alanbjohnston/CubeSatSim/hardware/README.md

The current CubeSatSim hardware is in the v2.0 folder https://github.com/alanbjohnston/CubeSatSim/tree/master/hardware/v2.0.  The folder contains gerbers, schematics, and images of the Main, Battery, and Solar boards.

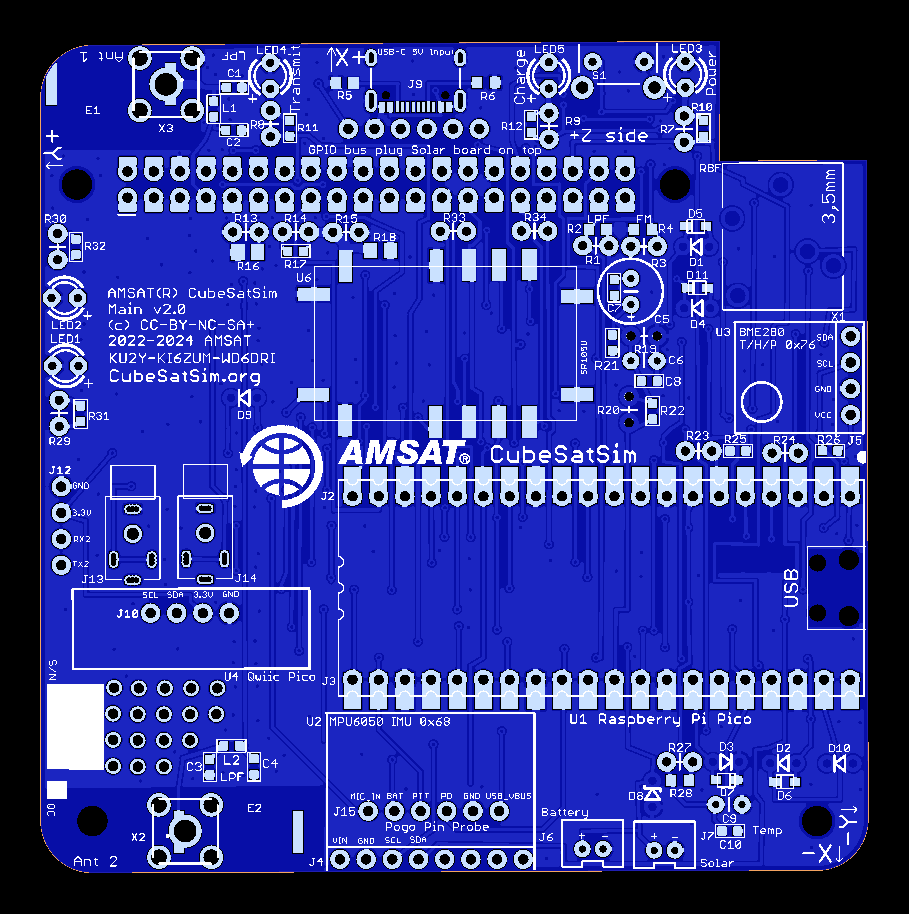
[picture p4: hardware/v2.0/cubesatsim-main-v2.0_top.png]
cubesatsim-main-v2 0 1_top
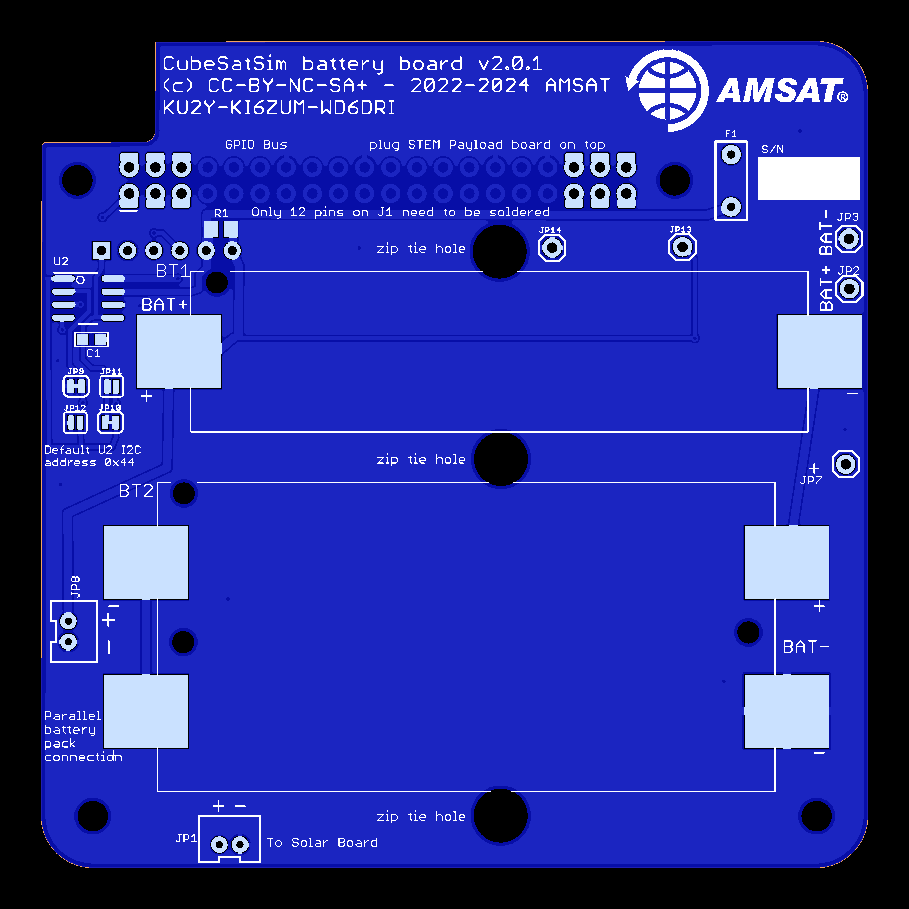
[picture p5: hardware/v2.0/cubesatsim-battery-v2.0.1_top.png]
cubesatsim-battery-v2 0_top
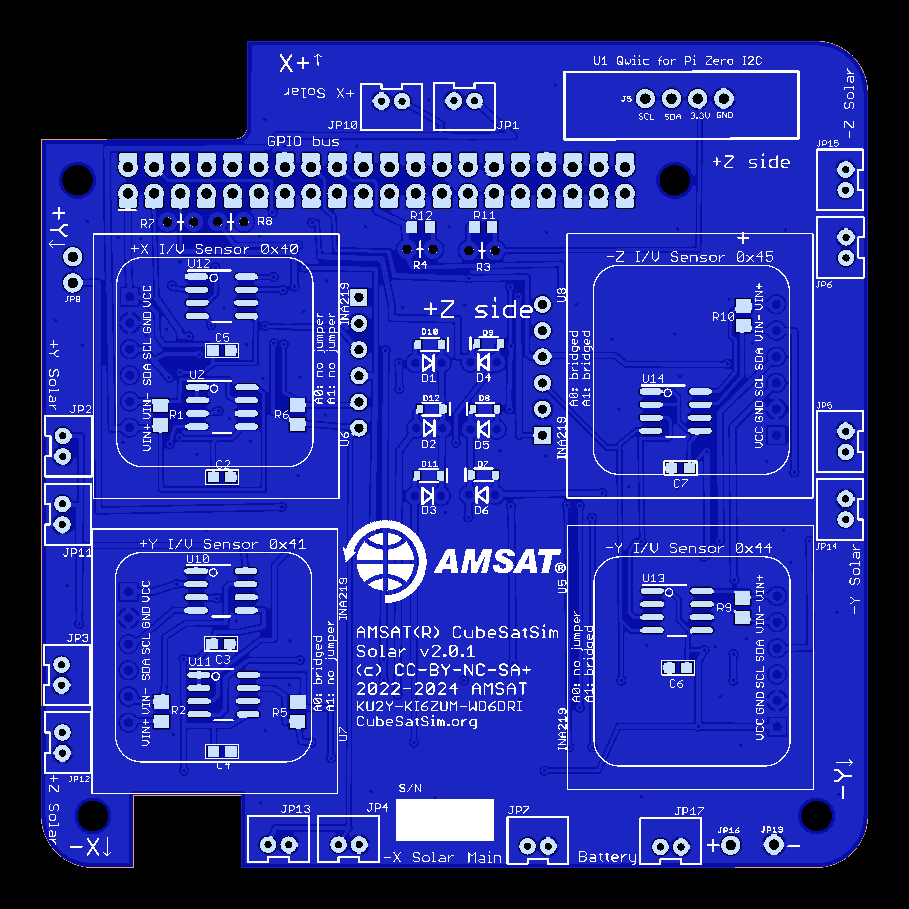
[picture p6: hardware/v2.0/cubesatsim-solar-v2.0.1_top.png]
cubesatsim-solar-v2 0_top
  

For information on building the boards, see https://CubeSatSim.org/wiki.

Older beta versions of the hardware are in the other folders and should not be used.
