alanbjohnston/CubeSatSim/hardware/v2.1/readme.md

cubesatsim-main-v2 0 1_top cubesatsim-battery-v2 0_top cubesatsim-solar-v2 0_top

Here is information about the CubeSatSim PCBs, version v2.1

There are 3 boards: Main, Solar, and Battery

Here's what the files are:

*_gerbers.zip -- All gerber files used to fabricate PCBs along with .TXT drill file

*_schematic.pdf -- Schematic

*_pcb.png -- View of board

*_pour.png -- View of board with fill

*_top.png -- Top view of PCB generated by gerbers

*_bottom.png -- Bottom view of PCB generated by gerbers

*.mnt -- top SMD component placement data

*.mnb -- bottom SMD component placement data

*_bom.csv.txt -- Bill of Materials in CSV format

I use PCBWay to fabricate PCBs https://pcbway.com

Here is the bill of materials: https://CubeSatSim.org/bom

Wiki instructions: https://github.com/alanbjohnston/CubeSatSim/wiki/
