alanbjohnston/CubeSatSim/hardware/beta-v1.3.2/readme.md

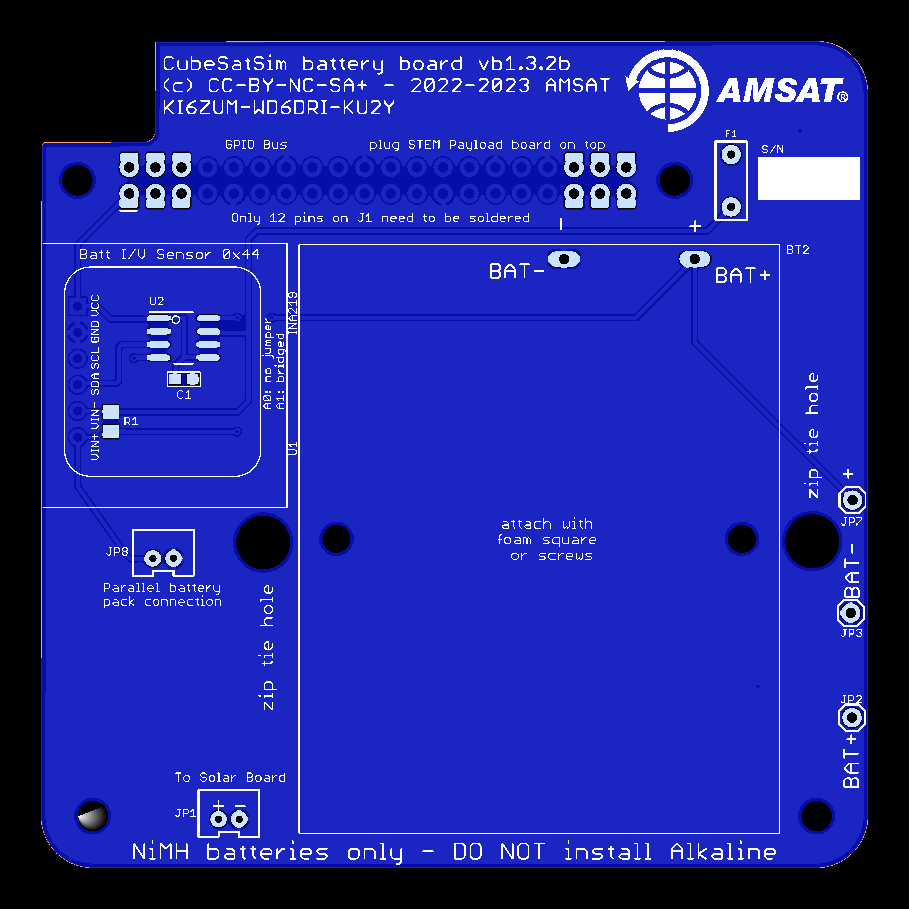
[picture p7: hardware/beta-v1.3.2/cubesatsim-battery-b1.3.2b_top.png]
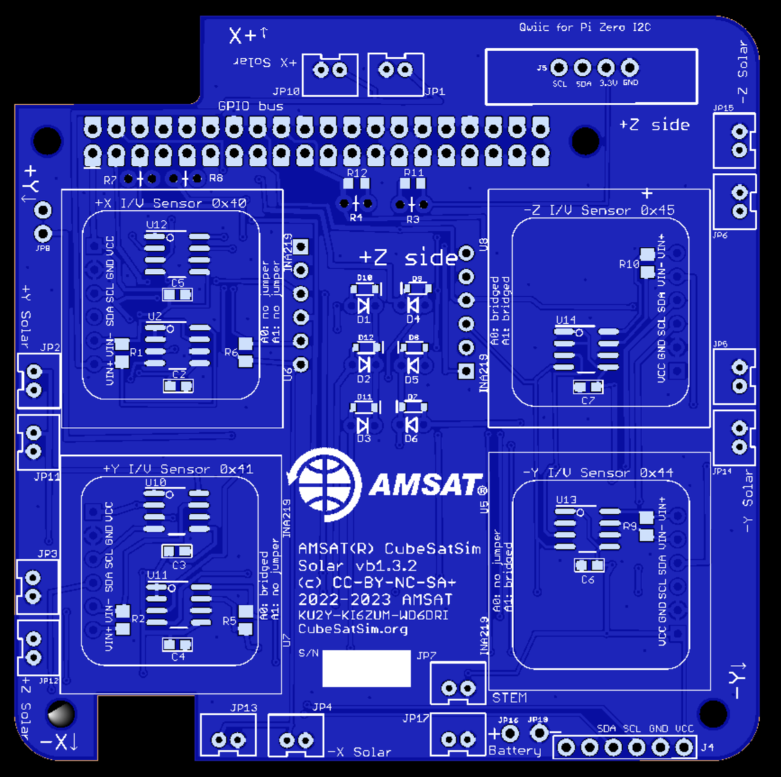
[picture p8: hardware/beta-v1.3.2/cubesatsim-solar-b1.3.2._top.png]


Here is information about the Beta version of the CubeSatSim V2 Boards, version beta v1.3.2

There are 3 boards: STEM Payload, Solar (was Main in v1), and Battery

Here's what the files are:

*_gerbers.zip -- All gerber files used to fabricate PCBs along with .TXT drill file

*_schematic.pdf -- Schematic

*_pcb.png -- View of board

*_pour.png -- View of board with fill

*_top.png -- Top view of PCB generated by gerbers

*_bottom.png -- Bottom view of PCB generated by gerbers

*_tNames.pdf -- Top outline of components

*_bNames.pdf -- Bottom outline of components

*.mnt -- top SMD component placement data

*.mnb -- bottom SMD component placement data

*_bom.csv.txt -- Bill of Materials in CSV format

I use PCBWay to fabricate PCBs https://pcbway.com

Here is a very draft bill of materials: https://docs.google.com/spreadsheets/d/1Ta5UaJcinGozcheROrkfwXdGSDUZrXvQ1_nbIBdIIOY/edit?usp=sharing

Draft wiki instructions: https://github.com/alanbjohnston/CubeSatSim/wiki/v1.3.2-0.-Home
