alanbjohnston/CubeSatSim/hardware/vB5/README.md

These are the files for the old beta version vB5 boards.

The wiki instructions for this board are here https://github.com/alanbjohnston/CubeSatSim/wiki/vB5-Home.
