alanbjohnston/CubeSatSim/hardware/vB7/README.md

The files for the old beta version vB7 are in this folder.  

Here are the wiki instructions for the vB7 board https://github.com/alanbjohnston/CubeSatSim/wiki/vB7-Main-Board
