alanbjohnston/CubeSatSim/spacecraft/FoxTelem_1.13i/README.md

These files update the spacecraft files in FoxTelem version 1.13i or later and fix a bug in the payload altitude sensor display.

You can download them as a zip file: [foxtelem_spacecraft_files.zip](https://github.com/user-attachments/files/23393444/foxtelem_spacecraft_files.zip)

Extract (unzip foxtelem_spacecraft_files.zip) and copy into FoxTelem spacecraft folder, replacing existing files.

Next time you run FoxTelem, the CubeSatSim-FSK and CubeSatSim-BPSK spacecraft will be automatically updated.
