alanbjohnston/CubeSatSim/hardware/lite/vB5/README.md

Here is information about the CubeSatSim Lite vB5 hardware

cubesatsim-lite_0.5_gerbers.zip -- All gerber files used to fabricate PCBs

cubesatsim-lite-0.5_schematic.pdf -- Schematic

cubesatsim-lite-0.5.mnt -- SMD file

cubesatsim-lite-0.5_pcb.png -- image of board

cubesatsim-lite-0.5.csv.txt -- Bill of Materials (BOM)

For more information see https://github.com/alanbjohnston/CubeSatSim/wiki/CubeSatSim-Lite-Beta-vB5
