alanbjohnston/CubeSatSim/hardware/lite/v2/README.md

Here is information about the CubeSatSim Lite v2 hardware

cubesatsim-Lite_2.0.1_gerbers.zip -- All gerber files used to fabricate PCBs

cubesatsim-Lite_2.0.1_schematic.pdf -- Schematic

cubesatsim-Lite_2.0.1.mnt -- SMD file

cubesatsim-lLite_2.0.1_pcb.png -- image of board

cubesatsim-Lite_2.0.1_bom.csv.txt -- Bill of Materials (BOM)

For more information see https://github.com/alanbjohnston/CubeSatSim/wiki/CubeSatSim-Lite
