alanbjohnston/CubeSatSim/hardware/vB3/kicad/README.md

Schematic for vB3 Solar Panel Board in KiCad

For the latest PCB hardware see https://github.com/alanbjohnston/CubeSatSim/tree/master/hardware/
