alanbjohnston/CubeSatSim/hardware/beta-v1.3.2/cubesatsim-battery-b1.3.2.1b_top.png

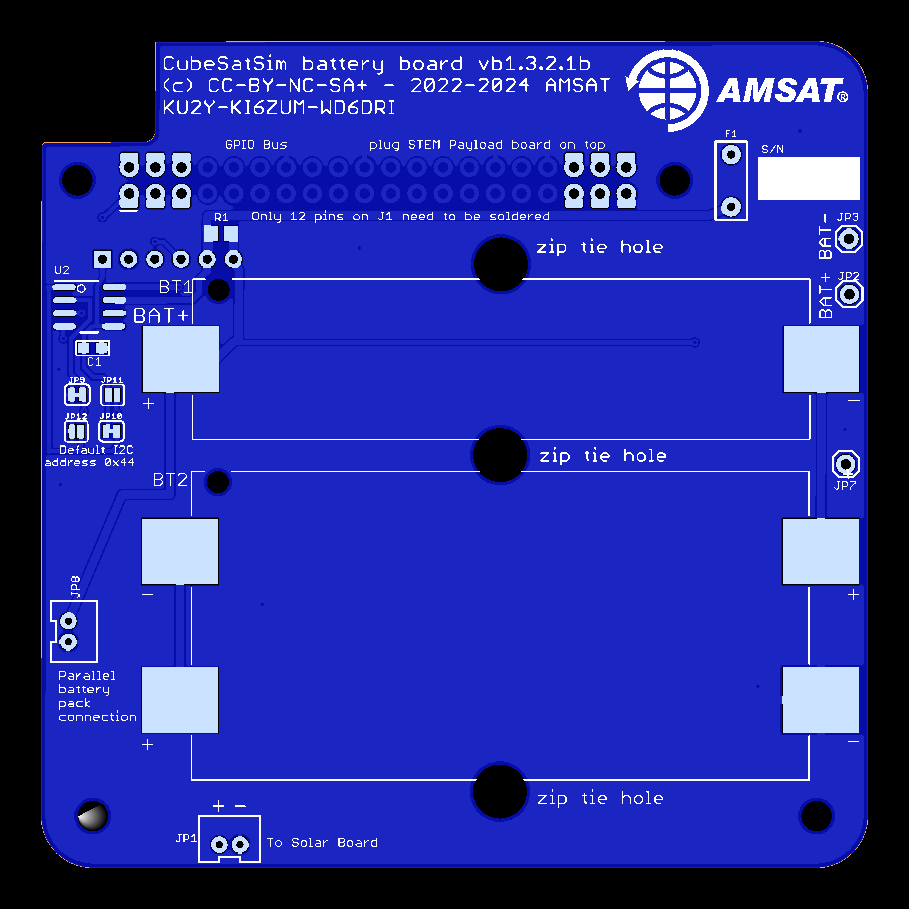
hardware/beta-v1.3.2/cubesatsim-battery-b1.3.2.1b_top.png
