alanbjohnston/CubeSatSim/hardware/beta-v1.3.2/cubesatsim-battery-b1.3.2.2_bottom.png

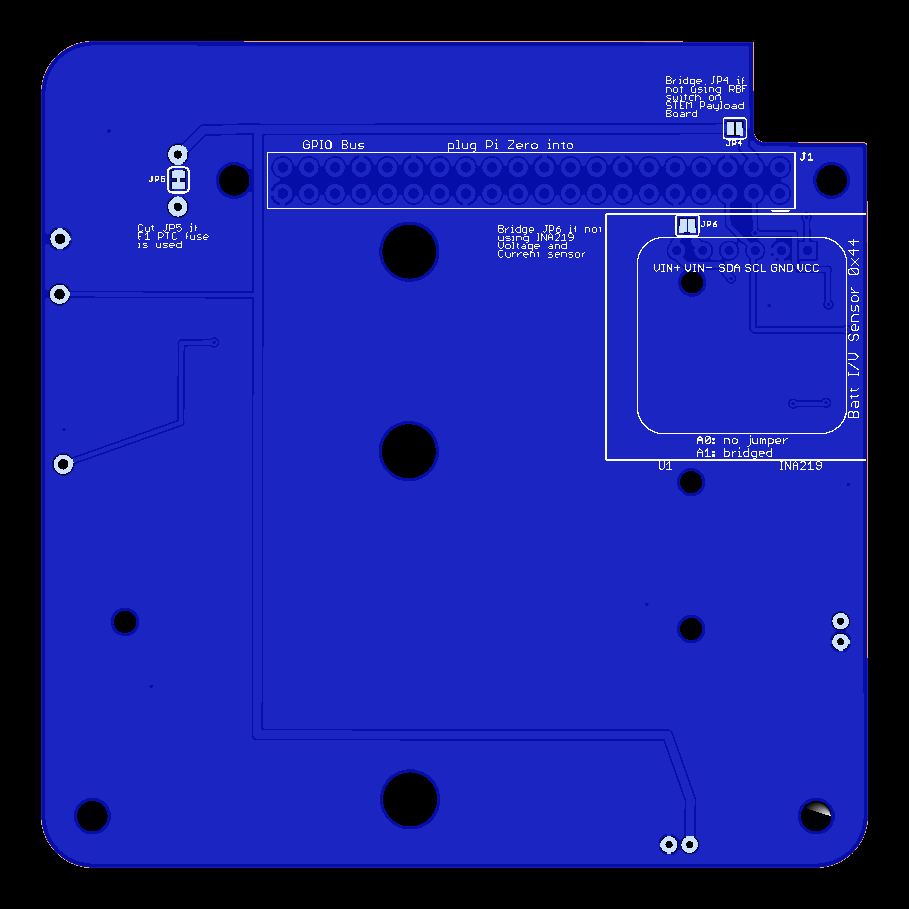
hardware/beta-v1.3.2/cubesatsim-battery-b1.3.2.2_bottom.png
