alanbjohnston/CubeSatSim/hardware/beta-v1.3.2/cubesatsim-battery-b1.3.2.2_pcb.png

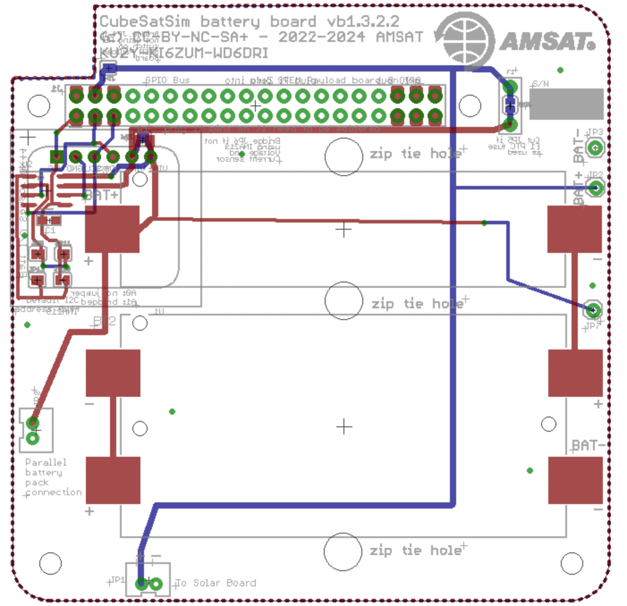
hardware/beta-v1.3.2/cubesatsim-battery-b1.3.2.2_pcb.png
