alanbjohnston/CubeSatSim/hardware/beta-v1.3.2/cubesatsim-solar-b1.3.2._bottom.png

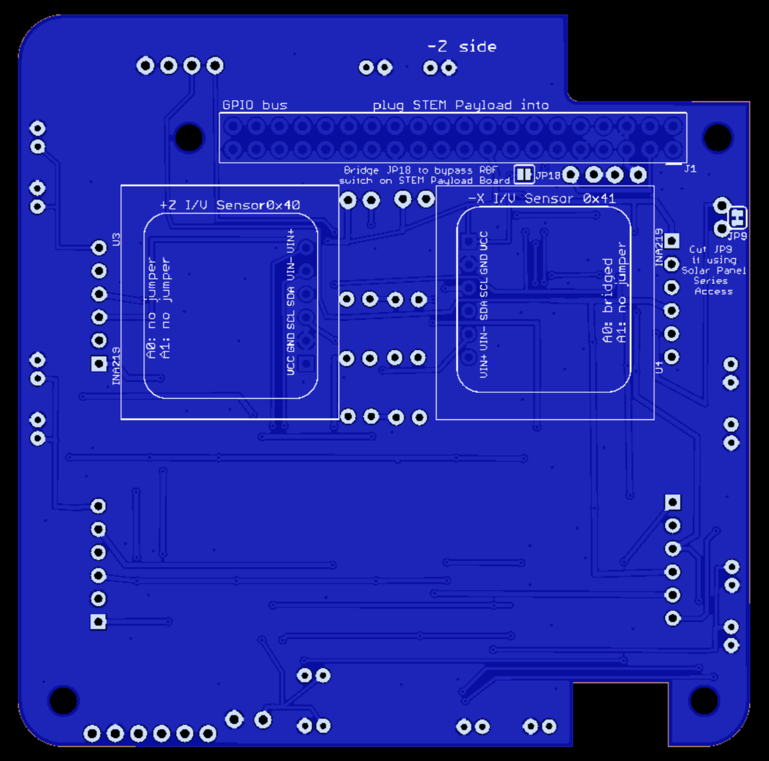
hardware/beta-v1.3.2/cubesatsim-solar-b1.3.2._bottom.png
