alanbjohnston/CubeSatSim/hardware/beta-v1.3.2/cubesatsim-STEM-b1.3.2.1_bottom.png

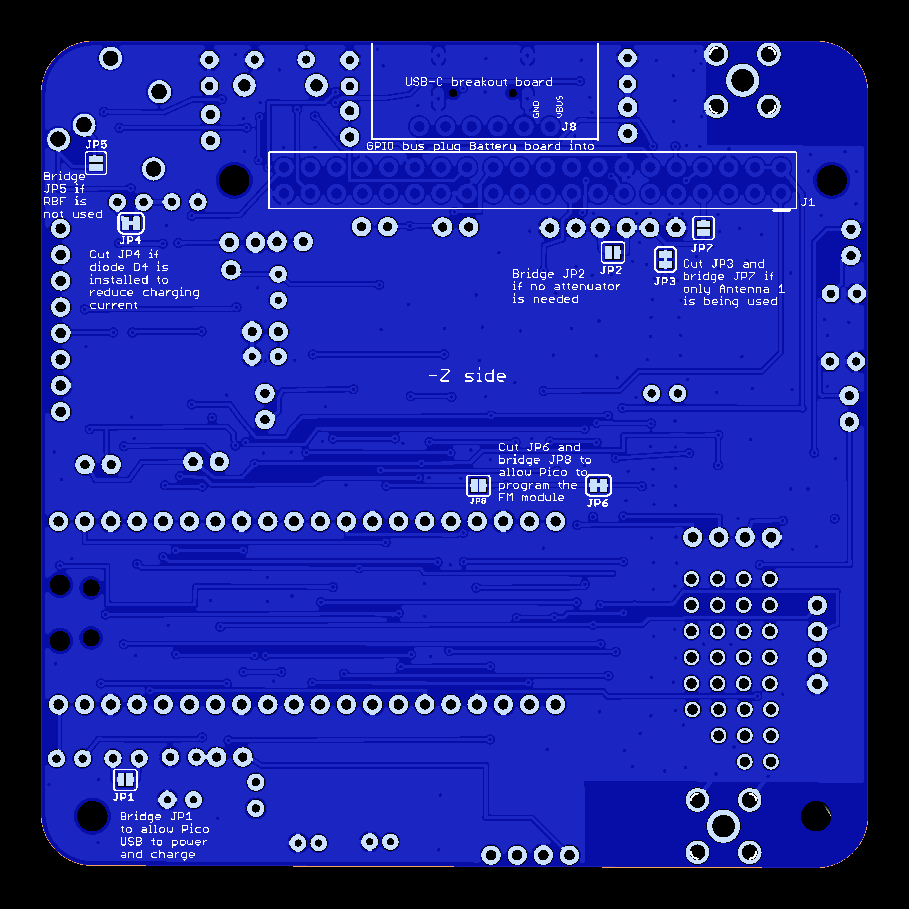
hardware/beta-v1.3.2/cubesatsim-STEM-b1.3.2.1_bottom.png
