alanbjohnston/CubeSatSim/hardware/beta-v1.3.2/cubesatsim-STEM-b1.3.2.1_top.png

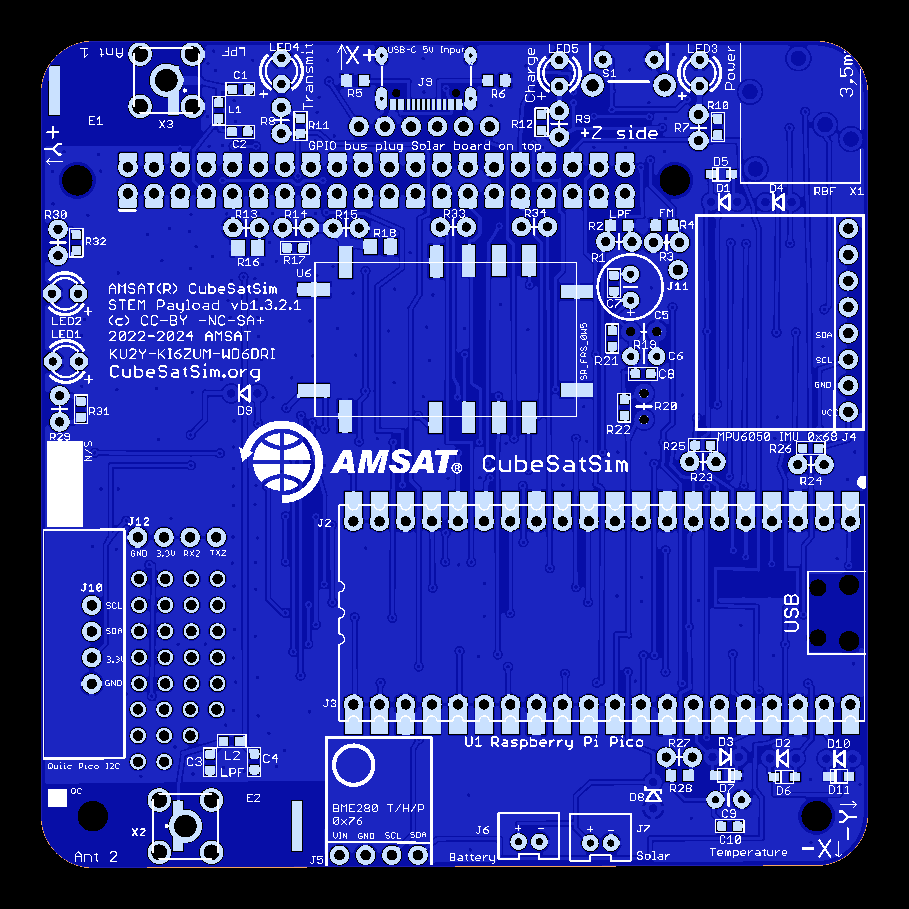
hardware/beta-v1.3.2/cubesatsim-STEM-b1.3.2.1_top.png
