alanbjohnston/CubeSatSim/hardware/beta-v1.3.2/cubesatsim-STEM-b1.3.2.3_pcb.png

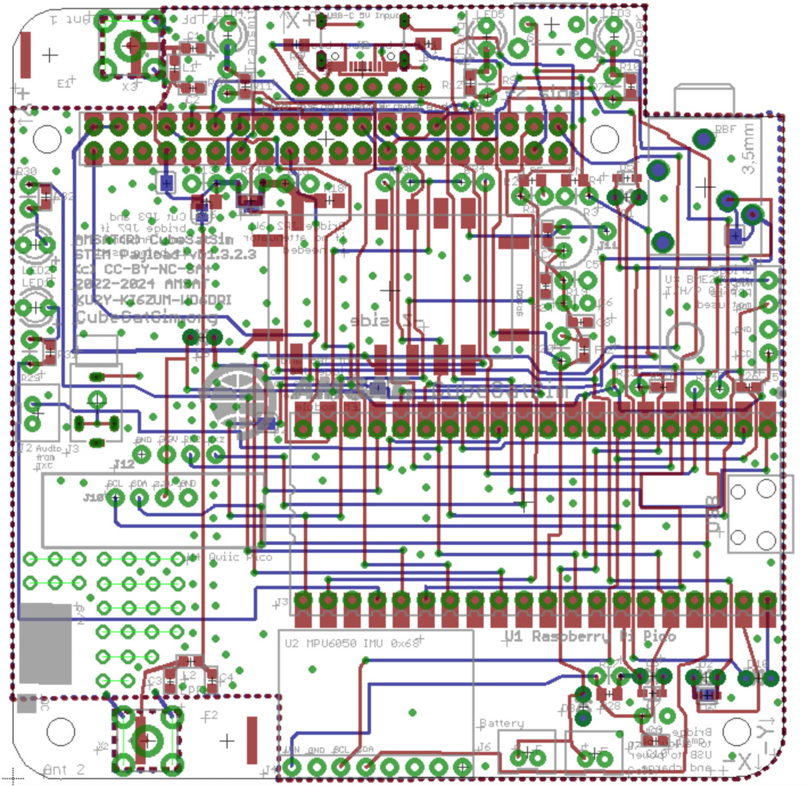
hardware/beta-v1.3.2/cubesatsim-STEM-b1.3.2.3_pcb.png
