alanbjohnston/CubeSatSim/hardware/lite/v2/cubesatsim-Lite-v2.0.1_bottom.png

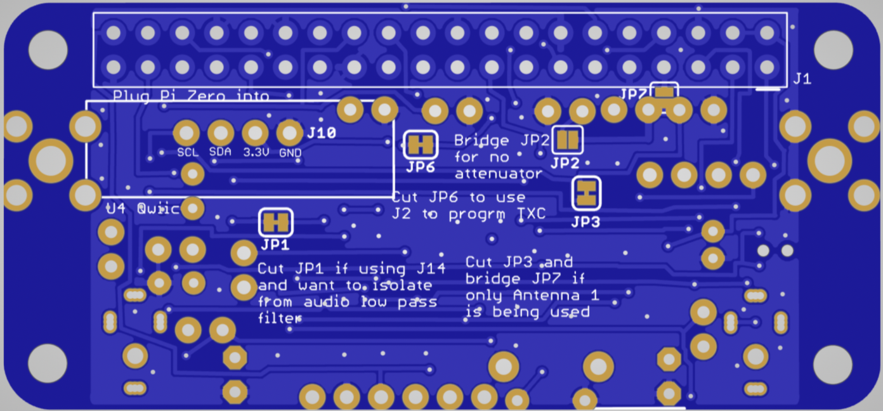
hardware/lite/v2/cubesatsim-Lite-v2.0.1_bottom.png
