alanbjohnston/CubeSatSim/hardware/lite/vB3/cubesat-sim-lite-0.3_board.png

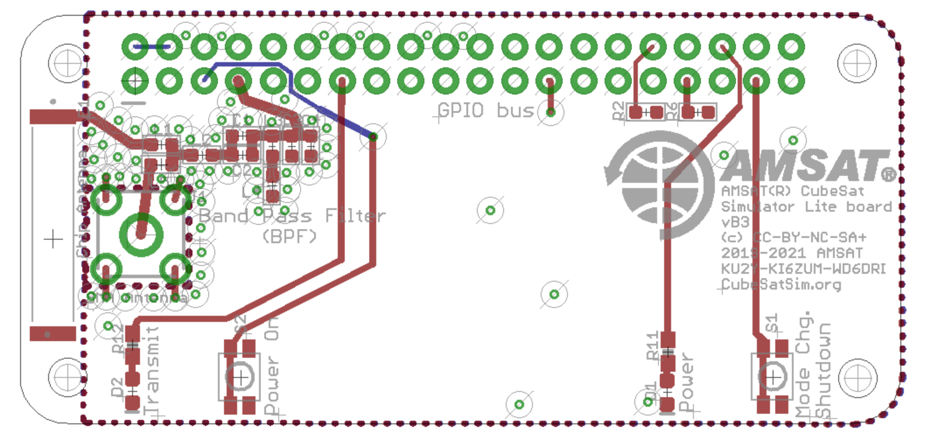
hardware/lite/vB3/cubesat-sim-lite-0.3_board.png
