alanbjohnston/CubeSatSim/hardware/lite/vB4/cubesatsim-lite-04_pcb.png

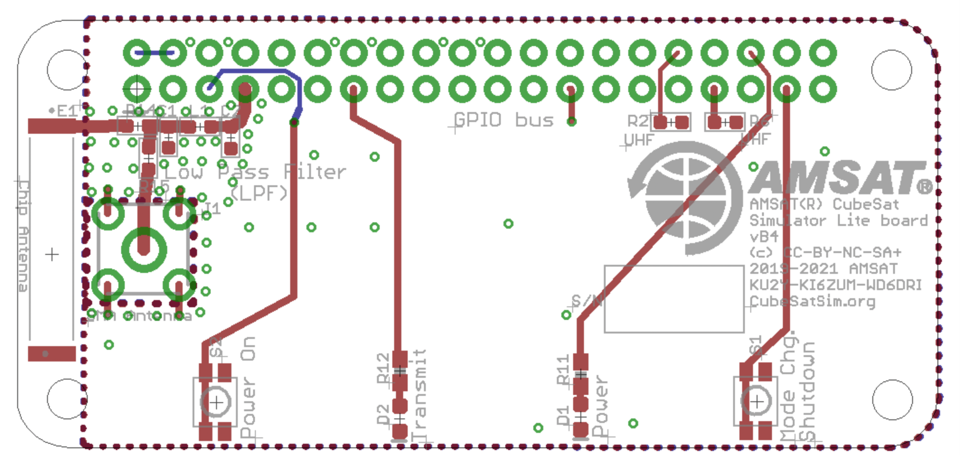
hardware/lite/vB4/cubesatsim-lite-04_pcb.png
