alanbjohnston/CubeSatSim/hardware/v2.1/cubesatsim-main-v2.1.0_pcb.png

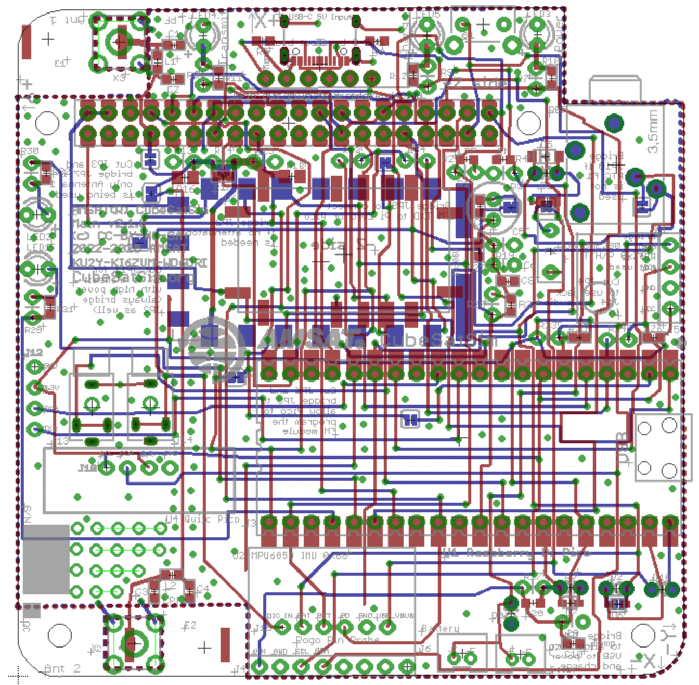
hardware/v2.1/cubesatsim-main-v2.1.0_pcb.png
