alanbjohnston/CubeSatSim/hardware/vB3/kicad/cubesatsim_solar_board.png

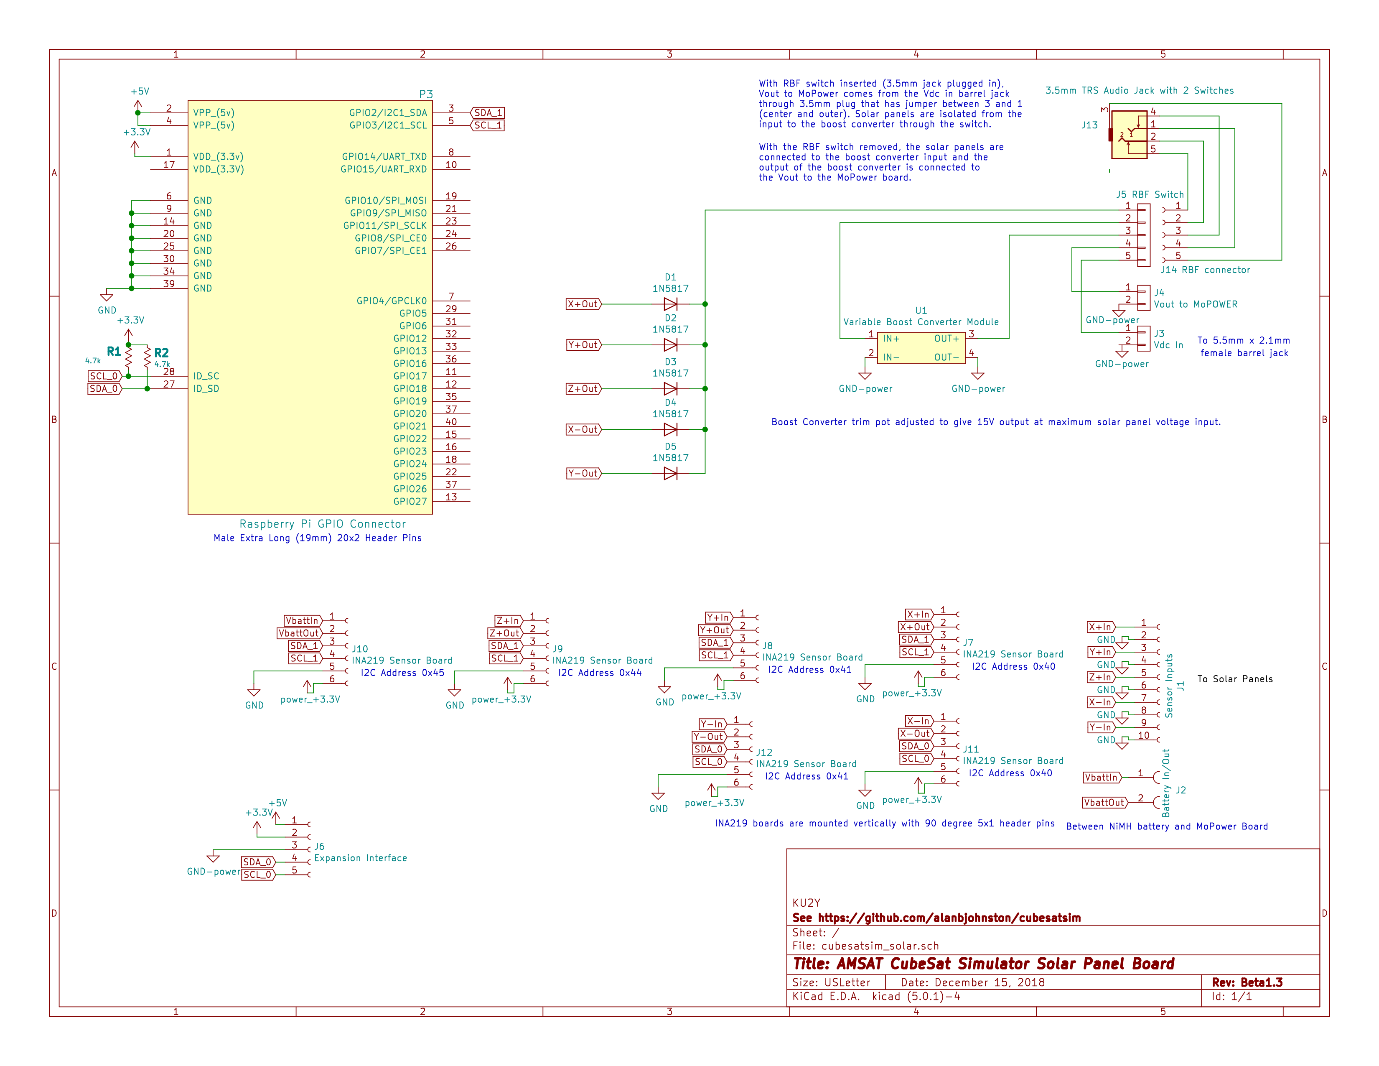
hardware/vB3/kicad/cubesatsim_solar_board.png
