alanbjohnston/CubeSatSim/hardware/vB3/kicad/PCB.png

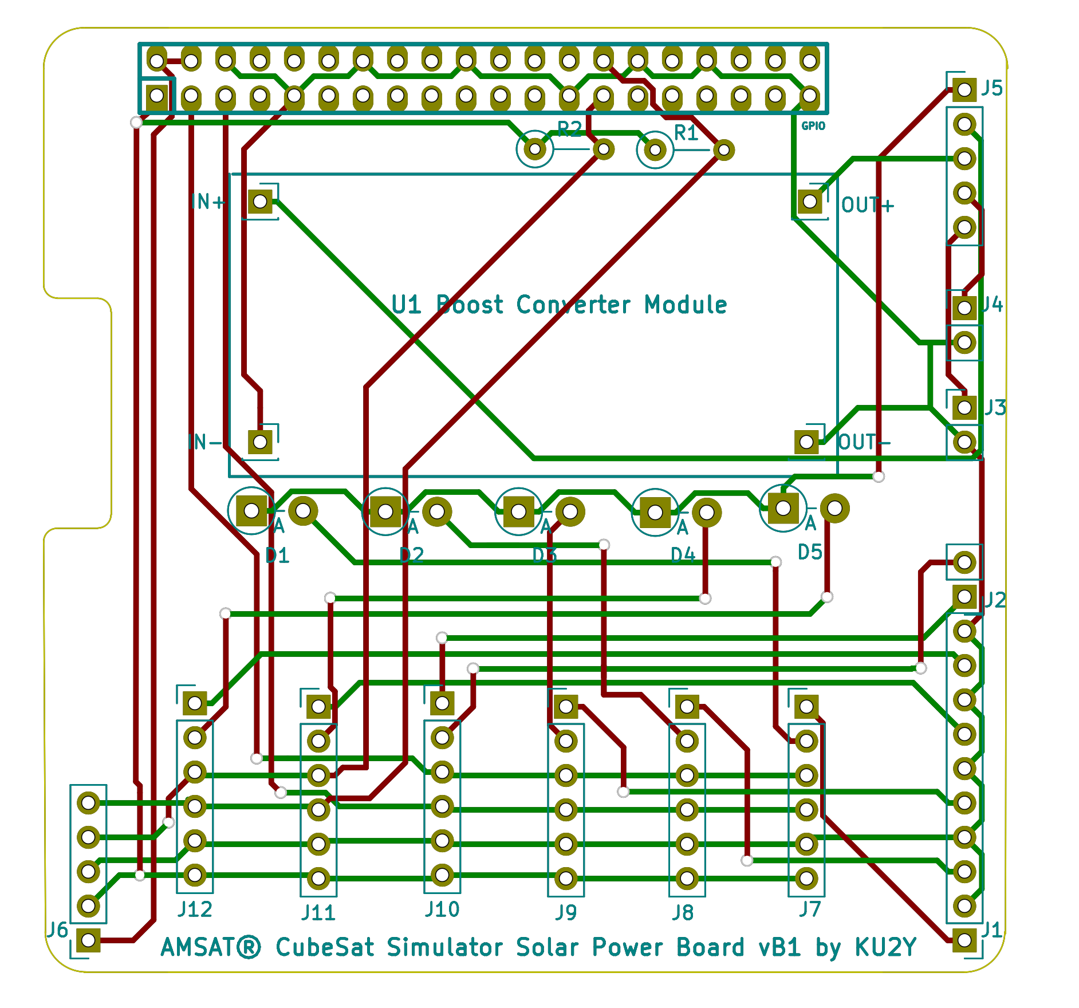
hardware/vB3/kicad/PCB.png
