alanbjohnston/CubeSatSim/hardware/vB3/kicad/Schematic.PNG

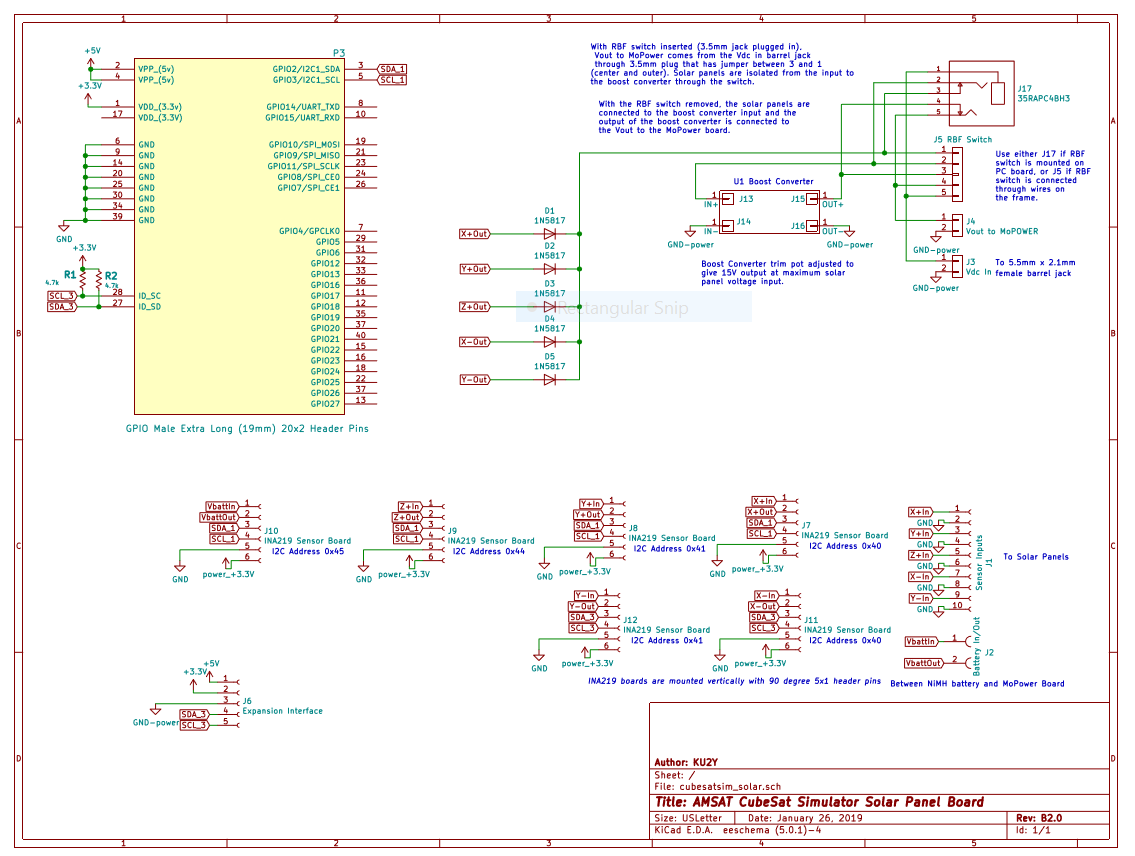
hardware/vB3/kicad/Schematic.PNG
