alanbjohnston/CubeSatSim/hardware/vB3/kicad/Schematic_vB3.jpg

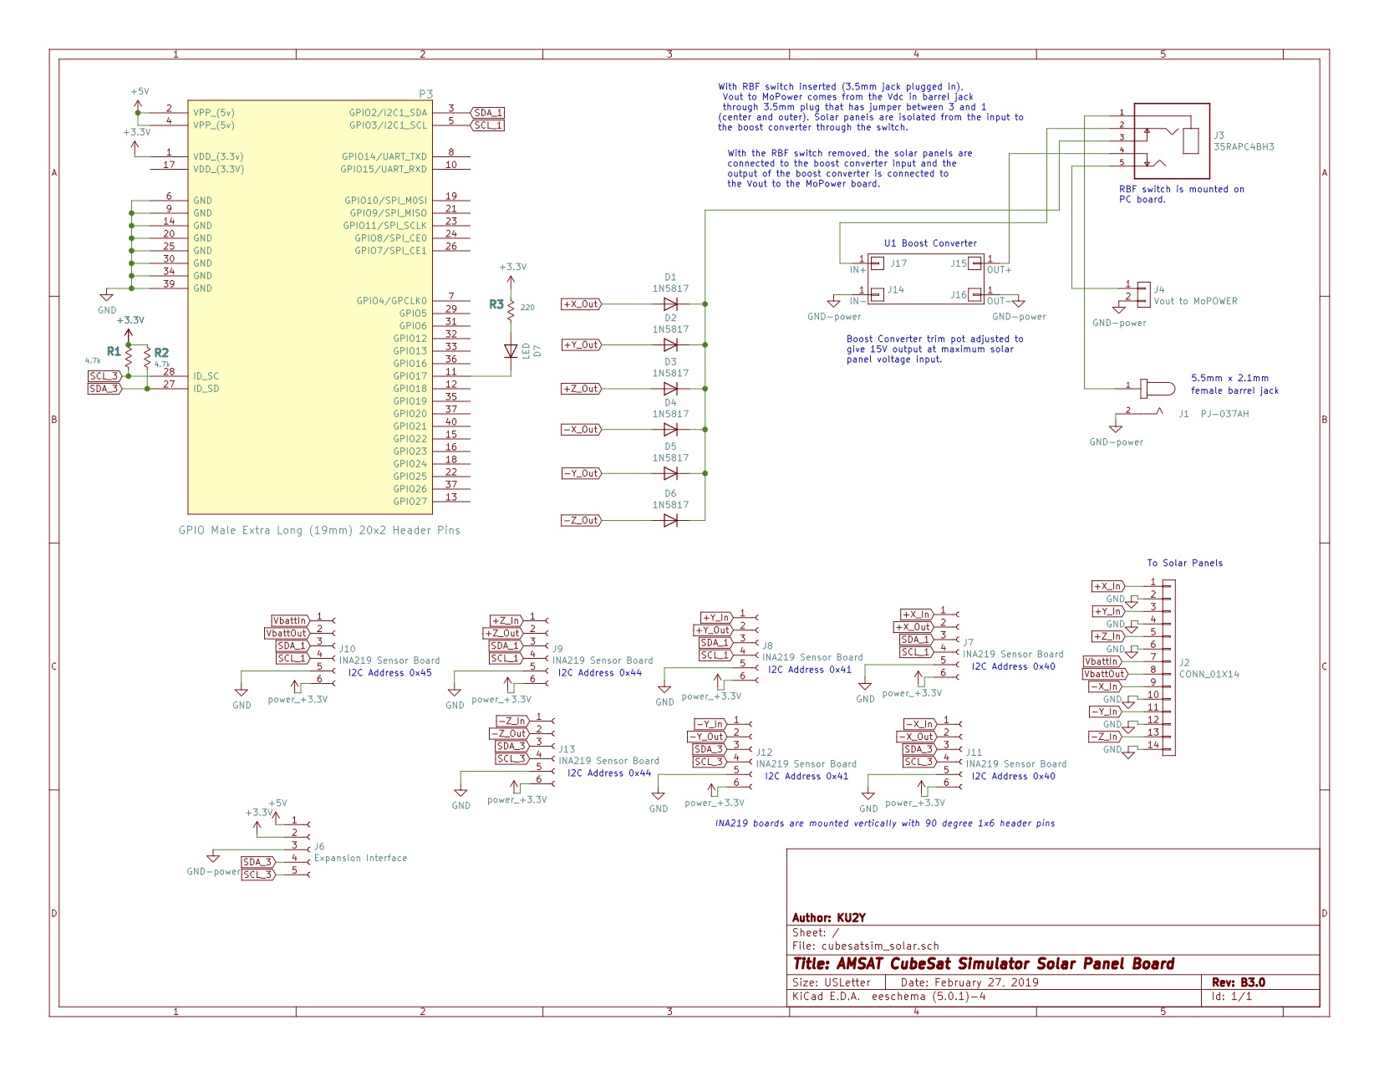
hardware/vB3/kicad/Schematic_vB3.jpg
