alanbjohnston/CubeSatSim/hardware/vB5/PCBvB5 Back.png

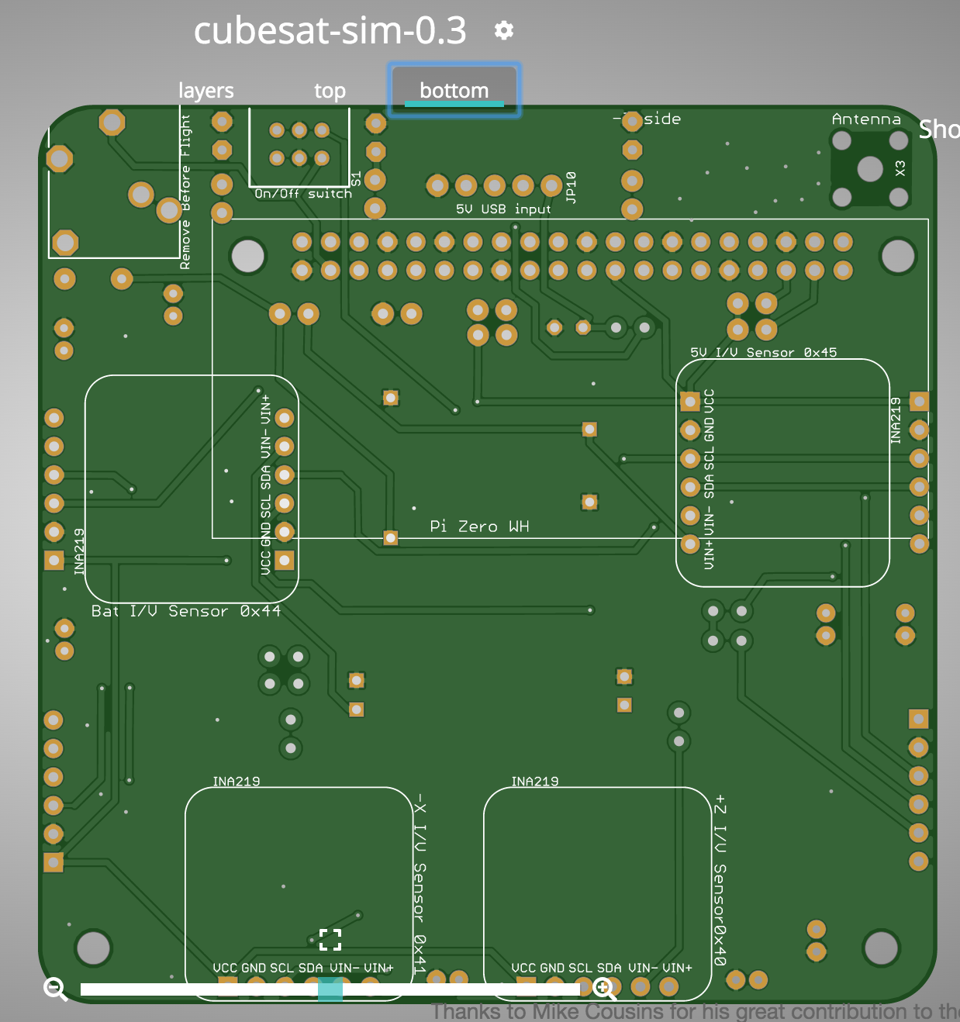
hardware/vB5/PCBvB5 Back.png
