alanbjohnston/CubeSatSim/hardware/vB5/PCBvB5 Front.png

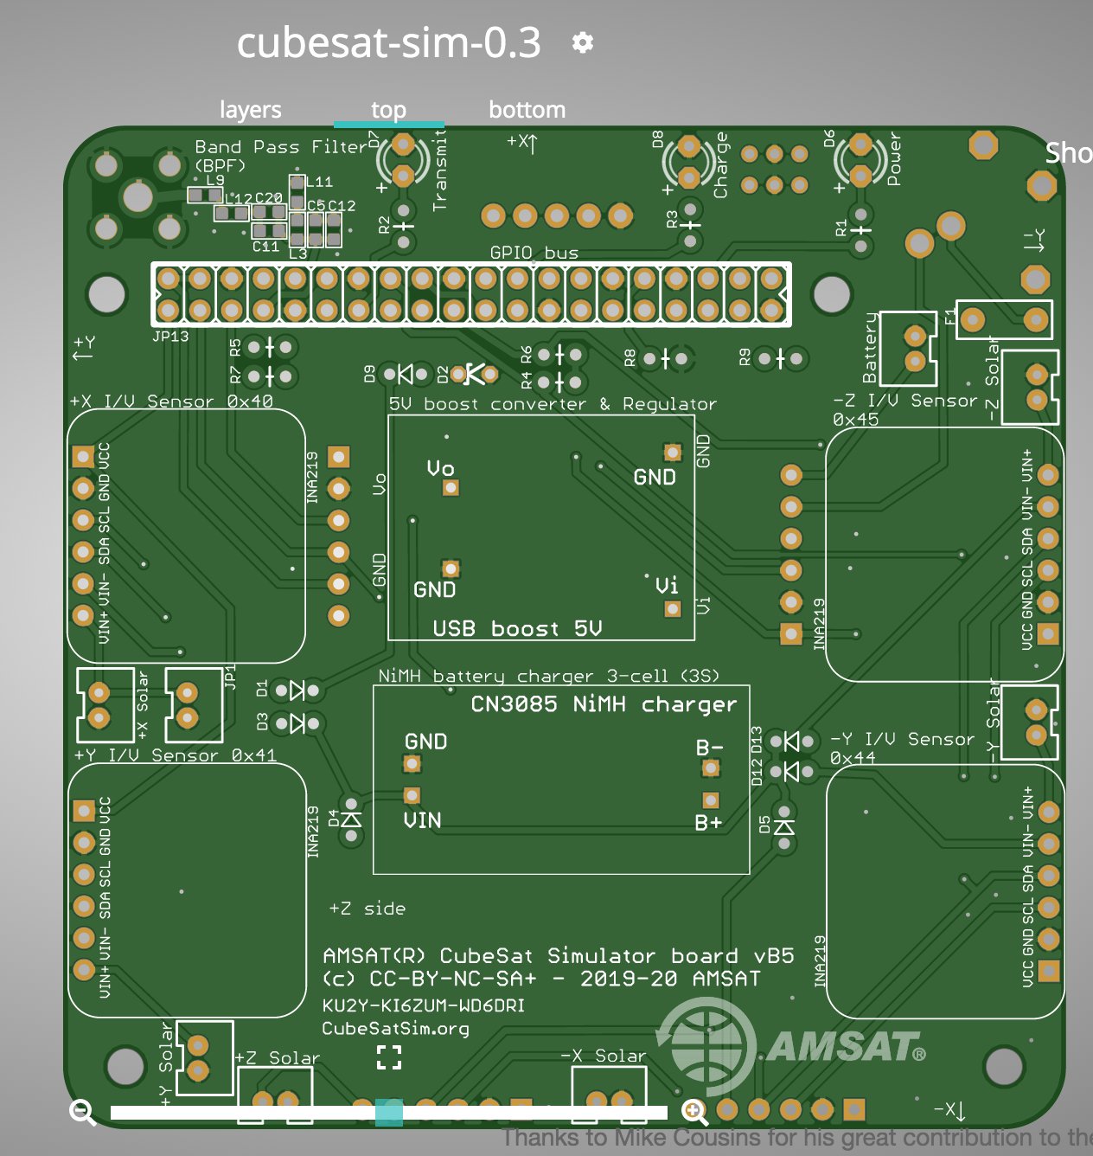
hardware/vB5/PCBvB5 Front.png
