alanbjohnston/CubeSatSim/hardware/vB5/PCBvB5Battery Back.png

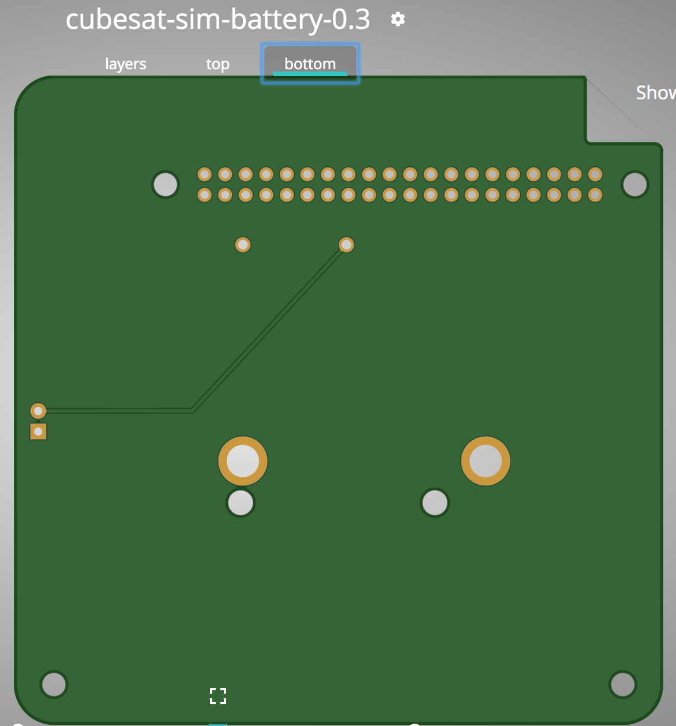
hardware/vB5/PCBvB5Battery Back.png
