alanbjohnston/CubeSatSim/hardware/vB5/PCBvB5Battery Front.png

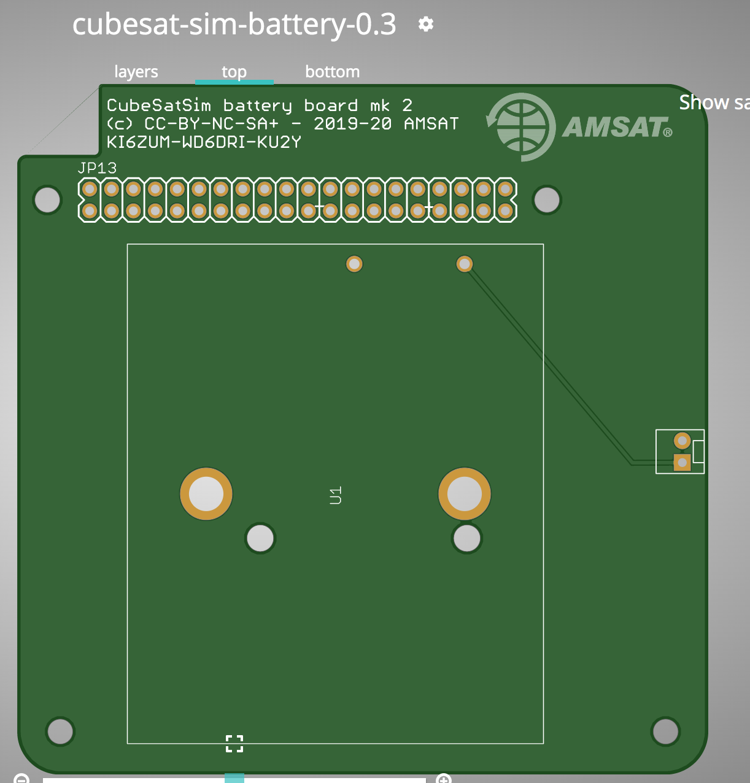
hardware/vB5/PCBvB5Battery Front.png
