alanbjohnston/CubeSatSim/hardware/vB5/PCBvB5STEMPayload Back.png

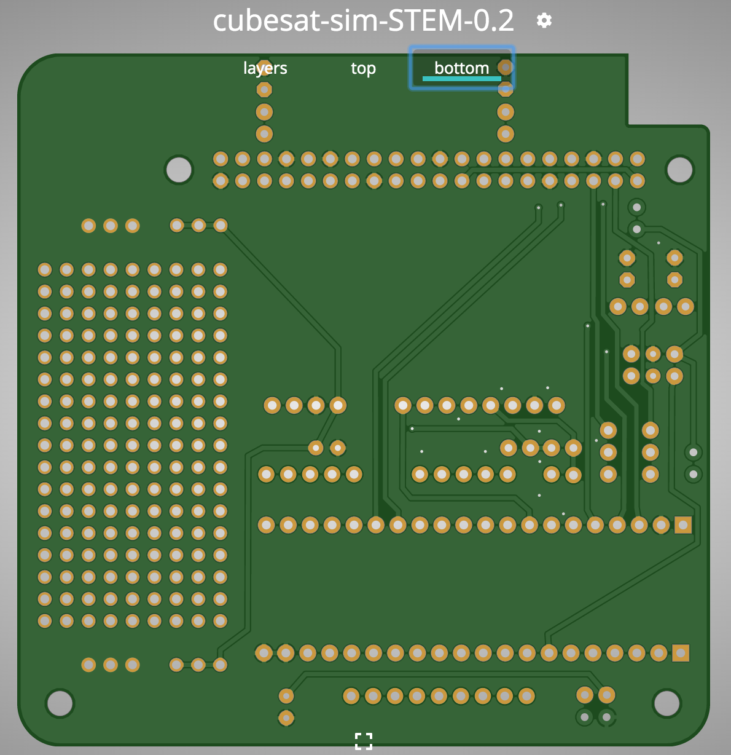
hardware/vB5/PCBvB5STEMPayload Back.png
