alanbjohnston/CubeSatSim/hardware/vB5/PCBvB5STEMPayload Front.png

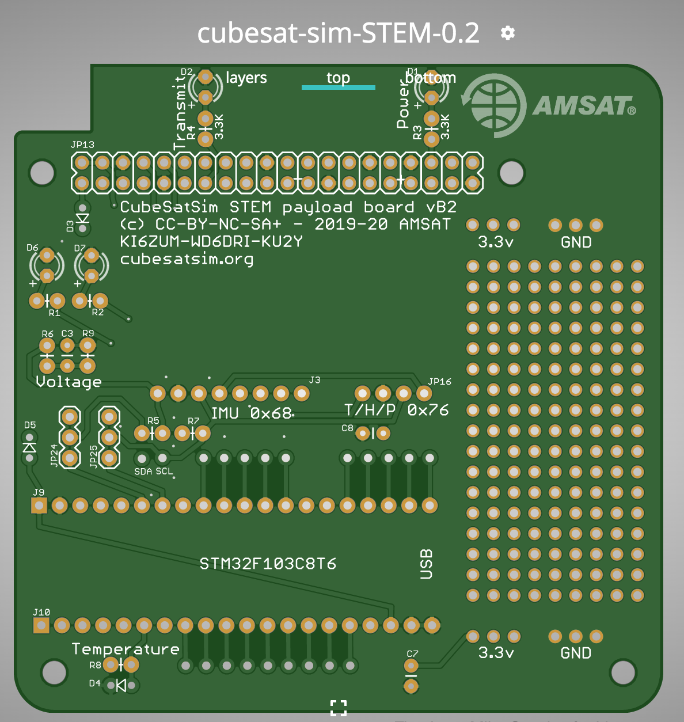
hardware/vB5/PCBvB5STEMPayload Front.png
