alanbjohnston/CubeSatSim/hardware/vB7/PCB Battery mk4 Bottom.png

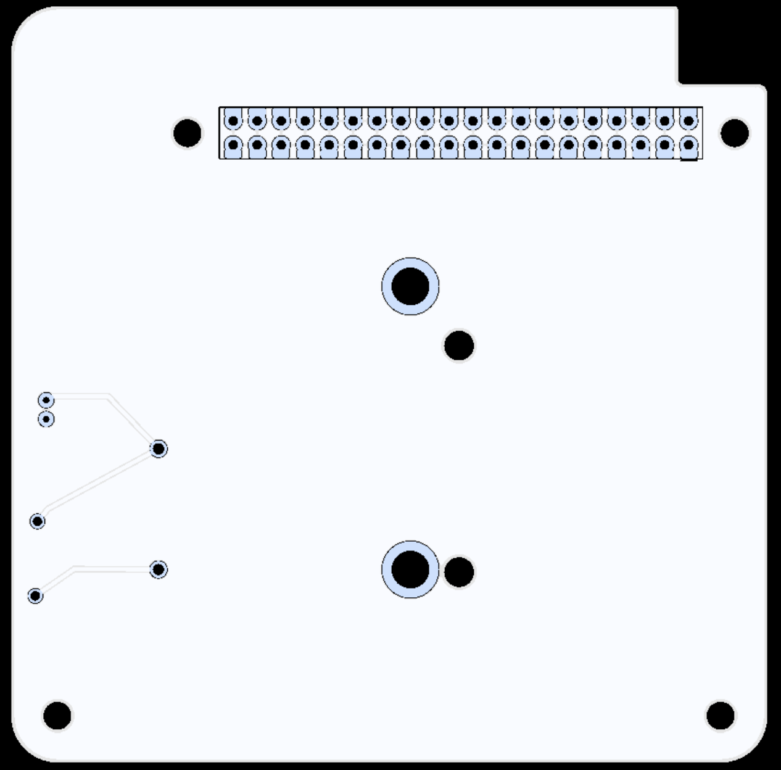
hardware/vB7/PCB Battery mk4 Bottom.png
