alanbjohnston/CubeSatSim/hardware/vB7/PCB Battery mk4 Top.png

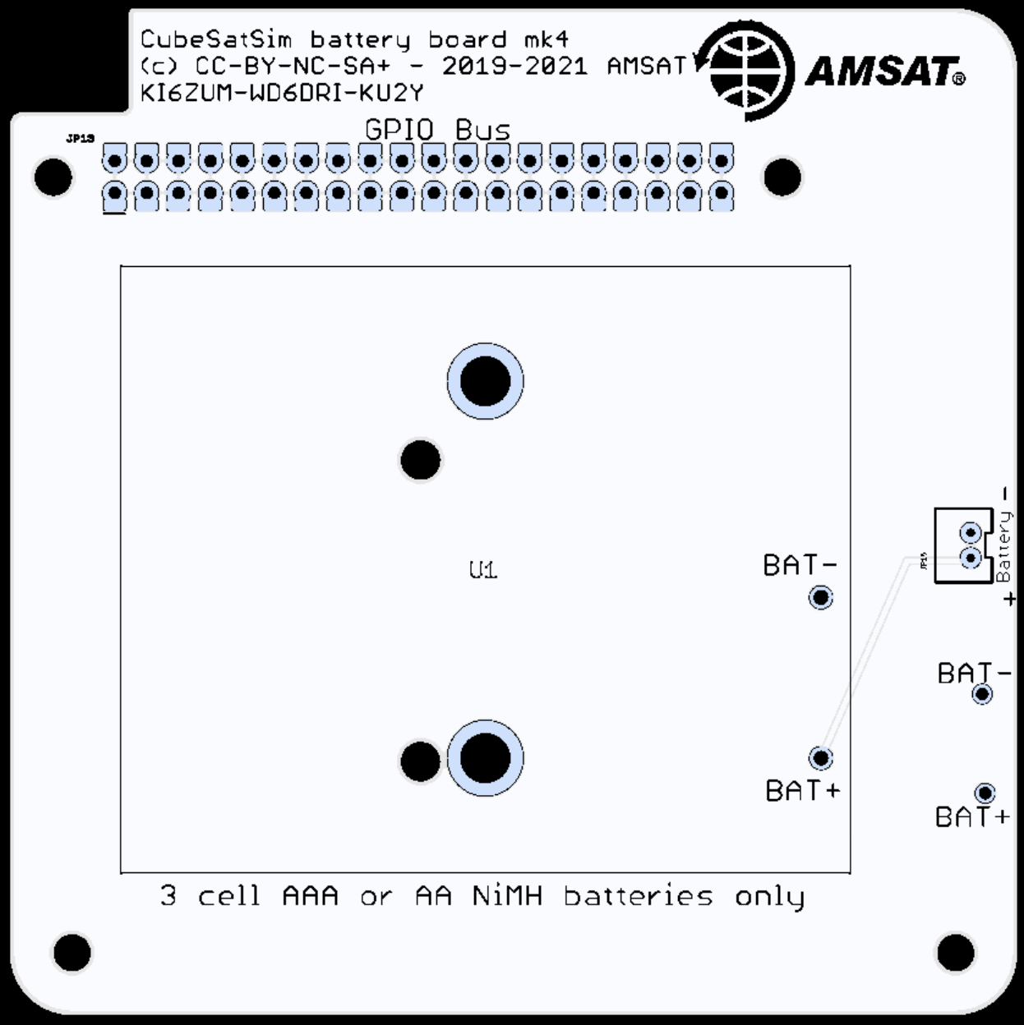
hardware/vB7/PCB Battery mk4 Top.png
