alanbjohnston/CubeSatSim/hardware/vB7/PCB Lite vB2 Bottom.png

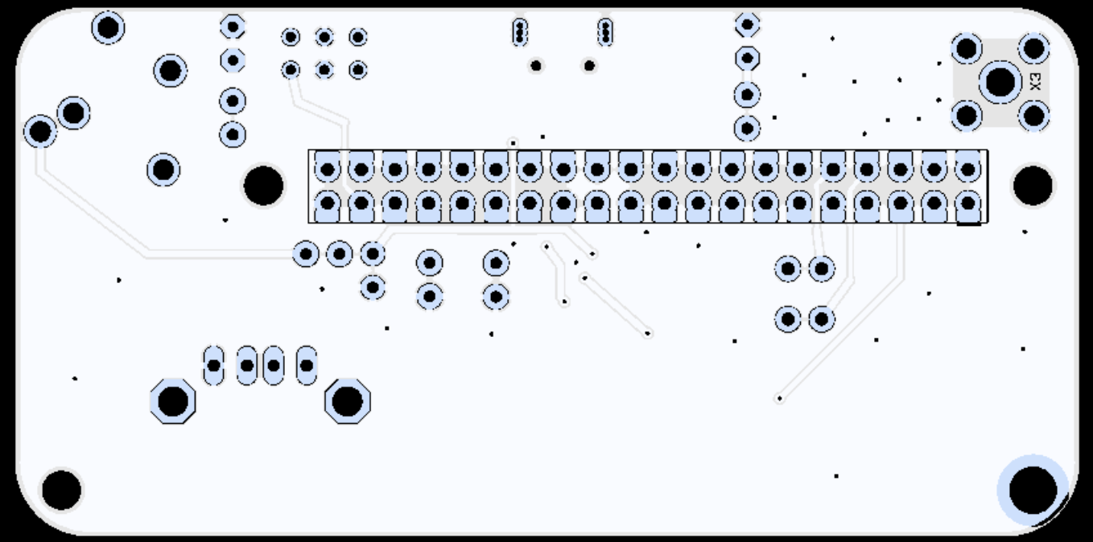
hardware/vB7/PCB Lite vB2 Bottom.png
