alanbjohnston/CubeSatSim/hardware/vB7/PCB Lite vB2 Top.png

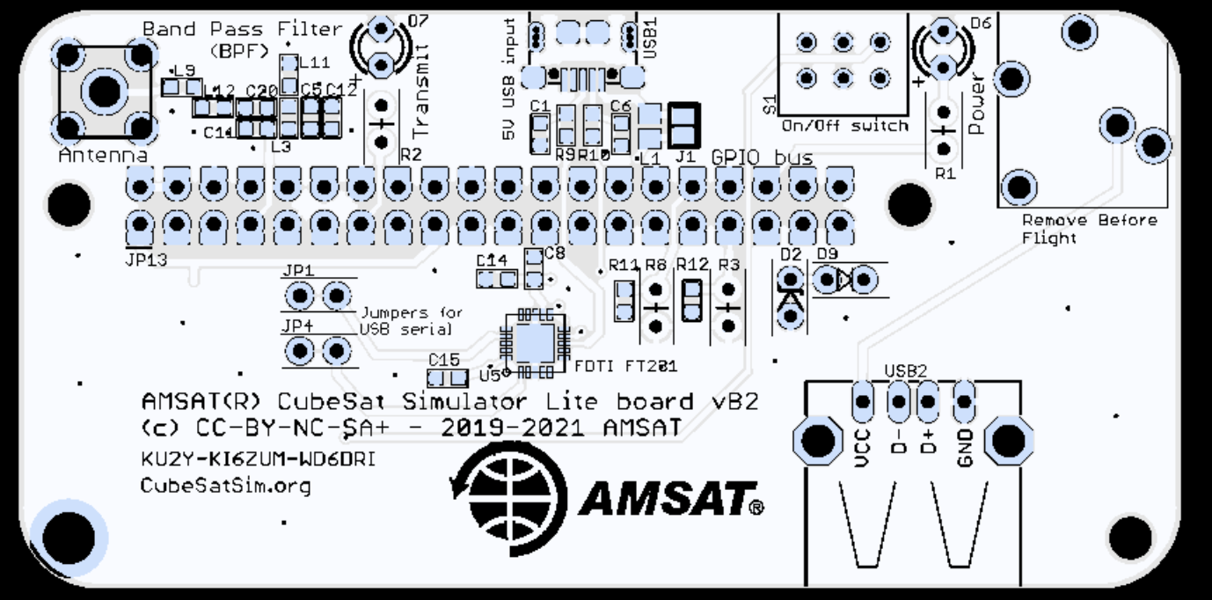
hardware/vB7/PCB Lite vB2 Top.png
