alanbjohnston/CubeSatSim/hardware/vB7/PCB Main vB7  Top.png

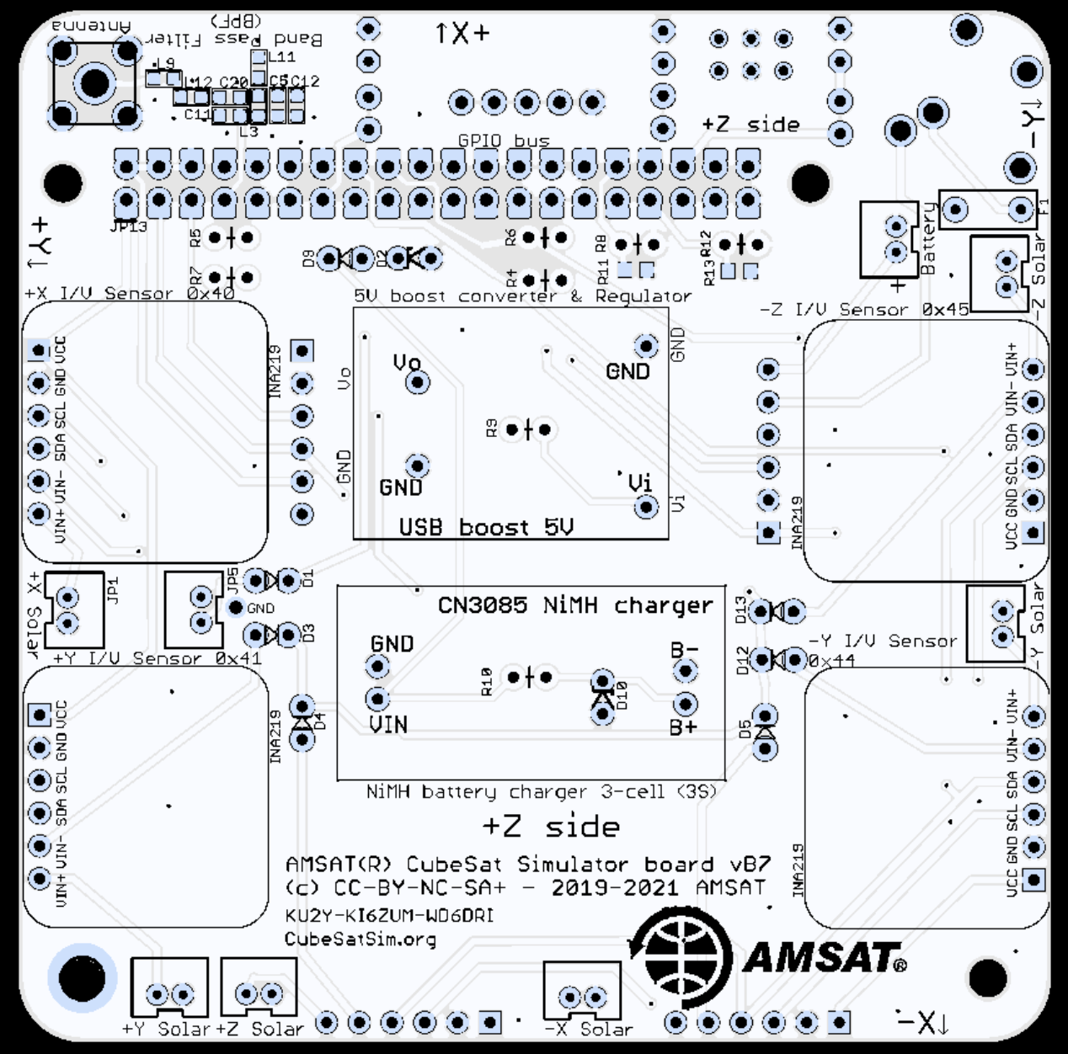
hardware/vB7/PCB Main vB7 Top.png
