alanbjohnston/CubeSatSim/hardware/vB7/PCB Main vB7 Bottom.png

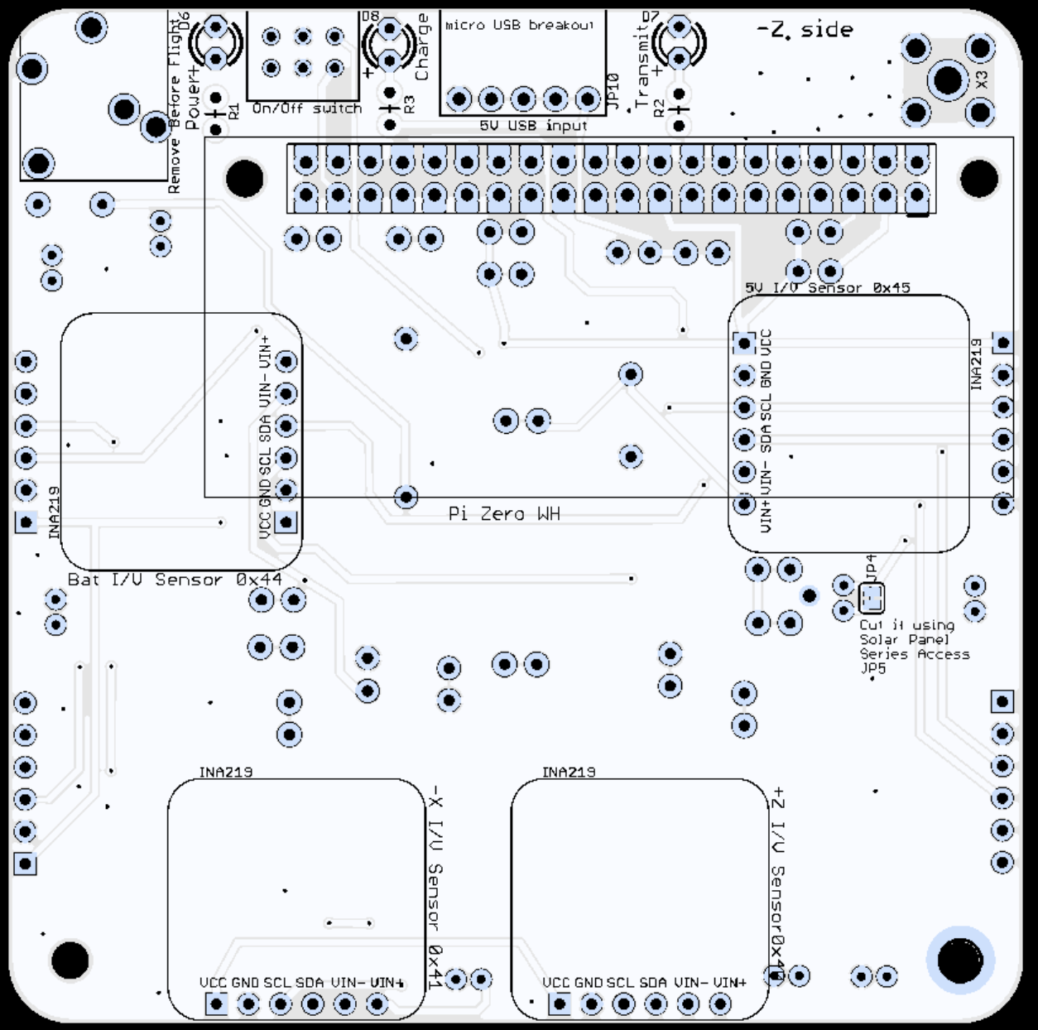
hardware/vB7/PCB Main vB7 Bottom.png
