alanbjohnston/CubeSatSim/hardware/vB7/PCB STEM vB4 Bottom.png

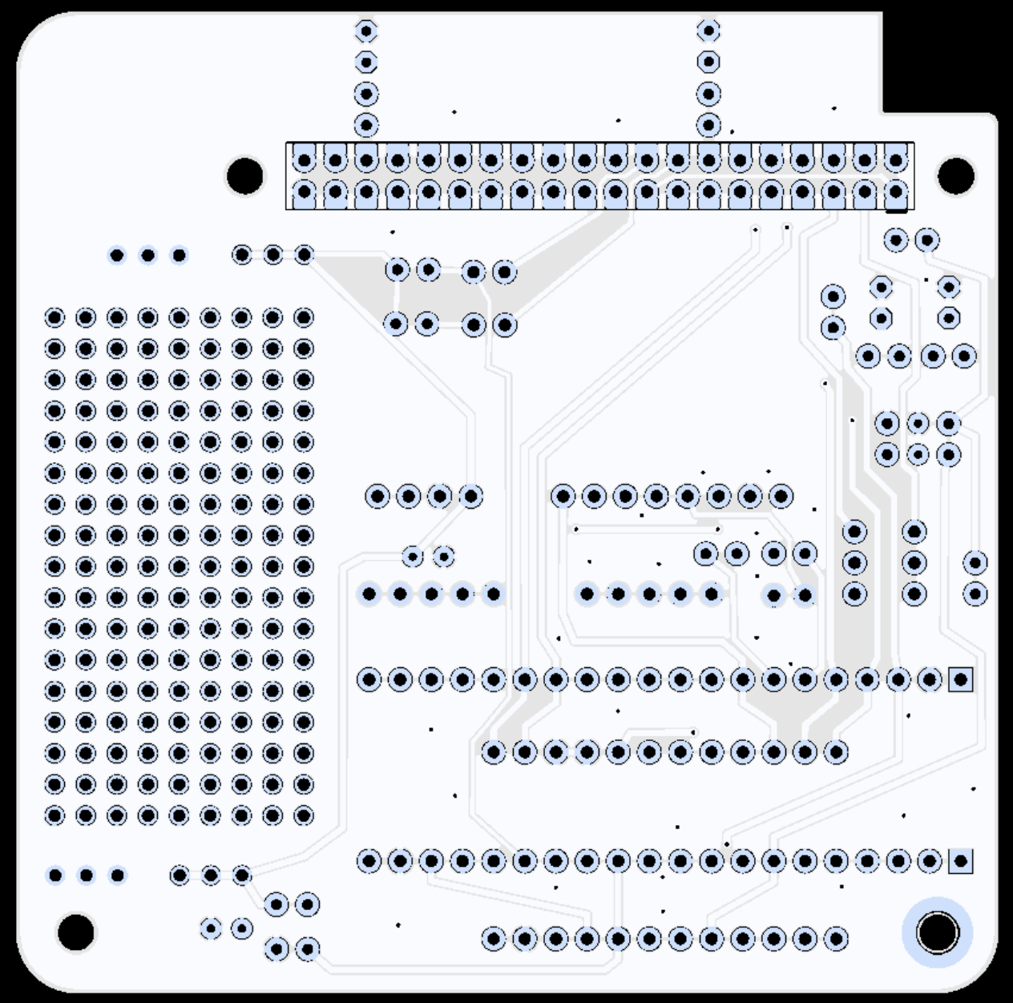
hardware/vB7/PCB STEM vB4 Bottom.png
