alanbjohnston/CubeSatSim/hardware/vB7/PCB STEM vB4 Top.png

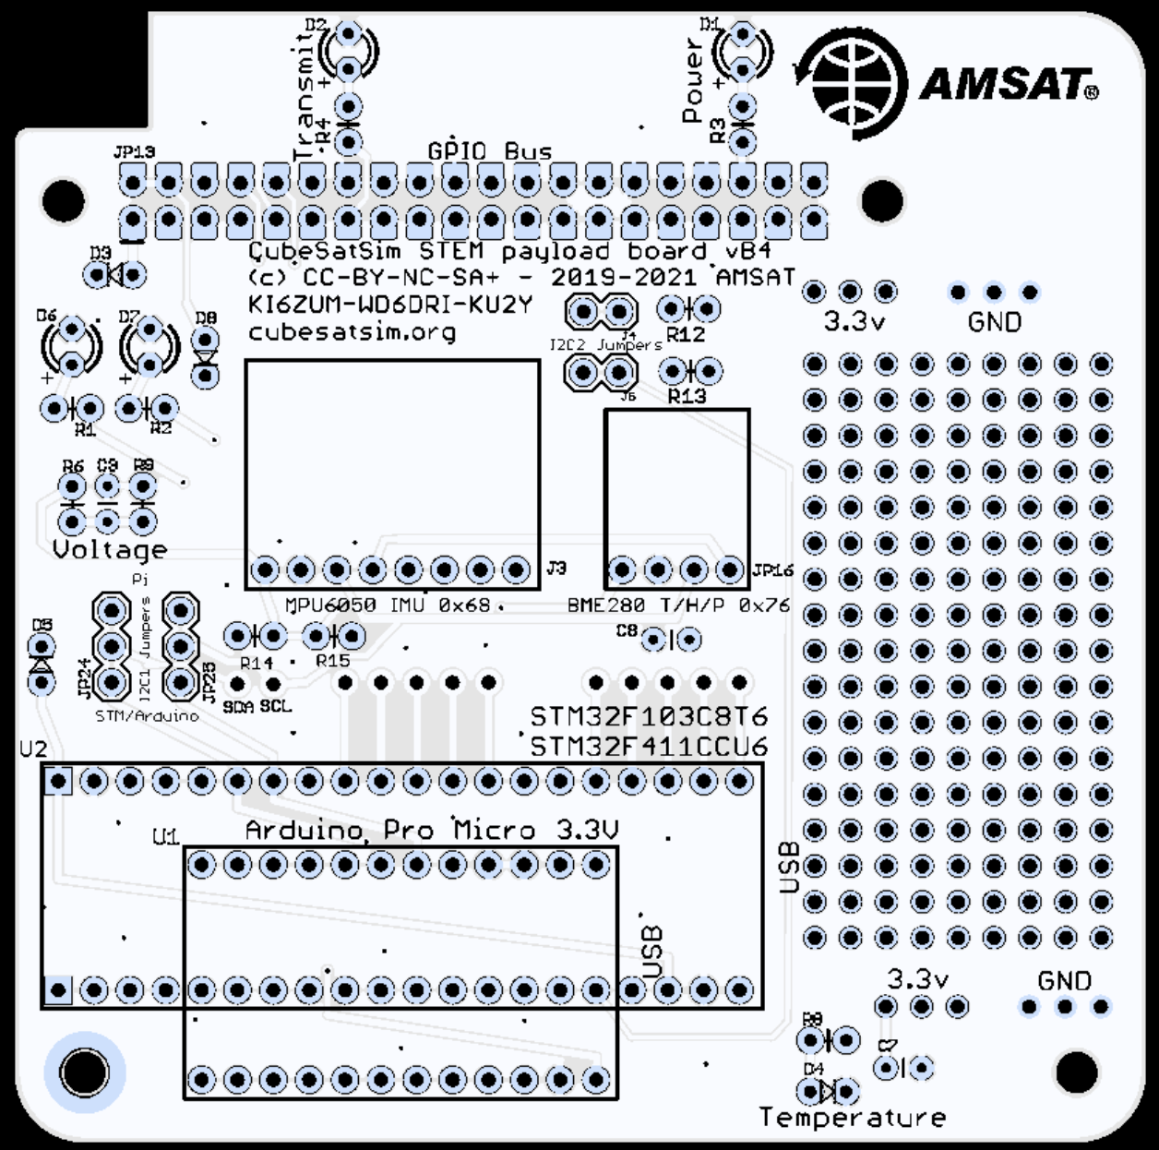
hardware/vB7/PCB STEM vB4 Top.png
