alanbjohnston/CubeSatSim/sstv/sstv_image_1_320_x_256.jpg

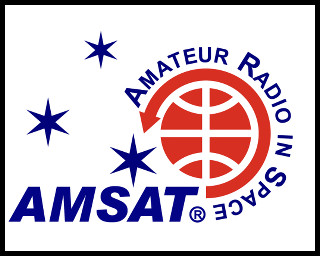
sstv/sstv_image_1_320_x_256.jpg
