alanbjohnston/CubeSatSim/sstv/sstv_image_2_320_x_256.jpeg

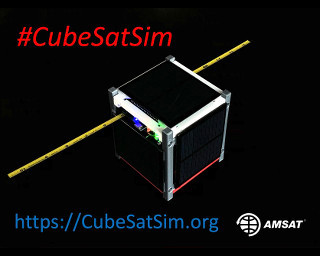
sstv/sstv_image_2_320_x_256.jpeg
