alanbjohnston/CubeSatSim/hardware/v2.1/cubesatsim-battery-v2.1.0_bom.csv.txt

"Part";"Value";"Device";"Package";"Description";"";
"BT1";"1024";"1024";"BAT_1024";"Check availability";"";
"BT2";"1012";"1012";"BAT_1012";"Check availability";"";
"C1";"DNI/0.1µF";"CAP_CERAMIC0603";"0603";"Ceramic Capacitors";"";
"F1";"PTC";"PTCPTH";"PTC";"Resettable Fuse PTC";"";
"J1";"CONN_20X2";"CONN_20X2";"2X20";"Multi connection point. Often used as Generic Header-pin footprint for 0.1 inch spaced/style header connections";"";
"JP1";"Micro JST";"M02JST-PTH-VERT";"JST-2-PTH-VERT";"Standard 2-pin 0.1" header. Use with";"";
"JP2";"";"CONN_01";"1X01";"Single connection point. Often used as Generic Header-pin footprint for 0.1 inch spaced/style header connections";"";
"JP3";"";"CONN_01";"1X01";"Single connection point. Often used as Generic Header-pin footprint for 0.1 inch spaced/style header connections";"";
"JP4";"JUMPER-SMT_2_NO_SILK";"JUMPER-SMT_2_NO_SILK";"SMT-JUMPER_2_NO_SILK";"Normally open jumper";"";
"JP5";"JUMPER-SMT_2_NC_TRACE_SILK";"JUMPER-SMT_2_NC_TRACE_SILK";"SMT-JUMPER_2_NC_TRACE_SILK";"Normally closed trace jumper";"";
"JP6";"JUMPER-SMT_2_NO_SILK";"JUMPER-SMT_2_NO_SILK";"SMT-JUMPER_2_NO_SILK";"Normally open jumper";"";
"JP7";"";"CONN_01";"1X01";"Single connection point. Often used as Generic Header-pin footprint for 0.1 inch spaced/style header connections";"";
"JP8";"Micro JST";"M02JST-PTH-VERT";"JST-2-PTH-VERT";"Standard 2-pin 0.1" header. Use with";"";
"JP10";"JUMPER-SMT_2_NC_TRACE_SILK";"JUMPER-SMT_2_NC_TRACE_SILK";"SMT-JUMPER_2_NC_TRACE_SILK";"Normally closed trace jumper";"";
"JP11";"JUMPER-SMT_2_NO_SILK";"JUMPER-SMT_2_NO_SILK";"SMT-JUMPER_2_NO_SILK";"Normally open jumper";"";
"JP13";"";"CONN_01";"1X01";"Single connection point. Often used as Generic Header-pin footprint for 0.1 inch spaced/style header connections";"";
"JP14";"";"CONN_01";"1X01";"Single connection point. Often used as Generic Header-pin footprint for 0.1 inch spaced/style header connections";"";
"R1";"DNI/R100";"R-US_R0805";"R0805";"RESISTOR, American symbol";"";
"R2";"10k";"R-EU_R0603";"R0603";"RESISTOR, European symbol";"";
"R3";"10k";"R-EU_R0603";"R0603";"RESISTOR, European symbol";"";
"U1";"INA219 purple board";"INA219";"INA219";"";"";
"U2";"INA219AIDR";"INA219AIDR";"D0008A_N";"";"";
