alanbjohnston/CubeSatSim/hardware/v2.1/cubesatsim-solar-v2.1.0_bom.csv.txt

"Part";"Value";"Device";"Package";"Description";"";
"C2";"0.1µF";"CAP_CERAMIC0603";"0603";"Ceramic Capacitors";"";
"C3";"0.1µF";"CAP_CERAMIC0603";"0603";"Ceramic Capacitors";"";
"C4";"0.1µF";"CAP_CERAMIC0603";"0603";"Ceramic Capacitors";"";
"C5";"0.1µF";"CAP_CERAMIC0603";"0603";"Ceramic Capacitors";"";
"C6";"0.1µF";"CAP_CERAMIC0603";"0603";"Ceramic Capacitors";"";
"C7";"0.1µF";"CAP_CERAMIC0603";"0603";"Ceramic Capacitors";"";
"D1";"1N5817";"DIODE-D-2.5";"D-2.5";"DIODE";"";
"D2";"1N5817";"DIODE-D-2.5";"D-2.5";"DIODE";"";
"D3";"1N5817";"DIODE-D-2.5";"D-2.5";"DIODE";"";
"D4";"1N5817";"DIODE-D-2.5";"D-2.5";"DIODE";"";
"D5";"1N5817";"DIODE-D-2.5";"D-2.5";"DIODE";"";
"D6";"1N5817";"DIODE-D-2.5";"D-2.5";"DIODE";"";
"D7";"1A/23V/620mV";"DIODE-SCHOTTKY-BAT20J";"SOD-323";"Schottky diode";"";
"D8";"1A/23V/620mV";"DIODE-SCHOTTKY-BAT20J";"SOD-323";"Schottky diode";"";
"D9";"1A/23V/620mV";"DIODE-SCHOTTKY-BAT20J";"SOD-323";"Schottky diode";"";
"D10";"1A/23V/620mV";"DIODE-SCHOTTKY-BAT20J";"SOD-323";"Schottky diode";"";
"D11";"1A/23V/620mV";"DIODE-SCHOTTKY-BAT20J";"SOD-323";"Schottky diode";"";
"D12";"1A/23V/620mV";"DIODE-SCHOTTKY-BAT20J";"SOD-323";"Schottky diode";"";
"J1";"CONN_20X2";"CONN_20X2";"2X20";"Multi connection point. Often used as Generic Header-pin footprint for 0.1 inch spaced/style header connections";"";
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
"U10";"INA219AIDR";"INA219AIDR";"D0008A_N";"";"";
"U11";"INA219AIDR";"INA219AIDR";"D0008A_N";"";"";
"U12";"INA219AIDR";"INA219AIDR";"D0008A_N";"";"";
"U13";"INA219AIDR";"INA219AIDR";"D0008A_N";"";"";
"U14";"INA219AIDR";"INA219AIDR";"D0008A_N";"";"";
