alanbjohnston/CubeSatSim/hardware/v2.1/cubesatsim-main-v2.1.0_bom.csv.txt

"Part";"Value";"Device";"Package";"Description";"";
"C1";"18pF";"CERAMIC-10PF-50V-5%-NPO(0603)";"C0603";"302010097";"";
"C2";"16pF";"CERAMIC-10PF-50V-5%-NPO(0603)";"C0603";"302010097";"";
"C3";"18pF";"CERAMIC-10PF-50V-5%-NPO(0603)";"C0603";"302010097";"";
"C4";"16pF";"CERAMIC-10PF-50V-5%-NPO(0603)";"C0603";"302010097";"";
"C5";"47uF";"CAPPTH";"CAP-PTH-SMALL";"Capacitor";"";
"C6";"100nF";"CAPPTH";"CAP-PTH-SMALL";"Capacitor";"";
"C7";"DNI/47uF";"CERAMIC-10PF-50V-5%-NPO(0603)";"C0603";"302010097";"";
"C8";"DNI/100nF";"CERAMIC-10PF-50V-5%-NPO(0603)";"C0603";"302010097";"";
"C9";"100nF";"CAPPTH";"CAP-PTH-SMALL";"Capacitor";"";
"C10";"DNI/100nF";"CERAMIC-10PF-50V-5%-NPO(0603)";"C0603";"302010097";"";
"D1";"BYW27-400";"DIODE-D-2.5";"D-2.5";"DIODE";"";
"D2";"1N5817";"DIODE-D-2.5";"D-2.5";"DIODE";"";
"D3";"1N4148";"DIODE-D-2.5";"D-2.5";"DIODE";"";
"D5";"DNI/1N4007FL";"DIODE_SOD-123FL";"SOD-123FL";"Diode";"";
"D6";"DNI/B5817WS";"DIODESOD-323F";"SOD-323F";"Diode";"";
"D7";"DNI/4148WS";"DIODESOD-323F";"SOD-323F";"Diode";"";
"D8";"DNI/5V1 Zener 1W";"ZENER-DIODEZD-2.5";"ZDIO-2.5";"Z-Diode";"";
"D10";"1N5817";"DIODE-D-2.5";"D-2.5";"DIODE";"";
"E1";"ANT-916-CHP-T";"ANT-916-CHP-T";"XDCR_ANT-916-CHP-T";"868MHz ISM, LoRa, Sensor Networks, SigFox Chip RF Antenna 863MHz ~ 873MHz 0.5dBi Solder Surface Mount  Check prices";"";
"E2";"ANT-916-CHP-T";"ANT-916-CHP-T";"XDCR_ANT-916-CHP-T";"868MHz ISM, LoRa, Sensor Networks, SigFox Chip RF Antenna 863MHz ~ 873MHz 0.5dBi Solder Surface Mount  Check prices";"";
"F1";"RHEF100-2";"PTCPTH";"PTC";"Resettable Fuse PTC";"";
"F2";"DNI/MF-FSML100/8-2";"PTC0603";"0603";"Resettable Fuse PTC";"";
"J1";"CONN_20X2";"CONN_20X2";"2X20";"Multi connection point. Often used as Generic Header-pin footprint for 0.1 inch spaced/style header connections";"";
"J4";"MPU6050";"M08NO_SILK_FEMALE_PTH";"1X08_NO_SILK@1";"Header 8";"";
"J5";"BME280";"M04NO_SILK_ALL_ROUND";"1X04_NO_SILK_ALL_ROUND";"Header 4";"";
"J6";"Micro JST";"M02JST-PTH-VERT";"JST-2-PTH-VERT";"Standard 2-pin 0.1" header. Use with";"";
"J7";"Micro JST";"M02JST-PTH-VERT";"JST-2-PTH-VERT";"Standard 2-pin 0.1" header. Use with";"";
"J8";"Sparkfun USB-C Breakout";"CONN_06NO_SILK_FEMALE_PTH";"1X06_NO_SILK";"Multi connection point. Often used as Generic Header-pin footprint for 0.1 inch spaced/style header connections";"";
"J9";"DNI/USB4105-GF-A or GT-USB-7010B";"USB_C_2-LAYER_PADS";"USB-C-16P-2LAYER-PADS";"USB Type C 16Pin Connector";"";
"J10";"DNI/Sparkfun QWIIC Breakout";"CONN_041X04_NO_SILK";"1X04_NO_SILK";"Multi connection point. Often used as Generic Header-pin footprint for 0.1 inch spaced/style header connections";"";
"J12";"DNI/1x4 pin header";"CONN_041X04_NO_SILK";"1X04_NO_SILK";"Multi connection point. Often used as Generic Header-pin footprint for 0.1 inch spaced/style header connections";"";
"J13";"SJ1-2503A";"SJ1-2503A";"CONN_SJ1-2503A";"";"";
"J14";"SJ1-2503A";"SJ1-2503A";"CONN_SJ1-2503A";"";"";
"J15";"";"CONN_06NO_SILK_NO_POP";"1X06_NO_SILK";"Multi connection point. Often used as Generic Header-pin footprint for 0.1 inch spaced/style header connections";"";
"JP1";"JUMPER-SMT_2_NO_SILK";"JUMPER-SMT_2_NO_SILK";"SMT-JUMPER_2_NO_SILK";"Normally open jumper";"";
"JP2";"JUMPER-SMT_2_NO_SILK";"JUMPER-SMT_2_NO_SILK";"SMT-JUMPER_2_NO_SILK";"Normally open jumper";"";
"JP3";"JUMPER-SMT_2_NC_TRACE_SILK";"JUMPER-SMT_2_NC_TRACE_SILK";"SMT-JUMPER_2_NC_TRACE_SILK";"Normally closed trace jumper";"";
"JP4";"JUMPER-SMT_2_NC_TRACE_SILK";"JUMPER-SMT_2_NC_TRACE_SILK";"SMT-JUMPER_2_NC_TRACE_SILK";"Normally closed trace jumper";"";
"JP5";"JUMPER-SMT_2_NO_SILK";"JUMPER-SMT_2_NO_SILK";"SMT-JUMPER_2_NO_SILK";"Normally open jumper";"";
"JP6";"JUMPER-SMT_2_NC_TRACE_SILK";"JUMPER-SMT_2_NC_TRACE_SILK";"SMT-JUMPER_2_NC_TRACE_SILK";"Normally closed trace jumper";"";
"JP7";"JUMPER-SMT_2_NO_SILK";"JUMPER-SMT_2_NO_SILK";"SMT-JUMPER_2_NO_SILK";"Normally open jumper";"";
"JP8";"JUMPER-SMT_2_NO_SILK";"JUMPER-SMT_2_NO_SILK";"SMT-JUMPER_2_NO_SILK";"Normally open jumper";"";
"JP9";"JUMPER-SMT_2_NO_SILK";"JUMPER-SMT_2_NO_SILK";"SMT-JUMPER_2_NO_SILK";"Normally open jumper";"";
"JP10";"JUMPER-SMT_2_NO_SILK";"JUMPER-SMT_2_NO_SILK";"SMT-JUMPER_2_NO_SILK";"Normally open jumper";"";
"JP11";"JUMPER-SMT_2_NC_TRACE_SILK";"JUMPER-SMT_2_NC_TRACE_SILK";"SMT-JUMPER_2_NC_TRACE_SILK";"Normally closed trace jumper";"";
"L1";"13nH";"SMD-FERRITE-CHIP-120-OHM-500MA(0603)";"L0603";"303030001";"";
"L2";"13nH";"SMD-FERRITE-CHIP-120-OHM-500MA(0603)";"L0603";"303030001";"";
"LED1";"White 5mm";"LED3MM";"LED3MM";"LED";"";
"LED2";"Yellow 5mm";"LED3MM";"LED3MM";"LED";"";
"LED3";"Green 5mm";"LED3MM";"LED3MM";"LED";"";
"LED4";"Blue 5mm";"LED3MM";"LED3MM";"LED";"";
"LED5";"Red 5mm";"LED3MM";"LED3MM";"LED";"";
"R1";"1K";"RESISTORPTH-1/4W-VERT";"AXIAL-0.1";"Resistor";"";
"R2";"DNI/1k";"R-EU_R0603";"R0603";"RESISTOR, European symbol";"";
"R3";"1K";"RESISTORPTH-1/4W-VERT";"AXIAL-0.1";"Resistor";"";
"R4";"DNI/1k";"R-EU_R0603";"R0603";"RESISTOR, European symbol";"";
"R5";"DNI/5.1k";"R-EU_R0603";"R0603";"RESISTOR, European symbol";"";
"R6";"DNI/5.1k";"R-EU_R0603";"R0603";"RESISTOR, European symbol";"";
"R7";"1k";"RESISTORPTH-1/4W-VERT";"AXIAL-0.1";"Resistor";"";
"R8";"100";"RESISTORPTH-1/4W-VERT";"AXIAL-0.1";"Resistor";"";
"R9";"220";"RESISTORPTH-1/4W-VERT";"AXIAL-0.1";"Resistor";"";
"R10";"DNI/1k";"SMD-RES-1.2K-1%-1/10W(0603)";"R0603";"301010206";"";
"R11";"DNI/100";"SMD-RES-1.2K-1%-1/10W(0603)";"R0603";"301010206";"";
"R12";"DNI/220";"SMD-RES-1.2K-1%-1/10W(0603)";"R0603";"301010206";"";
"R13";"68";"RESISTORPTH-1/4W-VERT";"AXIAL-0.1";"Resistor";"";
"R14";"180";"RESISTORPTH-1/4W-VERT";"AXIAL-0.1";"Resistor";"";
"R15";"68";"RESISTORPTH-1/4W-VERT";"AXIAL-0.1";"Resistor";"";
"R16";"DNI/68";"R-US_R0805";"R0805";"RESISTOR, American symbol";"";
"R17";"DNI/180";"SMD-RES-1.2K-1%-1/10W(0603)";"R0603";"301010206";"";
"R18";"DNI/68";"R-US_R0805";"R0805";"RESISTOR, American symbol";"";
"R19";"100";"RESISTORPTH-1/4W-VERT-KIT";"AXIAL-0.1EZ";"Resistor";"";
"R20";"220";"RESISTORPTH-1/4W-VERT-KIT";"AXIAL-0.1EZ";"Resistor";"";
"R21";"DNI/100";"SMD-RES-1.2K-1%-1/10W(0603)";"R0603";"301010206";"";
"R22";"DNI/220";"SMD-RES-1.2K-1%-1/10W(0603)";"R0603";"301010206";"";
"R23";"4.7k";"RESISTORPTH-1/4W-VERT";"AXIAL-0.1";"Resistor";"";
"R24";"4.7k";"RESISTORPTH-1/4W-VERT";"AXIAL-0.1";"Resistor";"";
"R25";"DNI/4.7k";"SMD-RES-1.2K-1%-1/10W(0603)";"R0603";"301010206";"";
"R26";"DNI/4.7k";"SMD-RES-1.2K-1%-1/10W(0603)";"R0603";"301010206";"";
"R27";"10K";"RESISTORPTH-1/4W-VERT";"AXIAL-0.1";"Resistor";"";
"R28";"DNI/10k";"R-EU_R0603";"R0603";"RESISTOR, European symbol";"";
"R29";"220";"RESISTORPTH-1/4W-VERT";"AXIAL-0.1";"Resistor";"";
"R30";"1k";"RESISTORPTH-1/4W-VERT";"AXIAL-0.1";"Resistor";"";
"R31";"DNI/220";"SMD-RES-1.2K-1%-1/10W(0603)";"R0603";"301010206";"";
"R32";"DNI/1k";"SMD-RES-1.2K-1%-1/10W(0603)";"R0603";"301010206";"";
"R33";"DNI/4.7k";"RESISTORPTH-1/4W-VERT";"AXIAL-0.1";"Resistor";"";
"R34";"DNI/4.7k";"RESISTORPTH-1/4W-VERT";"AXIAL-0.1";"Resistor";"";
"S1";"RA-SPST";"RA-SPST";"RA-SPST";"";"";
"U1";"Raspberry Pi Pico";"RASPBERRY_PICO-NO_DEBUG";"PICO-PKG-NO_DEBUG";"";"";
"U6";"SR105U";"SR_FRS_0W5";"SR_FRS_0W5";"";"";
"U7";"DRA818V";"DRA818V";"DORJI_DRA818V";"Check availability";"";
"X1";"SC1464-ND";"PG203J";"PG203J";"MIC/HEADPHONE JACK";"";
"X2";"SMA-VERT";"SMA-VERT";"SMA-VERT";"";"";
"X3";"SMA-VERT";"SMA-VERT";"SMA-VERT";"";"";
