alanbjohnston/CubeSatSim/hardware/lite/v2/cubesatsim-Lite-v2.0.1_bom.csv.txt

"Part";"Value";"Device";"Package";"Description";"";
"C1";"18pF";"CERAMIC-10PF-50V-5%-NPO(0603)";"C0603";"302010097";"";
"C2";"16pF";"CERAMIC-10PF-50V-5%-NPO(0603)";"C0603";"302010097";"";
"C3";"18pF";"CERAMIC-10PF-50V-5%-NPO(0603)";"C0603";"302010097";"";
"C4";"16pF";"CERAMIC-10PF-50V-5%-NPO(0603)";"C0603";"302010097";"";
"C5";"47uF";"CAPPTH";"CAP-PTH-SMALL";"Capacitor";"";
"C6";"100nF";"CAPPTH";"CAP-PTH-SMALL";"Capacitor";"";
"C7";"DNI/47uF";"CERAMIC-10PF-50V-5%-NPO(0603)";"C0603";"302010097";"";
"C8";"DNI/100nF";"CERAMIC-10PF-50V-5%-NPO(0603)";"C0603";"302010097";"";
"E1";"ANT-916-CHP-T";"ANT-916-CHP-T";"XDCR_ANT-916-CHP-T";"868MHz ISM, LoRa, Sensor Networks, SigFox Chip RF Antenna 863MHz ~ 873MHz 0.5dBi Solder Surface Mount  Check prices";"";
"E2";"ANT-916-CHP-T";"ANT-916-CHP-T";"XDCR_ANT-916-CHP-T";"868MHz ISM, LoRa, Sensor Networks, SigFox Chip RF Antenna 863MHz ~ 873MHz 0.5dBi Solder Surface Mount  Check prices";"";
"J1";"CONN_20X2";"CONN_20X2";"2X20";"Multi connection point. Often used as Generic Header-pin footprint for 0.1 inch spaced/style header connections";"";
"J2";"";"CONN_021X02_NO_SILK";"1X02_NO_SILK";"Multi connection point. Often used as Generic Header-pin footprint for 0.1 inch spaced/style header connections";"";
"J6";"Micro JST";"M02JST-PTH-VERT";"JST-2-PTH-VERT";"Standard 2-pin 0.1" header. Use with";"";
"J10";"DNI/Sparkfun QWIIC Breakout";"CONN_041X04_NO_SILK";"1X04_NO_SILK";"Multi connection point. Often used as Generic Header-pin footprint for 0.1 inch spaced/style header connections";"";
"J12";"DNI/1x4 pin header";"CONN_041X04_NO_SILK";"1X04_NO_SILK";"Multi connection point. Often used as Generic Header-pin footprint for 0.1 inch spaced/style header connections";"";
"J13";"SJ1-2503A";"SJ1-2503A";"CONN_SJ1-2503A";"";"";
"J14";"SJ1-2503A";"SJ1-2503A";"CONN_SJ1-2503A";"";"";
"J15";"";"CONN_06NO_SILK_NO_POP";"1X06_NO_SILK";"Multi connection point. Often used as Generic Header-pin footprint for 0.1 inch spaced/style header connections";"";
"JP1";"JUMPER-SMT_2_NC_TRACE_SILK";"JUMPER-SMT_2_NC_TRACE_SILK";"SMT-JUMPER_2_NC_TRACE_SILK";"Normally closed trace jumper";"";
"JP2";"JUMPER-SMT_2_NO_SILK";"JUMPER-SMT_2_NO_SILK";"SMT-JUMPER_2_NO_SILK";"Normally open jumper";"";
"JP3";"JUMPER-SMT_2_NC_TRACE_SILK";"JUMPER-SMT_2_NC_TRACE_SILK";"SMT-JUMPER_2_NC_TRACE_SILK";"Normally closed trace jumper";"";
"JP6";"JUMPER-SMT_2_NC_TRACE_SILK";"JUMPER-SMT_2_NC_TRACE_SILK";"SMT-JUMPER_2_NC_TRACE_SILK";"Normally closed trace jumper";"";
"JP7";"JUMPER-SMT_2_NO_SILK";"JUMPER-SMT_2_NO_SILK";"SMT-JUMPER_2_NO_SILK";"Normally open jumper";"";
"L1";"13nH";"SMD-FERRITE-CHIP-120-OHM-500MA(0603)";"L0603";"303030001";"";
"L2";"13nH";"SMD-FERRITE-CHIP-120-OHM-500MA(0603)";"L0603";"303030001";"";
"LED3";"Green 5mm";"LED3MM";"LED3MM";"LED";"";
"LED4";"Blue 5mm";"LED3MM";"LED3MM";"LED";"";
"LED5";"GREEN";"LED-GREEN0603";"LED-0603";"Green SMD LED";"";
"LED6";"BLUE";"LED-BLUE0603";"LED-0603";"Blue SMD LED";"";
"R1";"1K";"RESISTORPTH-1/4W-VERT";"AXIAL-0.1";"Resistor";"";
"R2";"DNI/1k";"R-EU_R0603";"R0603";"RESISTOR, European symbol";"";
"R3";"1K";"RESISTORPTH-1/4W-VERT";"AXIAL-0.1";"Resistor";"";
"R4";"DNI/1k";"R-EU_R0603";"R0603";"RESISTOR, European symbol";"";
"R7";"1k";"RESISTORPTH-1/4W-VERT";"AXIAL-0.1";"Resistor";"";
"R8";"DNI/100";"RESISTOR0603";"0603-RES";"Resistor";"";
"R10";"DNI/1k";"RESISTOR0603-RES";"0603-RES";"Resistor";"";
"R11";"100";"RESISTORPTH-1/4W-VERT";"AXIAL-0.1";"Resistor";"";
"R13";"68";"RESISTORPTH-1/4W-VERT";"AXIAL-0.1";"Resistor";"";
"R14";"180";"RESISTORPTH-1/4W-VERT";"AXIAL-0.1";"Resistor";"";
"R15";"68";"RESISTORPTH-1/4W-VERT";"AXIAL-0.1";"Resistor";"";
"R16";"DNI/68";"R-US_R0805";"R0805";"RESISTOR, American symbol";"";
"R17";"DNI/180";"SMD-RES-1.2K-1%-1/10W(0603)";"R0603";"301010206";"";
"R18";"DNI/68";"R-US_R0805";"R0805";"RESISTOR, American symbol";"";
"R19";"100";"RESISTORPTH-1/4W-VERT-KIT";"AXIAL-0.1EZ";"Resistor";"";
"R20";"220";"RESISTORPTH-1/4W-VERT-KIT";"AXIAL-0.1EZ";"Resistor";"";
"R21";"DNI/100";"SMD-RES-1.2K-1%-1/10W(0603)";"R0603";"301010206";"";
"R22";"DNI/220";"SMD-RES-1.2K-1%-1/10W(0603)";"R0603";"301010206";"";
"S1";"RA-SPST";"RA-SPST";"RA-SPST";"";"";
"S2";"DTSM-6";"DTSM-6";"DTSM-6";"";"";
"U1";"SR105U";"SR_FRS_0W5";"SR_FRS_0W5";"";"";
"X2";"SMA-VERT";"SMA-VERT";"SMA-VERT";"";"";
"X3";"SMA-VERT";"SMA-VERT";"SMA-VERT";"";"";
