alanbjohnston/CubeSatSim/hardware/v2.1/CubeSatSim Main v2.1.0 BOM.xls

PCBWay Bom Main v2.1.0
Item # | *Designator | *Qty | Manufacturer | *Mfg Part # | Description / Value | *Package/Footprint | Mounting Type | Your Instructions / Notes | *Unit Price(20 sets) | *Total | *Delivery Time | Customer Reply | PCBWay Update
1 | L1, L2 | 2 | Sunlord | SDWL1608C13NJSTFM01 | 13nH inductor | 0603 | SMD | https://www.lcsc.com/product-detail/Power-Inductors_Sunlord-SDWL1608C13NJSTFM01_C408730.html
2 | C1, C3 | 2 | YAGEO | CC0603FRNPO9BN180 | 18pf 50V cermanic capacitor | 0603 | SMD | https://lcsc.com/product-detail/Multilayer-Ceramic-Capacitors-MLCC-SMD-SMT_YAGEO-CC0603FRNPO9BN180_C527046.html『 』https://www.digikey.com/en/products/detail/murata-electronics/GCM1885C1H180JA16D/2591410
3 | C2, C4 | 2 | FH(Guangdong Fenghua Advanced Tech) | 0603CG160J500NT | 16pF 50V ceramic capacitor | 0603 | SMD | https://lcsc.com/product-detail/Multilayer-Ceramic-Capacitors-MLCC-SMD-SMT_FH-Guangdong-Fenghua-Advanced-Tech-0603CG160J500NT_C1646.html『 』https://www.digikey.com/en/products/detail/kyocera-avx/06035A160JAT2A/1599665
4 | R2, R4 | 2 | UNI-ROYAL(Uniroyal Elec) | 0603WAF1001T5E | 1k resistor 1/10 watt 1% | 0603 | SMD | https://lcsc.com/product-detail/Chip-span-style-background-color-ff0-Resistor-span-Surface-Mount_UNI-ROYAL-Uniroyal-Elec-0603WAF1001T5E_C21190.html『 』https://www.digikey.com/en/products/detail/walsin-technology-corporation/WR06X102-JTL/13241138
5 | J9 | 1 | Global Connector Technology | USB4105-GF-A | Surface mount USB-C connector |  |  | https://www.lcsc.com/product-detail/span-style-background-color-ff0-USB-span-Connectors_Global-Connector-Technology-USB4105-GF-A_C3020560.html
6 | R5, R6 | 2 | UNI-ROYAL(Uniroyal Elec) | 0603WAF5101T5E | 5.1k resistor 1/10 Watt 1% | 0603 | SMD | https://lcsc.com/product-detail/Chip-span-style-background-color-ff0-Resistor-span-Surface-Mount_UNI-ROYAL-Uniroyal-Elec-0603WAF5101T5E_C23186.html『 』https://www.digikey.com/en/products/detail/yageo/RC0603JR-075K1L/726796
7 | U6 | 1 | ShenZhen Sunrise Electronics Co Ltd | SR105U/SR_FRS_0W5U | UHF FM module |  | SMD | https://dwmzone.com/en/walkie-talkie-module/1103-sr105u-uhf-400m-480m-analog-walkie-talkie-transceiver-data-transfer-module.html
