alanbjohnston/CubeSatSim/hardware/v1.1/cubesatsim-STEM-1.1a_bom.csv.txt

"Qty";"Value";"Device";"Package";"Parts";"Description";"PROD_ID";
"12";"";"M01NOSILK-KIT";"1X01NS-KIT";"JP1, JP2, JP3, JP6, JP7, JP8, JP9, JP10, JP11, JP14, JP15, JP16";"Header 1";"";
"3";"100nF";"CAPPTH";"CAP-PTH-SMALL";"C1, C2, C3";"Capacitor";"";
"3";"10K";"RESISTORPTH-1/4W-VERT";"AXIAL-0.1";"R9, R10, R11";"Resistor";"";
"1";"1N4148";"DIODE-D-2.5";"D-2.5";"D4";"DIODE";"";
"3";"1N5817";"DIODE-D-2.5";"D-2.5";"D1, D2, D3";"DIODE";"";
"2";"1x20 female header";"M20NOSILK";"1X20_NOSILK";"J6, J7";"1x20 .1" header";"";
"2";"4.7k";"RESISTORPTH-1/4W-VERT";"AXIAL-0.1";"R1, R2";"Resistor";"";
"2";"470";"RESISTORPTH-1/4W-VERT";"AXIAL-0.1";"R3, R4";"Resistor";"";
"1";"BME280";"M04NO_SILK_ALL_ROUND";"1X04_NO_SILK_ALL_ROUND";"JP21";"Header 4";"";
"1";"Blue 5mm";"LED3MM";"LED3MM";"LED2";"LED";"";
"1";"CONN_20X2";"CONN_20X2";"2X20";"J4";"Multi connection point. Often used as Generic Header-pin footprint for 0.1 inch spaced/style header connections";"";
"1";"DNI-100";"RESISTORPTH-1/4W-VERT";"AXIAL-0.1";"R6";"Resistor";"";
"1";"DNI-1k";"RESISTORPTH-1/4W-VERT";"AXIAL-0.1";"R5";"Resistor";"";
"2";"DNI-1x2 pin header";"CONN_021X02_NO_SILK";"1X02_NO_SILK";"J1, J2";"Multi connection point. Often used as Generic Header-pin footprint for 0.1 inch spaced/style header connections";"";
"2";"DNI-1x3 pin header with jumper";"M031X03_NO_SILK";"1X03_NO_SILK";"JP12, JP13";"Header 3";"";
"1";"DNI-1x4 pin header";"CONN_041X04_NO_SILK";"1X04_NO_SILK";"J3";"Multi connection point. Often used as Generic Header-pin footprint for 0.1 inch spaced/style header connections";"CONN-09696";
"2";"DNI-4k";"RESISTORPTH-1/4W-VERT";"AXIAL-0.1";"R7, R8";"Resistor";"";
"1";"DNI-Blue 5mm";"LED3MM";"LED3MM";"LED4";"LED";"";
"1";"DNI-Green 5mm";"LED3MM";"LED3MM";"LED3";"LED";"";
"1";"Green 5mm";"LED3MM";"LED3MM";"LED1";"LED";"";
"2";"JUMPER-SMT_2_NC_TRACE_SILK";"JUMPER-SMT_2_NC_TRACE_SILK";"SMT-JUMPER_2_NC_TRACE_SILK";"JP17, JP19";"Normally closed trace jumper";"";
"4";"JUMPER-SMT_2_NO_SILK";"JUMPER-SMT_2_NO_SILK";"SMT-JUMPER_2_NO_SILK";"JP4, JP5, JP18, JP20";"Normally open jumper";"";
"1";"MPU6050";"M08NO_SILK_FEMALE_PTH";"1X08_NO_SILK";"J5";"Header 8";"CONN-08438";
"1";"Sparkfun Pro Micro 3.3V 8MHz";"SPARKFUN_PRO_MICRO";"SPARKFUN_PRO_MICRO";"U1";"SparkFun Pro Micro";"";
