alanbjohnston/CubeSatSim/hardware/v1.1/cubesatsim-main-1.1_bom.csv.txt

"Qty";"Value";"Device";"Package";"Parts";"Description";"MPN";"VALUE";
"1";"";"CN3085-MODULE";"CN3085-MODULE";"U6";"";"";"";
"1";"100";"RESISTORPTH-1/4W-VERT-KIT";"AXIAL-0.1EZ";"R12";"Resistor";"";"";
"1";"13nH";"SMD-FERRITE-CHIP-120-OHM-500MA(0603)";"L0603";"L1";"303030001";"BLM18AG121SN1D";"120";
"1";"16pF";"CERAMIC-10PF-50V-5%-NPO(0603)";"C0603";"C2";"302010097";"";"10pf";
"1";"18pF";"CERAMIC-10PF-50V-5%-NPO(0603)";"C0603";"C1";"302010097";"";"10pf";
"1";"1K";"RESISTORPTH-1/4W-VERT-KIT";"AXIAL-0.1EZ";"R1";"Resistor";"";"";
"7";"1N5817";"DIODE-D-2.5";"D-2.5";"D1, D2, D3, D4, D5, D6, D7";"DIODE";"";"";
"1";"1V-5V Boost 5V Regulator";"USB-BOOST";"USB-BOOST";"U7";"";"";"";
"1";"1k";"RESISTORPTH-1/4W-VERT-KIT";"AXIAL-0.1EZ";"R11";"Resistor";"";"";
"1";"220";"RESISTORPTH-1/4W-VERT-KIT";"AXIAL-0.1EZ";"R13";"Resistor";"";"";
"2";"4.7k";"RESISTORPTH-1/4W-VERT-KIT";"AXIAL-0.1EZ";"R3, R4";"Resistor";"";"";
"1";"5V1 Zener 1W";"ZENER-DIODEZD-2.5";"ZDIO-2.5";"D8";"Z-Diode";"";"";
"1";"Blue 5mm";"LED3MM";"LED3MM";"LED2";"LED";"";"";
"1";"CFP2-2RC4-AW";"SWITCH-DPDTOS";"OS";"S1";"DPDT Version of the COM-00597";"";"";
"1";"CONN_20X2";"CONN_20X2";"2X20";"J1";"Multi connection point. Often used as Generic Header-pin footprint for 0.1 inch spaced/style header connections";"";"";
"2";"DNI-0R";"RESISTORPTH-1/4W-VERT-KIT";"AXIAL-0.1EZ";"R9, R10";"Resistor";"";"";
"1";"DNI-1K";"RESISTORPTH-1/4W-VERT-KIT";"AXIAL-0.1EZ";"R5";"Resistor";"";"";
"2";"DNI-1k";"R-EU_R0603";"R0603";"R2, R6";"RESISTOR, European symbol";"";"";
"2";"DNI-4.7k";"RESISTORPTH-1/4W-VERT-KIT";"AXIAL-0.1EZ";"R7, R8";"Resistor";"";"";
"1";"DNI-5V1 Zener 1W";"ZENER-DIODEZD-2.5";"ZDIO-2.5";"D9";"Z-Diode";"";"";
"1";"Green 5mm";"LED3MM";"LED3MM";"LED1";"LED";"";"";
"8";"INA219 purple board";"INA219";"INA219";"U1, U2, U3, U4, U5, U8, U9, U10";"";"";"";
"8";"Micro JST";"M02JST-PTH-VERT";"JST-2-PTH-VERT";"JP1, JP2, JP4, JP5, JP6, JP7, JP8, JP10";"Standard 2-pin 0.1" header. Use with";"";"";
"1";"PTCPTH";"PTCPTH";"PTC";"F1";"Resettable Fuse PTC";"";"";
"1";"Red 5mm";"LED3MM";"LED3MM";"LED3";"LED";"";"";
"1";"SC1464-ND";"PG203J";"PG203J";"X1";"MIC/HEADPHONE JACK";"";"";
"1";"SMA-VERT";"SMA-VERT";"SMA-VERT";"X11";"";"";"";
"1";"VDD-EN";"JUMPER-SMT_2_NC_TRACE_SILK";"SMT-JUMPER_2_NC_TRACE_SILK";"JP3";"Normally closed trace jumper";"";"";
"1";"micro USB breakout board";"M05NO_SILK";"1X05_NO_SILK";"JP9";"Header 5";"";"";
