alanbjohnston/CubeSatSim/hardware/frame/v2.0/2u/cubesatsim_frame_connector.v2.0.stl

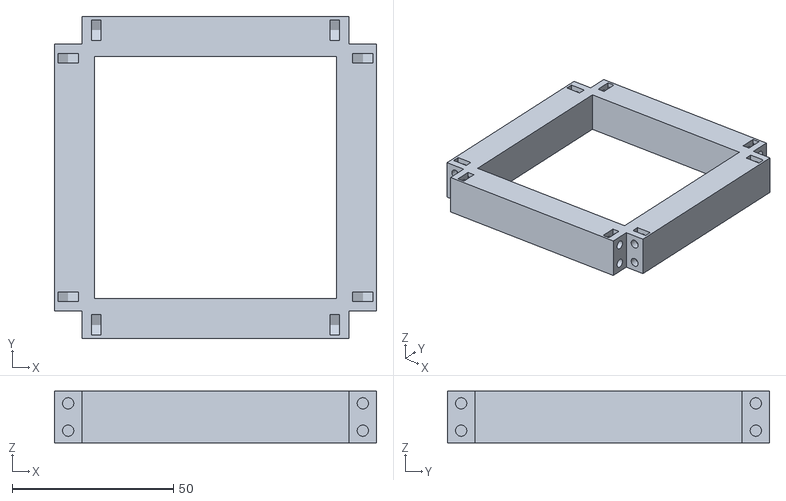
[picture p63: CAD file, 2025-10-14]
hardware/frame/v2.0/2u/cubesatsim_frame_connector.v2.0.stl
100.0 x 100.0 x 16.0
