alanbjohnston/CubeSatSim/hardware/frame/v2.0/plug_circle_24.stl

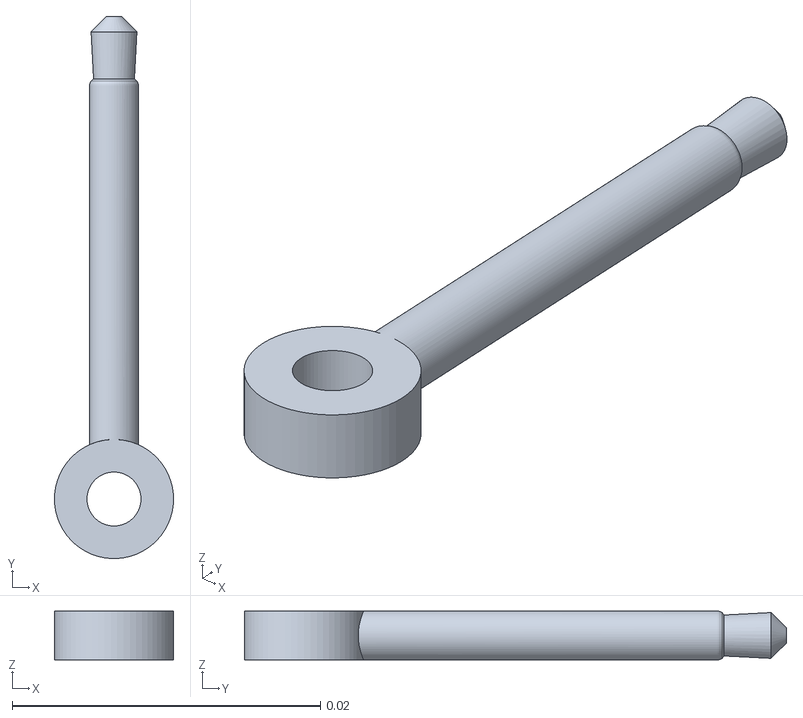
[picture p64: CAD file, 2025-05-21]
hardware/frame/v2.0/plug_circle_24.stl
0.00773 x 0.0352 x 0.00317
