alanbjohnston/CubeSatSim/hardware/frame/v2.0/cubesatsim_frame_top_bottom.v2.0.stl

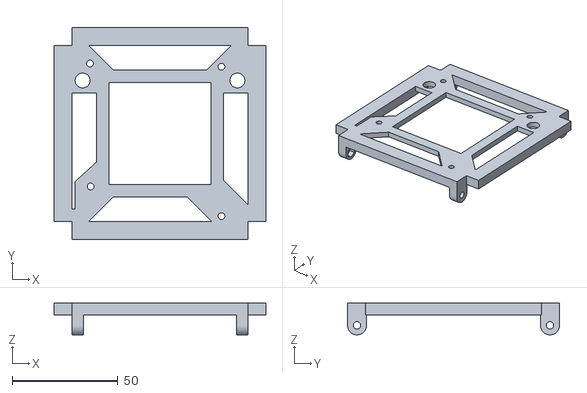
[picture p65: CAD file, 2024-10-22]
hardware/frame/v2.0/cubesatsim_frame_top_bottom.v2.0.stl
100.0 x 100.0 x 15.0
