alanbjohnston/CubeSatSim/hardware/frame/v2.0/cubesatsim_frame_side_camera.v2.0.stl

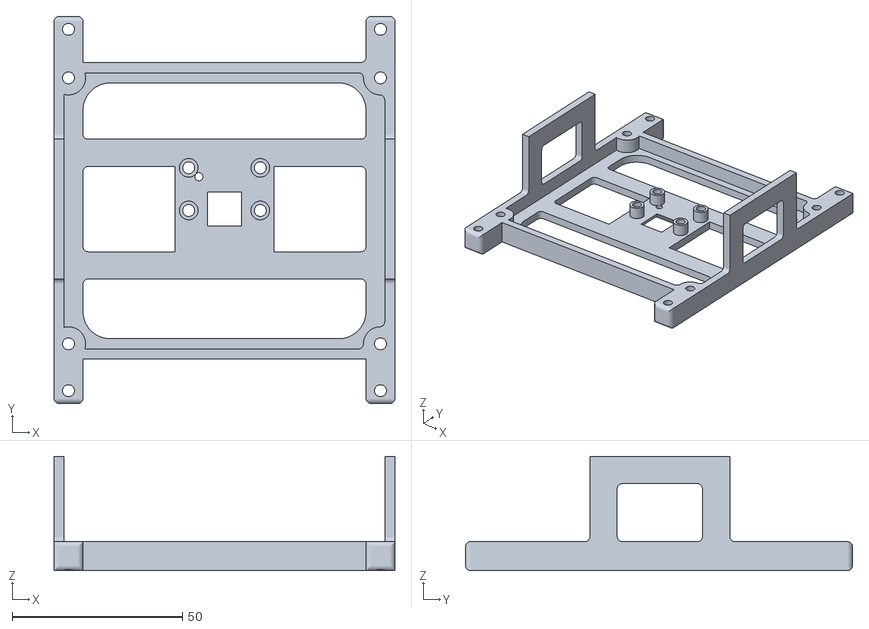
[picture p66: CAD file, 2024-10-22]
hardware/frame/v2.0/cubesatsim_frame_side_camera.v2.0.stl
100.0 x 113.5 x 33.5
