alanbjohnston/CubeSatSim/(list of files, cad)

Other CAD files:
hardware/frame/v1.3.2/cubesatsim_frame_side.v1.3.2.stl
hardware/frame/v1.3.2/cubesatsim_frame_side_camera.v1.3.2.stl
