alanbjohnston/CubeSatSim/(threads)

Thread 151 (2022-07-01):

KiCAD files for latest hardware version?

zeitkunst, 2022-07-01:
Thanks so much for your work on the CubeSatSim! It appears to be a really great project and has such wonderful documentation.

I'm an artist (and also a ham, KC1EKK), and am using CubeSatSim in a current project of mine, albeit modified. I'd like to be able to rework the PCBs a bit for my own hardware needs. I see that earlier versions of the hardware had KiCAD files available, but the latest ones only have PDF schematics. Would it be possible to release the KiCAD files again? This would save a lot of time, rather than having to recreate the board layout from scratch from the PDF schematics. I would of course share my changes as required by the CC license.

Thanks!

alanbjohnston, 2022-07-12:
Hi! We used KiCAD initially but now we use Eagle CAD v7.5 (free version). I would like to share the .brd and .sch files but I first need to clean up the libraries. It is on my todo list but I may not get to it this summer. I’ll leave this open until I post them.

urs8000, 2022-11-20:
@alanbjohnston   hi, I'm from Switzerland and have no license and the used CBband is here not allowed here.
So I would like to modify the payload board with a newer microcontroller and a LoRa chip. For that I would appreciate getting the eagle schematics and the layout of the boards. for sure there will be a feedback if the changed board was funcional
thanks!

alanbjohnston, 2022-11-24:
It’s still on my todo list - I’ll let you know when I have an update.

Thread 232 (2022-10-19):

Send telemetry via other communications channels

MikeMcPherson, 2022-10-19:
I would like to have software other than FoxTelem consume and process the telemetry from the CubeSatSim.  This is for both teaching and for developing and evaluating ground station software for future missions.  I have modified the code to add a couple of capabilities, and I'm interested in whether others find these things useful.  If so, I'll clean up what I've done, do a fork, and submit my changes.

**Capability 1 - publish telemetry via MQTT**

FoxTelem is great. but in our "mission control" room we have a 55" UHD display.  FoxTelem isn't very useful on a display with that many pixels - too small to read.  It's also really an interactive tool and doesn't work well for an unattended "mission status" display.

I've modified the CubeSatSim code to publish all of the BPSK telemetry values via MQTT for analysis and visualization by any tools supporting that common protocol.  I'm using a Mosquitto->Telegraf->InfluxDB->Grafana stack to make pretty eye candy that plays well on the big screen, incorporates things such as ground station component status, and can be reconfigured dynamically depending on the context.  We might want one display most of the time, another during a pass, and a third when commanding the spacecraft, for example.

**Capability 2 - send telemetry via UDP**

One of the things we're doing is evaluating open source ground station software.  Hopefully, we won't have to write our own for future missions.  Done that once, don't want to do it again!  All the candidates can consume a telemetry stream from a "radio" via UDP.

I've modified the CubeSatSim code to send the FSK/BPSK telementry packets via UDP.

To be clear: I am not asking anyone else to add these capabilities.  I've already done most of the work, and just want to know if anyone else is interested.

Thanks.  Mike

alanbjohnston, 2022-10-25:
Hi Mike,

Thanks for your work on the CubeSatSim project!

These are interesting capabilities.  In the past, had some experimental code that used REST to push telemetry data to the SatNOGS database so it would be displayed in a dashboard on their site: https://dashboard.satnogs.org/d/VesVjq6mk/amsat-cubesat-simulator

I don't have any issues with having this capability in addition to sending telemetry over radio.

(One comment: In the FoxTelem Settings menu, you can change all the font sizes which might make it look better on a big screen).

MQTT and UDP seem like good candidates.  Perhaps also the KISS protocol as well.

It would be great if we could architect this as an optional add-on.  Not every CubeSatSim has internet access (a Pi Zero, for instance, or a Pi Zero W that is not connected to a WiFi).   A Wiki page giving examples of how to process and display the data would also be great, I think.

Alan

MikeMcPherson, 2022-10-26:
Thanks for the support and great suggestions.  The new code is conditional and will be turned off by default.  A page talking about how to use the additional capability is a great idea, and I'll work on it.

Mike

MikeMcPherson, 2022-10-27:
Do you have a "How to Contribute" document for the CubeSatSim project, or will the generic process work?  Are you working with a particular style guide or coding standard document?  (JPL, for example?)

Mike

Closed 2025-09-02.

Thread 233 (2022-10-19):

Trigger "failures" remotely

MikeMcPherson, 2022-10-19:
We're interested in adding the ability to more easily simulate failures for teaching fault analysis and mitigation.  Right now, we can fail things like solar panels, but that requires some degree of disassembly and reassembly.  Other failures are much harder to do.

I imagine a software interface - possibly command line, but preferably GUI - that would allow an instructor to command a wide range of failures on a live CubeSatSim.  I imagine this being implemented in two phases.

**Phase 1 - all software**

Lots of interesting failure modes can be simulated in software by just substituting synthetic values in place of real values in telemetry packets.

**Phase 2 - software/hardware hybrid**

Some failures, such as partial or gradual sensor or solar panel failures, might best be handled by an add-on PCB with a variety of switches and filters.  I'm much fuzzier on the requirements for this phase.

I haven't done anything but brainstorm this so far, but I'll probably have a go at it when time allows.  Like the issue I submitted a few minutes ago, I'm not asking anyone else to do this.

Mike

alanbjohnston, 2022-10-25:
Hi Mike,

Being able to show and diagnose failures is a great application of the CubeSatSim.

Doing this in software is a great idea - more flexible and easier than hardware.

I'd suggest starting a thread in the Discussions tab https://github.com/alanbjohnston/CubeSatSim/discussions

This way we can get ideas and input from others who have built CubeSatSims.  There is also a group who is developing lesson plans and experiments using the CubeSatSim, so I'm sure they will have some suggestions on this.

Thanks again for your work on the project!

Alan

MikeMcPherson, 2022-10-26:
Thanks!  I'll start a discussion thread.

Mike

Closed 2025-01-19.

Thread 272 (2023-08-03):

CubeSatSim Lite

roypyp, 2023-08-03:
I have a few questions about CubeSatSim Lite.

First, I would like to know if you have an example of telemetry or an explanation of the telemetry list of the CubeSatSim Lite.
Second, can we simulate an attack on that model?

I appreciate any help you can provide,
Roy.

alanbjohnston, 2023-08-03:
Hi Roy,

These type of questions are best discussed Discussions https://github.com/alanbjohnston/CubeSatSim/discussions so let's have followup discussions there.

First, note that the CubeSatSim Lite is the same software as the full CubeSatSim.  The difference is that the Lite board doesn't have any sensors, just a Low Pass Filter and some buttons and LEDs to change modes.

The CubeSatSim software mimics the telemetry format of the Fox-1 series of CubeSats built by AMSAT.  The format and details of the telemetry are published in various places including the AMSAT Journal and the AMSAT Space Symposium Proceedings.

As for simulating an attack, I don't quite know what you mean. Currently, the CubeSatSim just transmits a telemetry beacon.  There is no uplink command and control over the radio.  Is that the attack vector you are thinking of?  In the future, we may add a simple command and control ability to turn the beacon on and off.

If I am missing the point or you need more information, feel free to post in Discussions so we can have more back and forth and others can also weigh in.

Thanks,
Alan

alanbjohnston, 2023-08-03:
Discussion should move to https://github.com/alanbjohnston/CubeSatSim/discussions

Closed 2023-08-03.

Thread 284 (2023-10-25):

I2C BUS 1 FAIL

gorkaarce, 2023-10-25:
Hi there,
my students and I are doing this CubeSatSim project, but we´ve been facing an issue in the last days regarding the INA sensors through BUS 1.
Both using telemetry via Foxtelem or reading directly through terminal we get 0V values for +X, +Y, PSU and Battery.
On the other hand BUS 3 is getting ok values, tipycally reading 0.9V with no panels attached and 3,5-4,5 Volts with panels attached. (see pic. attached)
We have activated manually BUS 1 through terminal following these instructions (https://www.instructables.com/Raspberry-PI-Multiple-I2c-Devices/).
We have checked I2C adresses,removed and tried with 4k7 resistors, checked jumpers,
and now we get OK status on I2C BUS 1 in fox telem (without the resistors, but sadly no readings show up..
We are building 2 Cubesats and get same trouble on both !

Another issue with the INA testing is that we don´t get readings performing the presoldering test (see pic 2), could these 2 be related?

Any help regarding this issue would be much appreciated!
Thank you so much
Gorka

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

alanbjohnston, 2023-10-31:
Hi Gorka,

I’d suggest you post problems like this on the Discussions page rather than as a code issue https://github.com/alanbjohnston/CubeSatSim/discussions

It sounds like your INA219 boards are bad. I have stopped buying the purple ones as most of them sold don’t work. If they don’t test OK, they won’t work when soldered in.

I have had better luck with the blue INA219 boards, but they are bigger and require some mods to fit.

Good luck with your build!

Alan

gorkaarce, 2023-10-31:
hi alan,
 thanks for the answer,
we have used the blue INAs (the picture is from the wiki to ilustrate the test).
None of them are testing as ok on the test pins, but work fine, the trouble is with the SW in my opinion.
and on both cubesats we mounted the same trouble related to the same bus 1..(that´s why i posted it there)
we just received the sparkfun pro micro (really hard to get the whole BOM..)and finished testing hopefully everything works, if you have any feedback regarding the bus 1 issue..would be great to know.
cheers
gorka

Closed 2023-10-31.

Thread 301 (2024-02-25):

Qwiic mounting direction of solar board

kei-Shima, 2024-02-25:
Thank you for developing Cubesatsim.

We are working on v1.3.2. There is a picture of the Qwiic installed on the solar board description page, I think the Qwiic connection direction is reversed.
If we check the silk print on the board, there is no problem. However, I think there are some people who will make the board based on the photo, so I would appreciate it if you could replace the photo with the one shown.

[https://github.com/alanbjohnston/CubeSatSim/wiki/v1.3.2-6.-Solar-Board](https://github.com/alanbjohnston/CubeSatSim/wiki/v1.3.2-6.-Solar-Board)
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

alanbjohnston, 2024-02-25:
Good catch!  I have fixed the images in four places where it is shown upside down!  Thanks!

Closed 2024-02-25.

Thread 308 (2024-03-22):

Holes too small for usbc port

Bouledogus, 2024-03-22:
Hello,
I'm F4LBJ from AMSAT Francophone.
I have made the CubeSatSim and I have encountered a problem with the USBC port on the STEM card.
The holes for the connector harpoons are too small. I had to cut the connector studs to be able to solder it to the PCB.
Could you modify the PCB to enlarge the holes?

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

Thanks

alanbjohnston, 2024-03-22:
Hi,

What version of the PCB is it?  Did you have PCBWay or another fabricator make the boards for you?  What part number was the SMT USB-C part?

I will figure out what went wrong, but if this happens in the future, the board also has a footprint for the Sparkfun USB-C breakout board (https://www.sparkfun.com/products/15100)

73,
Alan
KU2Y

Bouledogus, 2024-03-22:
Hello Alan,
Thank you for your quick reply.
The board version is 1.3.2b.
The SMT part I'm using is USB4105-GF-A from CGT, the same one you suggest in the BOM.
I used JLCPCB for manufacturing.
As you can see in the picture, there is just four small holes, not enought for inserting the USB port
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

73 !

alanbjohnston, 2024-03-25:
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

This is what my boards from PCBWay look like. I need to figure out why our boards are different using the same Gerbers.

Alan

Bouledogus, 2024-03-25:
Hello Alan,
The PCB version you have is 1.3.2.1, but on the github it is version 1.3.2b that is available.
I did the test to import the gerbers 1.3.2b on PCBWay and the holes are not present as you can see on the picture below:
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
 73 !

alanbjohnston, 2024-03-26:
Hi,

I think I understand what has happened.  For the USB-C part, there is a drill hole (.TXT file) and a mill hole (.GML file).  The PCBWay Gerber viewer doesn't seem to show mill holes (in my experience, it sometimes isn't 100% accurate).  If I look at the GML and TXT files from v1.3.2b in another Gerber viewer such as gerber-viewer.com,  I see this:

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

The green is the drill layer (.TXT) while the red is the mill layer (.GML).

You might want to show this to JLCPCB and ask them why they ignored the mill layer.  PCBWay did this once, but otherwise, they always follow the mill layer.

73,
Alan

Bouledogus, 2024-03-29:
Thank you, Alan, for your reply. I understand better now what's going on. I'm going to check with JLCPCB to see why the .GML file is being ignored.
What CAD software are you using? I'm using KICAD and I don't have a .GML file.

73,
Arnaud

Bouledogus, 2024-04-02:
Hello Alan,
I have continued my research.
It seems that you are using Eagle CAD and that the gerbers are exported to the Altium format.
I have studied the file naming conventions in PCBWay and JLCPCB and both do not recognize the .GML extension for Altium.
Extentions for gerber files can be found here :
PCBWAY : https://www.pcbway.com/helpcenter/generate_gerber/Gerber_File_Extention_from_Different_Software.html
JLCPCB : https://jlcpcb.com/help/article/4-how-to-generate-gerber-files-in-different-software

I did find mention of the .GML extension at PCBWAY in a specific EagleCAD format.
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

This would correspond to the "Board Mechanical Layer" which should have the .GM3 extension in Altium format.
I tried to simply rename the .GML to .GM3 but it didn't change anything.

Could you look into this to see if there's an error in the gerber generation?

Thanks again for your help.

73,
Arnaud

Bouledogus, 2024-04-17:
Hello Alan,

I contacted JLCPCB, he advised me to add the USBC port holes to the outline layer.
Would it be possible for you to edit the gerbers in this way so that I can test whether this solves the problem?
Thank you for your help,

73 !

alanbjohnston, 2024-04-18:
Hi Arnoud,

Yes, I will give it a try.

73,
Alan

Bouledogus, 2024-04-19:
Hello Alan,
I have started the PCB production with JLCPCB.
I made a special request to them to consider the .GML file.
They respected the request as you can see below:
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

However, it's not part of the automatic online process, so I think it would be a good idea to modify the files so that other people don't get trapped.

73 !
Arnaud

alanbjohnston, 2025-01-19:
This was fixed a while ago.  The Gerber's for the v2 Main board (was v1.3.2 STEM Payload Board) now don't include the GML file, and Gerber viewers show the USB-C slots.

73,
Alan

Closed 2025-01-19.

Thread 315 (2024-05-30):

Build of Materials OctoPart Mismatch 1x8 Header

FightFooters, 2024-05-30:
Hi Alan,

Just wanted to bring your attention that the 1x8 header in the Stem Payload Board has a mismatched part number in Octopart. This is for the new beta v1.3.2 CubeSatSim.

The Google Sheets has it as the part as PPTC081LFBN-RC, however Octopart mismatches it to PPTC061LFBN-RC, which is a 1x6 header.

73,
Ron K5SUS

alanbjohnston, 2024-05-31:
Thanks, Ron, I fixed it.

It is a database issue in Octopart.  The Matches column showed multiple choices, and one of the choices was for the 1x8 and the other was for a 1x6. Unfortunately, the one chosen by default was the incorrect 1x6 part.  This has happened a few times in the past 12 months or so.  It is annoying, but I still think Octopart is worth using, despite these issues that pop up.

Hopefully you found this issue when you were reviewing the Shopping Cart, and not after you received the shipment.

73,
Alan
KU2Y

Closed 2024-05-31.

Thread 320 (2024-06-22):

No CubeSatSim Band Pass Filter detected

Equis-X, 2024-06-22:
I've just built the cubesatsim v1.2 and for some reason I'm getting the following error message when running CubeSatSim/cubesatsim:
`...
No CubeSatSim Band Pass Filter detected.  No transmissions after the CW ID.
 See http://cubesatsim.org/wiki for info about building a CubeSatSim
...
`

And I'm sure I soldered the low pass filter to it.
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
What do I need to do for it to be detected by the software?

alanbjohnston, 2024-06-22:
Hi, please post this question on the Discussion forum and I will provide assistance.

https://github.com/alanbjohnston/CubeSatSim/discussions

Thanks,
Alan

Closed 2024-06-22.

Thread 361 (2025-02-20):

Missing images in wiki

wnew, 2025-02-20:
Firstly, thank you for sharing such a great project, the detail you provide is amazing.

I just wanted to let you know that there are images that are missing in a couple of sections in the wiki pages. I noticed them in the following sections, but there could be other.

4. Main Board 2
5. Battery Board
6. Solar Board
8. Board Stack

alanbjohnston, 2025-03-02:
Hi,

This an unfortunately a GitHub issue.  Sometimes wiki images load without issues, other times, a random image won't load.  At the same time, a different image won't load for someone else. Sometimes changing IP networks results in different images.

To work around this, I have a PDF version of the wiki page linked at the top of each page which you can download.  I try to keep the PDF in sync, but sometimes I forget with a small edit, so it's best to only use the PDFs for images.

I'm looking for an alternative wiki due to this unresolved issue that GitHub has.

Alan

Closed 2025-09-02.
