alanbjohnston/CubeSatSim/hardware/v2.1/cubesatsim-battery-v2.1.0_schematic.pdf

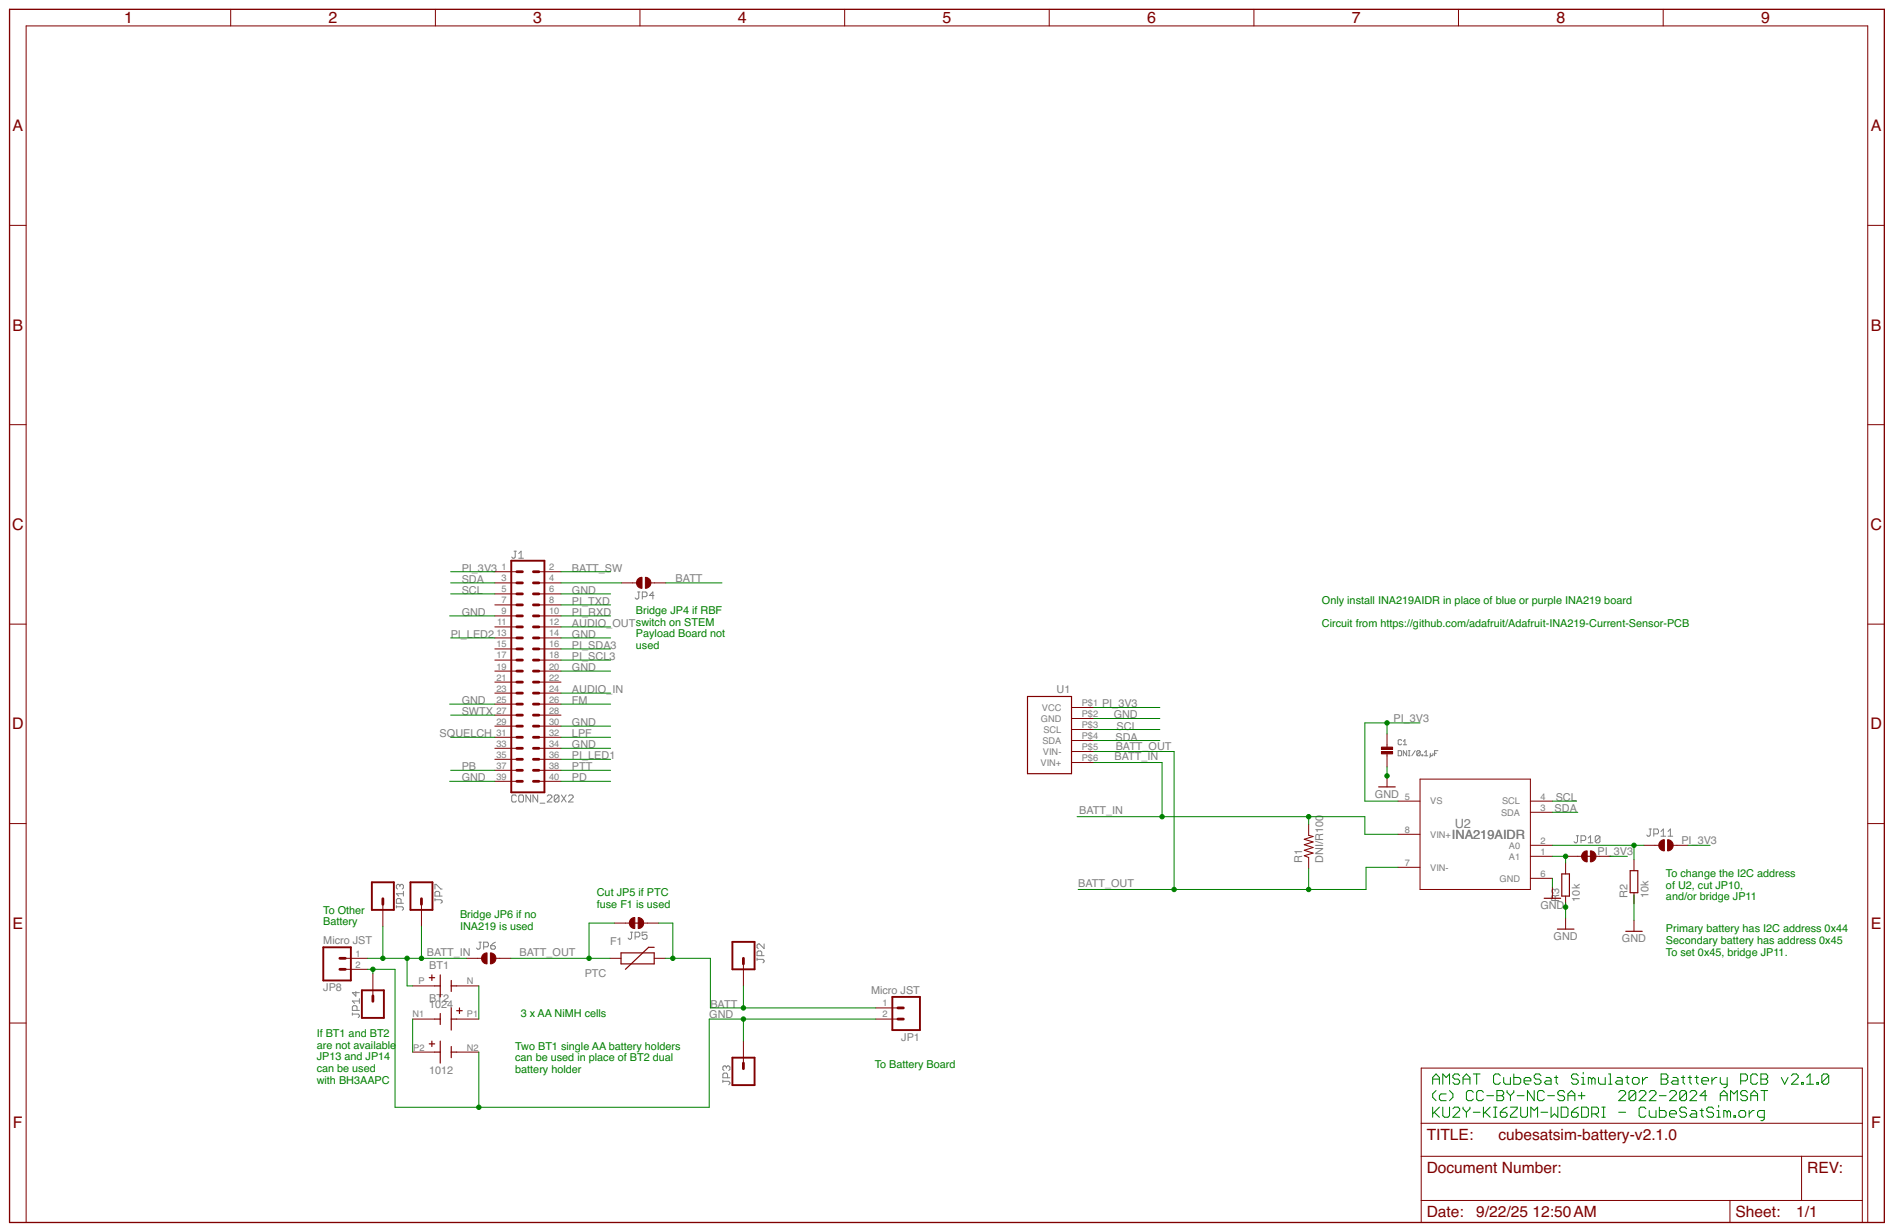
[picture p68: page 1]

SDA
GND GND GND

Only install INA219AIDR in place of blue or purple INA219 board Circuit from https://github.com/adafruit/Adafruit-INA219-Current-Sensor-PCB

Bridge JP4 if RBF
switch on STEM
Payload Board not used

Primary battery has I2C address 0x44 Secondary battery has address 0x45 To set 0x45, bridge JP11.

If BT1 and BT2
are not available
JP13 and JP14
can be used with BH3AAPC

Two BT1 single AA battery holders
can be used in place of BT2 dual battery holder
