alanbjohnston/CubeSatSim/hardware/v2.1/cubesatsim-solar-v2.1.0_schematic.pdf

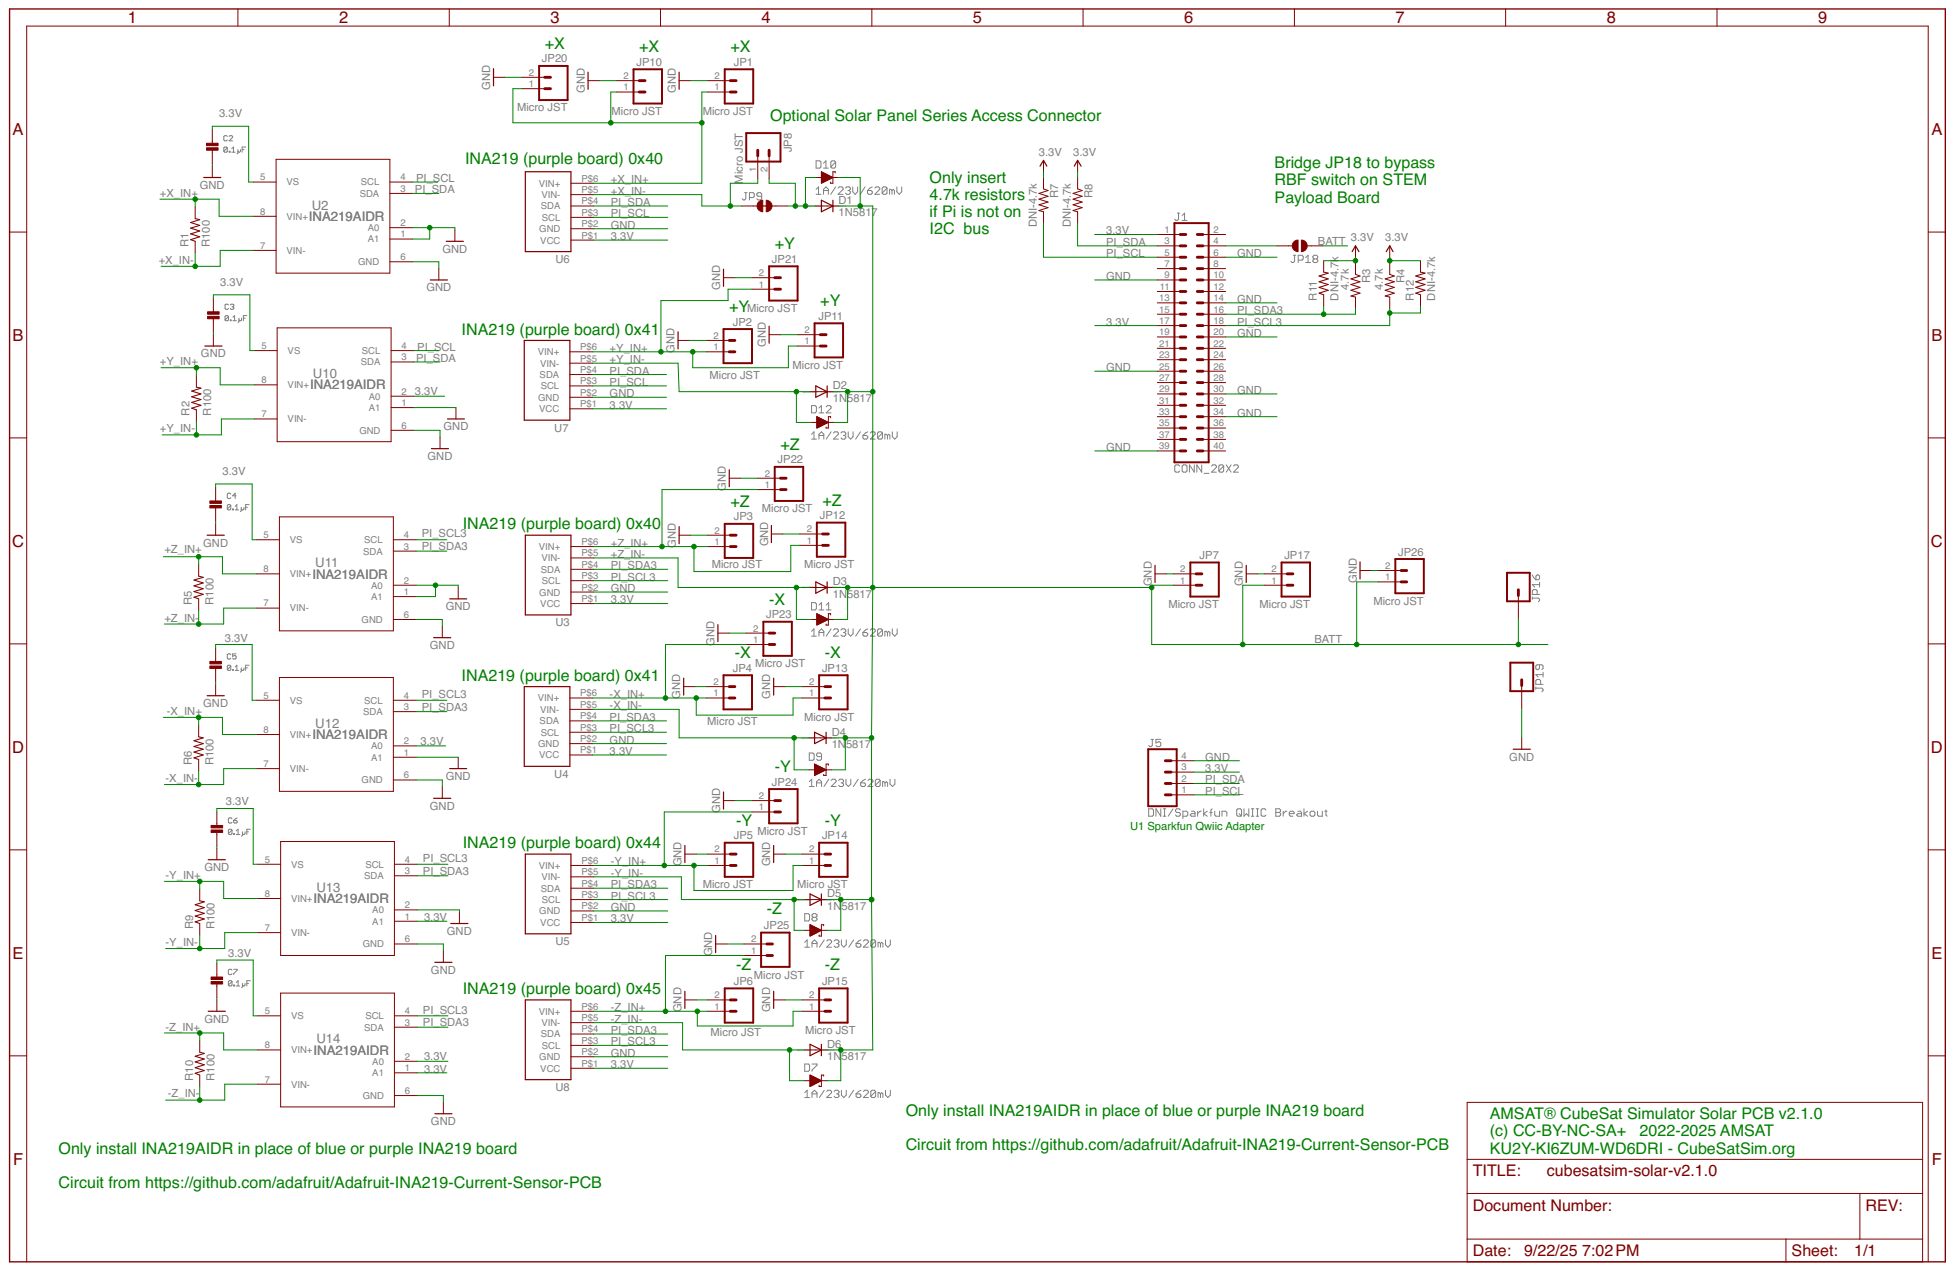
[picture p69: page 1]

4.7k 4.7k 3.3V 3.3V DNI-4.7k DNI-4.7k 3.3V 3.3V Micro JST GND Micro JST

Optional Solar Panel Series Access Connector Only insert 4.7k resistors

Bridge JP18 to bypass RBF switch on STEM

if Pi is not on
I2C bus

PI_SDA
GND GND GND

GND GND GND GND GND

Only install INA219AIDR in place of blue or purple INA219 board

AMSAT® CubeSat Simulator Solar PCB v2.1.0
(c) CC-BY-NC-SA+ 2022-2025 AMSAT
KU2Y-KI6ZUM-WD6DRI - CubeSatSim.org

Circuit from https://github.com/adafruit/Adafruit-INA219-Current-Sensor-PCB
