alanbjohnston/CubeSatSim/hardware/v2.1/cubesatsim-main-v2.1.0_schematic.pdf

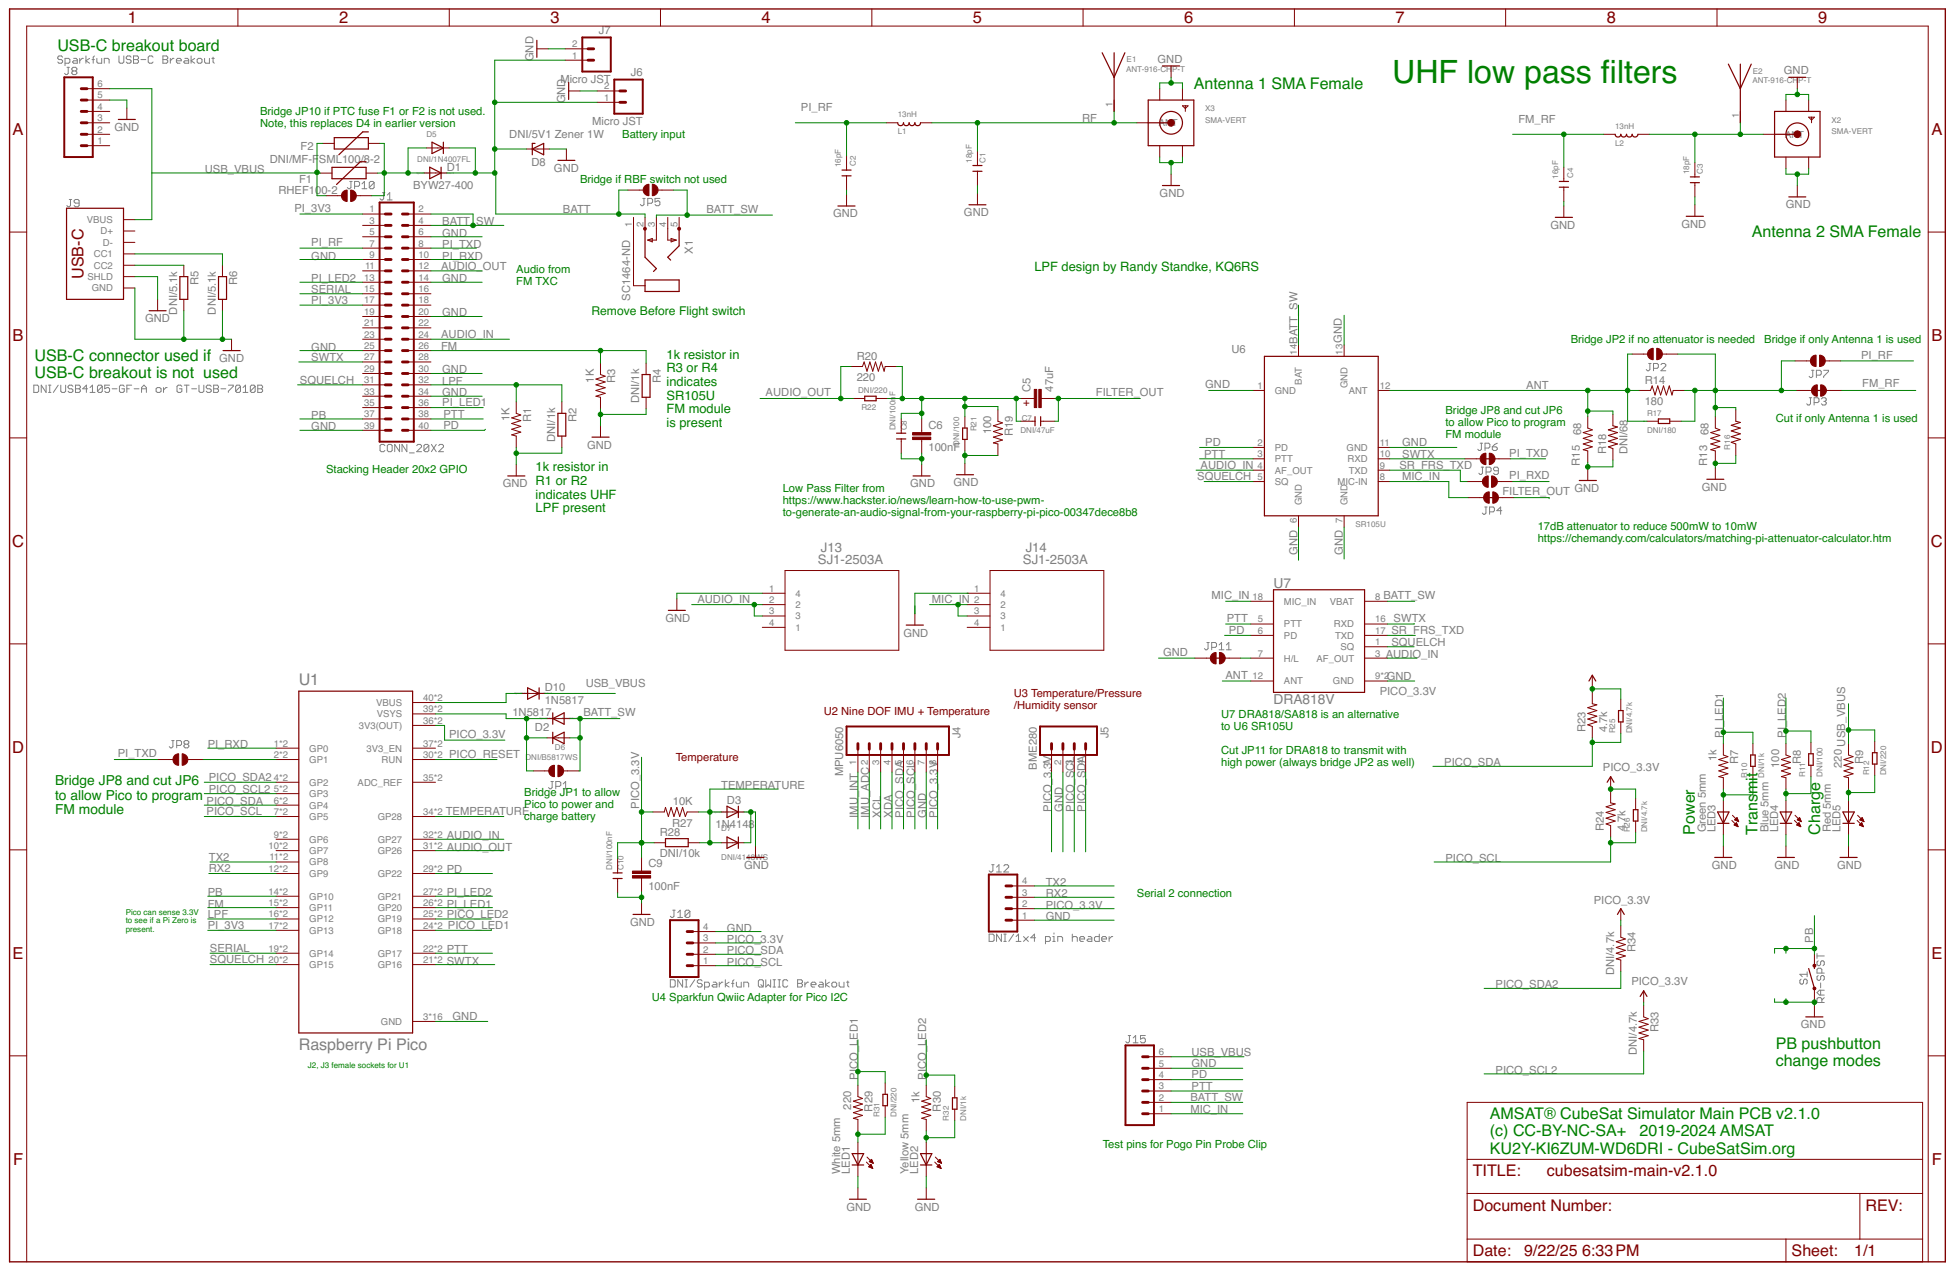
[picture p70: page 1]

Bridge JP10 if PTC fuse F1 or F2 is not used. Note, this replaces D4 in earlier version

LPF design by Randy Standke, KQ6RS

Remove Before Flight switch

USB-C connector used if
USB-C breakout is not used

Bridge JP2 if no attenuator is needed

Bridge if only Antenna 1 is used

Bridge JP8 and cut JP6
to allow Pico to program
FM module

Cut if only Antenna 1 is used

Low Pass Filter from
https://www.hackster.io/news/learn-how-to-use-pwm-
to-generate-an-audio-signal-from-your-raspberry-pi-pico-00347dece8b8

17dB attenuator to reduce 500mW to 10mW
https://chemandy.com/calculators/matching-pi-attenuator-calculator.htm

Cut JP11 for DRA818 to transmit with
high power (always bridge JP2 as well)

Bridge JP1 to allow
Pico to power and
charge battery

U4 Sparkfun Qwiic Adapter for Pico I2C

AMSAT® CubeSat Simulator Main PCB v2.1.0
(c) CC-BY-NC-SA+ 2019-2024 AMSAT
KU2Y-KI6ZUM-WD6DRI - CubeSatSim.org
