alanbjohnston/CubeSatSim/hardware/beta-v1.3.2/cubesatsim-battery-b1.3.2.2_schematic.pdf

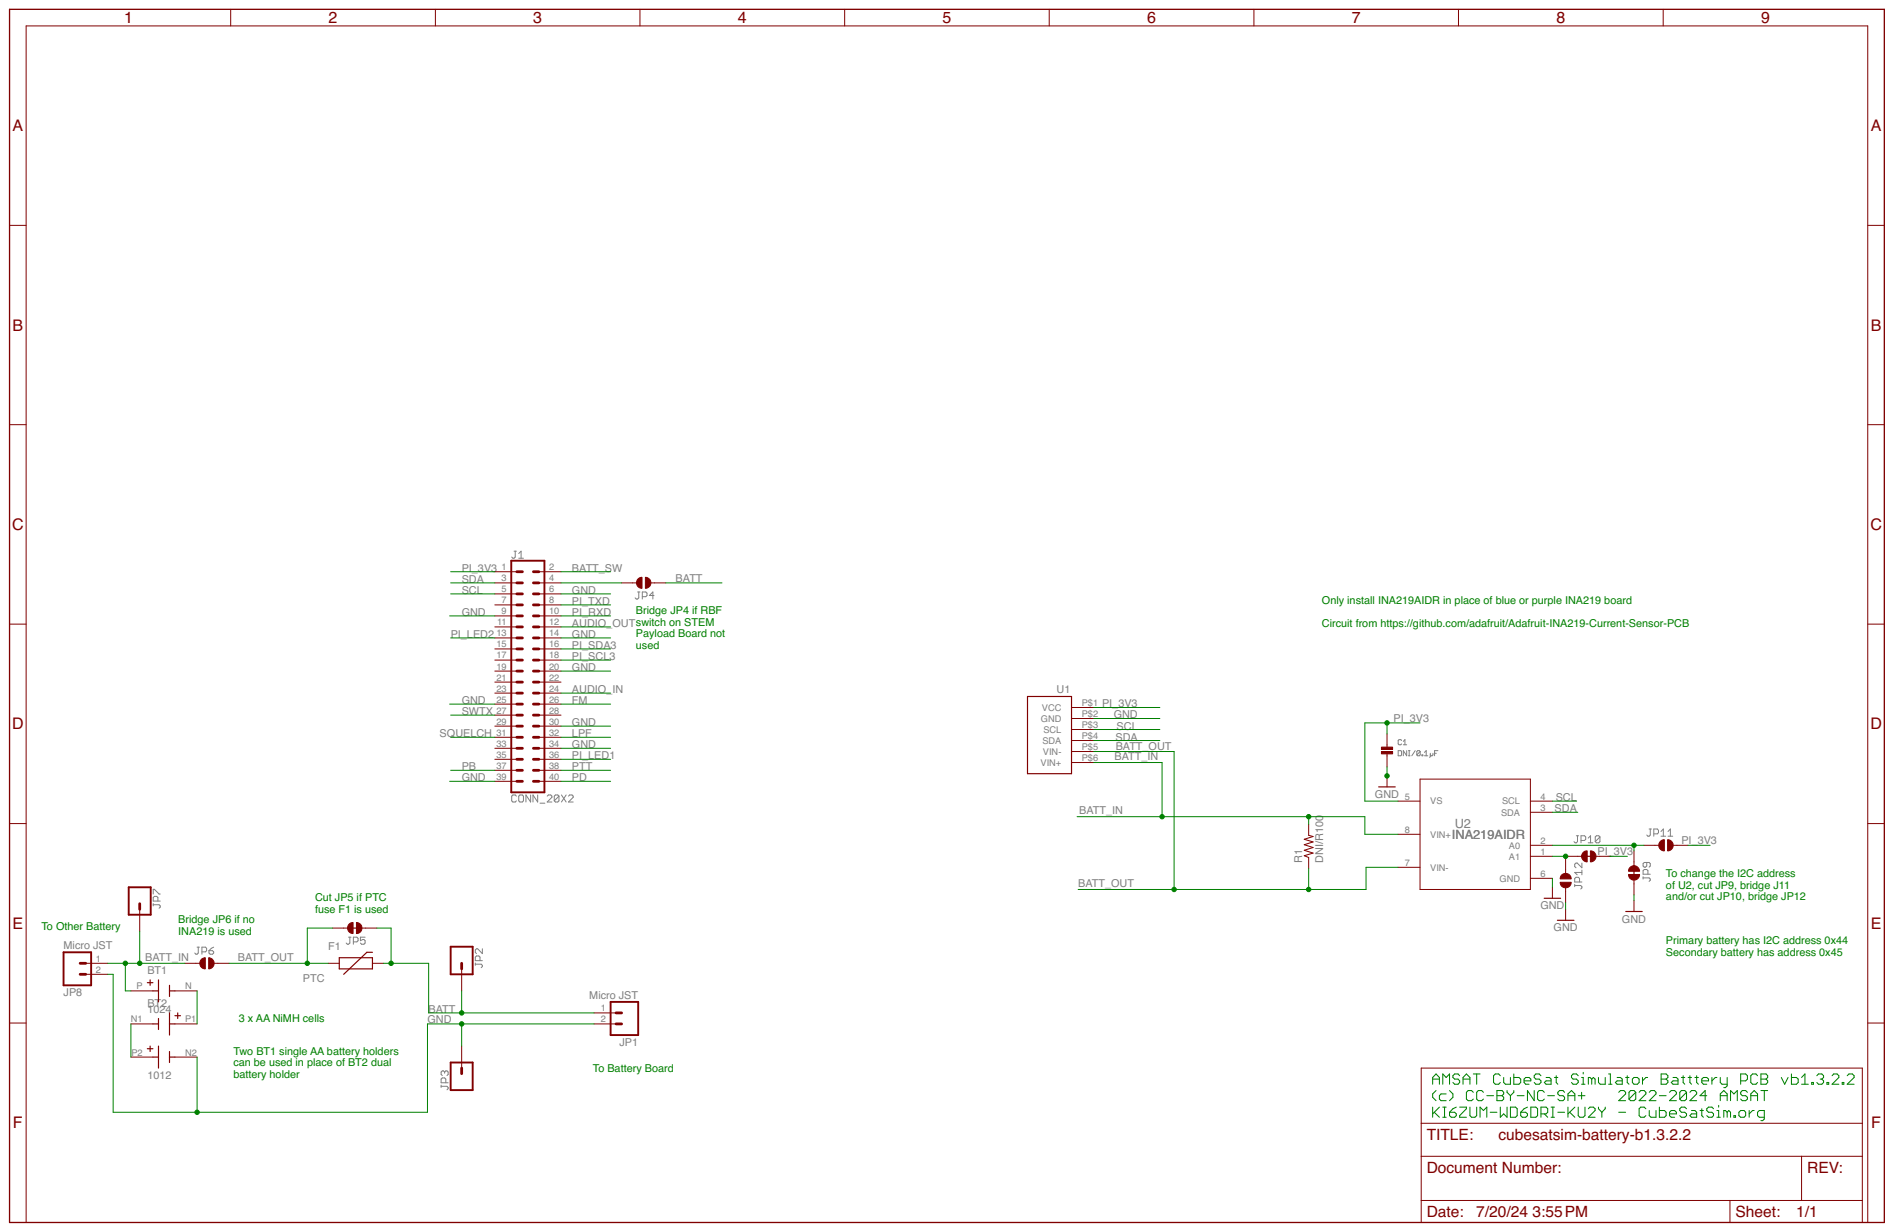
[picture p71: page 1]

SDA
GND GND GND

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

Bridge JP4 if RBF
switch on STEM
Payload Board not used

and/or cut JP10, bridge JP12

Primary battery has I2C address 0x44 Secondary battery has address 0x45

Two BT1 single AA battery holders
can be used in place of BT2 dual battery holder
