alanbjohnston/CubeSatSim/hardware/beta-v1.3.2/cubesatsim-STEM-b1.3.2.1_schematic.pdf

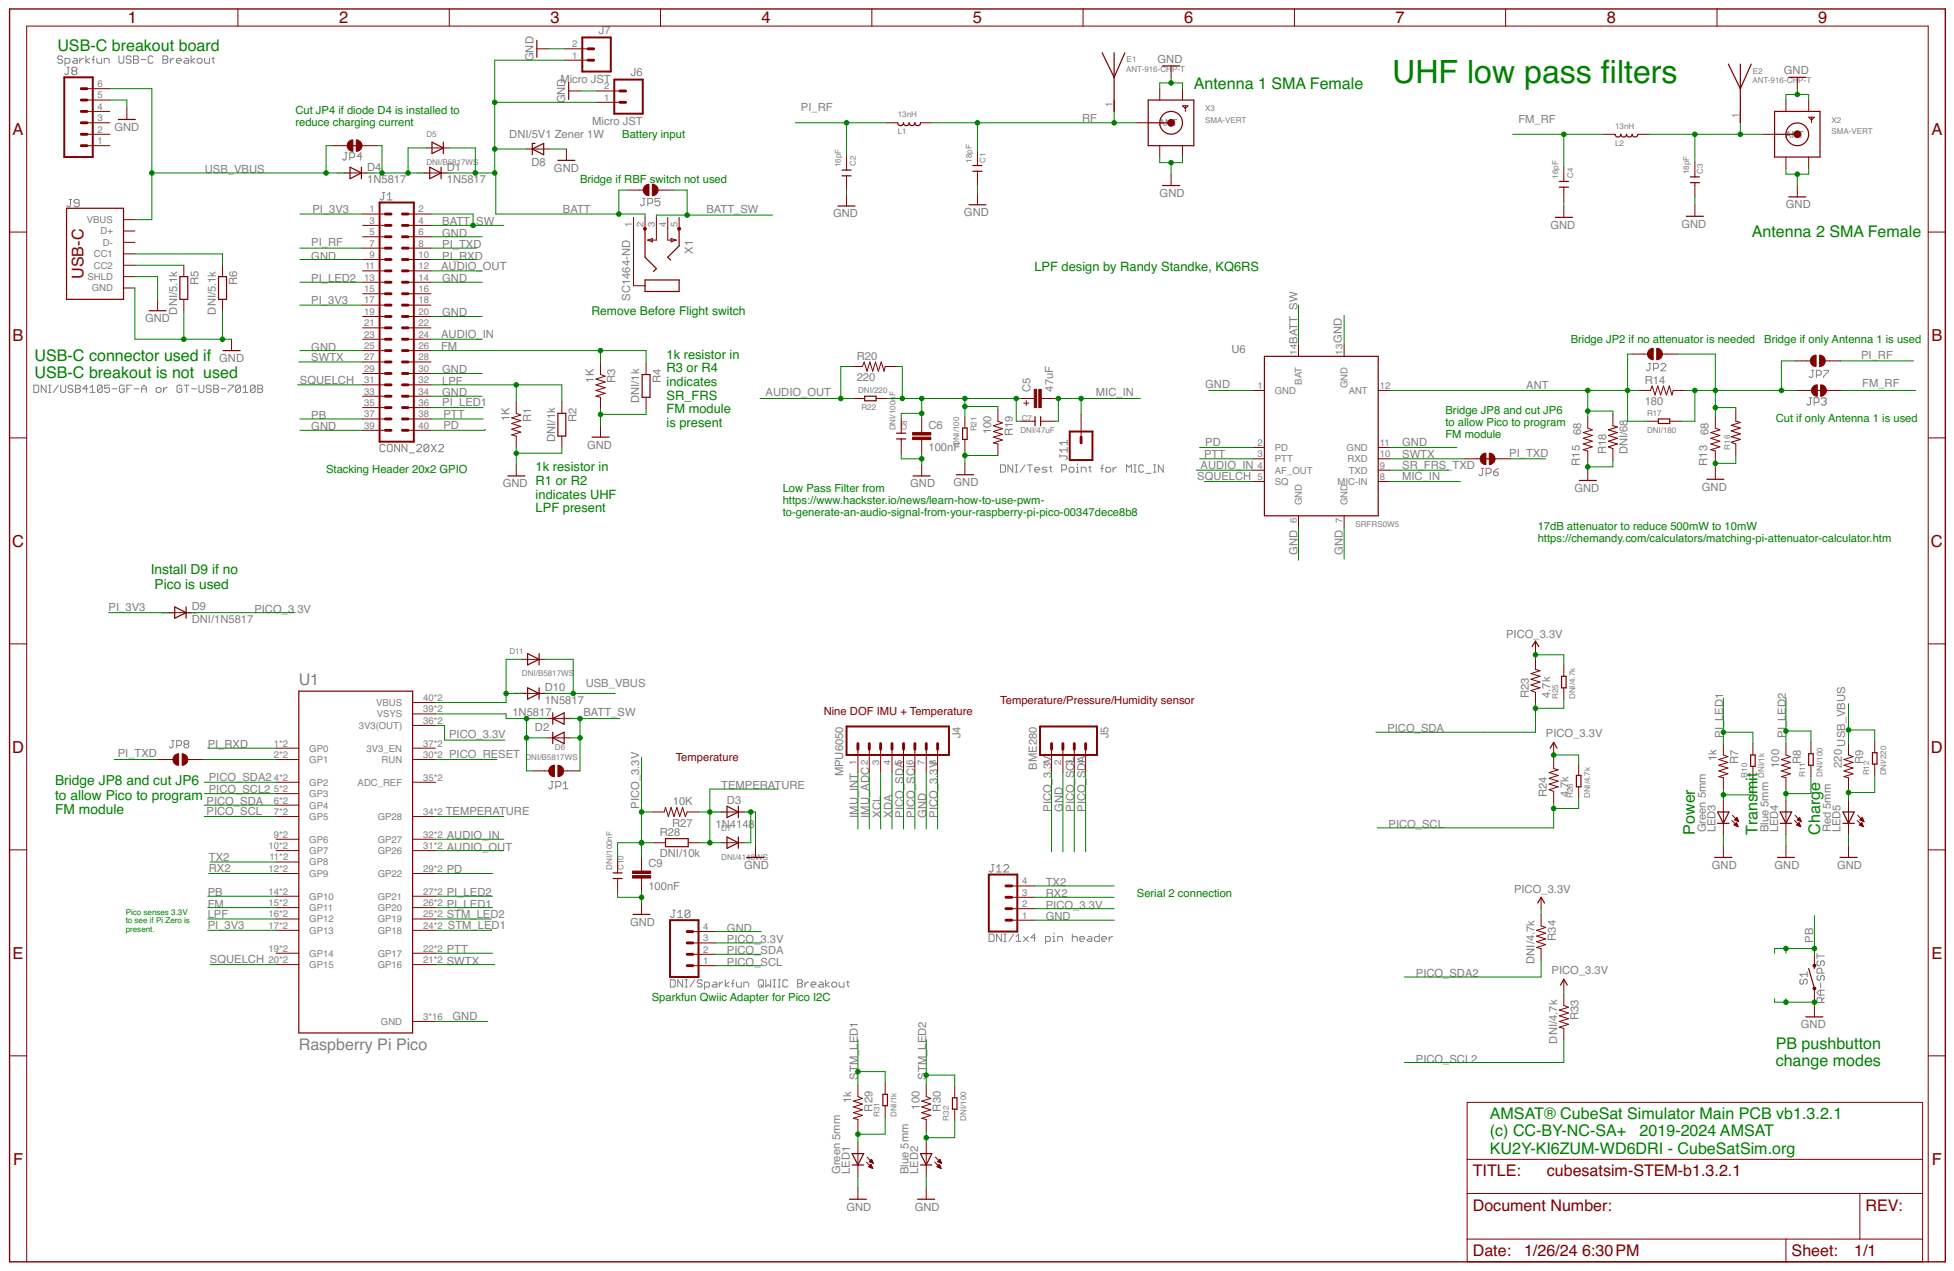
[picture p72: page 1]

Cut JP4 if diode D4 is installed to
reduce charging current

GND GND GND
GND

LPF design by Randy Standke, KQ6RS

Remove Before Flight switch

USB-C connector used if
USB-C breakout is not used

Bridge JP2 if no attenuator is needed

Bridge if only Antenna 1 is used

Bridge JP8 and cut JP6
to allow Pico to program
FM module

Cut if only Antenna 1 is used

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

17dB attenuator to reduce 500mW to 10mW
https://chemandy.com/calculators/matching-pi-attenuator-calculator.htm

Install D9 if no Pico is used

Temperature/Pressure/Humidity sensor

Nine DOF IMU + Temperature Temperature

Sparkfun Qwiic Adapter for Pico I2C

AMSAT® CubeSat Simulator Main PCB vb1.3.2.1
(c) CC-BY-NC-SA+ 2019-2024 AMSAT
KU2Y-KI6ZUM-WD6DRI - CubeSatSim.org
