alanbjohnston/CubeSatSim/hardware/vB7/cubesat-sim-0.7_schematic.pdf

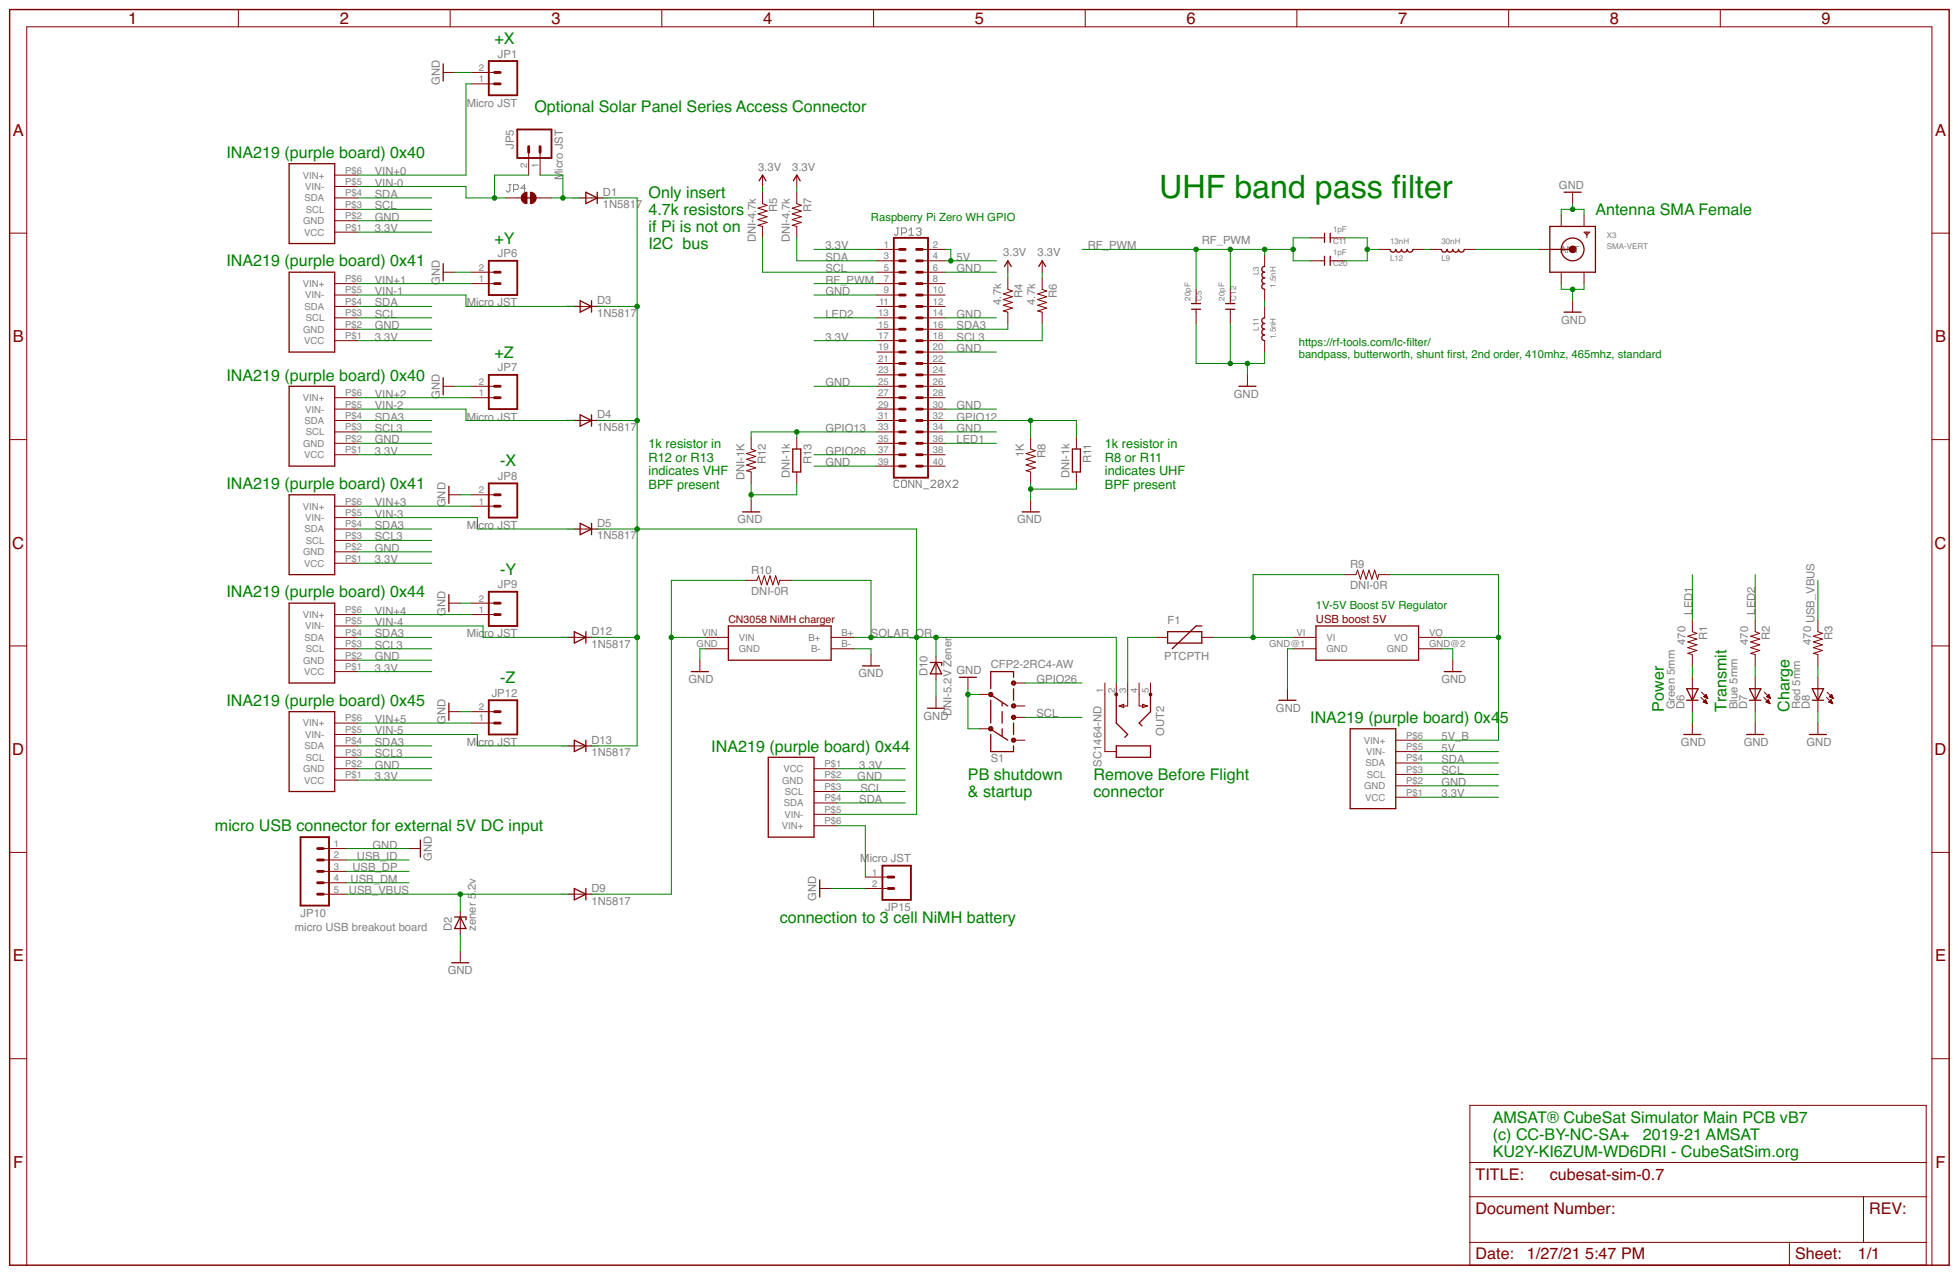
[picture p73: page 1]

Optional Solar Panel Series Access Connector Only insert

UHF band pass filter

Raspberry Pi Zero WH GPIO

Micro JST Micro JST Micro JST Micro JST Micro JST

GND GND GND GND GND

https://rf-tools.com/lc-filter/ bandpass, butterworth, shunt first, 2nd order, 410mhz, 465mhz, standard

indicates UHF BPF present 1k resistor in R12 or R13

indicates VHF BPF present

Remove Before Flight connector micro USB connector for external 5V DC input

micro USB breakout board

connection to 3 cell NiMH battery

AMSAT® CubeSat Simulator Main PCB vB7
(c) CC-BY-NC-SA+ 2019-21 AMSAT
KU2Y-KI6ZUM-WD6DRI - CubeSatSim.org

REV: TITLE: Document Number: cubesat-sim-0.7

Date: 1/27/21 5:47 PM | Sheet: 1/1
