alanbjohnston/CubeSatSim/hardware/vB7/cubesat-sim-battery-0.4_schematic.pdf

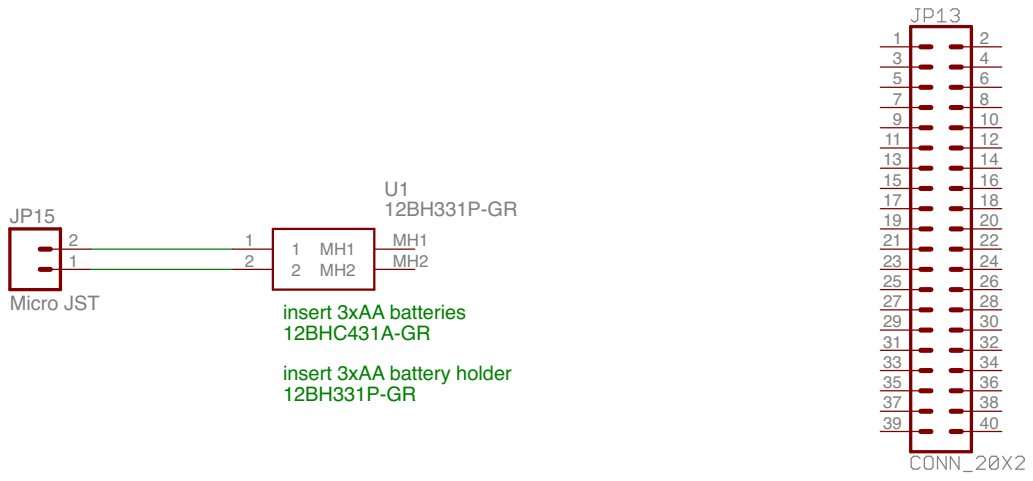
[picture p74: page 1]

insert 3xAA battery holder 12BH331P-GR

REV: TITLE: Document Number: cubesat-sim-battery-0.4

Date: 1/28/21 12:13 PM | Sheet: 1/1

1/28/21 1:19 PM f=0.67 /Users/alan/Documents/EAGLE/cubesat-sim-battery-0.4/cubesat-sim-battery-0.4.sch (Sheet: 1/1)
