alanbjohnston/CubeSatSim/hardware/vB7/cubesat-sim-lite-0.2_schematic.pdf

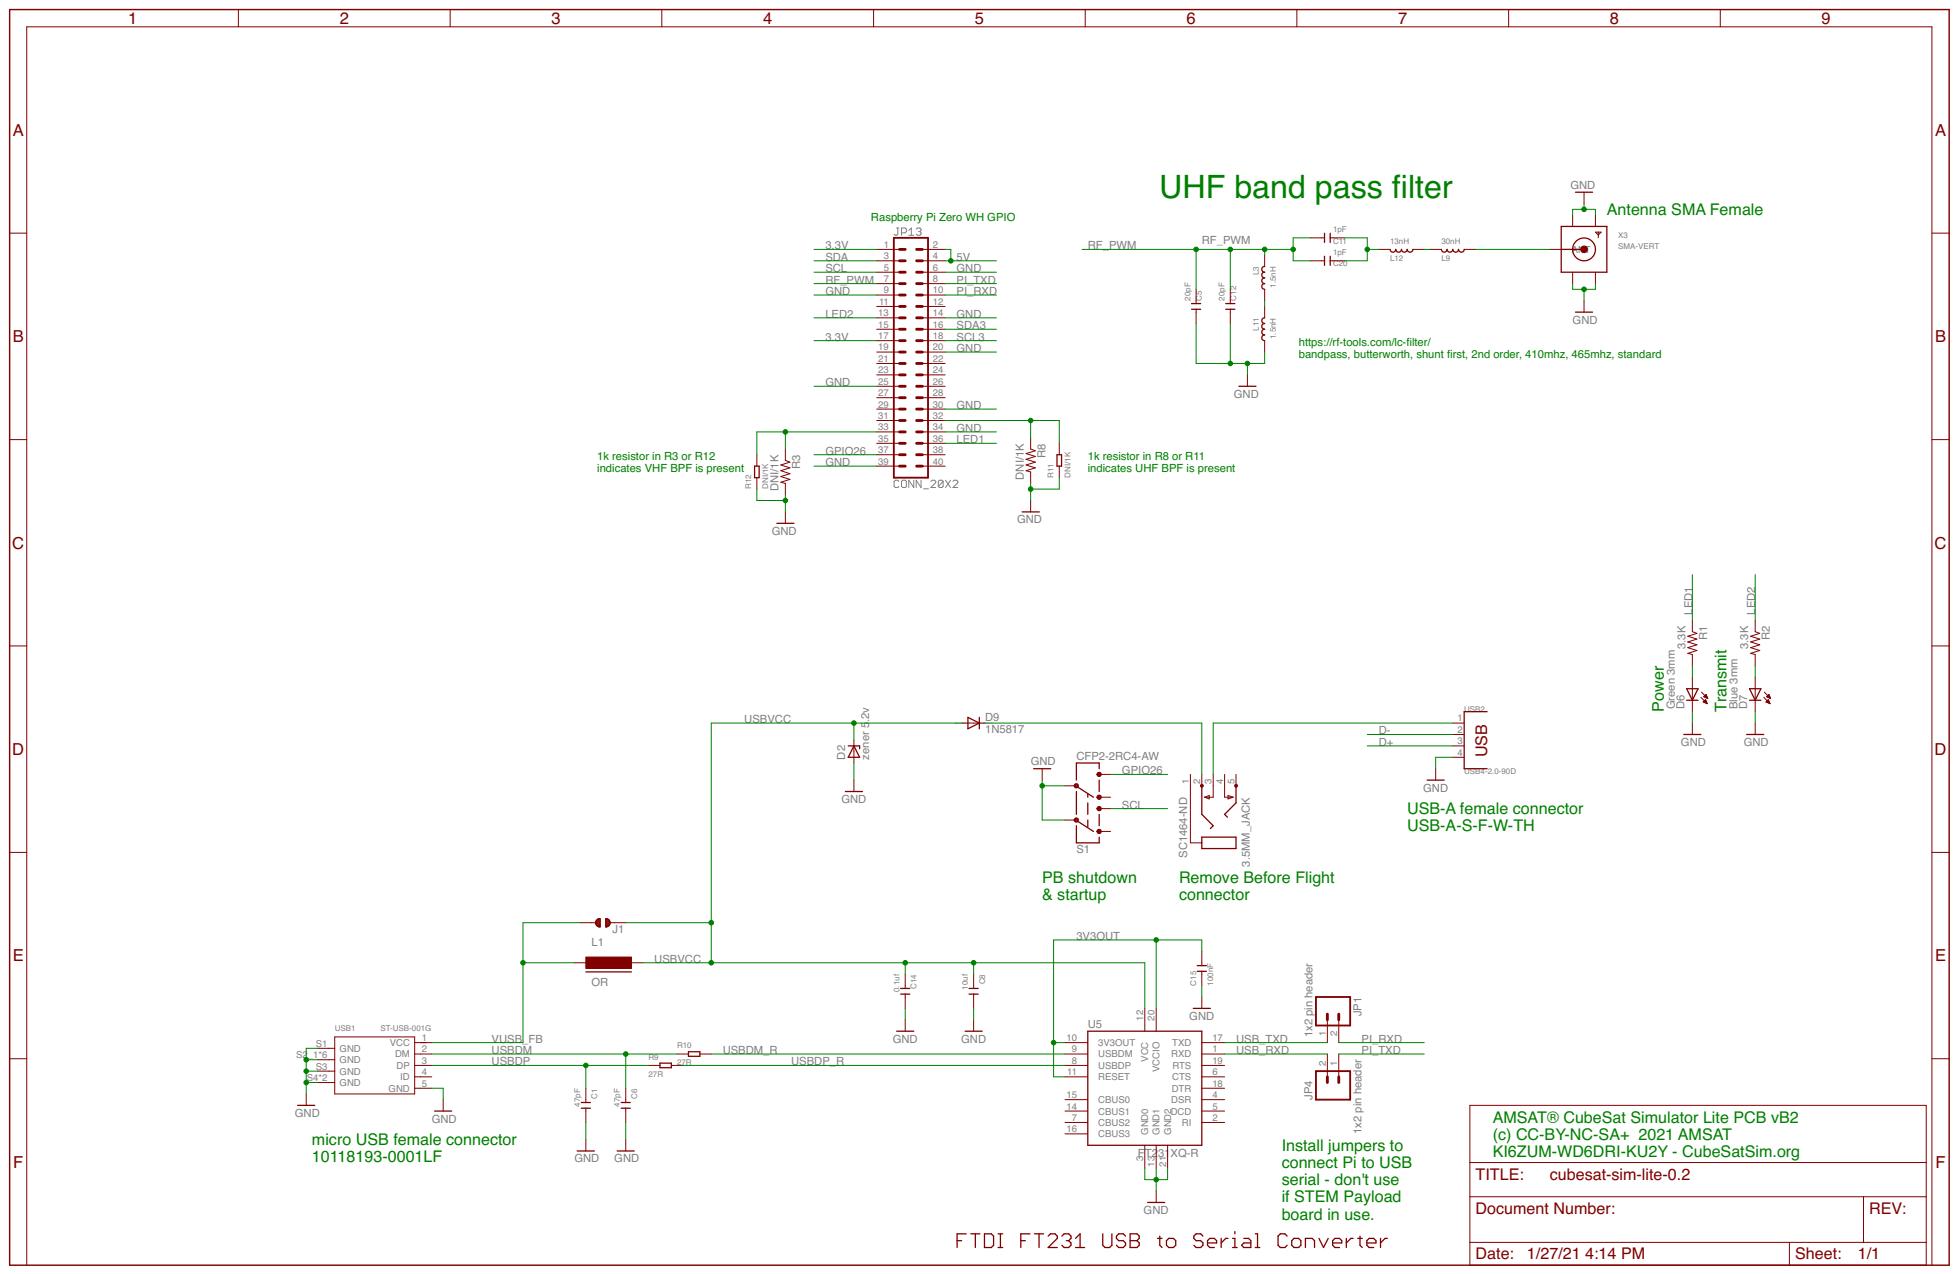
[picture p75: page 1]

UHF band pass filter

Raspberry Pi Zero WH GPIO

https://rf-tools.com/lc-filter/ bandpass, butterworth, shunt first, 2nd order, 410mhz, 465mhz, standard

35 | | 36 LED1

indicates UHF BPF is present 1k resistor in R3 or R12
indicates VHF BPF is present

GND
USB-A female connector USB-A-S-F-W-TH

Remove Before Flight connector PB shutdown & startup

1x2 pin header

micro USB female connector 10118193-0001LF

AMSAT® CubeSat Simulator Lite PCB vB2
(c) CC-BY-NC-SA+ 2021 AMSAT
KI6ZUM-WD6DRI-KU2Y - CubeSatSim.org

Install jumpers to
connect Pi to USB
serial - don't use
if STEM Payload
board in use.

REV: TITLE: Document Number: cubesat-sim-lite-0.2

Date: 1/27/21 4:14 PM | Sheet: 1/1
