alanbjohnston/CubeSatSim/hardware/vB7/cubesat-sim-STEM-0.4_schematic.pdf

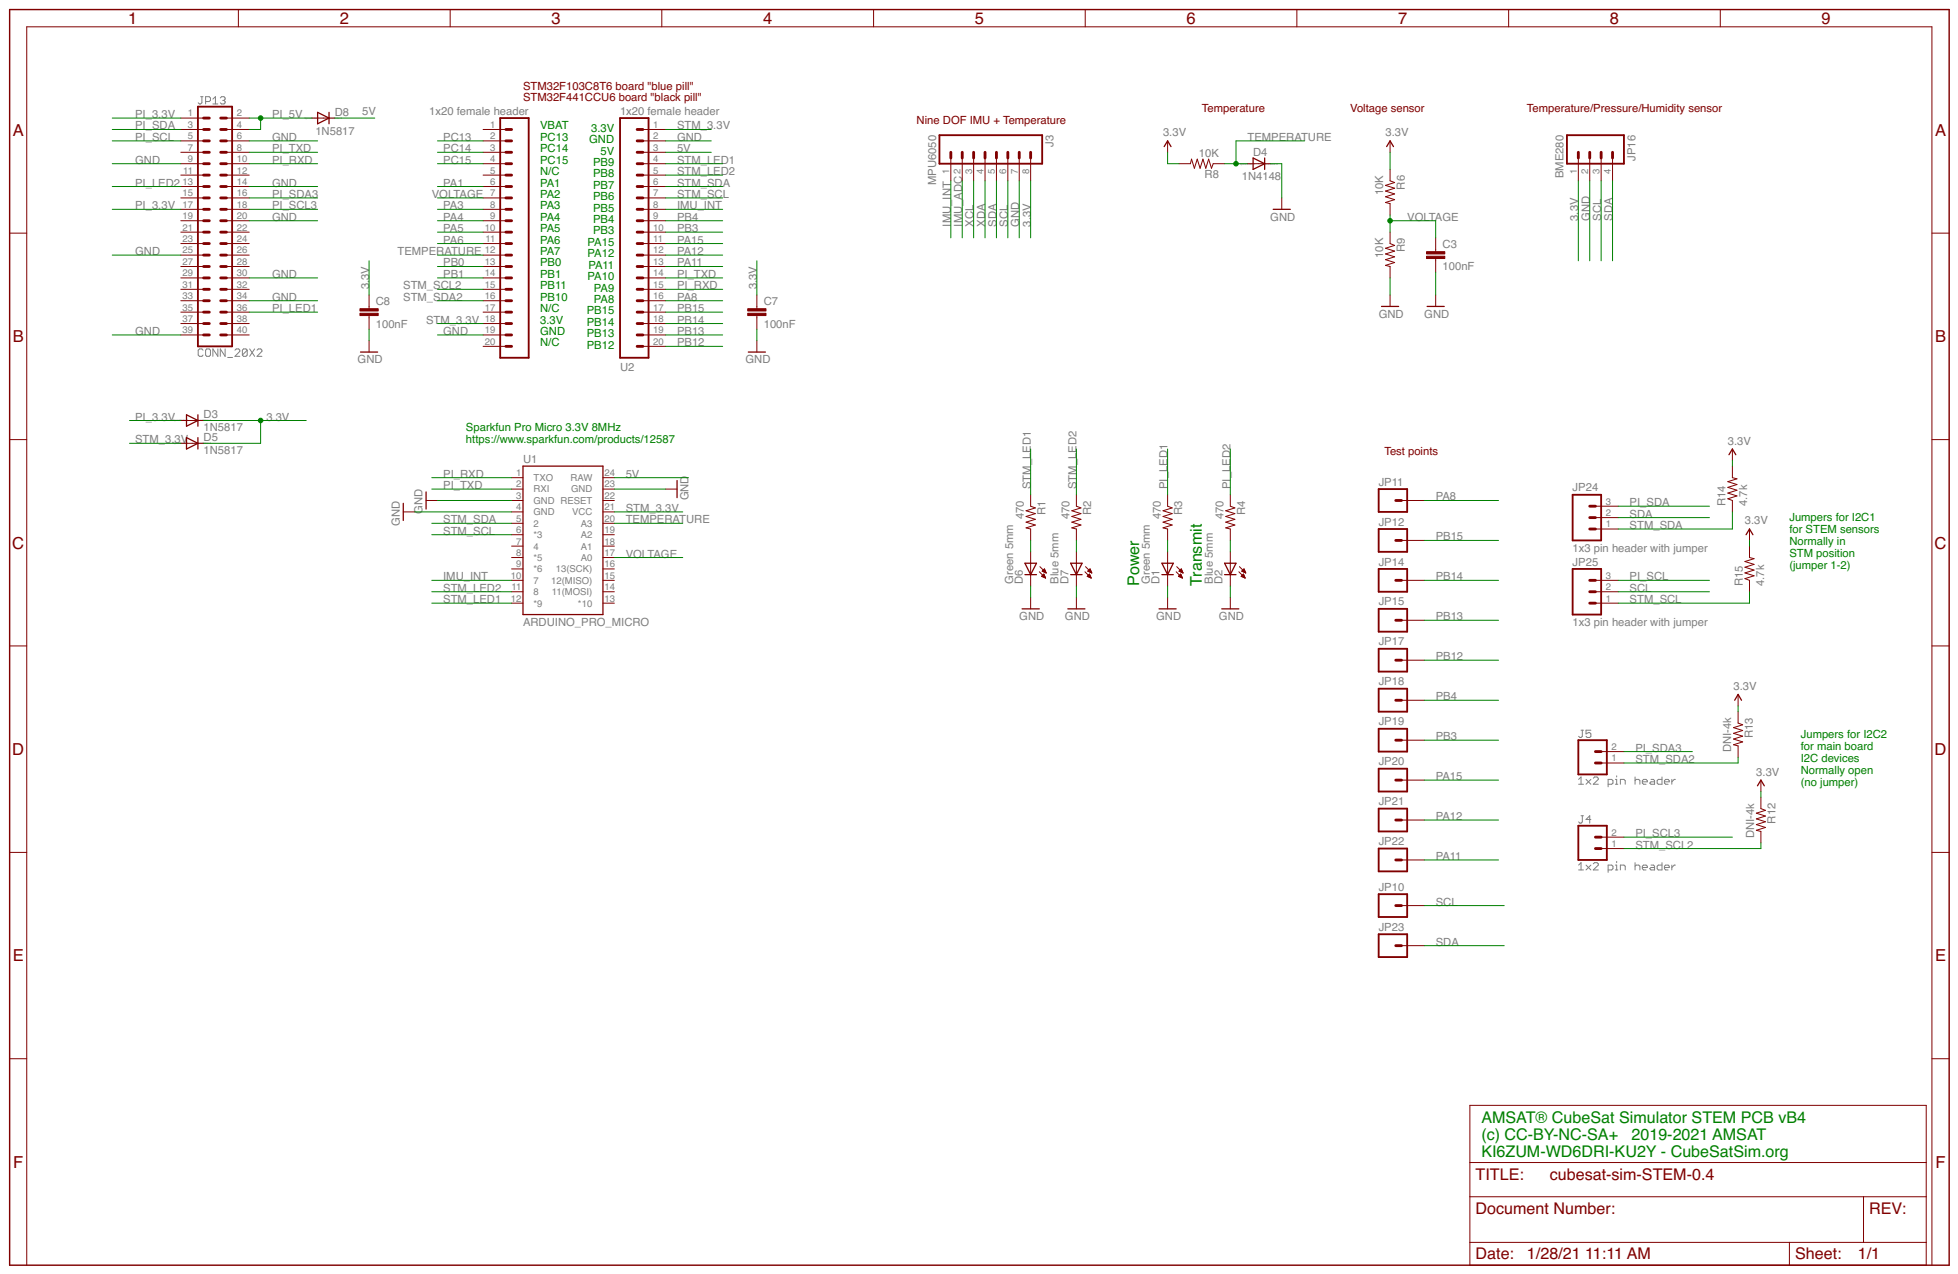
[picture p76: page 1]

Sparkfun Pro Micro 3.3V 8MHz https://www.sparkfun.com/products/12587

Jumpers for I2C1
for STEM sensors Normally in STM position

AMSAT® CubeSat Simulator STEM PCB vB4
(c) CC-BY-NC-SA+ 2019-2021 AMSAT
KI6ZUM-WD6DRI-KU2Y - CubeSatSim.org

REV: TITLE: Document Number: cubesat-sim-STEM-0.4

Date: 1/28/21 11:11 AM | Sheet: 1/1
