alanbjohnston/CubeSatSim/hardware/vB5/cubesat-sim-0.3_schematic.pdf

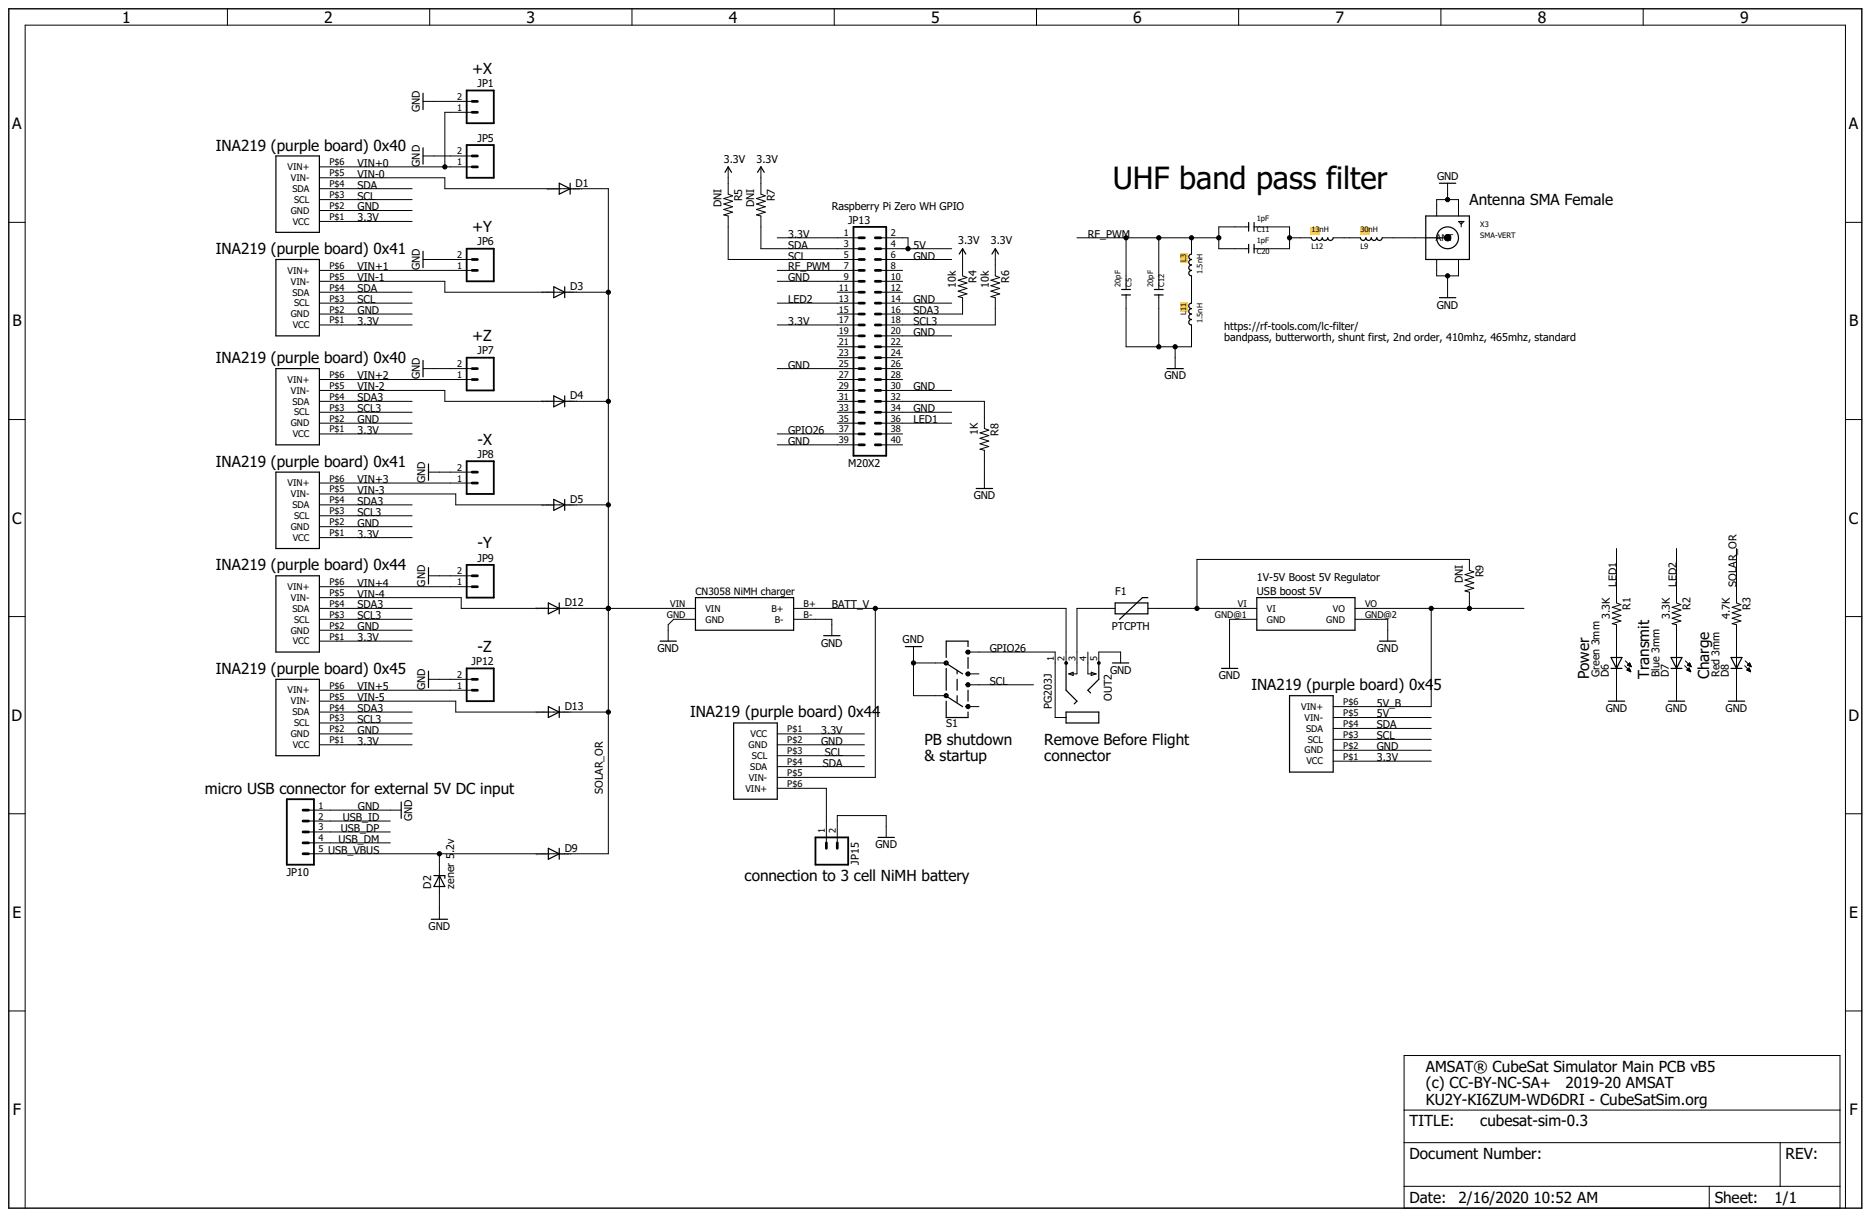
[picture p77: page 1]

UHF band pass filter

https://rf-tools.com/lc-filter/ bandpass, butterworth, shunt first, 2nd order, 410mhz, 465mhz, standard

connection to 3 cell NiMH battery

AMSAT® CubeSat Simulator Main PCB vB5
(c) CC-BY-NC-SA+ 2019-20 AMSAT KU2Y-KI6ZUM-WD6DRI - CubeSatSim.org
