alanbjohnston/CubeSatSim/hardware/vB5/cubesat-sim-STEM-0.2_schematic.pdf

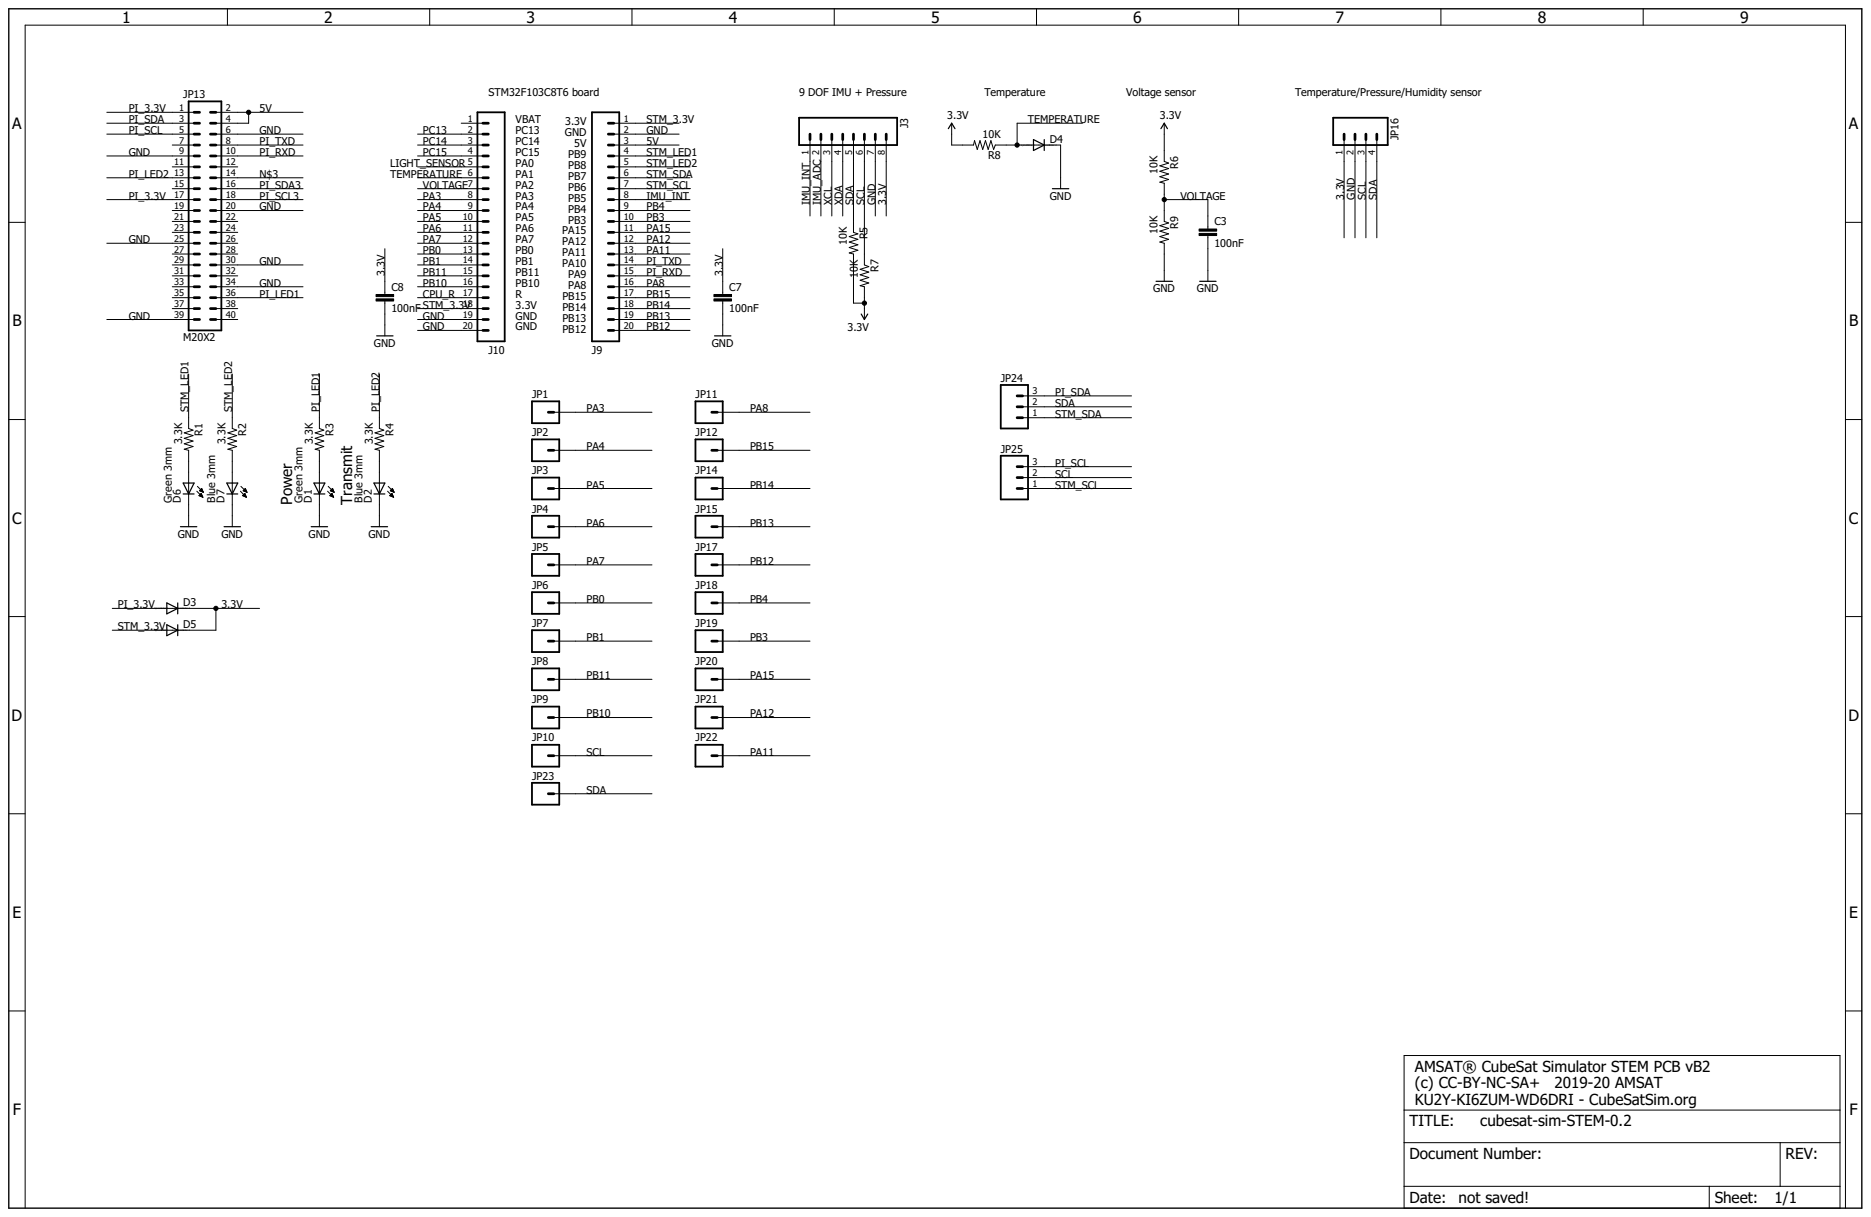
[picture p78: page 1]

AMSAT® CubeSat Simulator STEM PCB vB2
(c) CC-BY-NC-SA+ 2019-20 AMSAT KU2Y-KI6ZUM-WD6DRI - CubeSatSim.org
