alanbjohnston/CubeSatSim/hardware/lite/v2/cubesatsim-Lite-v2.0.1_schematic.pdf

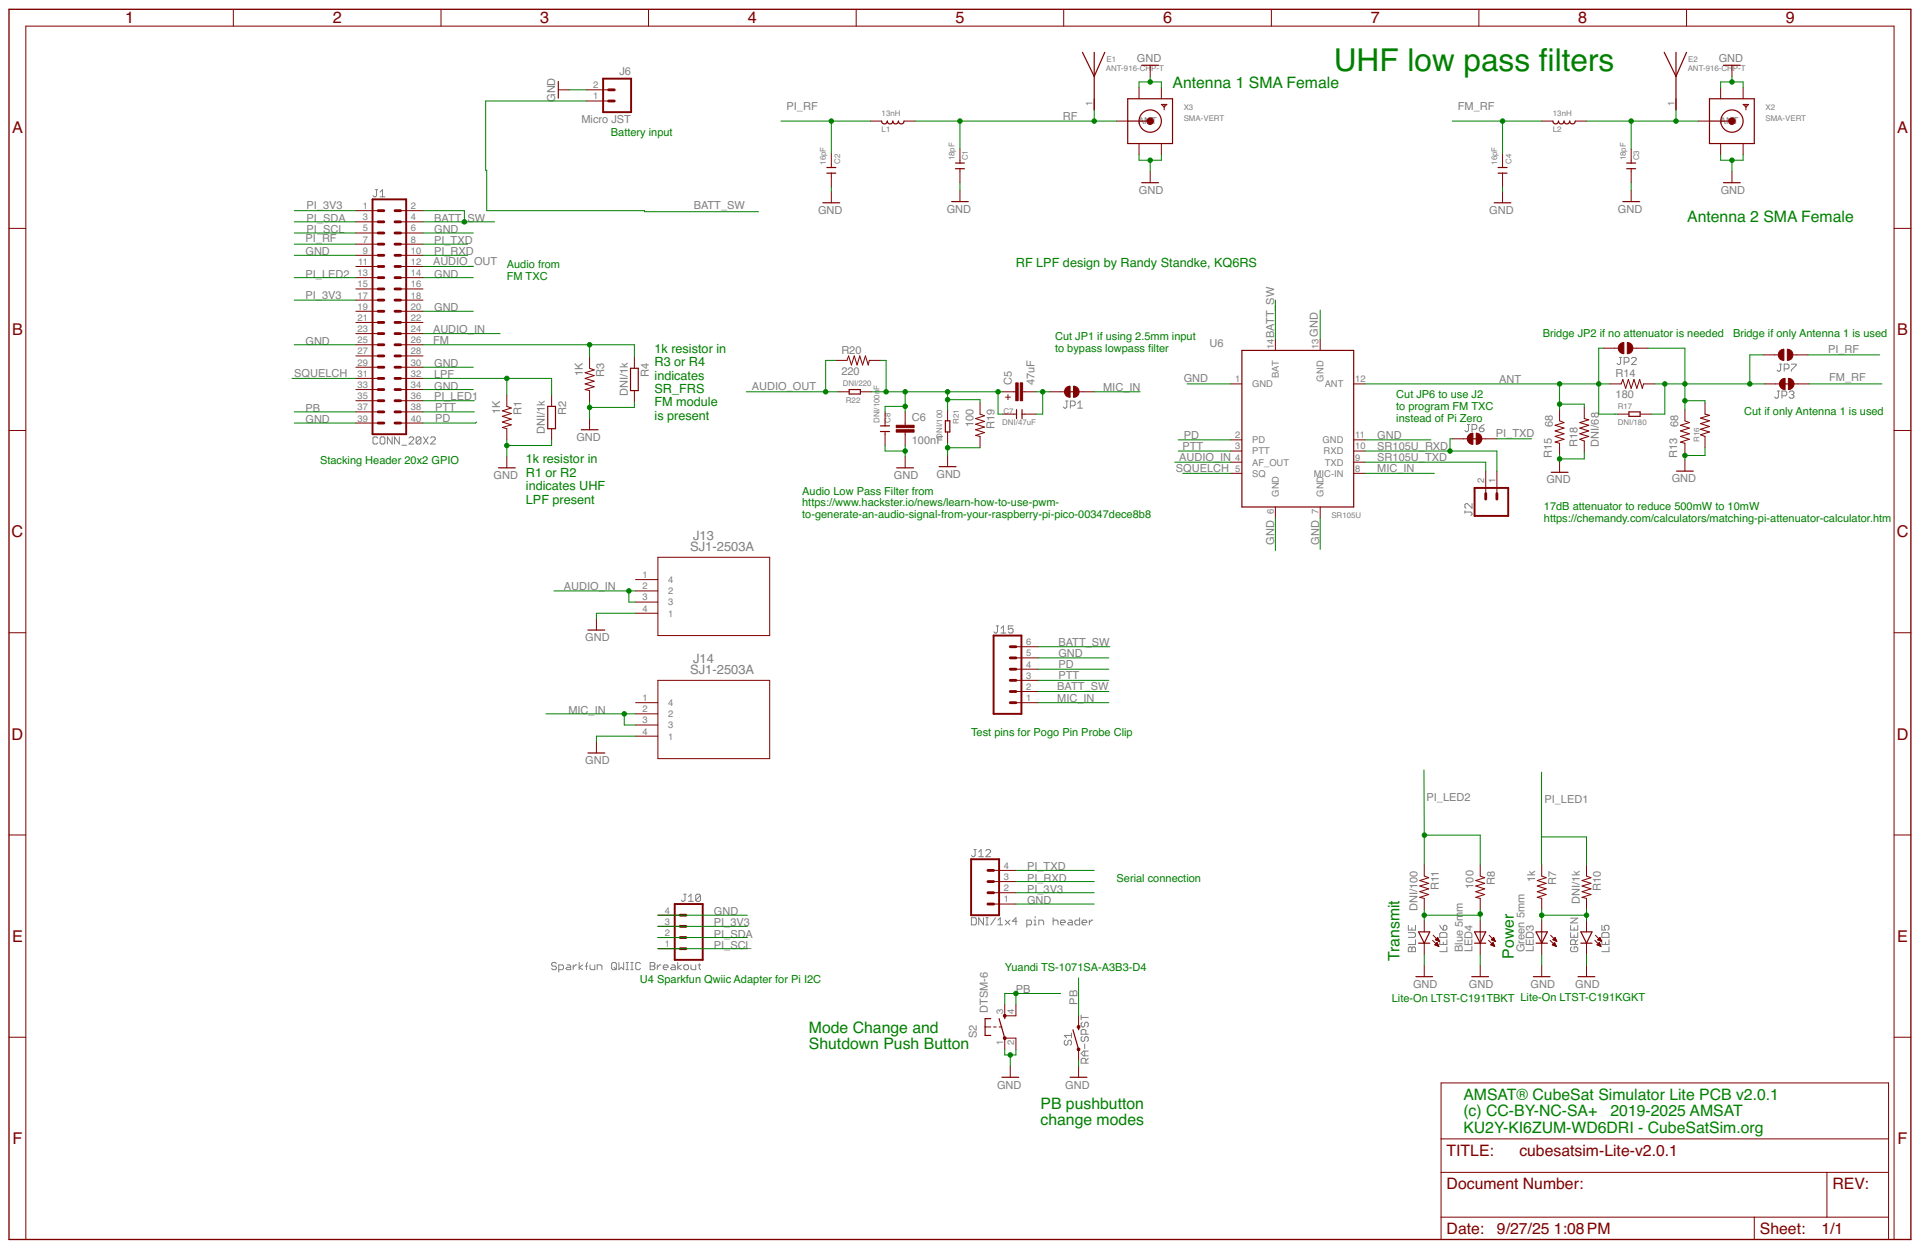
[picture p79: page 1]

UHF low pass filters

DNI/1k Micro JST GND

RF LPF design by Randy Standke, KQ6RS

Cut JP1 if using 2.5mm input
to bypass lowpass filter

Bridge JP2 if no attenuator is needed Bridge if only Antenna 1 is used Cut JP6 to use J2

to program FM TXC
instead of Pi Zero

Cut if only Antenna 1 is used

Audio Low Pass Filter from
https://www.hackster.io/news/learn-how-to-use-pwm-
to-generate-an-audio-signal-from-your-raspberry-pi-pico-00347dece8b8

17dB attenuator to reduce 500mW to 10mW
https://chemandy.com/calculators/matching-pi-attenuator-calculator.htm

Test pins for Pogo Pin Probe Clip

U4 Sparkfun Qwiic Adapter for Pi I2C

Lite-On LTST-C191TBKT Lite-On LTST-C191KGKT

AMSAT® CubeSat Simulator Lite PCB v2.0.1
(c) CC-BY-NC-SA+ 2019-2025 AMSAT
KU2Y-KI6ZUM-WD6DRI - CubeSatSim.org
