alanbjohnston/CubeSatSim/hardware/lite/vB5/cubesatsim-lite-0.5_schematic.pdf

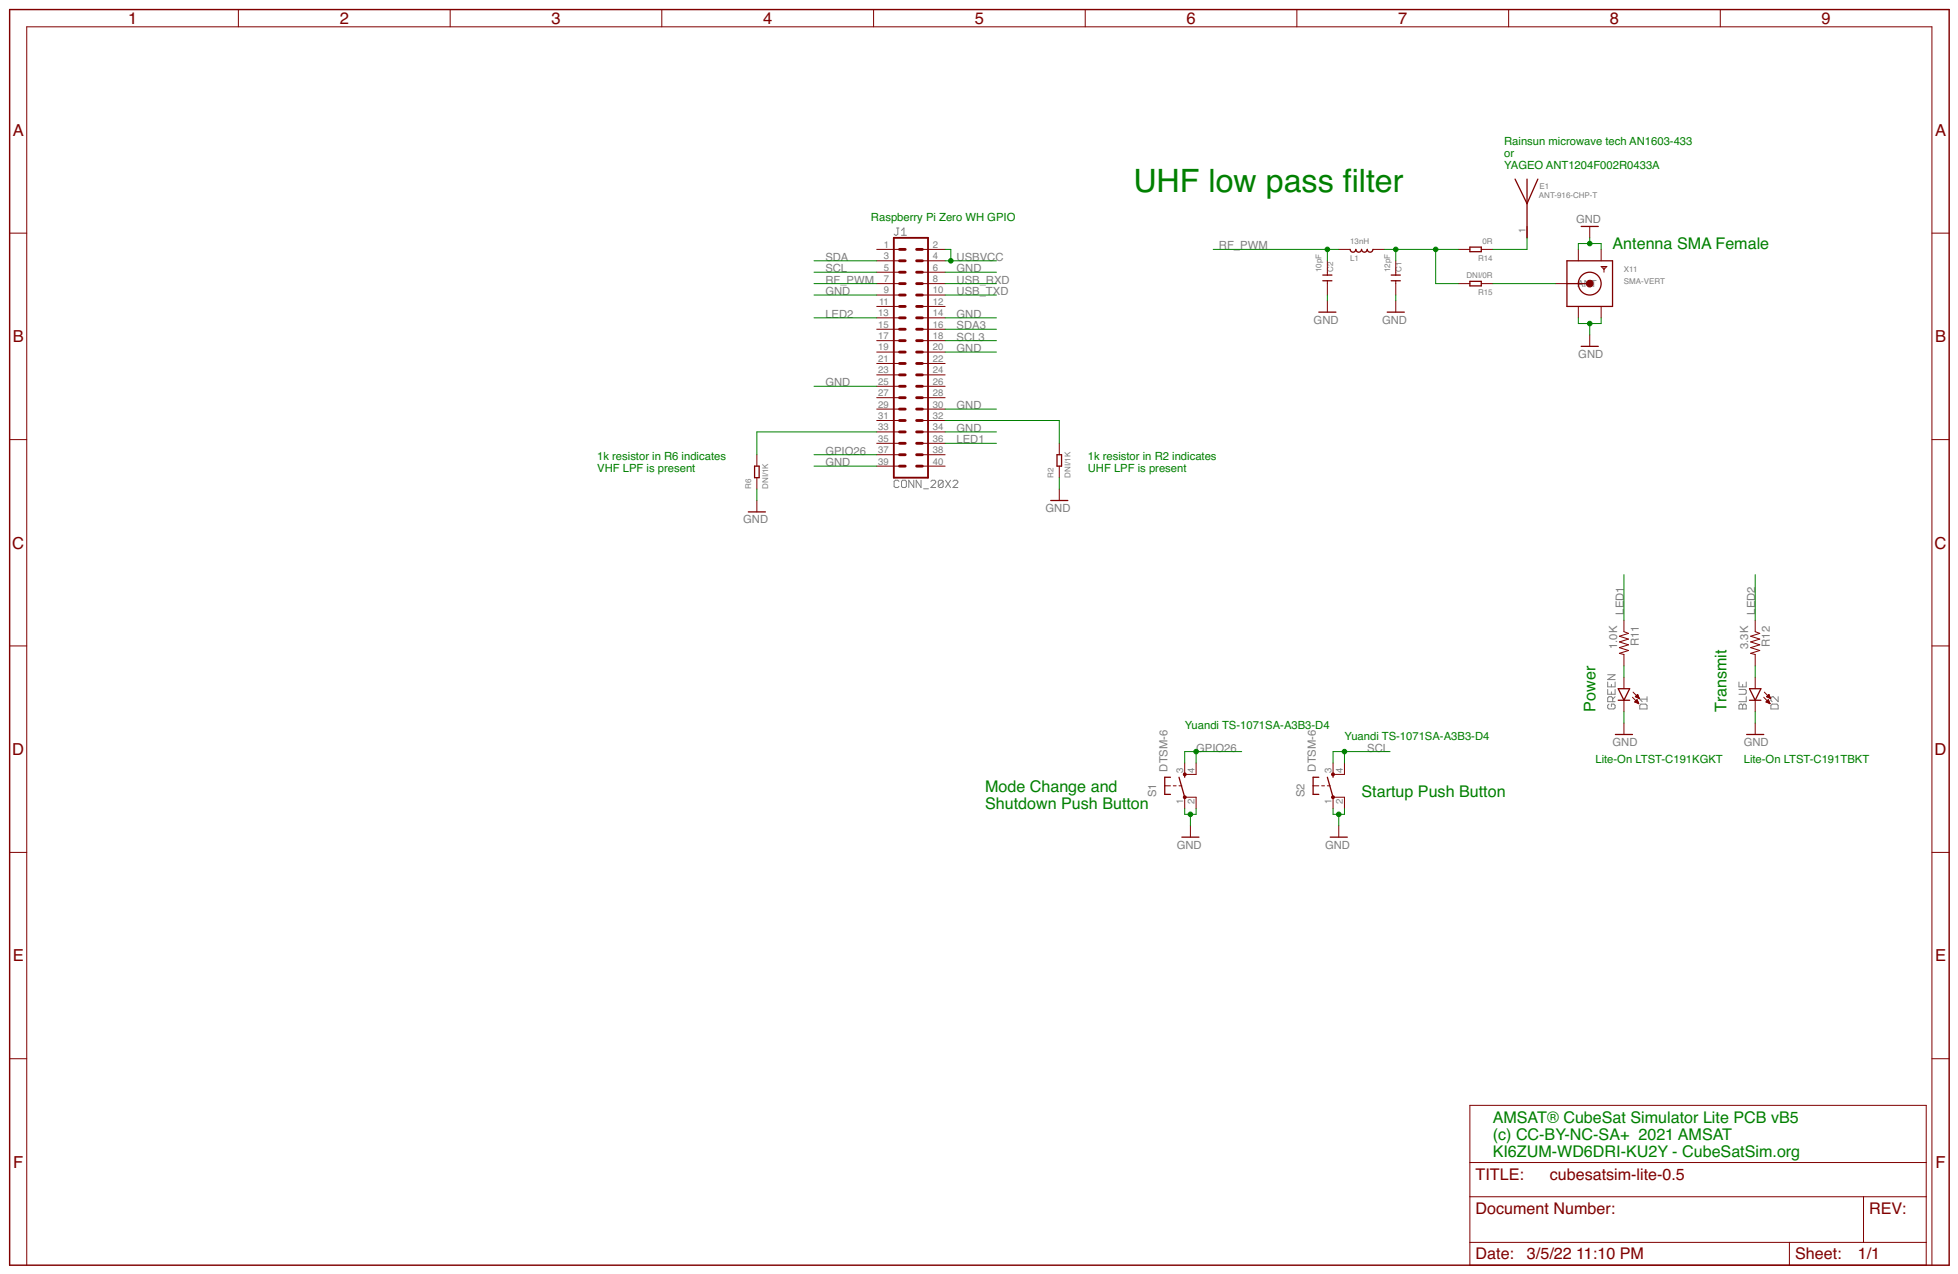
[picture p80: page 1]

UHF low pass filter

E1 1 R14 R15 GND GND GND GND GND GND

Raspberry Pi Zero WH GPIO

1k resistor in R2 indicates UHF LPF is present 1k resistor in R6 indicates VHF LPF is present

Yuandi TS-1071SA-A3B3-D4

AMSAT® CubeSat Simulator Lite PCB vB5
(c) CC-BY-NC-SA+ 2021 AMSAT
KI6ZUM-WD6DRI-KU2Y - CubeSatSim.org

REV: TITLE: Document Number: cubesatsim-lite-0.5

Date: 3/5/22 11:10 PM | Sheet: 1/1
