alanbjohnston/CubeSatSim/hardware/lite/vB3/cubesat-sim-lite-0.3_schematic.pdf

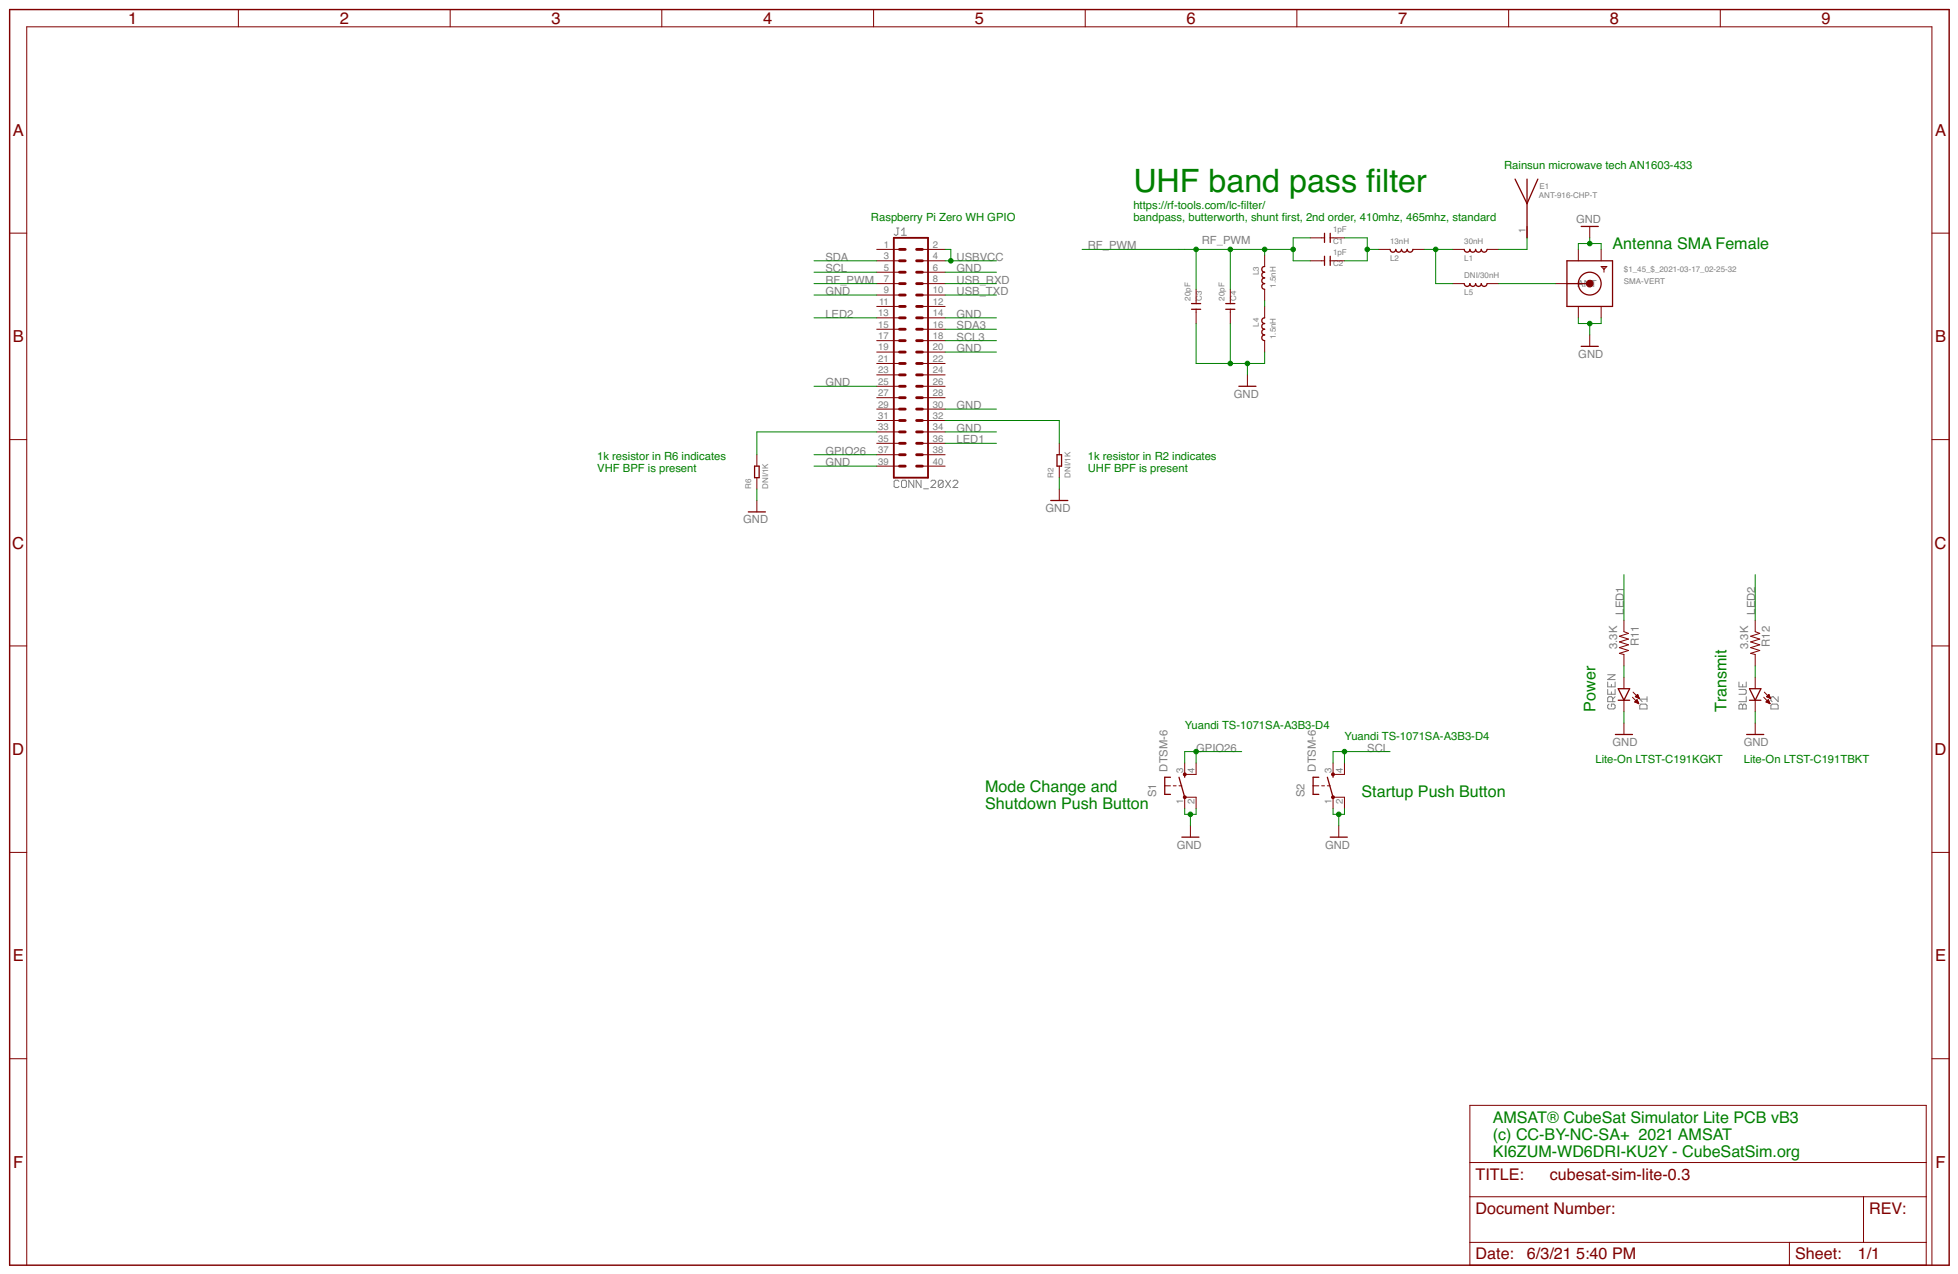
[picture p81: page 1]

UHF band pass filter

https://rf-tools.com/lc-filter/ bandpass, butterworth, shunt first, 2nd order, 410mhz, 465mhz, standard

Raspberry Pi Zero WH GPIO

SDA
L5 GND GND GND GND GND GND
LED2 RF_PWM
GND

1k resistor in R2 indicates UHF BPF is present 1k resistor in R6 indicates VHF BPF is present

Yuandi TS-1071SA-A3B3-D4

AMSAT® CubeSat Simulator Lite PCB vB3
(c) CC-BY-NC-SA+ 2021 AMSAT
KI6ZUM-WD6DRI-KU2Y - CubeSatSim.org

REV: TITLE: Document Number: cubesat-sim-lite-0.3

Date: 6/3/21 5:40 PM | Sheet: 1/1
