alanbjohnston/CubeSatSim/hardware/beta-v1.3.2/cubesatsim-battery-b1.3.2b_bnames.pdf

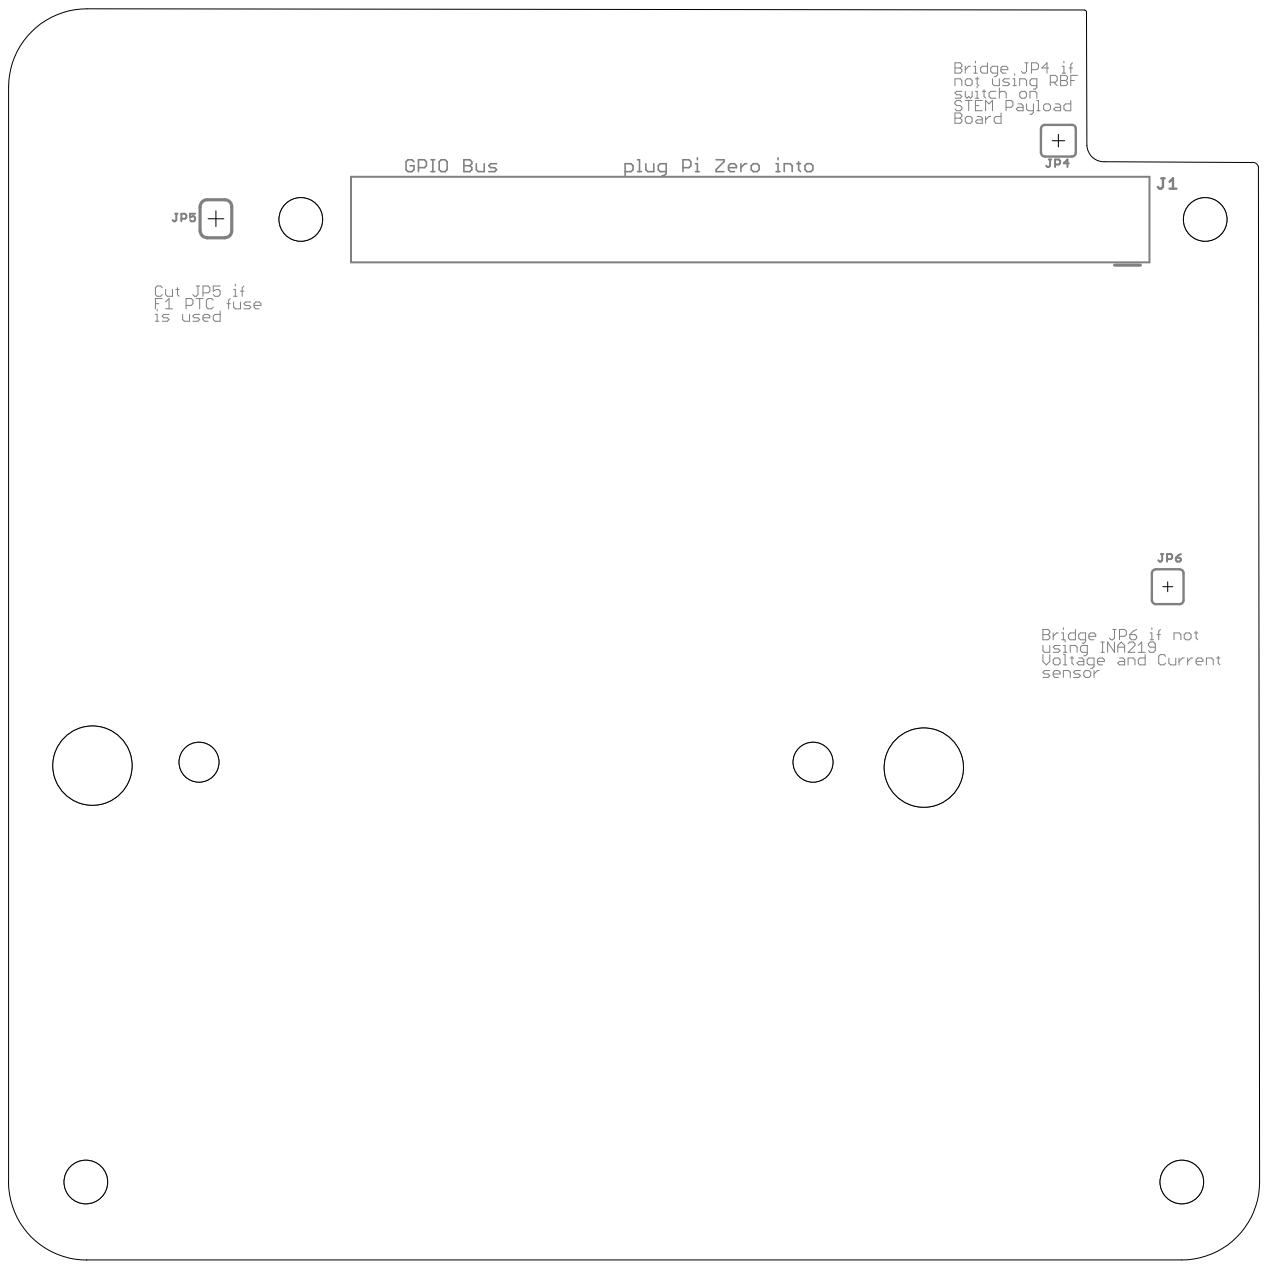
[picture p82: page 1]
