alanbjohnston/CubeSatSim/hardware/beta-v1.3.2/cubesatsim-solar-b1.3.2_bnames.pdf

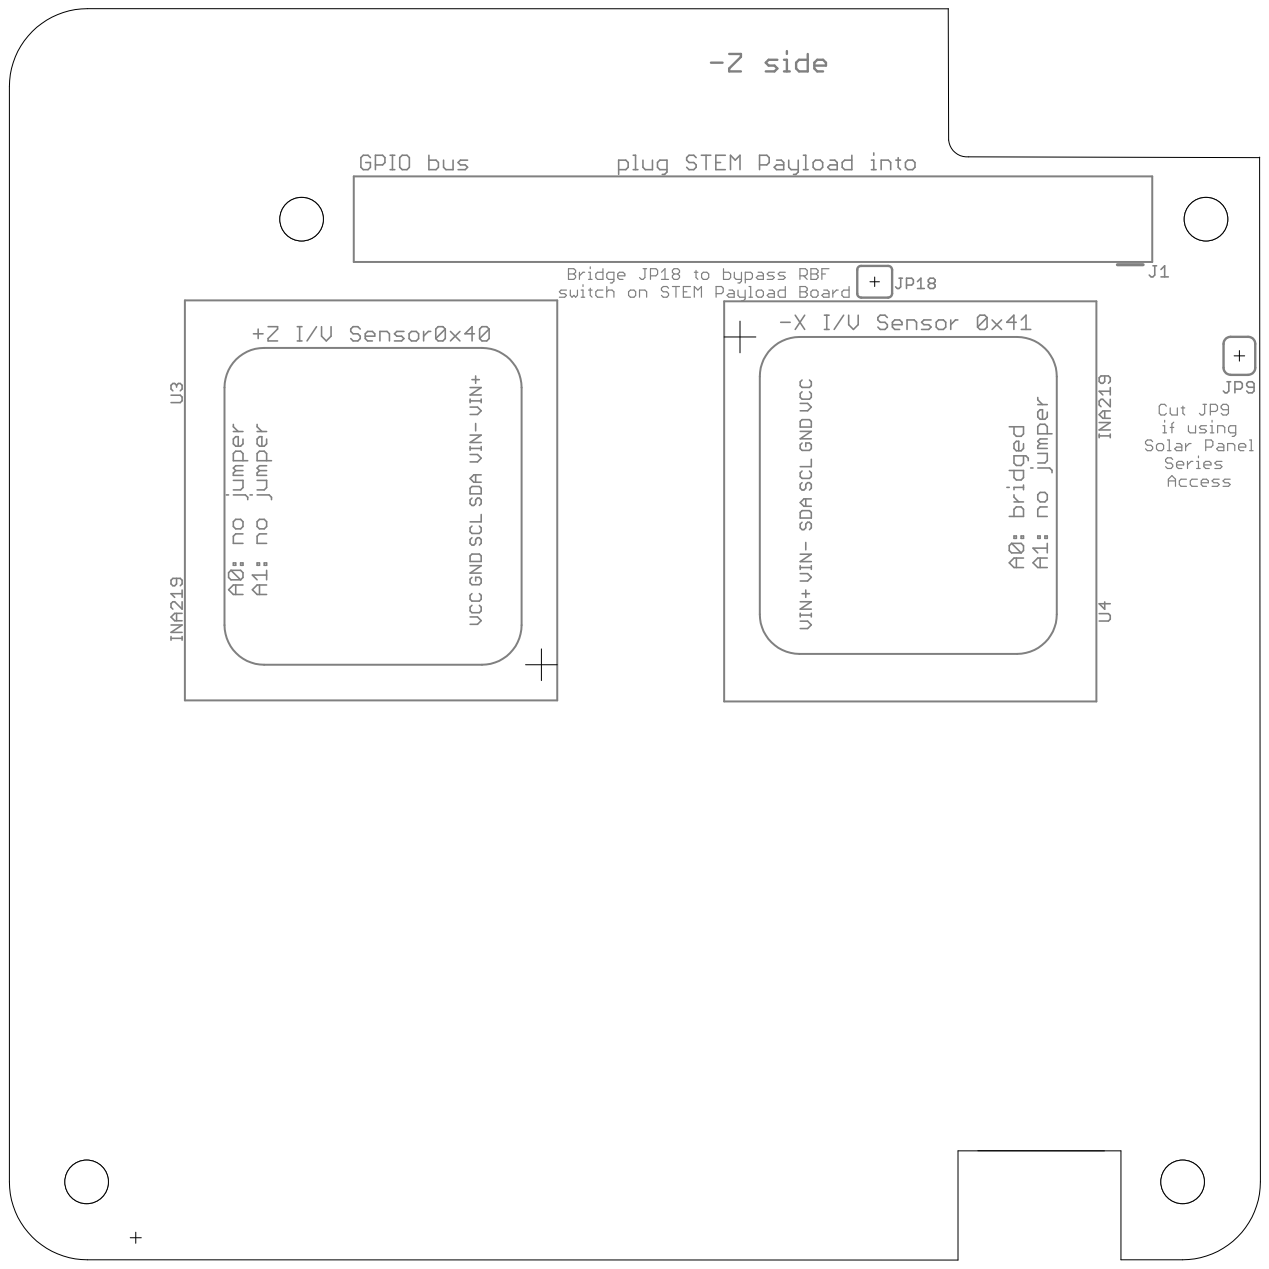
[picture p84: page 1]
