alanbjohnston/CubeSatSim/hardware/beta-v1.3.2/cubesatsim-solar-b1.3.2_tnames.pdf

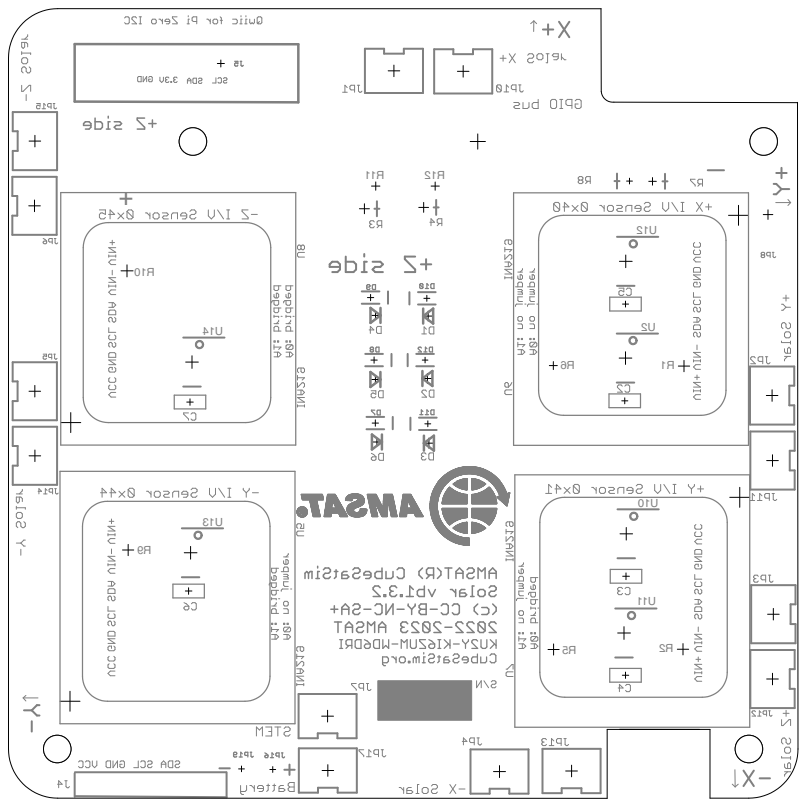
[picture p85: page 1]
