alanbjohnston/CubeSatSim/hardware/vB5/cubesat-sim-battery-0.3_schematic.pdf

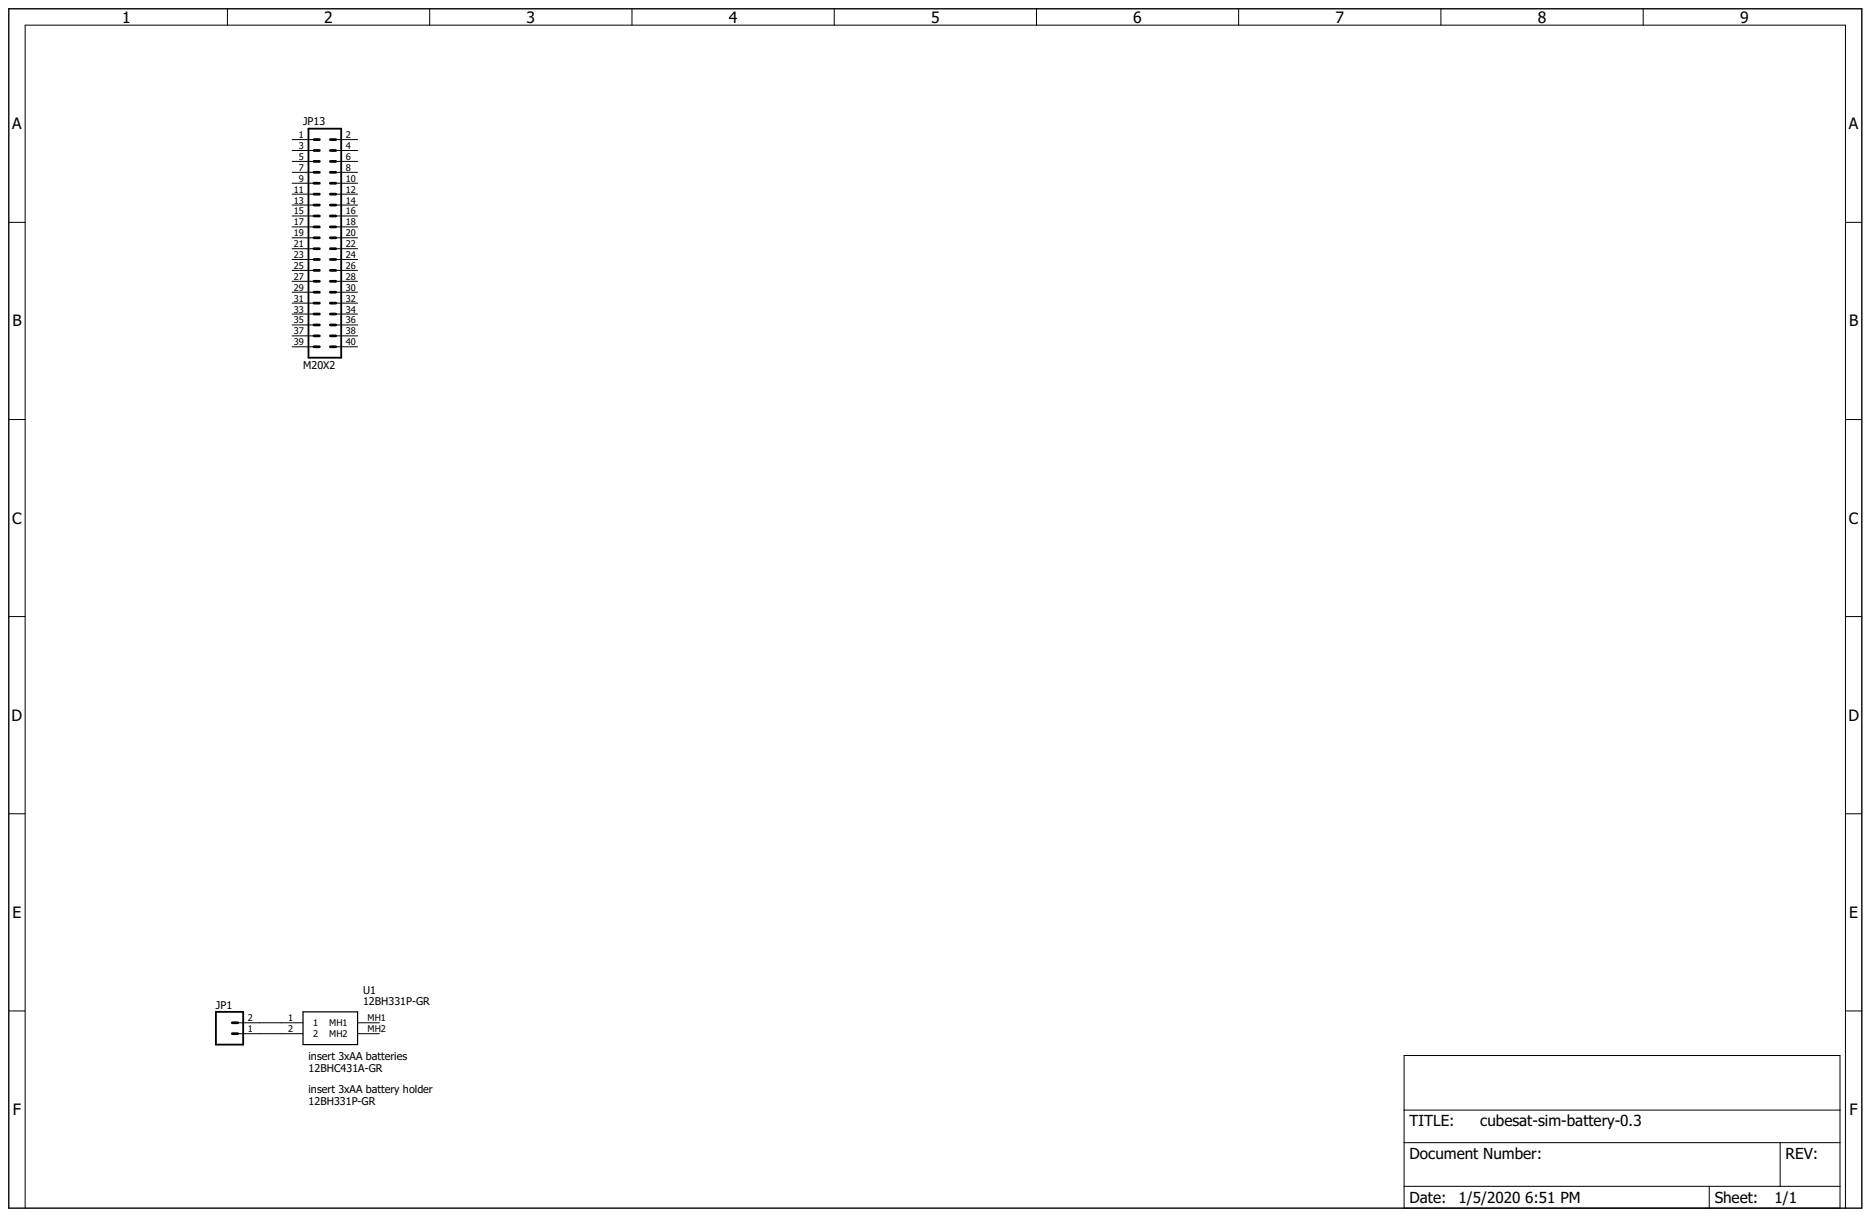
[picture p88: page 1]
