alanbjohnston/CubeSatSim/hardware/vB3/kicad/PCB1.pdf

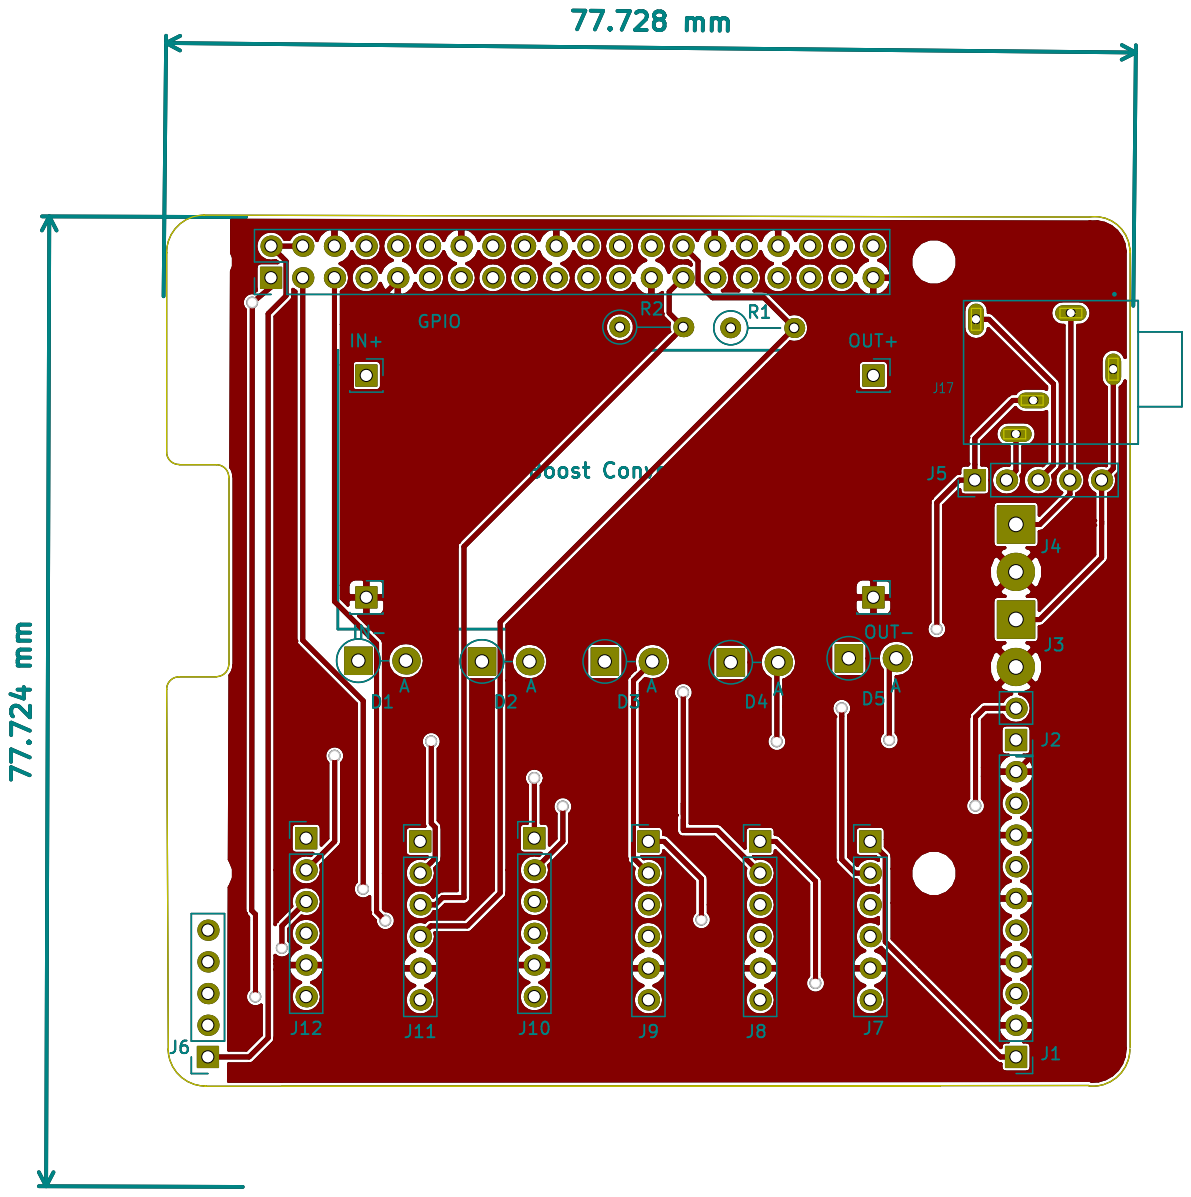
[picture p89: page 1]
