alanbjohnston/CubeSatSim/hardware/vB3/kicad/PCB2.pdf

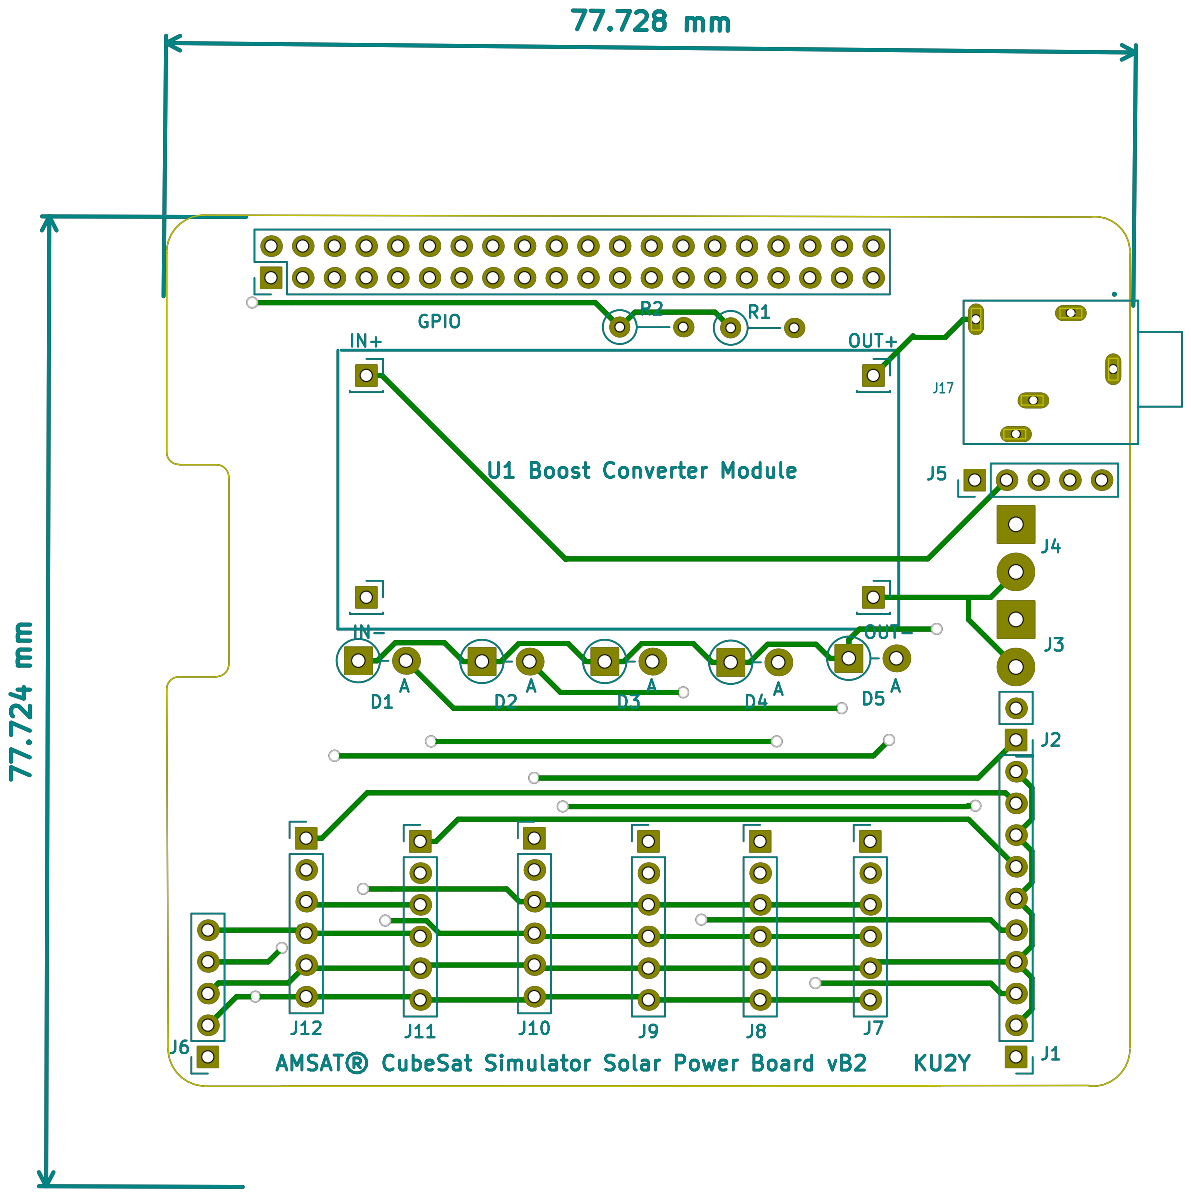
[picture p90: page 1]
