alanbjohnston/CubeSatSim/hardware/vB3/kicad/Schematic.pdf

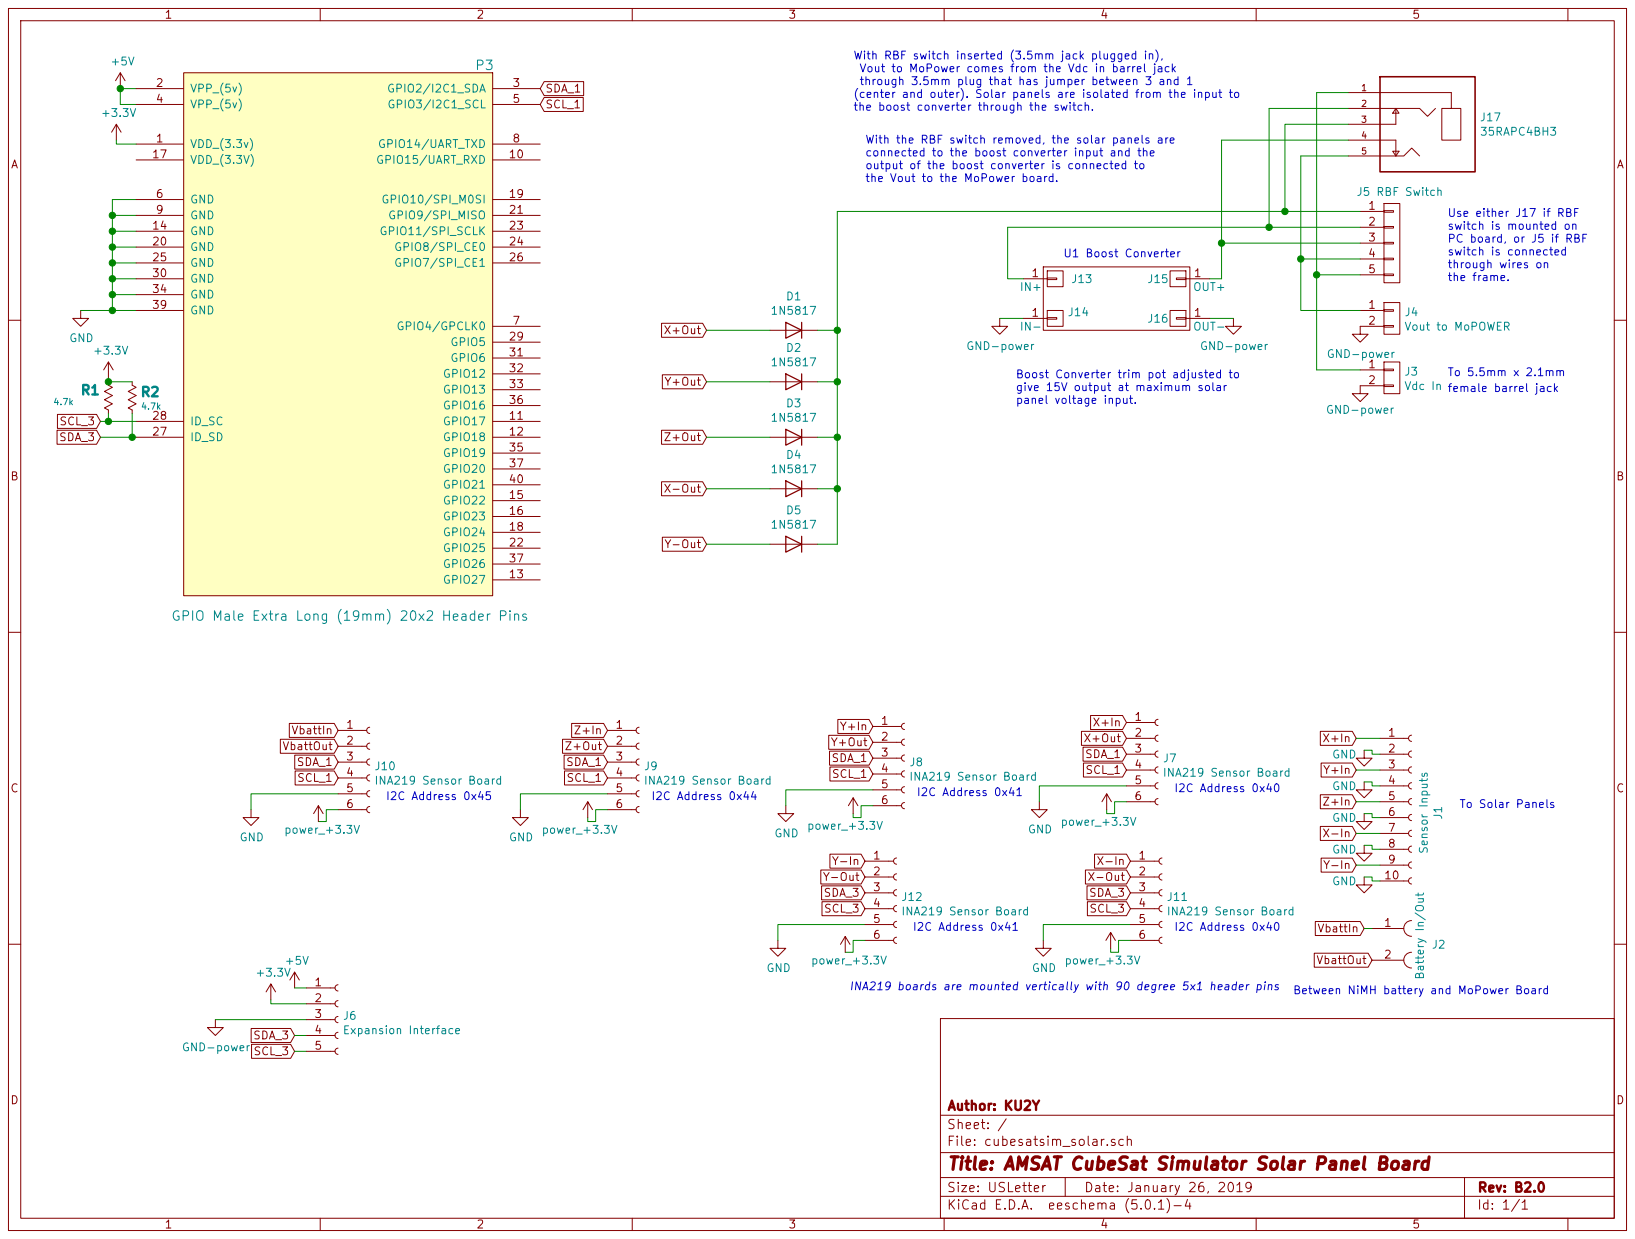
[picture p91: page 1]
