alanbjohnston/CubeSatSim/hardware/vB3/kicad/cubesatsim_solar_board.pdf

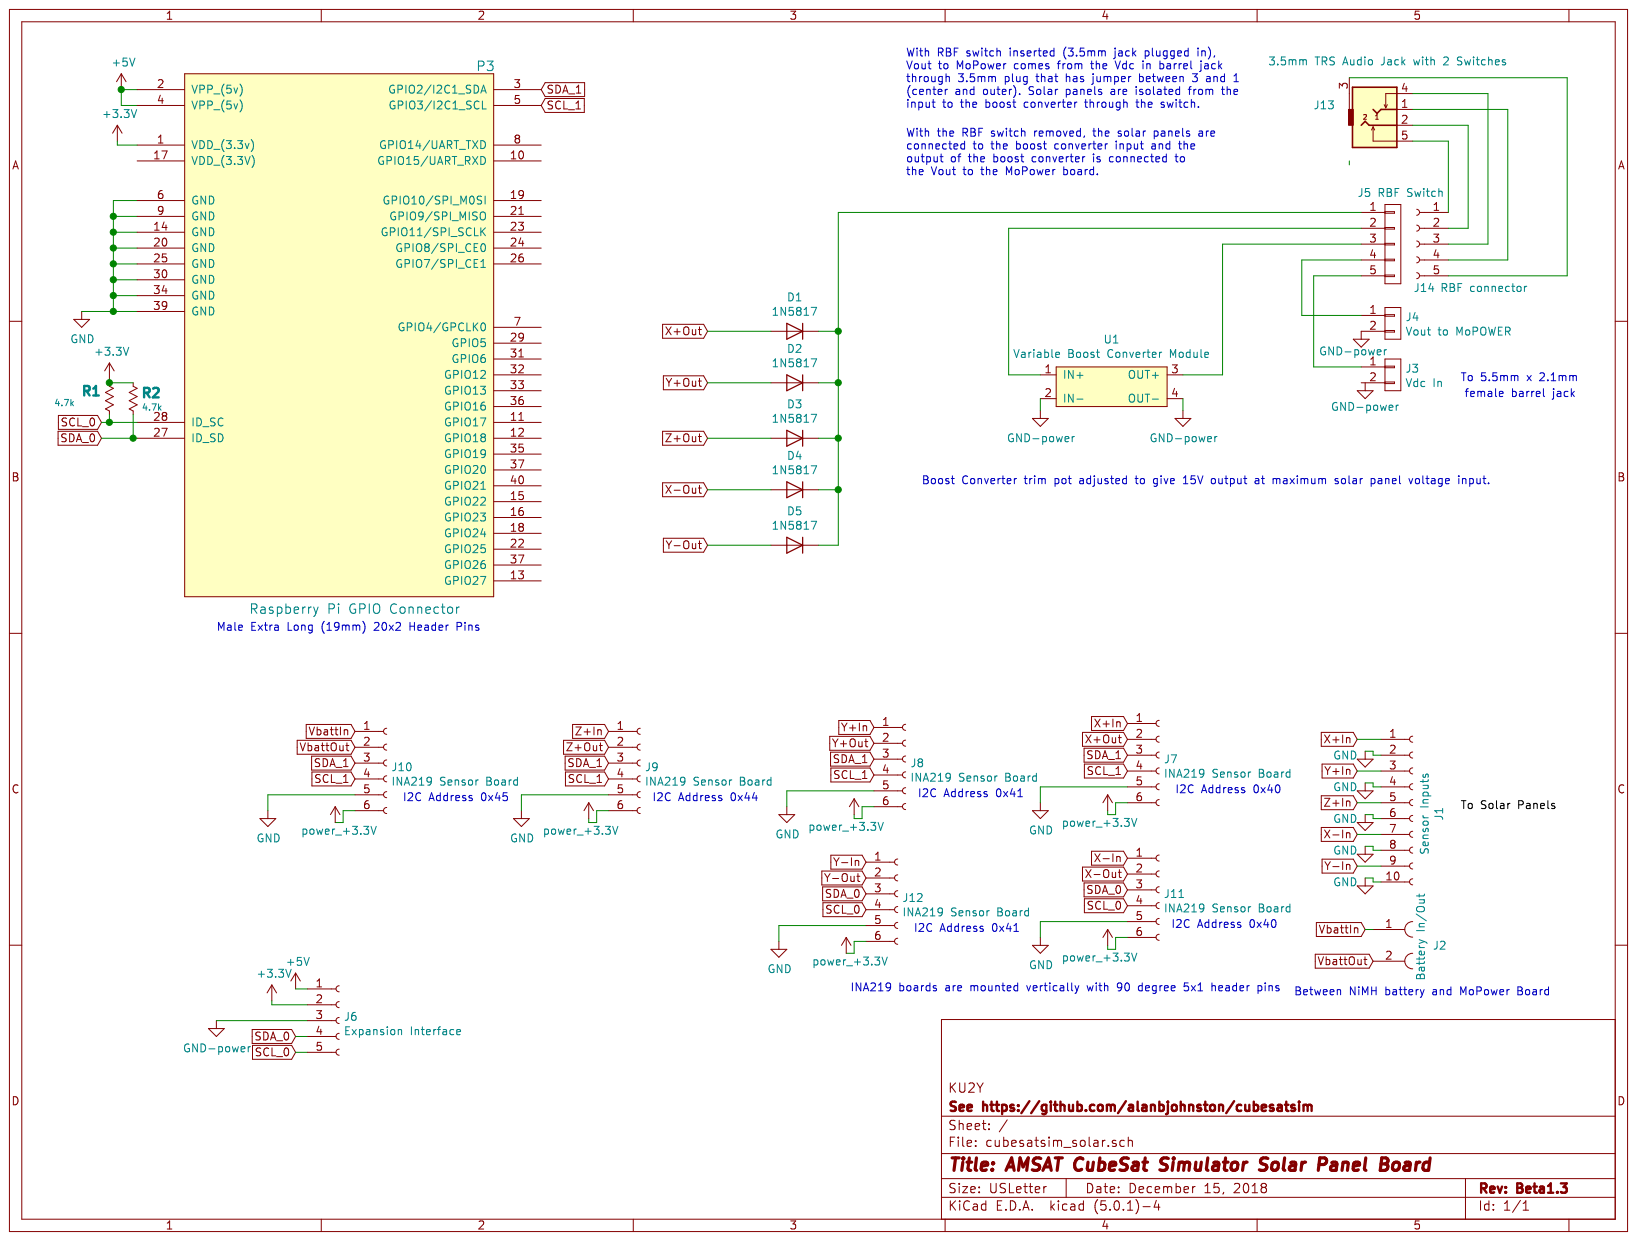
[picture p92: page 1]
