alanbjohnston/CubeSatSim/hardware/vB3/kicad/PCB.pdf

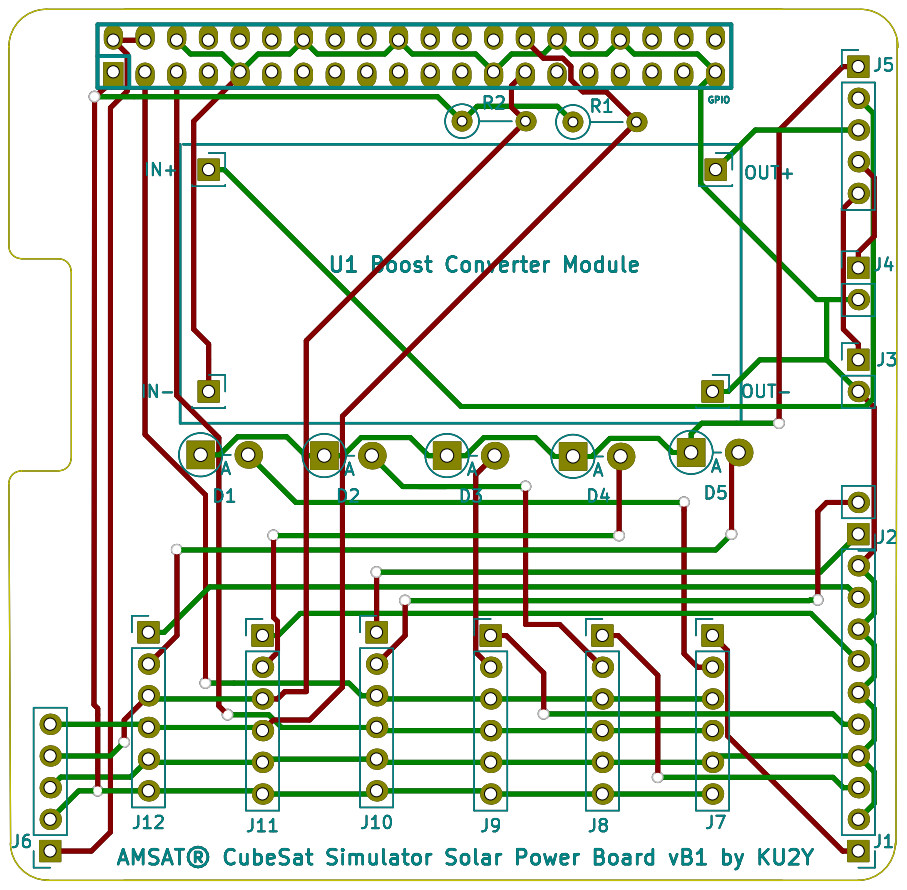
[picture p93: page 1]
