alanbjohnston/CubeSatSim/hardware/v1.2/cubesatsim-main-1.2_schematic.pdf

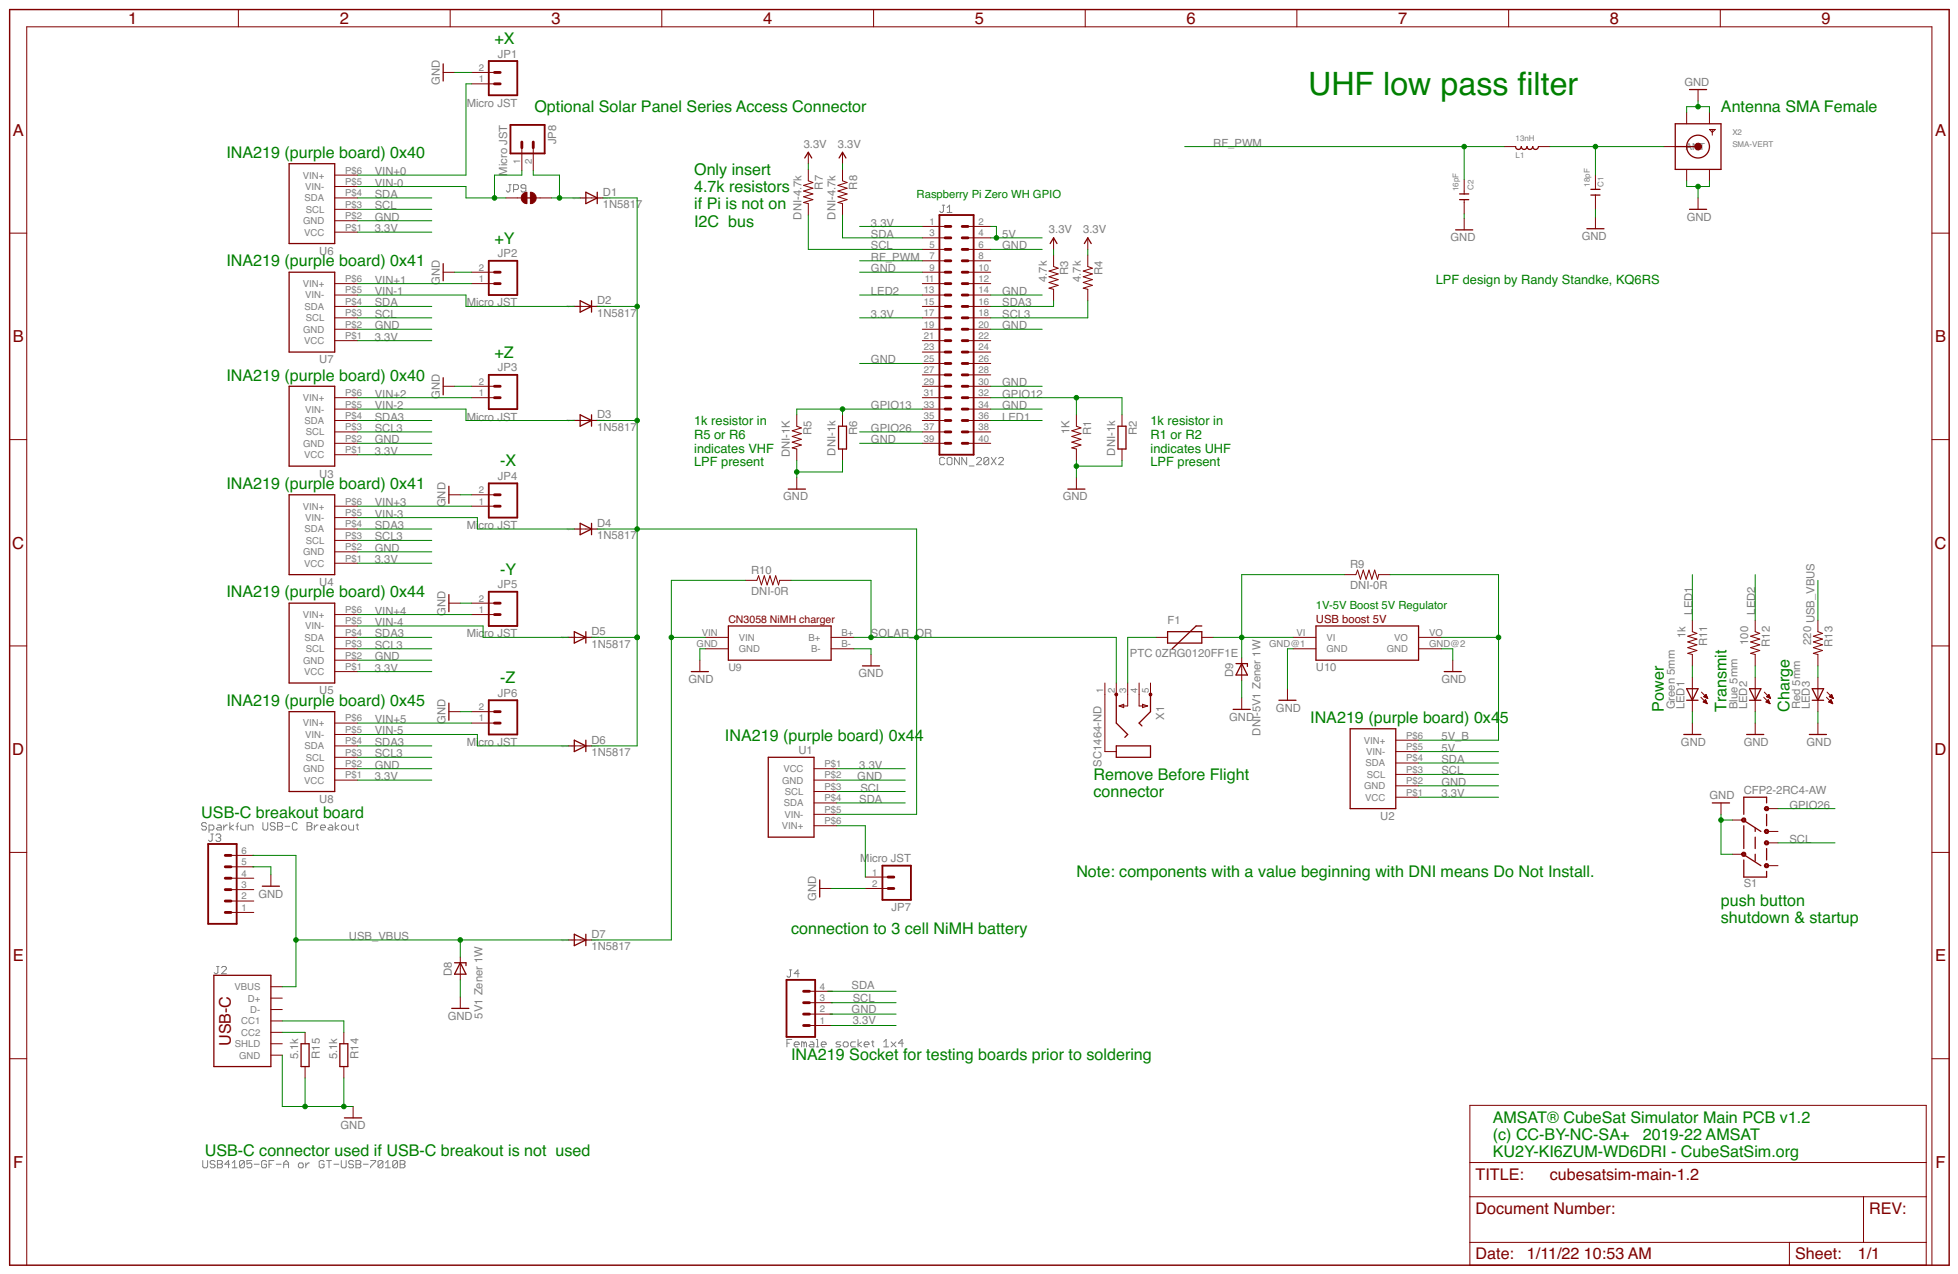
[picture p94: page 1]

UHF low pass filter

Optional Solar Panel Series Access Connector Only insert

4.7k resistors
if Pi is not on
I2C bus

Raspberry Pi Zero WH GPIO

Micro JST Micro JST Micro JST Micro JST Micro JST

GND GND GND GND GND

LPF design by Randy Standke, KQ6RS

LPF present 1k resistor in R5 or R6

Remove Before Flight connector USB-C breakout board

Note: components with a value beginning with DNI means Do Not Install.

connection to 3 cell NiMH battery

AMSAT® CubeSat Simulator Main PCB v1.2
(c) CC-BY-NC-SA+ 2019-22 AMSAT
KU2Y-KI6ZUM-WD6DRI - CubeSatSim.org

USB-C connector used if USB-C breakout is not used

REV: TITLE: Document Number: cubesatsim-main-1.2

Date: 1/11/22 10:53 AM | Sheet: 1/1
