alanbjohnston/CubeSatSim/hardware/v1.2/cubesatsim-STEM-1.2_schematic.pdf

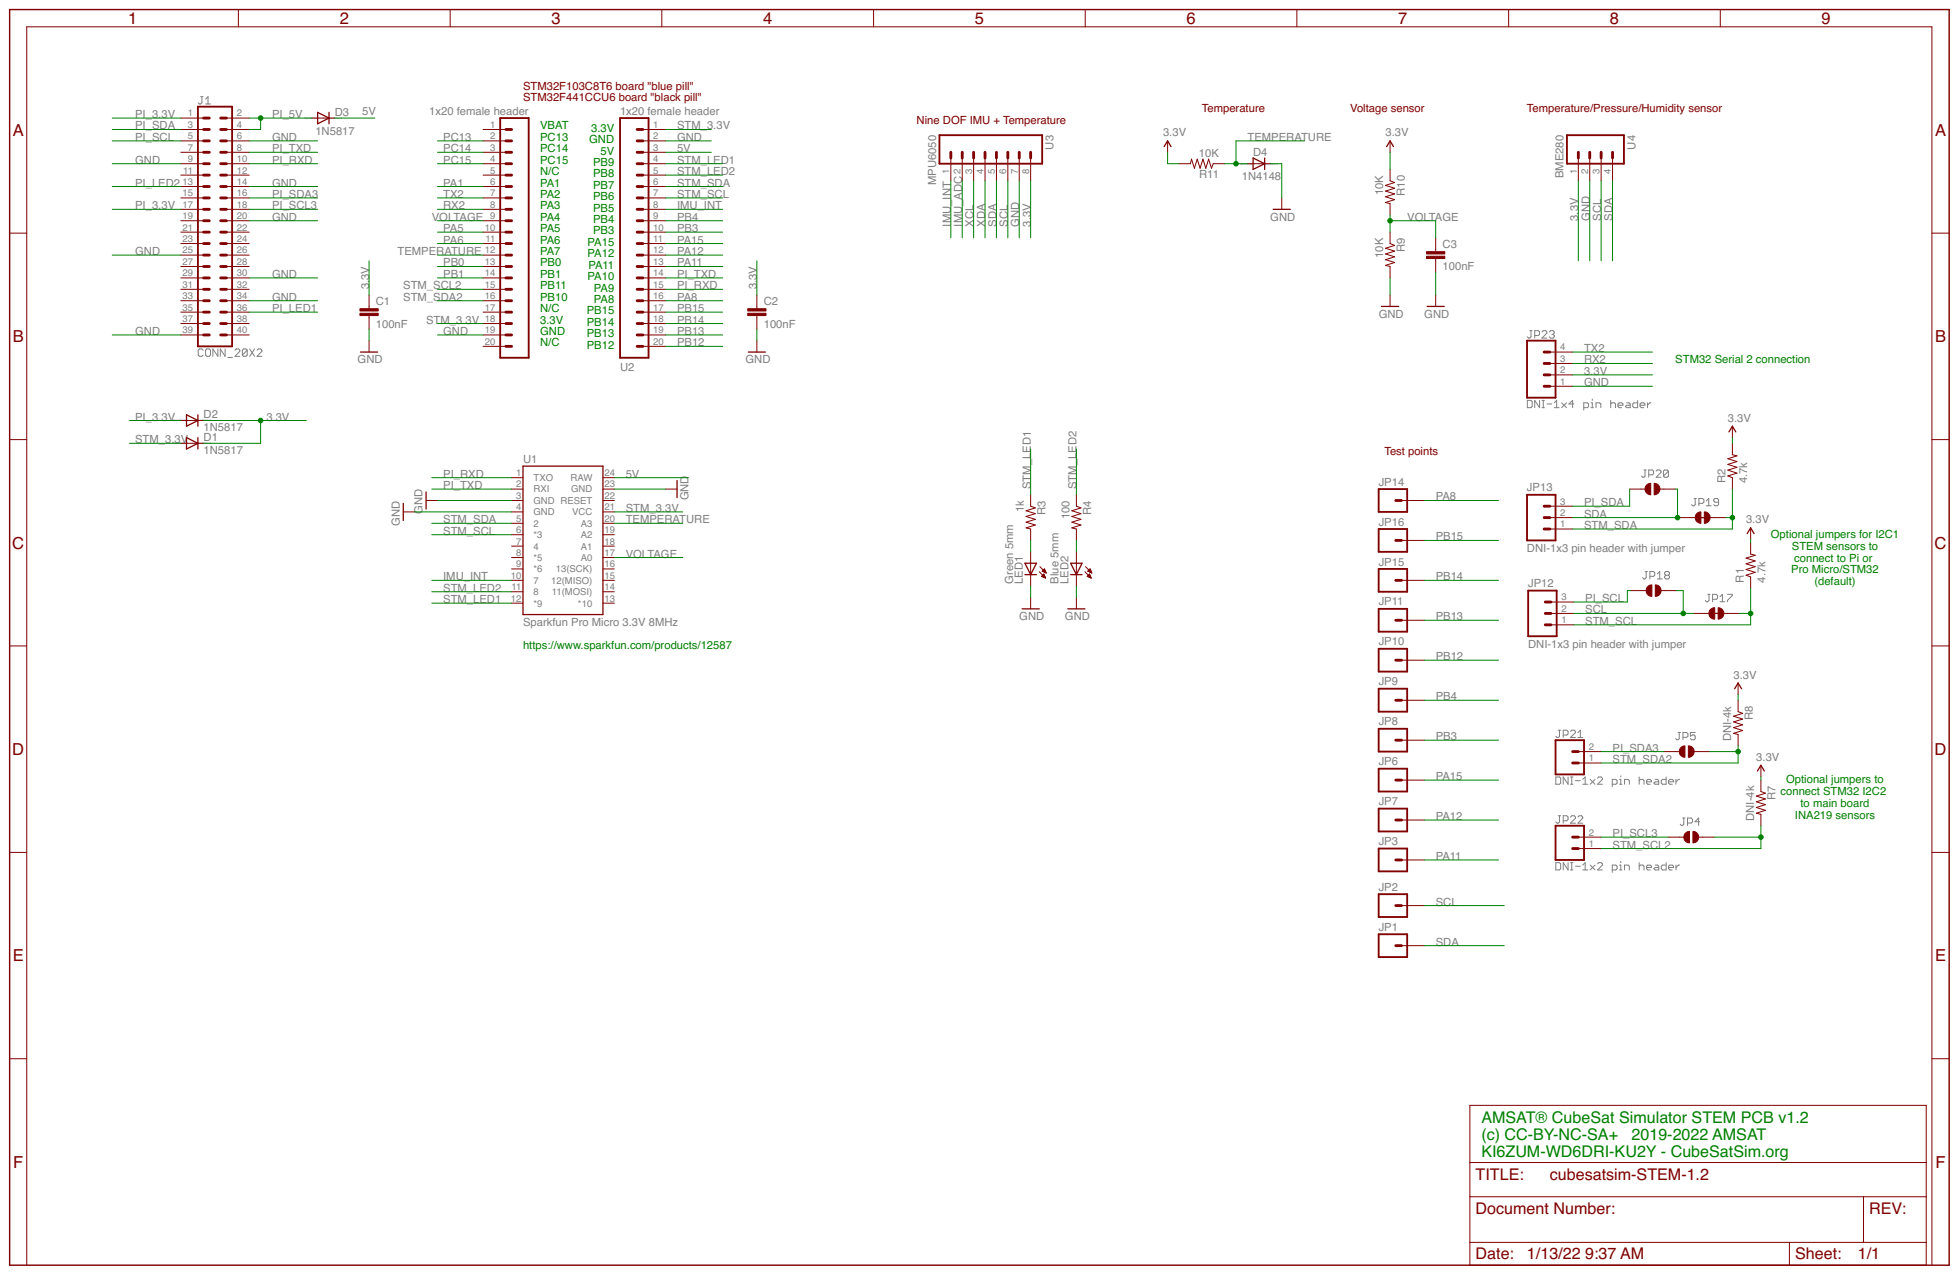
[picture p95: page 1]

Optional jumpers for I2C1 STEM sensors to

connect to Pi or Pro Micro/STM32

https://www.sparkfun.com/products/12587

AMSAT® CubeSat Simulator STEM PCB v1.2
(c) CC-BY-NC-SA+ 2019-2022 AMSAT
KI6ZUM-WD6DRI-KU2Y - CubeSatSim.org

REV: TITLE: Document Number: cubesatsim-STEM-1.2

Date: 1/13/22 9:37 AM | Sheet: 1/1
