alanbjohnston/CubeSatSim/hardware/v1.1/cubesatsim-STEM-1.1a_schematic.pdf

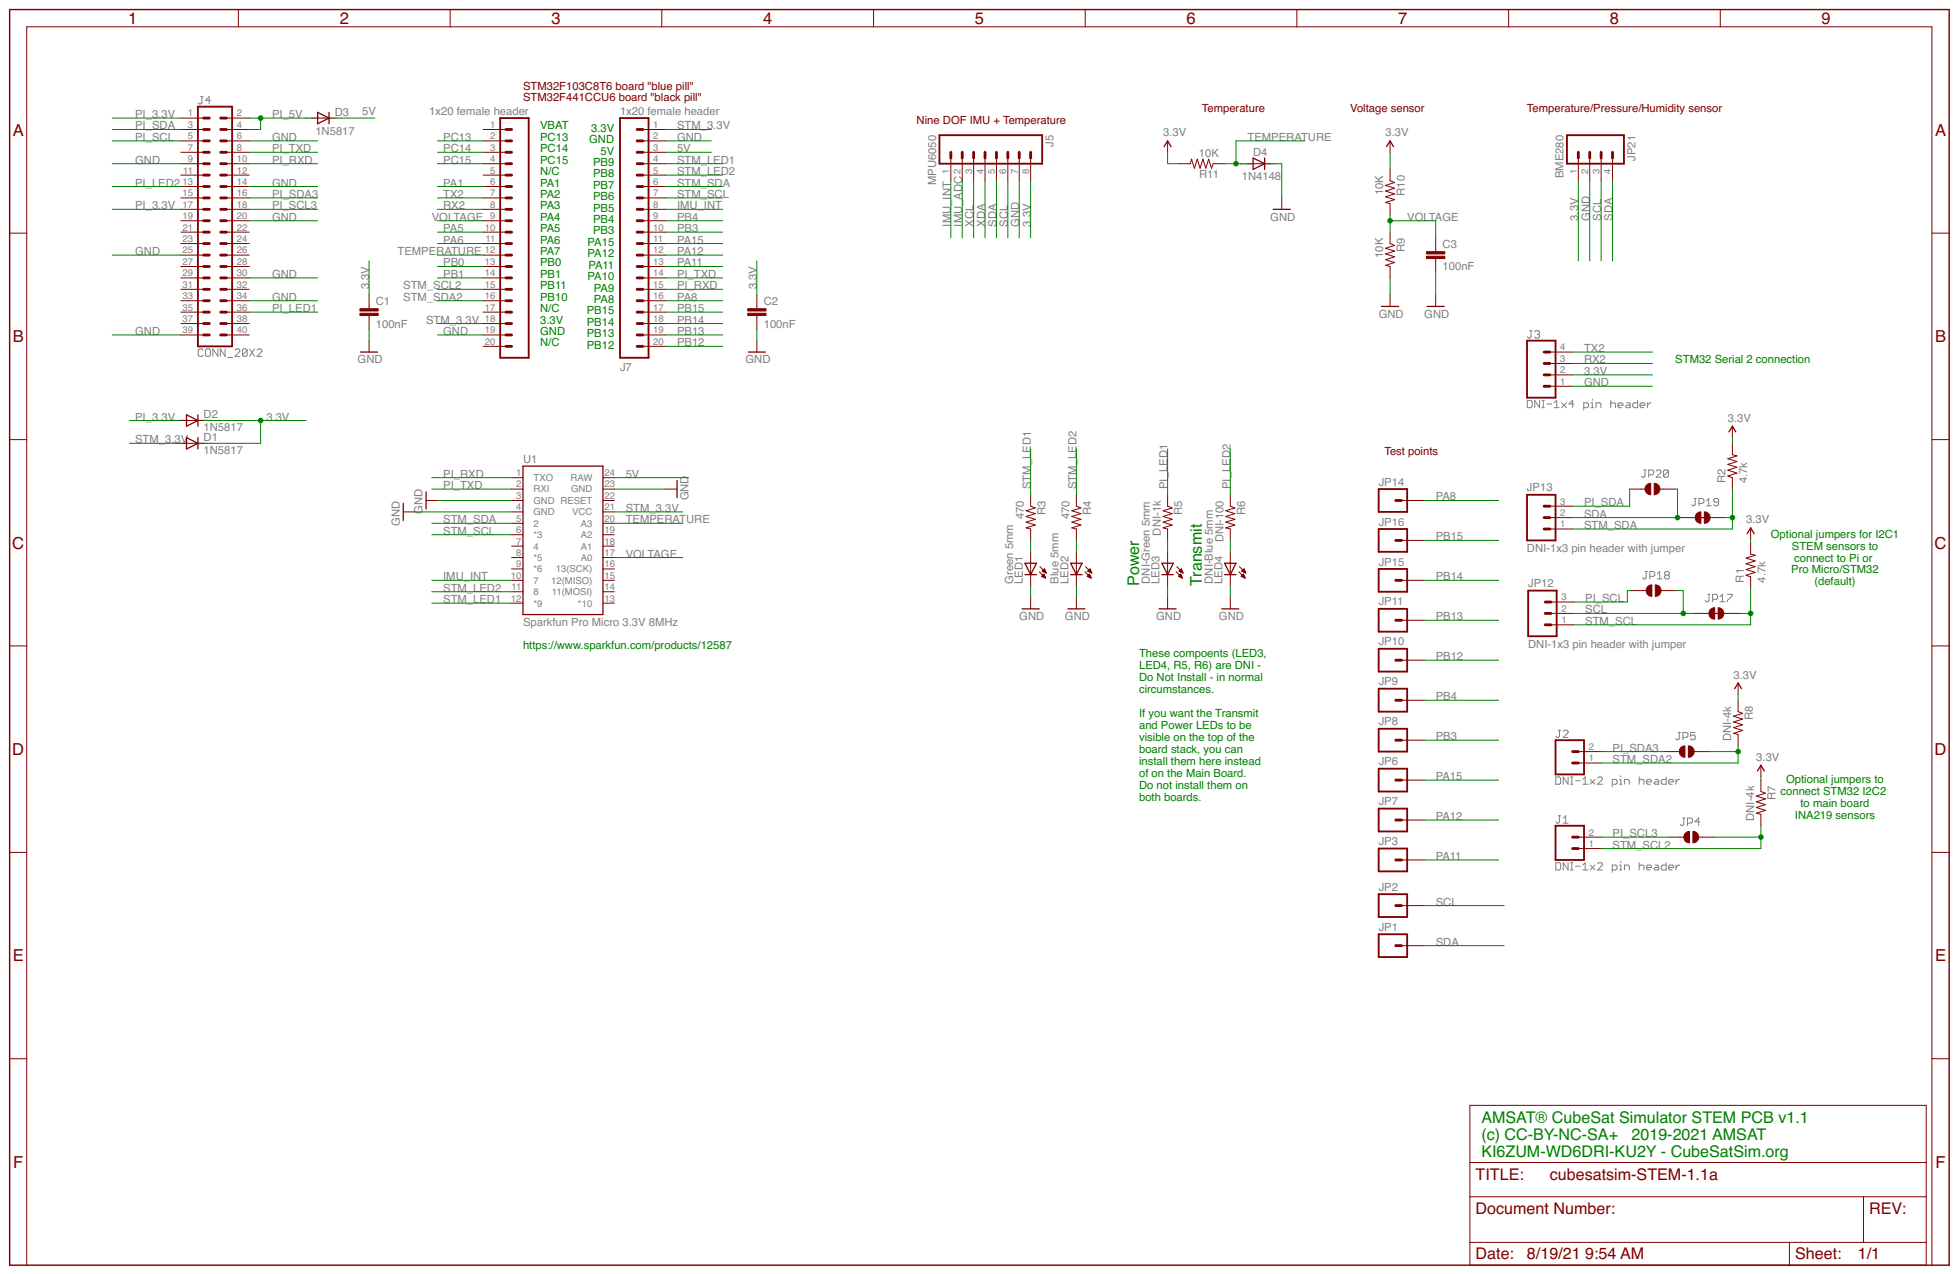
[picture p96: page 1]

DNI-1k DNI-Green 5mm GND

DNI-100 DNI-Blue 5mm GND

Optional jumpers for I2C1 STEM sensors to

connect to Pi or Pro Micro/STM32

https://www.sparkfun.com/products/12587

These compoents (LED3, LED4, R5, R6) are DNI - Do Not Install - in normal circumstances.

If you want the Transmit and Power LEDs to be

visible on the top of the
board stack, you can
install them here instead
of on the Main Board. Do not install them on

AMSAT® CubeSat Simulator STEM PCB v1.1
(c) CC-BY-NC-SA+ 2019-2021 AMSAT
KI6ZUM-WD6DRI-KU2Y - CubeSatSim.org

REV: TITLE: Document Number: cubesatsim-STEM-1.1a

Date: 8/19/21 9:54 AM | Sheet: 1/1
