alanbjohnston/CubeSatSim/hardware/v1.1/cubesatsim-battery-1.1_schematic.pdf

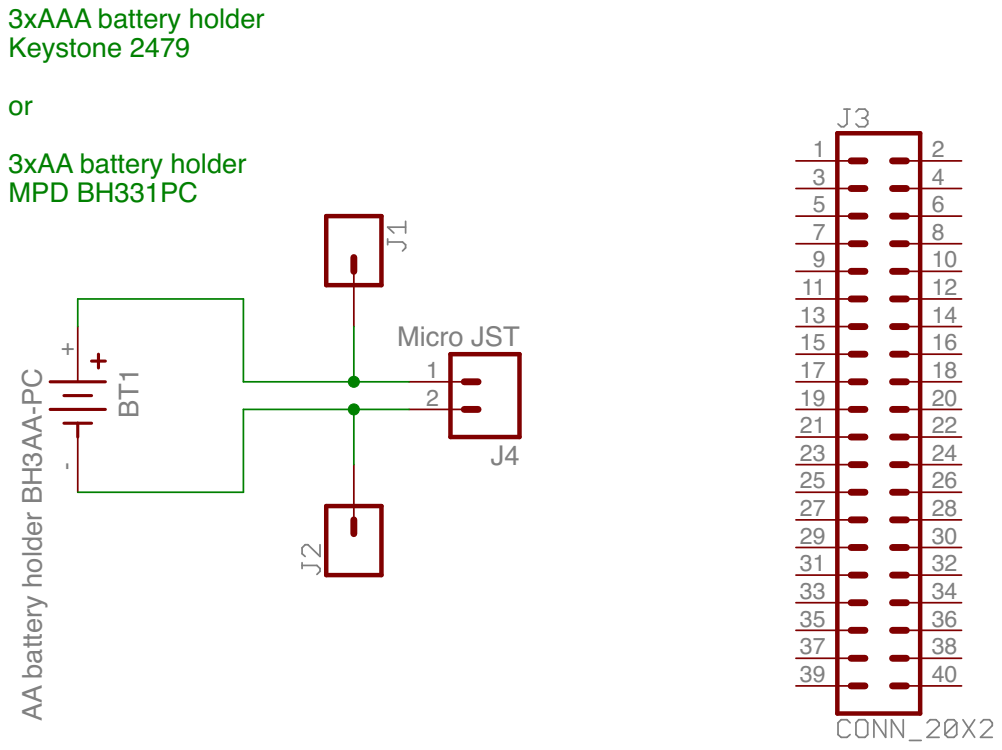
[picture p97: page 1]

or 3xAA battery holder MPD BH331PC

AA battery holder BH3AA-PC

REV: TITLE: Document Number: cubesatsim-battery-1.1

Date: 8/19/21 9:20 AM | Sheet: 1/1
