alanbjohnston/CubeSatSim/hardware/v1.2/cubesatsim-battery-1.2_bnames.pdf

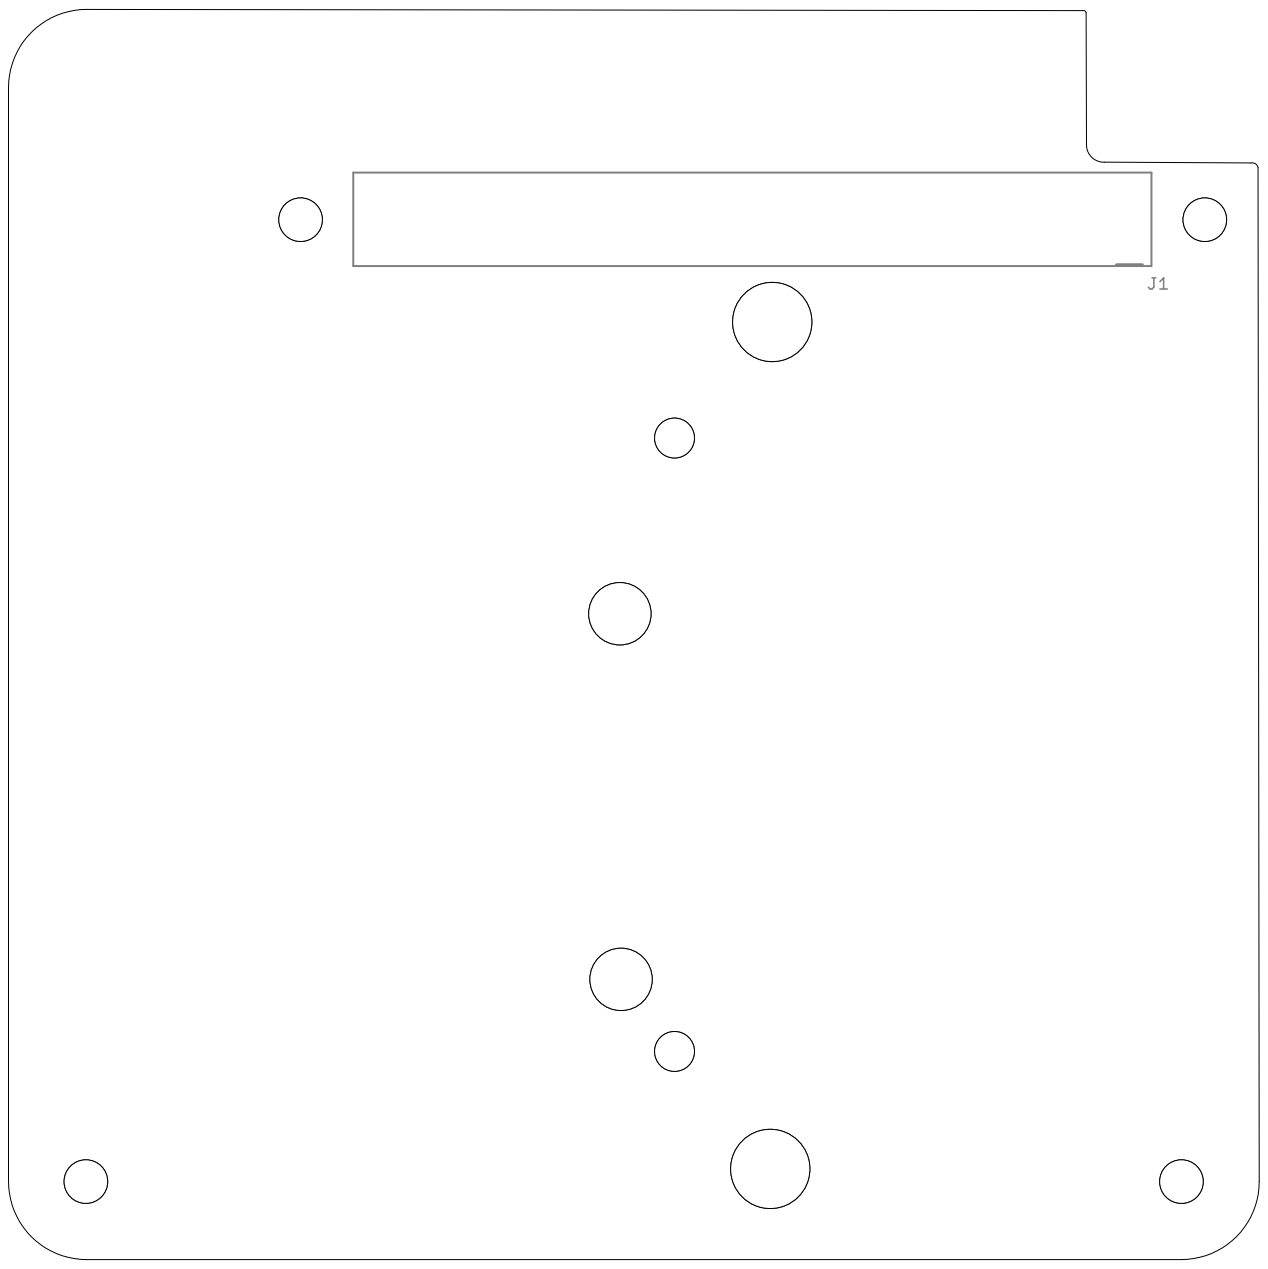
[picture p98: page 1]
