alanbjohnston/CubeSatSim/hardware/v1.2/cubesatsim-battery-1.2_schematic.pdf

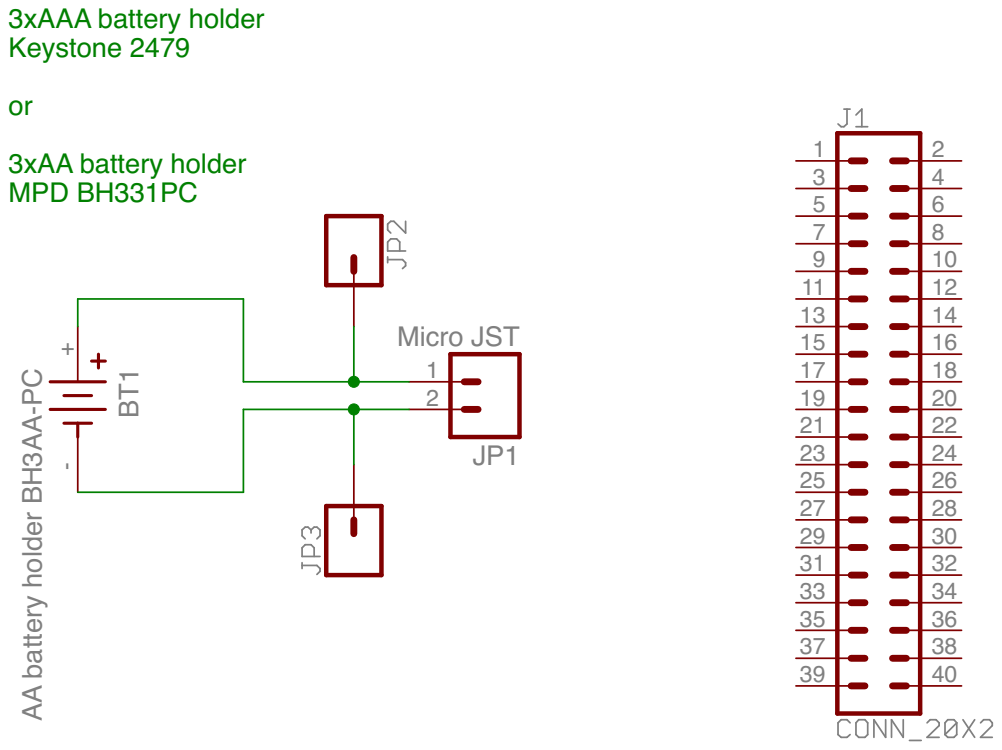
[picture p99: page 1]
