alanbjohnston/CubeSatSim/hardware/v1.2/cubesatsim-battery-1.2_tnames.pdf

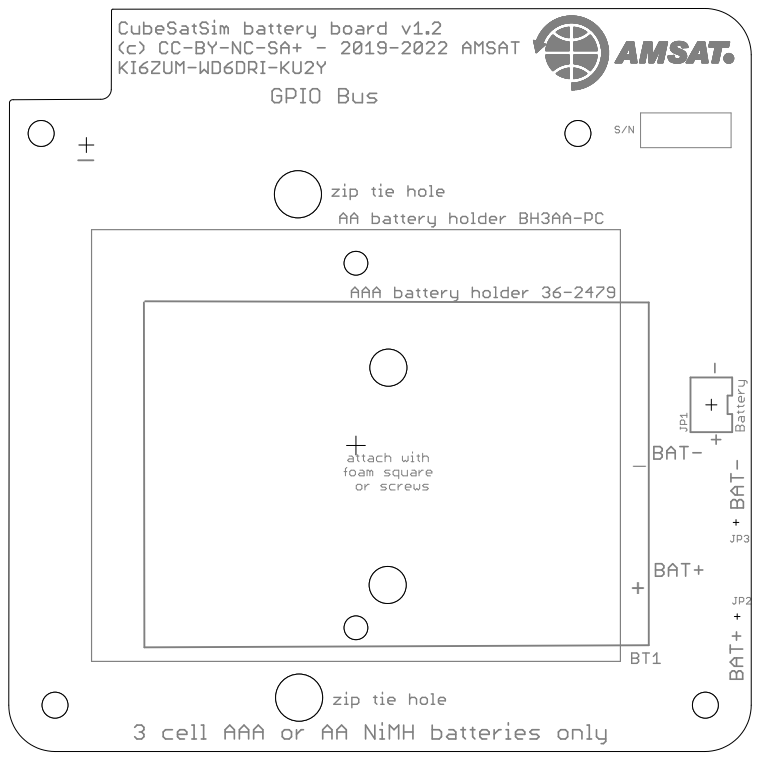
[picture p100: page 1]
