alanbjohnston/CubeSatSim/hardware/v1.2/cubesatsim-main-1.2_bnames.pdf

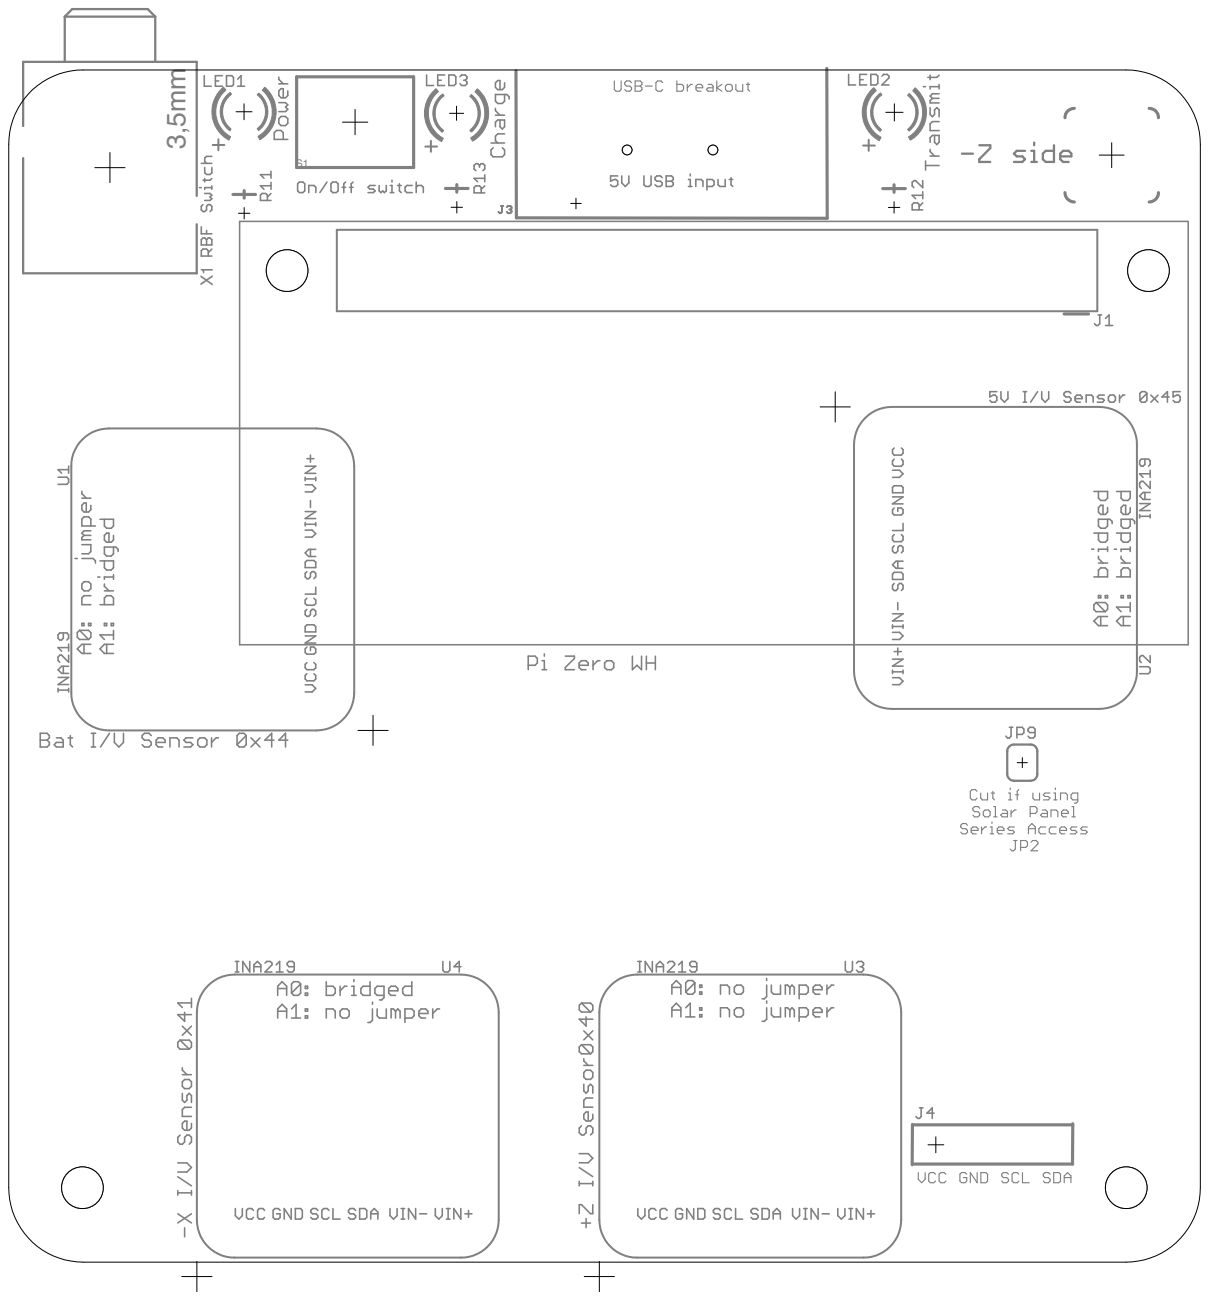
[picture p101: page 1]
