alanbjohnston/CubeSatSim/hardware/v1.2/cubesatsim-main-1.2_tnames.pdf

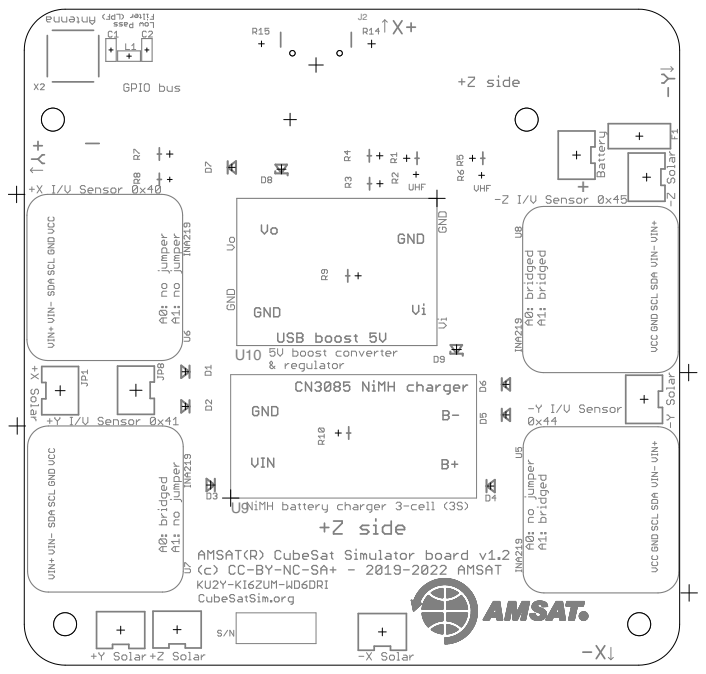
[picture p102: page 1]
