alanbjohnston/CubeSatSim/hardware/v1.2/cubesatsim-STEM-1.2_bnames.pdf

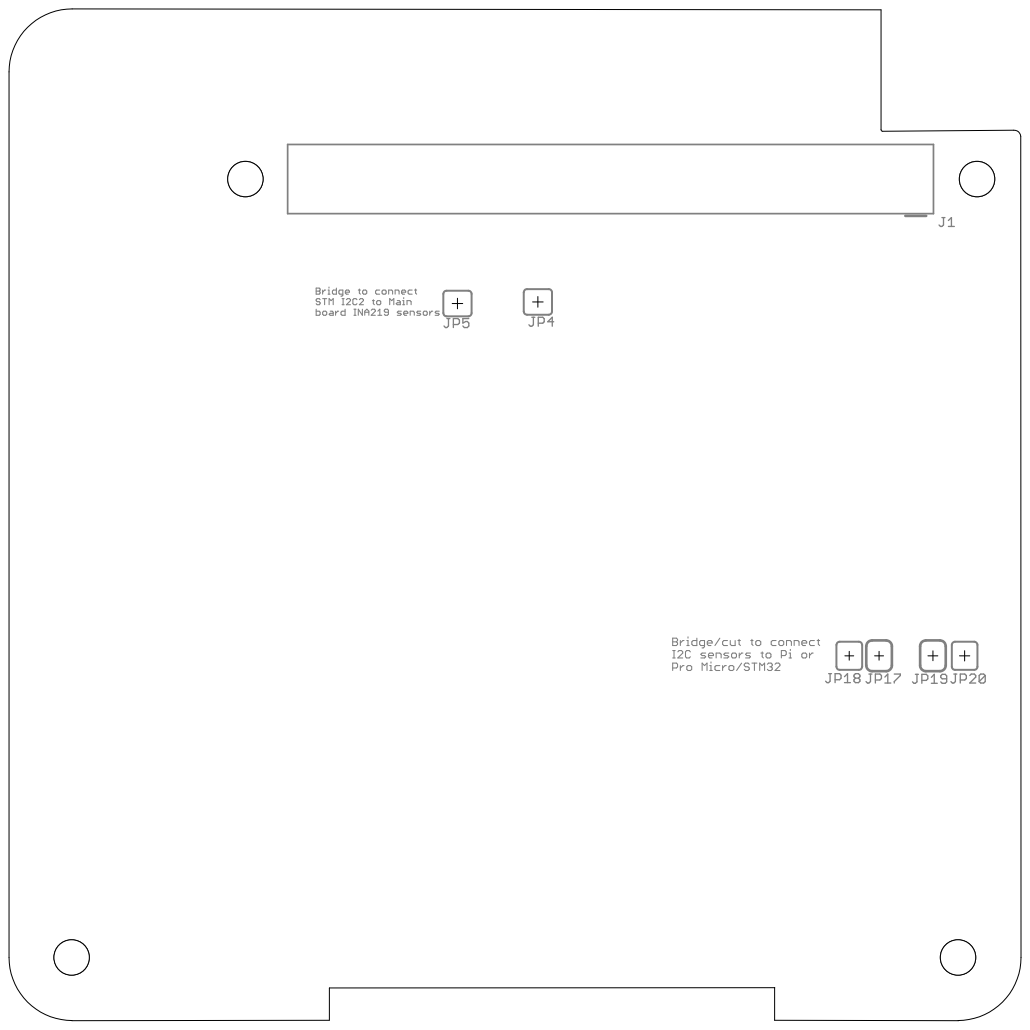
[picture p103: page 1]
