alanbjohnston/CubeSatSim/hardware/v1.2/cubesatsim-STEM-1.2_tnames.pdf

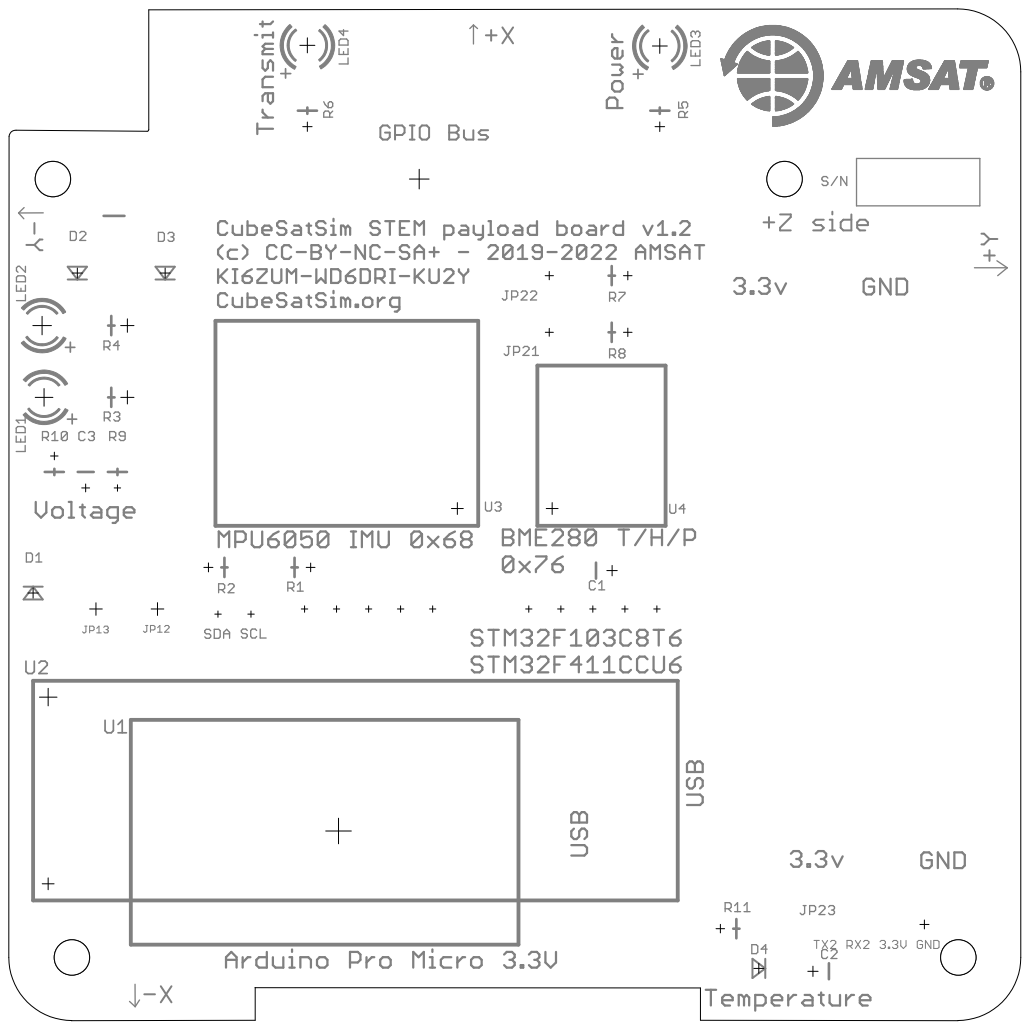
[picture p104: page 1]
