alanbjohnston/CubeSatSim/hardware/v1.1/cubesatsim-STEM-1.1a_bnames.pdf

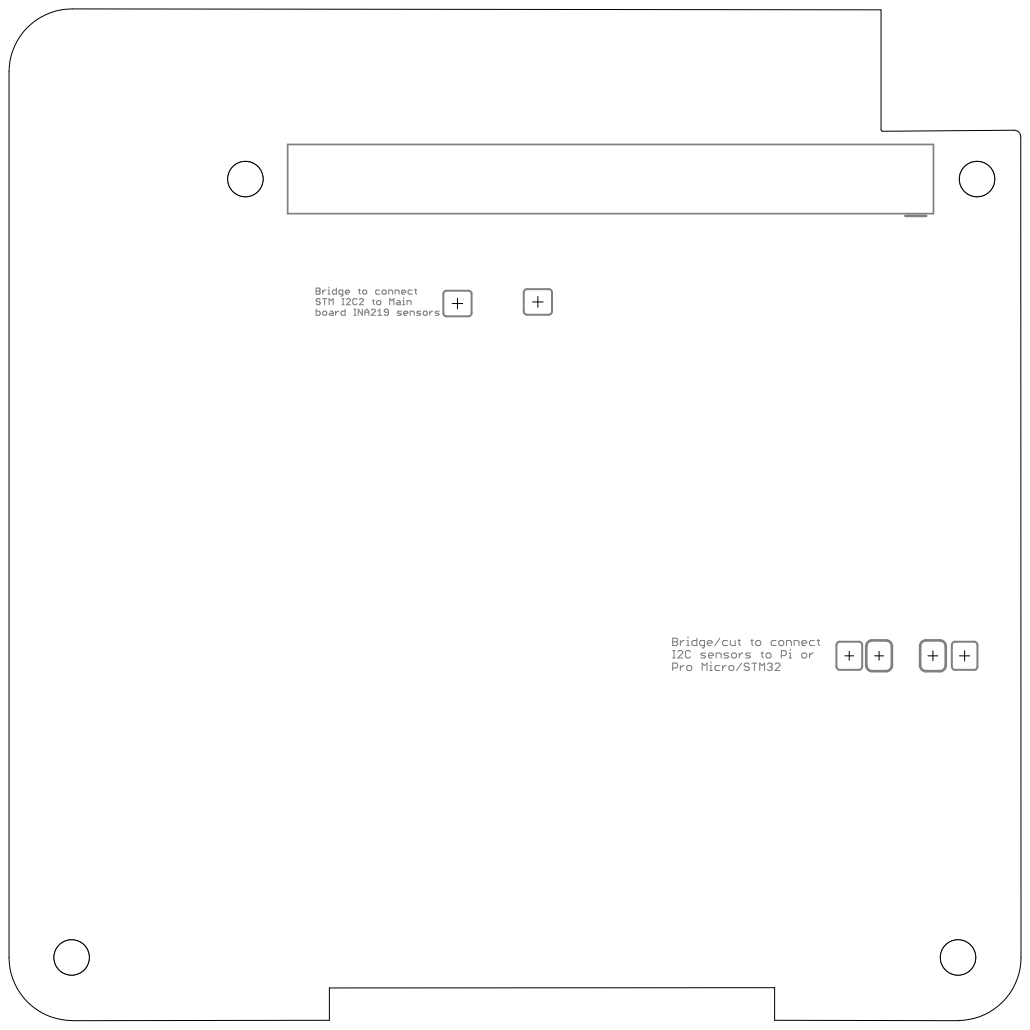
[picture p105: page 1]
