alanbjohnston/CubeSatSim/hardware/v1.1/cubesatsim-STEM-1.1a_tnames.pdf

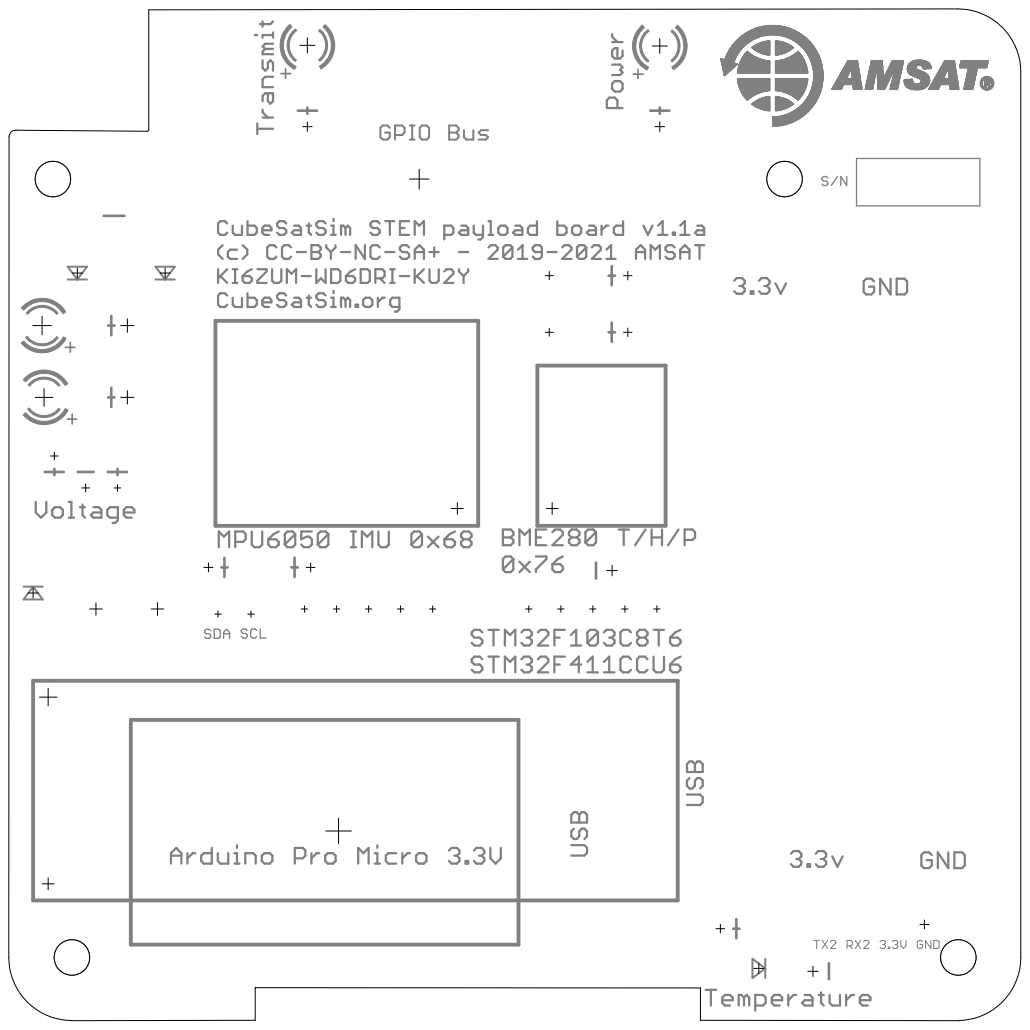
[picture p106: page 1]
