alanbjohnston/CubeSatSim/hardware/v1.1/cubesatsim-STEM-1.1_bNames.pdf

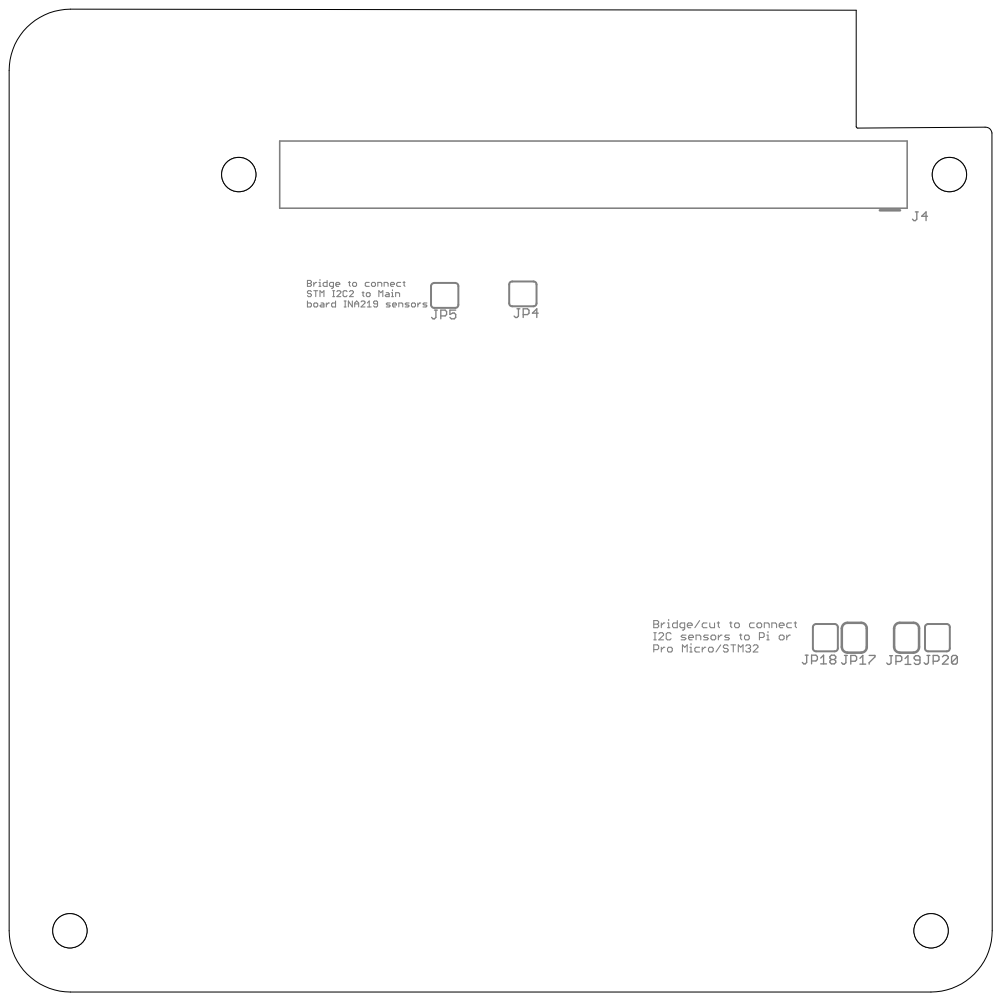
[picture p107: page 1]
