alanbjohnston/CubeSatSim/hardware/v1.1/cubesatsim-STEM-1.1_tnames.pdf

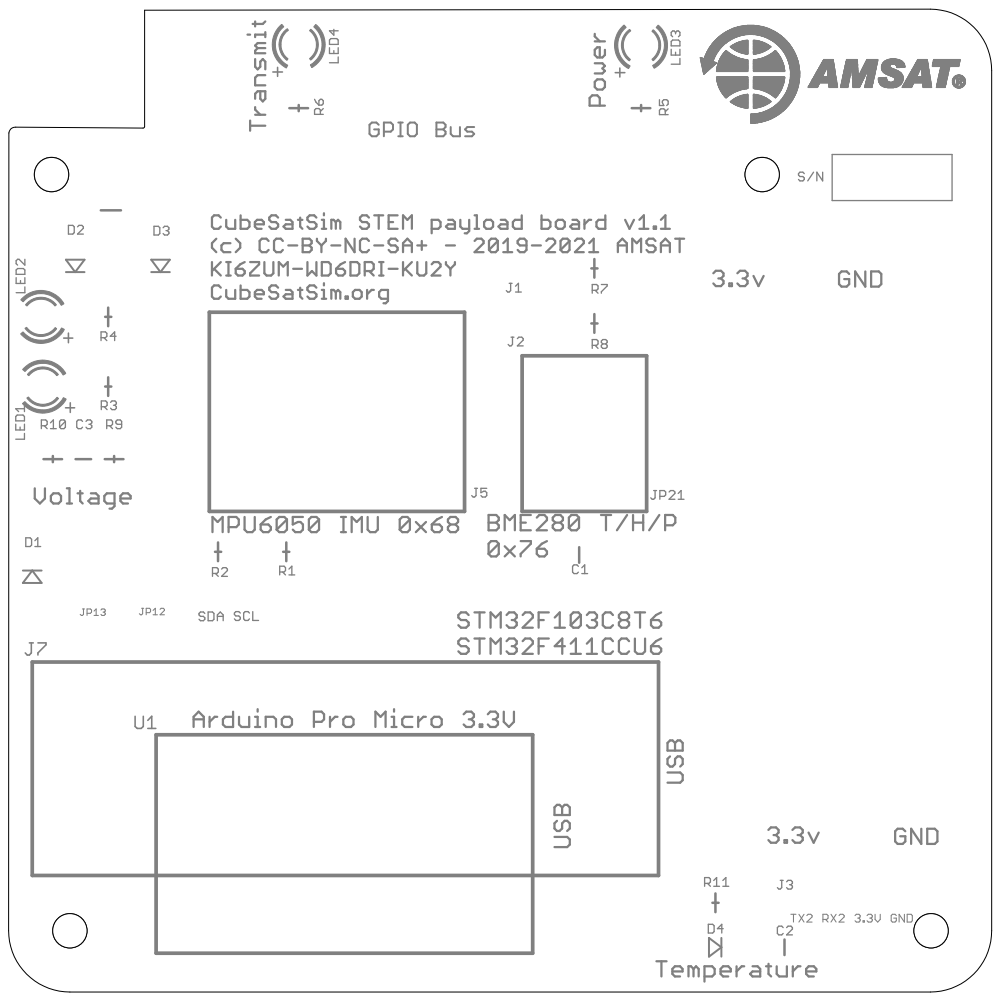
[picture p108: page 1]
