alanbjohnston/CubeSatSim/hardware/v1.1/cubesatsim-main-1.1_bnames.pdf

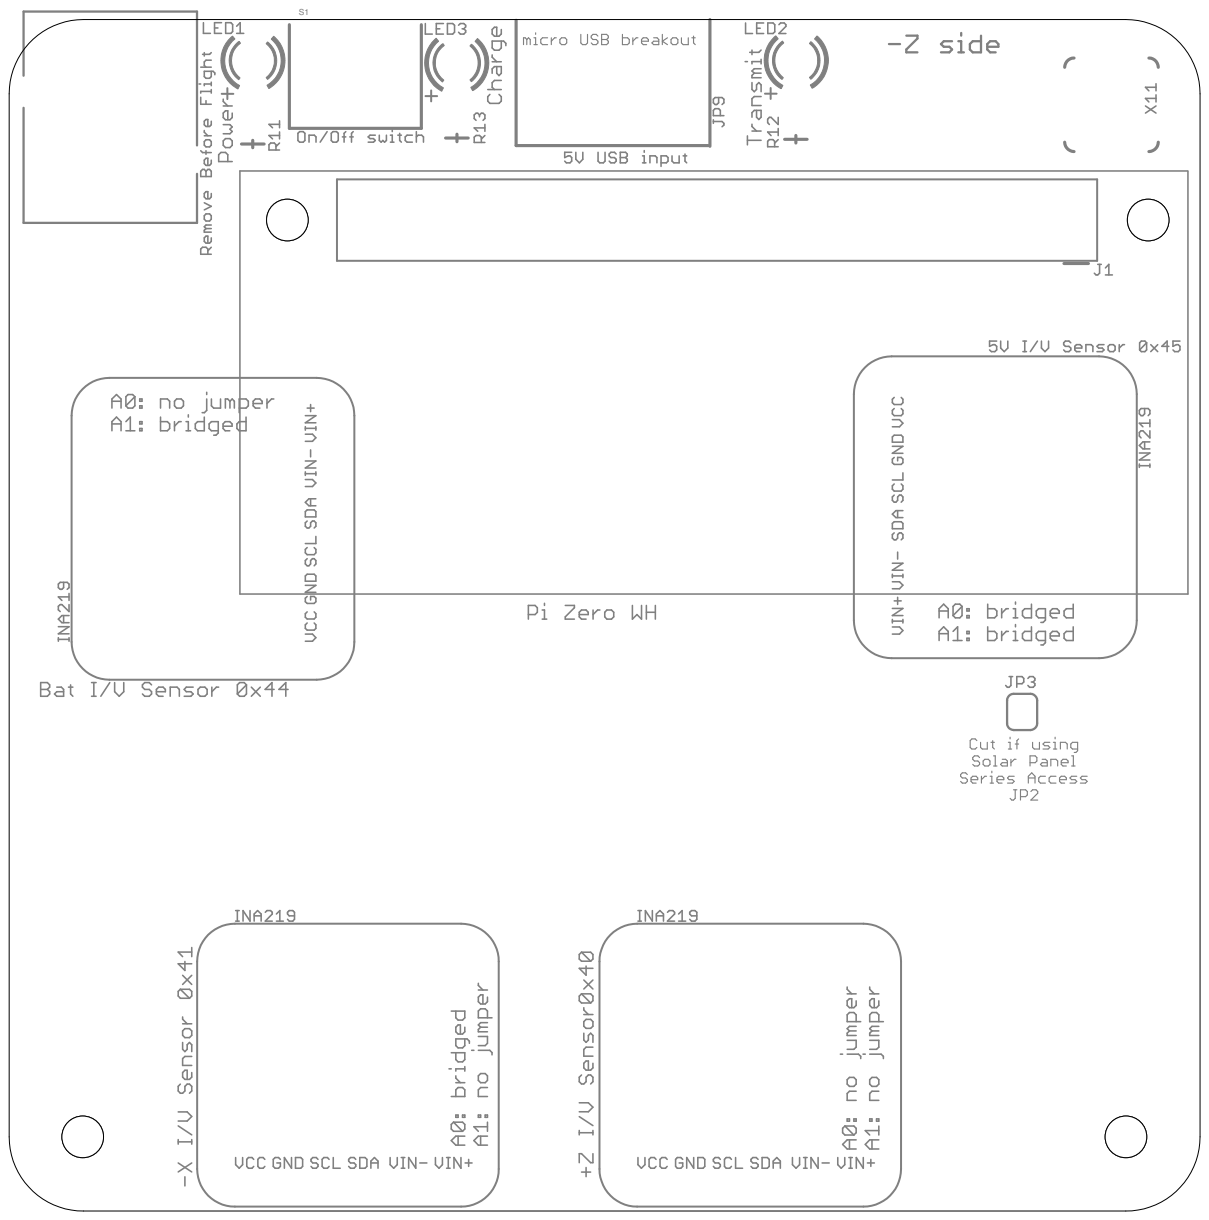
[picture p109: page 1]
