alanbjohnston/CubeSatSim/hardware/v1.1/cubesatsim-main-1.1_tnames.pdf

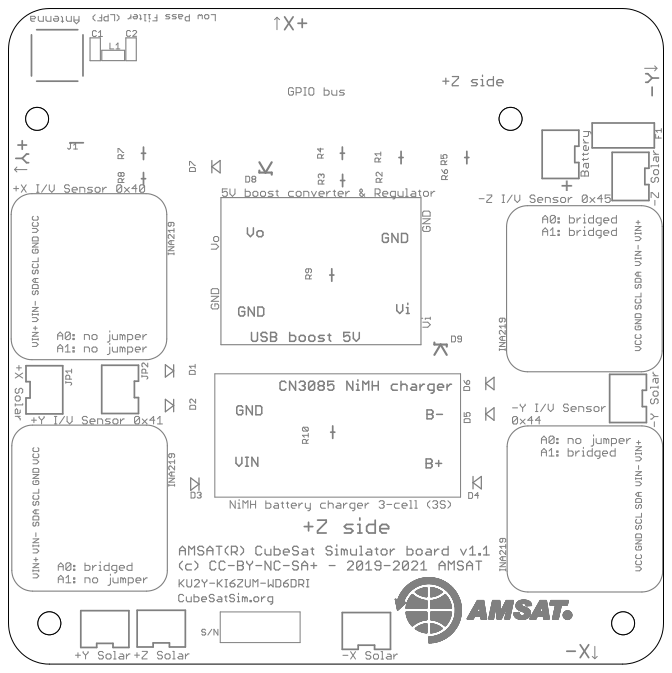
[picture p110: page 1]
