alanbjohnston/CubeSatSim/hardware/v1.0/cubesatsim-battery-1.0_bNames.pdf

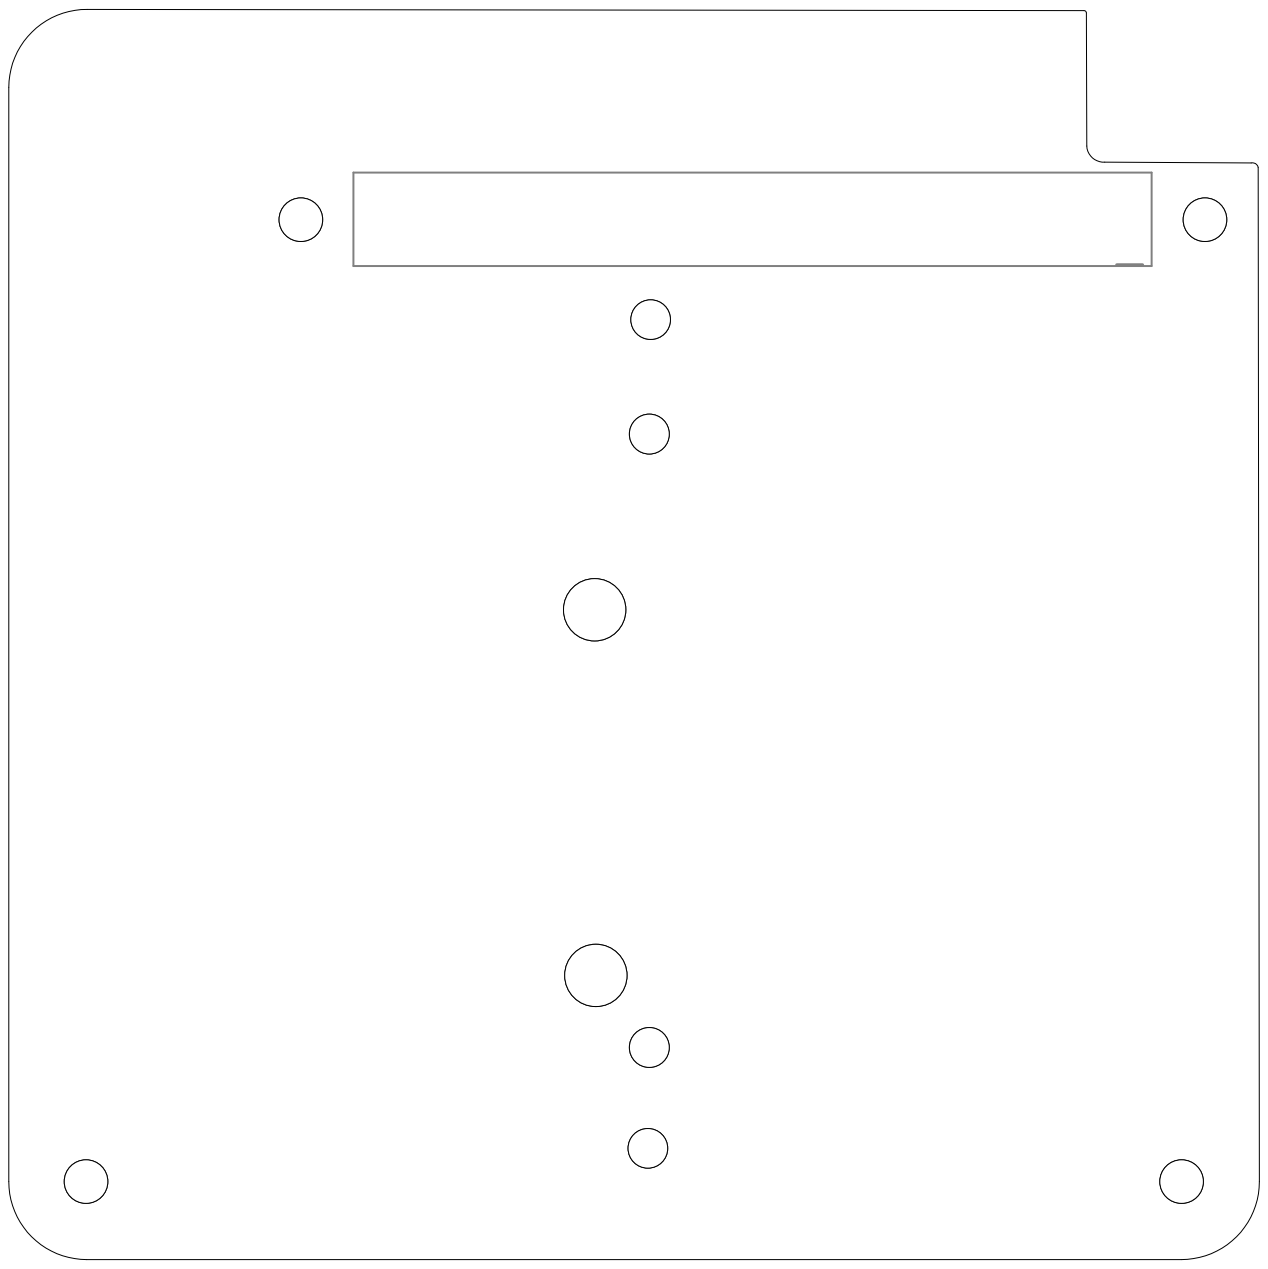
[picture p111: page 1]
