alanbjohnston/CubeSatSim/hardware/v1.0/cubesatsim-battery-1.0_tNames.pdf

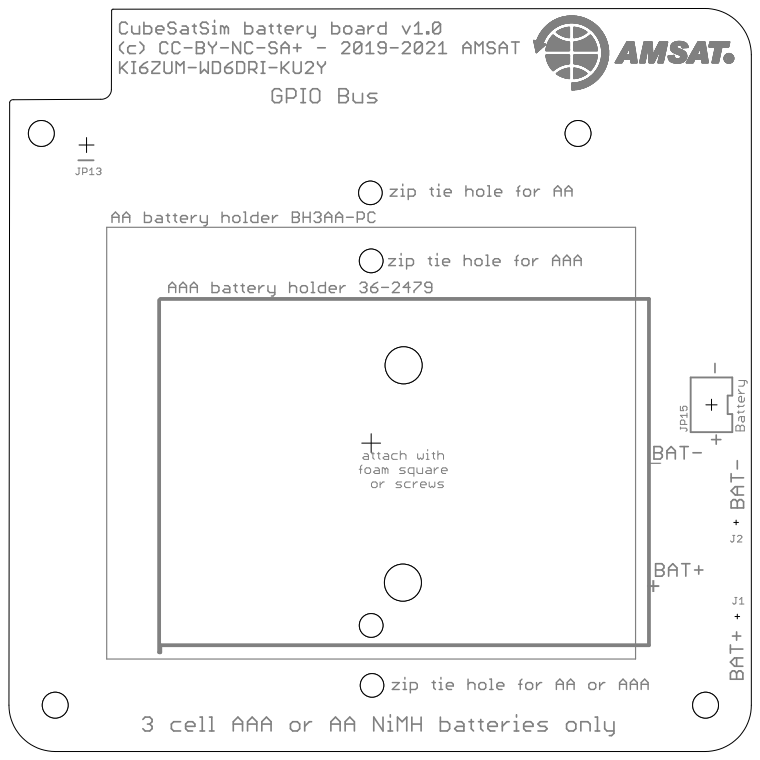
[picture p112: page 1]
