alanbjohnston/CubeSatSim/hardware/v1.0/cubesatsim-main-1.0-bottom.pdf

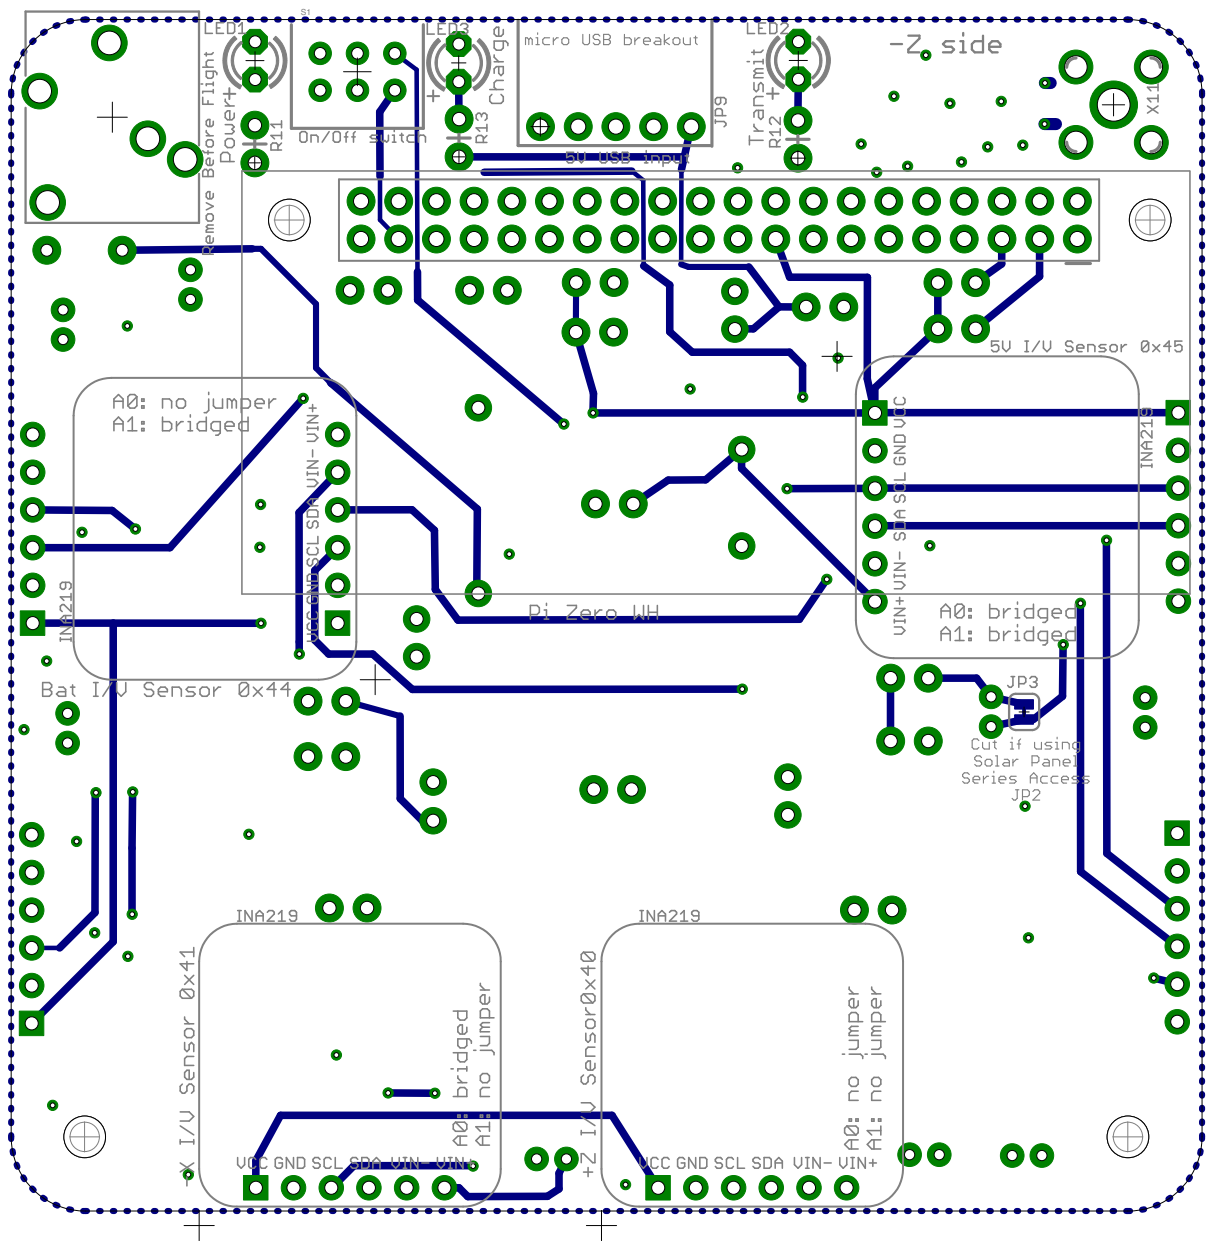
[picture p113: page 1]
