alanbjohnston/CubeSatSim/hardware/v1.0/cubesatsim-main-1.0-top.pdf

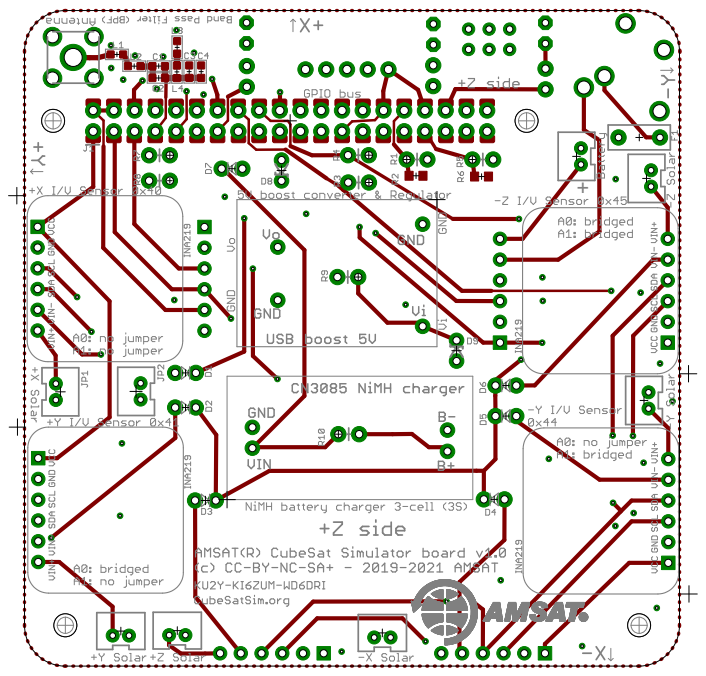
[picture p114: page 1]
