alanbjohnston/CubeSatSim/hardware/v1.0/cubesatsim-main-1.0_bNames.pdf

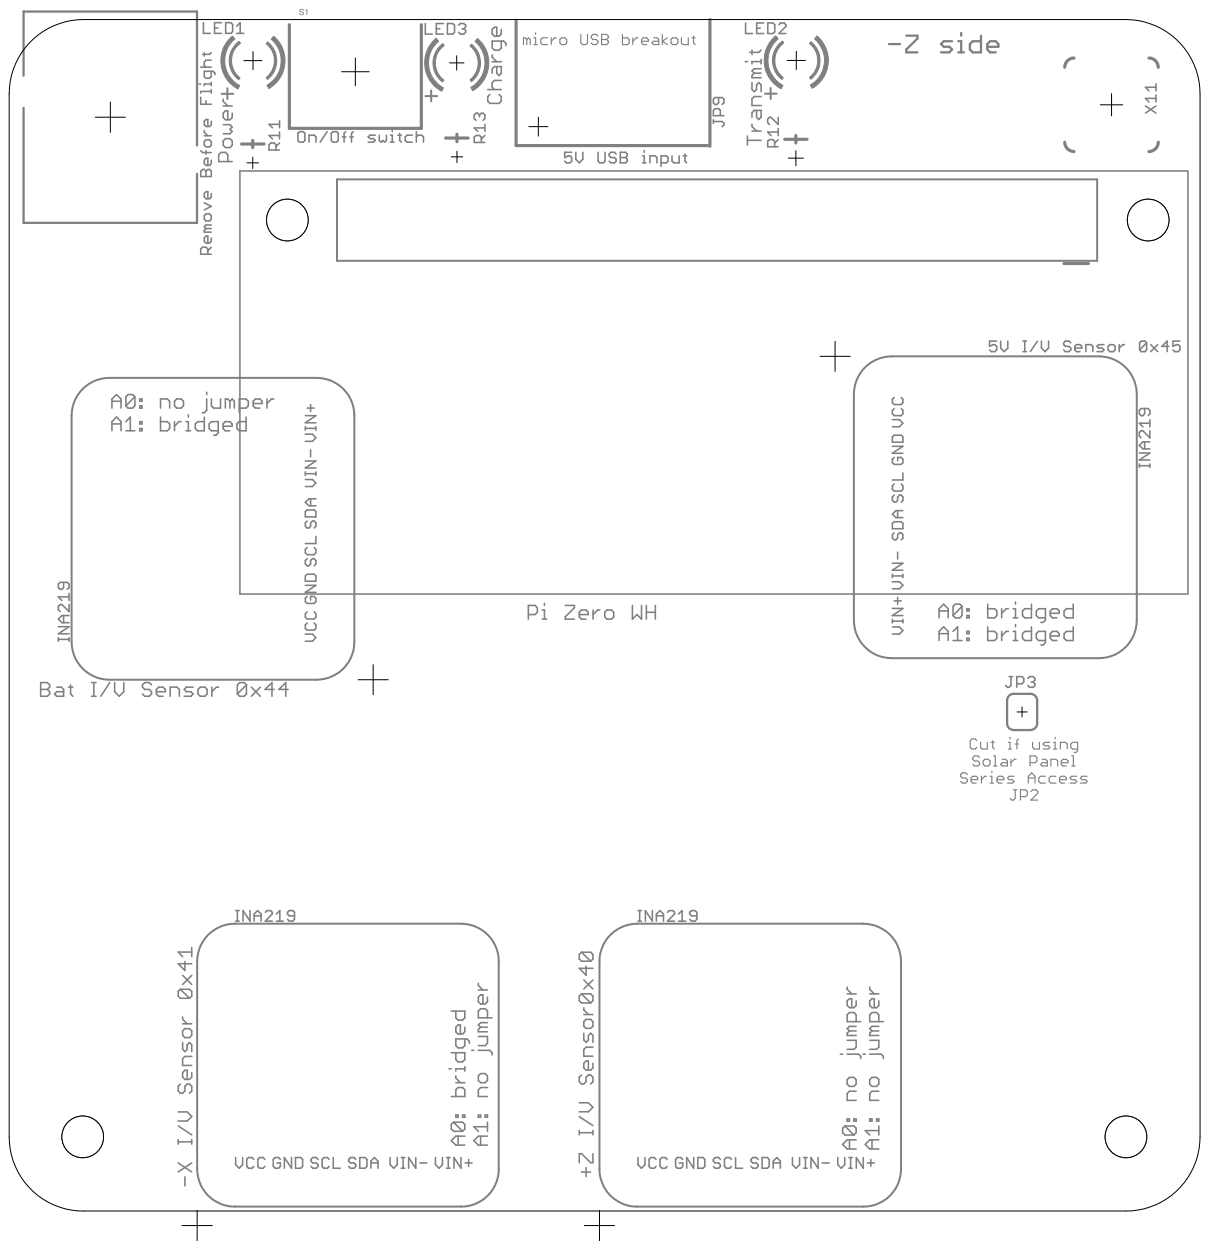
[picture p115: page 1]
