alanbjohnston/CubeSatSim/hardware/v1.0/cubesatsim-main-1.0_board.pdf

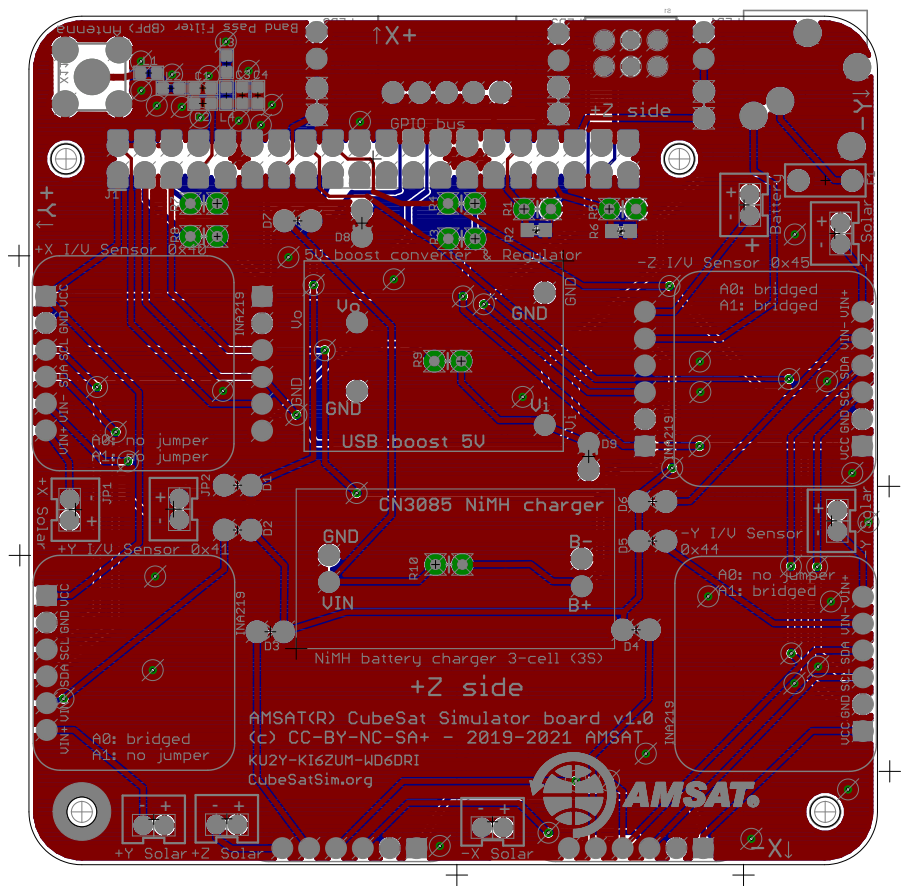
[picture p116: page 1]
