alanbjohnston/CubeSatSim/hardware/v1.0/cubesatsim-main-1.0_tNames.pdf

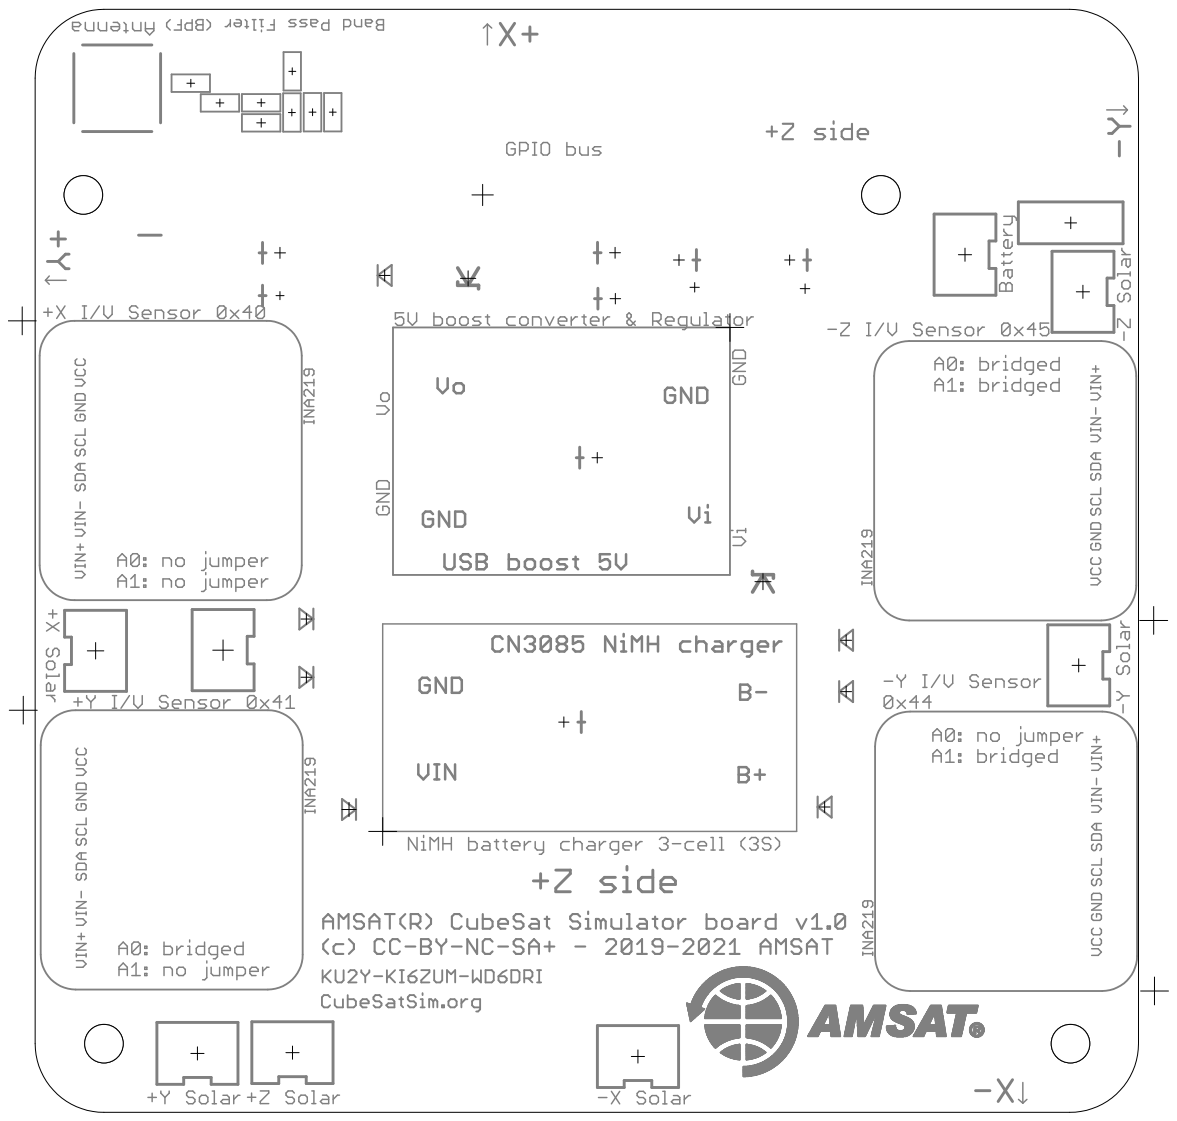
[picture p117: page 1]
