alanbjohnston/CubeSatSim/hardware/v1.0/cubesatsim-STEM-1.0_bNames.pdf

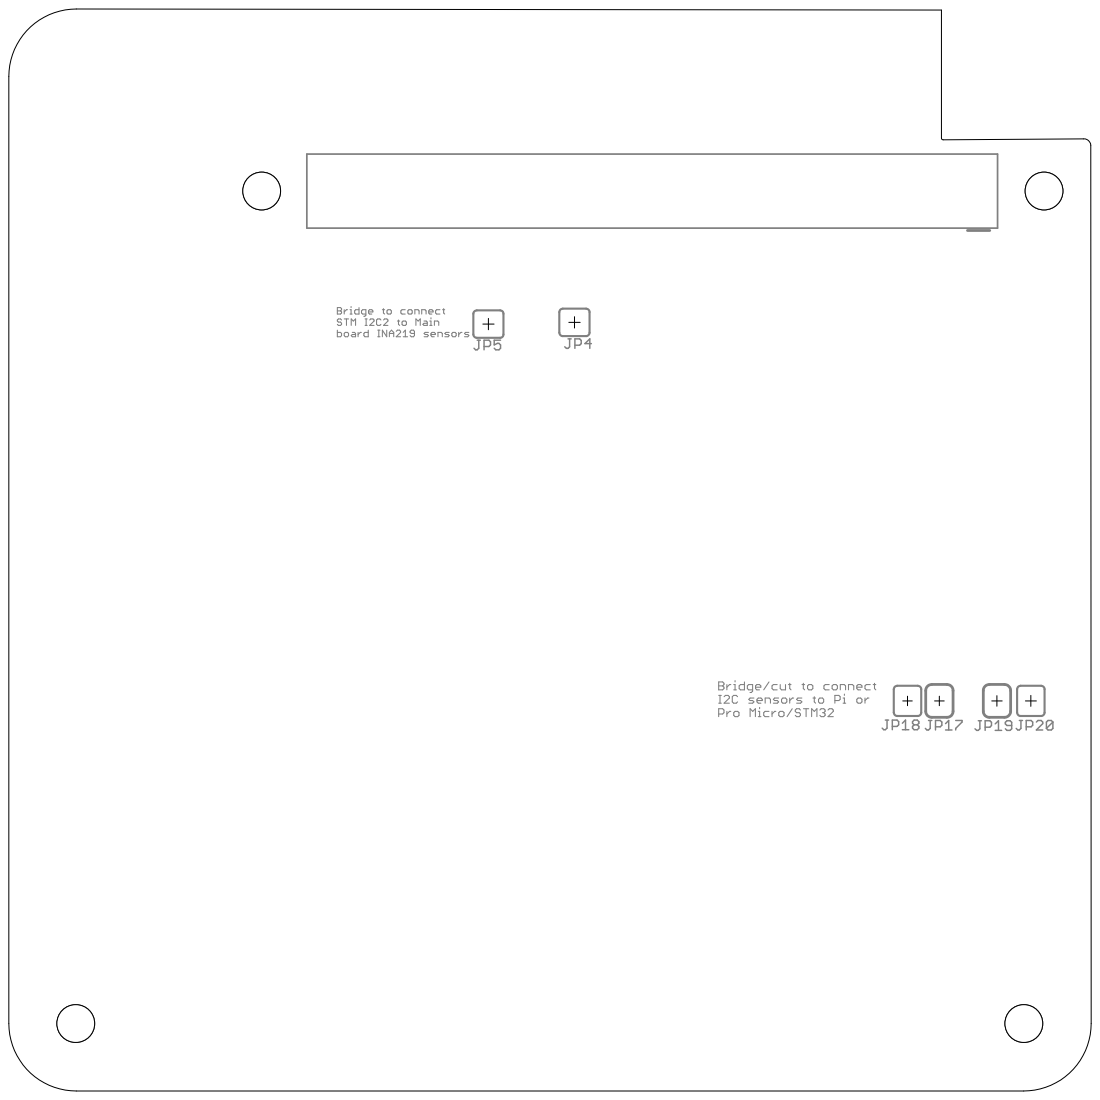
[picture p118: page 1]
