alanbjohnston/CubeSatSim/hardware/v1.0/cubesatsim-STEM-1.0_tNames.pdf

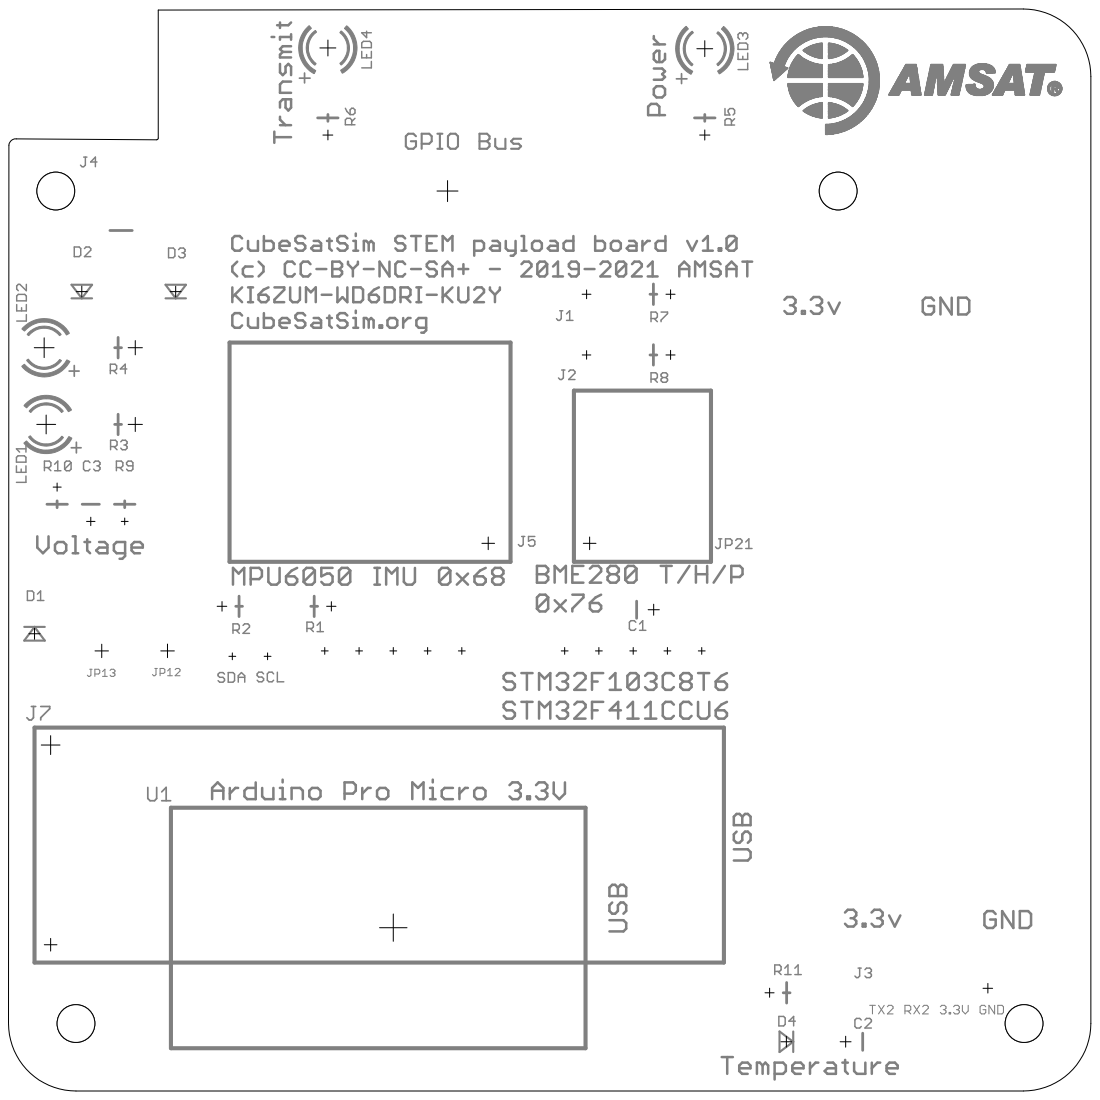
[picture p119: page 1]
