alanbjohnston/CubeSatSim/hardware/vB3/kicad/cubesatsim_solar.kicad_pcb

## KiCad design hardware/vB3/kicad/cubesatsim_solar.kicad_pcb (2019-03-25)

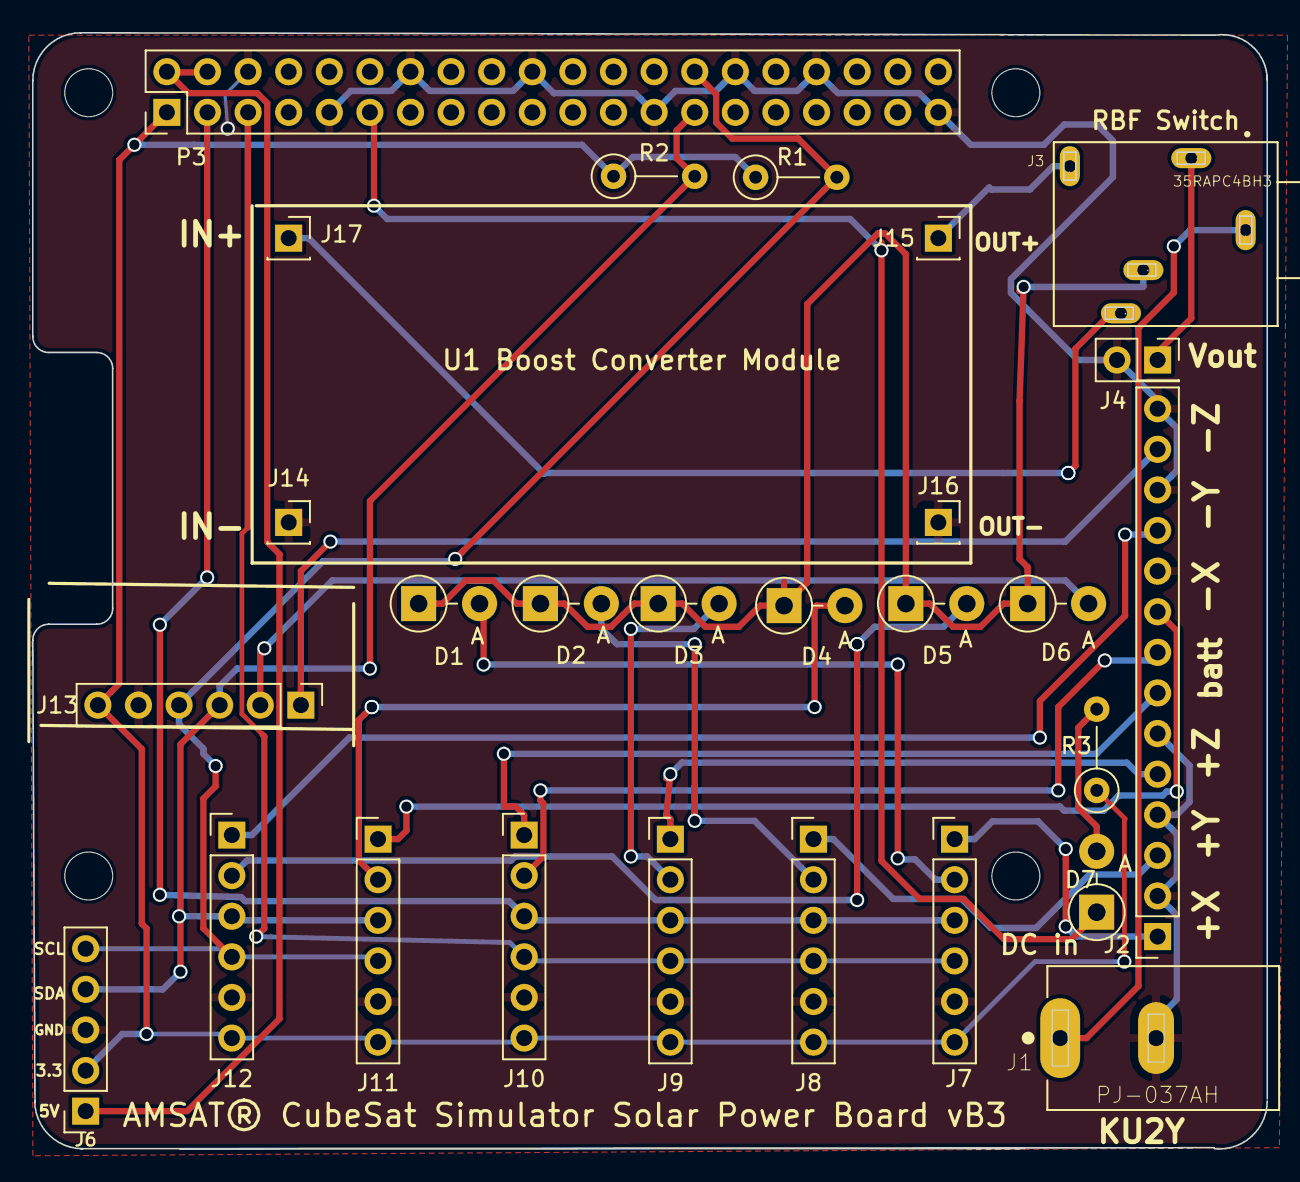
[picture p120: board cubesatsim_solar.kicad_pcb from above]

Board: 2 copper layers, 77.2 x 69.8 mm, 27 parts (0 on the bottom side), 28 nets.

Parts:
D1, D2, D3, D4, D5, D6: 1N5817; D_DO-41_SOD81_P3.81mm_Vertical_AnodeUp
D7: LED; D_DO-41_SOD81_P3.81mm_Vertical_AnodeUp
J1: PJ-037AH; CUI_PJ-037AH
J2: CONN_01X14; PinSocket_1x14_P2.54mm_Vertical
J3: 35RAPC4BH3; SWITCHCRAFT_35RAPC4BH3
J4: Vout to MoPOWER; PinSocket_2x01_P2.54mm_Vertical
J6: Expansion Interface; PinSocket_1x05_P2.54mm_Vertical
J7, J8, J9, J10, J11, J12, J13: INA219 Sensor Board; PinHeader_1x06_P2.54mm_Vertical
J14: IN-; PinSocket_1x01_P2.54mm_Vertical
J15: OUT+; PinSocket_1x01_P2.54mm_Vertical
J16: OUT-; PinSocket_1x01_P2.54mm_Vertical
J17: IN+; PinSocket_1x01_P2.54mm_Vertical
P3: GPIO Male Extra Long (19mm) 20x2 Header Pins; PinHeader_2x20_P2.54mm_Vertical
R1, R2: 4.7k; R_Axial_DIN0207_L6.3mm_D2.5mm_P5.08mm_Vertical
R3: 220; R_Axial_DIN0207_L6.3mm_D2.5mm_P5.08mm_Vertical

Connections:
+3V3: J6.2, J7.6, J8.6, J9.6, J10.6, J11.6, J12.6, J13.6, P3.1, R1.1, R2.1, R3.1
+5V: J6.1, P3.2, P3.4
+X_In: J2.1, J7.1
+X_Out: D1.2, J7.2
+Y_In: J2.3, J8.1
+Y_Out: D2.2, J8.2
+Z_In: J2.5, J9.1
+Z_Out: D3.2, J9.2
-X_In: J2.9, J11.1
-X_Out: D4.2, J11.2
-Y_In: J2.11, J12.1
-Y_Out: D5.2, J12.2
-Z_In: J2.13, J13.1
-Z_Out: D6.2, J13.2
GND: J1.2, J2.2, J2.4, J2.6, J2.10, J2.12, J2.14, J4.2, J6.3, J7.5, J8.5, J9.5, J10.5, J11.5, J12.5, J13.5, J14.1, J16.1, P3.6, P3.9, P3.14, P3.20, P3.25, P3.30, P3.34, P3.39
unnamed: D1.1, D2.1, D3.1, D4.1, D5.1, D6.1, J3.3
unnamed: D7.1, P3.11
unnamed: D7.2, R3.2
unnamed: J1.1, J3.1
unnamed: J3.5, J4.1
unnamed: J3.4, J15.1
unnamed: J3.2, J17.1
SCL_1: J7.4, J8.4, J9.4, J10.4, P3.5
SCL_3: J6.5, J11.4, J12.4, J13.4, P3.28, R1.2
SDA_1: J7.3, J8.3, J9.3, J10.3, P3.3
SDA_3: J6.4, J11.3, J12.3, J13.3, P3.27, R2.2
VbattIn: J2.7, J10.1
VbattOut: J2.8, J10.2
