alanbjohnston/CubeSatSim/frequency.py

#!/usr/bin/env python

#import subprocess
import time
from time import sleep
#import os
import sys
from os import system

def check_frequency():

	global tx_doppler_freq_hz
	global rx_doppler_freq_hz
	tx_OK = False
	rx_OK = False

	if tx_doppler_freq_hz > 450000000:
		tx_doppler_freq_hz = 435200000
	elif (tx_doppler_freq_hz < 420000000) and (tx_doppler_freq_hz > 148000000):
		tx_doppler_freq_hz = 434700000
	elif (tx_doppler_freq_hz < 144000000):
		tx_doppler_freq_hz = 434600000
	else:
		tx_OK = True

	if rx_doppler_freq_hz > 450000000:
		rx_doppler_freq_hz = 435200000
	elif (rx_doppler_freq_hz < 420000000) and (rx_doppler_freq_hz > 148000000):
		rx_doppler_freq_hz = 434700000
	elif (rx_doppler_freq_hz < 144000000):
		rx_doppler_freq_hz = 434600000
	else:
		rx_OK = True

	if (tx_OK != True) or (rx_OK != True):
		print("Error - frequency out of range!")

iss_doppler_passes = {
	88: [
	{"time_sec": 1, "doppler_434_khz": 9987, "doppler_144_khz": 3329},
	{"time_sec": 2, "doppler_434_khz": 9987, "doppler_144_khz": 3329},
	{"time_sec": 3, "doppler_434_khz": 9987, "doppler_144_khz": 3329},
	{"time_sec": 4, "doppler_434_khz": 9987, "doppler_144_khz": 3329},
	{"time_sec": 5, "doppler_434_khz": 9987, "doppler_144_khz": 3329},
	{"time_sec": 6, "doppler_434_khz": 9987, "doppler_144_khz": 3329},
	{"time_sec": 7, "doppler_434_khz": 9987, "doppler_144_khz": 3329},
	{"time_sec": 8, "doppler_434_khz": 9987, "doppler_144_khz": 3329},
	{"time_sec": 9, "doppler_434_khz": 9987, "doppler_144_khz": 3329},
	{"time_sec": 10, "doppler_434_khz": 9987, "doppler_144_khz": 3329},
	{"time_sec": 11, "doppler_434_khz": 9987, "doppler_144_khz": 3329},
	{"time_sec": 12, "doppler_434_khz": 9986, "doppler_144_khz": 3329},
	{"time_sec": 13, "doppler_434_khz": 9986, "doppler_144_khz": 3329},
	{"time_sec": 14, "doppler_434_khz": 9986, "doppler_144_khz": 3329},
	{"time_sec": 15, "doppler_434_khz": 9986, "doppler_144_khz": 3329},
	{"time_sec": 16, "doppler_434_khz": 9986, "doppler_144_khz": 3329},
	{"time_sec": 17, "doppler_434_khz": 9985, "doppler_144_khz": 3328},
	{"time_sec": 18, "doppler_434_khz": 9985, "doppler_144_khz": 3328},
	{"time_sec": 19, "doppler_434_khz": 9985, "doppler_144_khz": 3328},
	{"time_sec": 20, "doppler_434_khz": 9985, "doppler_144_khz": 3328},
	{"time_sec": 21, "doppler_434_khz": 9984, "doppler_144_khz": 3328},
	{"time_sec": 22, "doppler_434_khz": 9984, "doppler_144_khz": 3328},
	{"time_sec": 23, "doppler_434_khz": 9984, "doppler_144_khz": 3328},
	{"time_sec": 24, "doppler_434_khz": 9984, "doppler_144_khz": 3328},
	{"time_sec": 25, "doppler_434_khz": 9983, "doppler_144_khz": 3328},
	{"time_sec": 26, "doppler_434_khz": 9983, "doppler_144_khz": 3328},
	{"time_sec": 27, "doppler_434_khz": 9983, "doppler_144_khz": 3328},
	{"time_sec": 28, "doppler_434_khz": 9982, "doppler_144_khz": 3327},
	{"time_sec": 29, "doppler_434_khz": 9982, "doppler_144_khz": 3327},
	{"time_sec": 30, "doppler_434_khz": 9982, "doppler_144_khz": 3327},
	{"time_sec": 31, "doppler_434_khz": 9981, "doppler_144_khz": 3327},
	{"time_sec": 32, "doppler_434_khz": 9981, "doppler_144_khz": 3327},
	{"time_sec": 33, "doppler_434_khz": 9980, "doppler_144_khz": 3327},
	{"time_sec": 34, "doppler_434_khz": 9980, "doppler_144_khz": 3327},
	{"time_sec": 35, "doppler_434_khz": 9979, "doppler_144_khz": 3326},
	{"time_sec": 36, "doppler_434_khz": 9979, "doppler_144_khz": 3326},
	{"time_sec": 37, "doppler_434_khz": 9978, "doppler_144_khz": 3326},
	{"time_sec": 38, "doppler_434_khz": 9978, "doppler_144_khz": 3326},
	{"time_sec": 39, "doppler_434_khz": 9977, "doppler_144_khz": 3326},
	{"time_sec": 40, "doppler_434_khz": 9977, "doppler_144_khz": 3326},
	{"time_sec": 41, "doppler_434_khz": 9976, "doppler_144_khz": 3325},
	{"time_sec": 42, "doppler_434_khz": 9975, "doppler_144_khz": 3325},
	{"time_sec": 43, "doppler_434_khz": 9975, "doppler_144_khz": 3325},
	{"time_sec": 44, "doppler_434_khz": 9974, "doppler_144_khz": 3325},
	{"time_sec": 45, "doppler_434_khz": 9973, "doppler_144_khz": 3324},
	{"time_sec": 46, "doppler_434_khz": 9973, "doppler_144_khz": 3324},
	{"time_sec": 47, "doppler_434_khz": 9972, "doppler_144_khz": 3324},
	{"time_sec": 48, "doppler_434_khz": 9972, "doppler_144_khz": 3324},
	{"time_sec": 49, "doppler_434_khz": 9971, "doppler_144_khz": 3324},
	{"time_sec": 50, "doppler_434_khz": 9970, "doppler_144_khz": 3323},
	{"time_sec": 51, "doppler_434_khz": 9969, "doppler_144_khz": 3323},
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
	{"time_sec": 612, "doppler_434_khz": -9973, "doppler_144_khz": -3324},
	{"time_sec": 613, "doppler_434_khz": -9974, "doppler_144_khz": -3324},
	{"time_sec": 614, "doppler_434_khz": -9974, "doppler_144_khz": -3324},
	{"time_sec": 615, "doppler_434_khz": -9975, "doppler_144_khz": -3324},
	{"time_sec": 616, "doppler_434_khz": -9976, "doppler_144_khz": -3325},
	{"time_sec": 617, "doppler_434_khz": -9976, "doppler_144_khz": -3325},
	{"time_sec": 618, "doppler_434_khz": -9977, "doppler_144_khz": -3325},
	{"time_sec": 619, "doppler_434_khz": -9978, "doppler_144_khz": -3325},
	{"time_sec": 620, "doppler_434_khz": -9978, "doppler_144_khz": -3325},
	{"time_sec": 621, "doppler_434_khz": -9979, "doppler_144_khz": -3326},
	{"time_sec": 622, "doppler_434_khz": -9979, "doppler_144_khz": -3326},
	{"time_sec": 623, "doppler_434_khz": -9980, "doppler_144_khz": -3326},
	{"time_sec": 624, "doppler_434_khz": -9981, "doppler_144_khz": -3326},
	{"time_sec": 625, "doppler_434_khz": -9981, "doppler_144_khz": -3326},
	{"time_sec": 626, "doppler_434_khz": -9982, "doppler_144_khz": -3327},
	{"time_sec": 627, "doppler_434_khz": -9982, "doppler_144_khz": -3327},
	{"time_sec": 628, "doppler_434_khz": -9983, "doppler_144_khz": -3327},
	{"time_sec": 629, "doppler_434_khz": -9983, "doppler_144_khz": -3327},
	{"time_sec": 630, "doppler_434_khz": -9984, "doppler_144_khz": -3327},
	{"time_sec": 631, "doppler_434_khz": -9984, "doppler_144_khz": -3327},
	{"time_sec": 632, "doppler_434_khz": -9985, "doppler_144_khz": -3328},
	{"time_sec": 633, "doppler_434_khz": -9985, "doppler_144_khz": -3328},
	{"time_sec": 634, "doppler_434_khz": -9985, "doppler_144_khz": -3328},
	{"time_sec": 635, "doppler_434_khz": -9986, "doppler_144_khz": -3328},
	{"time_sec": 636, "doppler_434_khz": -9986, "doppler_144_khz": -3328},
	{"time_sec": 637, "doppler_434_khz": -9986, "doppler_144_khz": -3328},
	{"time_sec": 638, "doppler_434_khz": -9987, "doppler_144_khz": -3328},
	{"time_sec": 639, "doppler_434_khz": -9987, "doppler_144_khz": -3328},
	{"time_sec": 640, "doppler_434_khz": -9987, "doppler_144_khz": -3328},
	{"time_sec": 641, "doppler_434_khz": -9988, "doppler_144_khz": -3329},
	{"time_sec": 642, "doppler_434_khz": -9988, "doppler_144_khz": -3329},
	{"time_sec": 643, "doppler_434_khz": -9988, "doppler_144_khz": -3329},
	{"time_sec": 644, "doppler_434_khz": -9988, "doppler_144_khz": -3329},
	{"time_sec": 645, "doppler_434_khz": -9988, "doppler_144_khz": -3329},
	{"time_sec": 646, "doppler_434_khz": -9989, "doppler_144_khz": -3329},
	{"time_sec": 647, "doppler_434_khz": -9989, "doppler_144_khz": -3329},
	{"time_sec": 648, "doppler_434_khz": -9989, "doppler_144_khz": -3329},
	{"time_sec": 649, "doppler_434_khz": -9989, "doppler_144_khz": -3329},
	{"time_sec": 650, "doppler_434_khz": -9990, "doppler_144_khz": -3329},
	{"time_sec": 651, "doppler_434_khz": -9990, "doppler_144_khz": -3329},
	{"time_sec": 652, "doppler_434_khz": -9990, "doppler_144_khz": -3329},
	{"time_sec": 653, "doppler_434_khz": -9990, "doppler_144_khz": -3329},
	{"time_sec": 654, "doppler_434_khz": -9990, "doppler_144_khz": -3329},
	{"time_sec": 655, "doppler_434_khz": -9990, "doppler_144_khz": -3329},
	{"time_sec": 656, "doppler_434_khz": -9990, "doppler_144_khz": -3329},
	{"time_sec": 657, "doppler_434_khz": -9990, "doppler_144_khz": -3329},
	{"time_sec": 658, "doppler_434_khz": -9990, "doppler_144_khz": -3329},
	{"time_sec": 659, "doppler_434_khz": -9990, "doppler_144_khz": -3329},
	{"time_sec": 660, "doppler_434_khz": -9990, "doppler_144_khz": -3329},
	{"time_sec": 661, "doppler_434_khz": -9990, "doppler_144_khz": -3329}
	]			
}

print("CubeSatSim v2.2 frequency.py starting...")
try:	
	tx_value = '0'
	rx_value = '0'
	sq = '0'
	tx = '434.9000'	
	rx = '435.0000'
	txr = '144.9000'
	sim_mode = False
	sim_config = False
	doppler_mode = "off"
	debug_mode = True

	try:
		file = open("/home/pi/CubeSatSim/.mode")
		mode = file.read(1)
	except:
		mode = 'f'
		if (debug_mode == 1):
			print("Can't open .mode file, defaulting to FSK")
	file.close()
	print("Mode is: ")
	print(mode)
	
	try:
		file = open("/home/pi/CubeSatSim/sim.cfg")
		config = file.readline().split()		
		if len(config) > 6:
			txf = float(config[6])
			tx = "{:.4f}".format(txf)
######			
			if (mode == 'e'):
				txrf = (txf - 290.0) # - 0.1 # Cross Band Repeater mode transmit frequency in 2m band
				txr = "{:.4f}".format(txrf)
				print("Transmit frequency: ",txr)
			else:
				print("Transmit frequency: ",tx)
######			
			print("Transmit frequency: ",tx)
		if len(config) > 7:
			rxf = float(config[7])
			rx = "{:.4f}".format(rxf)
			print(rx)
		if len(config) > 9:
			rxpl = float(config[9])
#                       print(rxpl)
#                       print( "{:.0f}".format(rxpl))
			rxpl_value = "{:.0f}".format(rxpl)
			print(rxpl_value)
		if len(config) > 10:
			txpl = float(config[10])
#                        print(txpl)
#                        print( "{:.0f}".format(txpl))
			txpl_value = "{:.0f}".format(txpl)
			print(txpl_value)
		if len(config) > 13:
			if config[13] == 'sim':		
				doppler_mode = 'sim'
				print("Simulated Doppler frequency shift is enabled.")				
			elif config[13] == 'rig':	
				doppler_mode = 'rig'
				print("rigctl Doppler frequency shift is enabled.")	
			else:
				doppler_mode = 'off'
				print("Doppler frequency shift is disabled.")	
		else:
			doppler_mode = 'off'
			print("Doppler frequency shift is disabled.")	
		print(config)
		print
#		print(callsign)
		print(sq)
#		if sq == '8':
#			print("squelch set to 8, no command input!")
#			no_command = True
#		else:
		no_command = False		
		print(no_command)
	except Exception as e:
		print(f"An error occurred: {e}")		
		if (debug_mode == 1):
			print("Can't read sim.cfg file")	
	file.close()
		  
except Exception as e:
	print(f"An error occurred: {e}")	

if (doppler_mode == 'off'):
  tx_freq_hz = txf * 1e6
  rx_freq_hz = rxf * 1e6
#  check_frequency()	
  print("writing sim.cfg frequency to freq.txt")	
  with open("/home/pi/CubeSatSim/freq.txt", "w") as file:
      file.write(f"{tx_freq_hz:.0f} {rx_freq_hz:.0f}")
  while True:
    sleep(1)
        
if (doppler_mode == 'sim'):
  print("Sim mode")
#####	
  if (mode == 'e'):
    tx_doppler_start_hz = txrf * 1e6
  else:
    tx_doppler_start_hz = txf * 1e6
#####	
#  tx_doppler_start_hz = txf * 1e6	  
  tx_doppler_shift_hz = 0
  print(f"Tx center frequency: {tx_doppler_start_hz}")
  rx_doppler_start_hz = rxf * 1e6
  rx_doppler_shift_hz = 0
  print(f"Rx center frequency: {rx_doppler_start_hz}")
	
  TARGET_PASS = 88           # Maximum elevation profile
  doppler_table = iss_doppler_passes[TARGET_PASS]
  print(f"Pass Max Elevation: {TARGET_PASS}°")
	
  start_time = time.perf_counter() 
  current_index = 0;
  while True:
    relative_time = (time.perf_counter() - start_time) 
#    index = int(relative_time/10) % 37
    index = int(relative_time) 	  
    if (index > current_index):
      current_index = index
      index = index % 661		
      print(f"relative time: {relative_time:.1f} seconds after start is AOS index: {index}")
      table_row = doppler_table[index]
      rx_doppler_shift_hz = table_row["doppler_434_khz"] # * 1000
      if (mode == 'e'):
        tx_doppler_shift_hz = table_row["doppler_144_khz"] # * 1000
      else:
        tx_doppler_shift_hz = rx_doppler_shift_hz 
      tx_doppler_freq_hz = tx_doppler_start_hz + tx_doppler_shift_hz
      rx_doppler_freq_hz = rx_doppler_start_hz + rx_doppler_shift_hz
      check_frequency()	
      print(f"Tx Doppler shift: {tx_doppler_freq_hz:.0f}")		
      print(f"Rx Doppler shift: {rx_doppler_freq_hz:.0f}")

      with open("/home/pi/CubeSatSim/freq.txt", "w") as file:
        file.write(f"{tx_doppler_freq_hz:.0f} {rx_doppler_freq_hz:.0f}")
    sleep(1)

if (doppler_mode == 'rig'):
  print("rig mode")
  while True:

    system("rm /tmp/vttyA")
    system("rm /tmp/vttyB")
    system("sudo killall -9 ft857d &>/dev/null")
    system("pkill socat &>/dev/null")
    system("sudo killall -9 rigctld &>/dev/null")

    sleep(5.0)  

    print("Starting virtual serial ports /tmp/vttyA and /tmp/vttyB")

    system("socat -d -d PTY,raw,echo=0,link=/tmp/vttyA PTY,raw,echo=0,link=/tmp/vttyB &")

    sleep(2.0)

    print("Starting CubeSatSim FT857 emulation")
    system("/home/pi/FT857d/examples/FT857d/ft857d &")

    sleep(2.0)

    print("Starting rigctl emulating FT857 rig using virtual serial port /tmp/vttyB")
    system("rigctld -m 1022 -r /tmp/vttyB -t 4532 -vvv")

    print("rigctld ended")
