alanbjohnston/CubeSatSim/TelemEncoding.h

/*
 * TelemEncoding.h
 *
 *  Created on: Feb 3, 2014
 *      Author: fox
 */

#ifndef TELEMENCODING_H_
#define TELEMENCODING_H_

void update_rs(
   unsigned char parity[32], // 32-byte encoder state; zero before each frame
   unsigned char c          // Current data byte to update
);

#define CHARACTER_BITS 10
#define CHARACTERS_PER_LONGWORD 3
#define CHARACTER_MASK ((1<<CHARACTER_BITS)-1)
#define SYNC_CHARACTER -1


#define PARITY_BYTES_PER_CODEWORD 32U     // Number of parity symbols in frame
#define NP 32U //For Phil's code
#define DATA_BYTES_PER_CODE_WORD 223

#endif /* TELEMENCODING_H_ */

int Encode_8b10b[][256] = {
		   // RD = -1 cases
		{
		   /* 00 */ 0x274,
		   /* 01 */ 0x1d4,
		   /* 02 */ 0x2d4,
		   /* 03 */ 0x71b,
		   /* 04 */ 0x354,
		   /* 05 */ 0x69b,
		   /* 06 */ 0x59b,
		   /* 07 */ 0x78b,
		   /* 08 */ 0x394,
		   /* 09 */ 0x65b,
		   /* 0a */ 0x55b,
		   /* 0b */ 0x74b,
		   /* 0c */ 0x4db,
		   /* 0d */ 0x6cb,
		   /* 0e */ 0x5cb,
		   /* 0f */ 0x174,
		   /* 10 */ 0x1b4,
		   /* 11 */ 0x63b,
		   /* 12 */ 0x53b,
		   /* 13 */ 0x72b,
		   /* 14 */ 0x4bb,
		   /* 15 */ 0x6ab,
		   /* 16 */ 0x5ab,
		   /* 17 */ 0x3a4,
		   /* 18 */ 0x334,
		   /* 19 */ 0x66b,
		   /* 1a */ 0x56b,
		   /* 1b */ 0x364,
		   /* 1c */ 0x4eb,
		   /* 1d */ 0x2e4,
		   /* 1e */ 0x1e4,
		   /* 1f */ 0x2b4,
		   /* 20 */ 0x679,
		   /* 21 */ 0x5d9,
		   /* 22 */ 0x6d9,
		   /* 23 */ 0x319,
		   /* 24 */ 0x759,
		   /* 25 */ 0x299,
		   /* 26 */ 0x199,
		   /* 27 */ 0x389,
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
		   /* aa */ 0x15a,
		   /* ab */ 0x34a,
		   /* ac */ 0x0da,
		   /* ad */ 0x2ca,
		   /* ae */ 0x1ca,
		   /* af */ 0x57a,
		   /* b0 */ 0x5ba,
		   /* b1 */ 0x23a,
		   /* b2 */ 0x13a,
		   /* b3 */ 0x32a,
		   /* b4 */ 0x0ba,
		   /* b5 */ 0x2aa,
		   /* b6 */ 0x1aa,
		   /* b7 */ 0x7aa,
		   /* b8 */ 0x73a,
		   /* b9 */ 0x26a,
		   /* ba */ 0x16a,
		   /* bb */ 0x76a,
		   /* bc */ 0x0ea,
		   /* bd */ 0x6ea,
		   /* be */ 0x5ea,
		   /* bf */ 0x6ba,
		   /* c0 */ 0x676,
		   /* c1 */ 0x5d6,
		   /* c2 */ 0x6d6,
		   /* c3 */ 0x316,
		   /* c4 */ 0x756,
		   /* c5 */ 0x296,
		   /* c6 */ 0x196,
		   /* c7 */ 0x386,
		   /* c8 */ 0x796,
		   /* c9 */ 0x256,
		   /* ca */ 0x156,
		   /* cb */ 0x346,
		   /* cc */ 0x0d6,
		   /* cd */ 0x2c6,
		   /* ce */ 0x1c6,
		   /* cf */ 0x576,
		   /* d0 */ 0x5b6,
		   /* d1 */ 0x236,
		   /* d2 */ 0x136,
		   /* d3 */ 0x326,
		   /* d4 */ 0x0b6,
		   /* d5 */ 0x2a6,
		   /* d6 */ 0x1a6,
		   /* d7 */ 0x7a6,
		   /* d8 */ 0x736,
		   /* d9 */ 0x266,
		   /* da */ 0x166,
		   /* db */ 0x766,
		   /* dc */ 0x0e6,
		   /* dd */ 0x6e6,
		   /* de */ 0x5e6,
		   /* df */ 0x6b6,
		   /* e0 */ 0x271,
		   /* e1 */ 0x1d1,
		   /* e2 */ 0x2d1,
		   /* e3 */ 0x71e,
		   /* e4 */ 0x351,
		   /* e5 */ 0x69e,
		   /* e6 */ 0x59e,
		   /* e7 */ 0x78e,
		   /* e8 */ 0x391,
		   /* e9 */ 0x65e,
		   /* ea */ 0x55e,
		   /* eb */ 0x74e,
		   /* ec */ 0x4de,
		   /* ed */ 0x6ce,
		   /* ee */ 0x5ce,
		   /* ef */ 0x171,
		   /* f0 */ 0x1b1,
		   /* f1 */ 0x637,
		   /* f2 */ 0x537,
		   /* f3 */ 0x72e,
		   /* f4 */ 0x4b7,
		   /* f5 */ 0x6ae,
		   /* f6 */ 0x5ae,
		   /* f7 */ 0x3a1,
		   /* f8 */ 0x331,
		   /* f9 */ 0x66e,
		   /* fa */ 0x56e,
		   /* fb */ 0x361,
		   /* fc */ 0x4ee,
		   /* fd */ 0x2e1,
		   /* fe */ 0x1e1,
		   /* ff */ 0x2b1,
		},   // RD = +1 cases 
		{
		   /* 00 */ 0x58b,
		   /* 01 */ 0x62b,
		   /* 02 */ 0x52b,
		   /* 03 */ 0x314,
		   /* 04 */ 0x4ab,
		   /* 05 */ 0x294,
		   /* 06 */ 0x194,
		   /* 07 */ 0x074,
		   /* 08 */ 0x46b,
		   /* 09 */ 0x254,
		   /* 0a */ 0x154,
		   /* 0b */ 0x344,
		   /* 0c */ 0x0d4,
		   /* 0d */ 0x2c4,
		   /* 0e */ 0x1c4,
		   /* 0f */ 0x68b,
		   /* 10 */ 0x64b,
		   /* 11 */ 0x234,
		   /* 12 */ 0x134,
		   /* 13 */ 0x324,
		   /* 14 */ 0x0b4,
		   /* 15 */ 0x2a4,
		   /* 16 */ 0x1a4,
		   /* 17 */ 0x45b,
		   /* 18 */ 0x4cb,
		   /* 19 */ 0x264,
		   /* 1a */ 0x164,
		   /* 1b */ 0x49b,
		   /* 1c */ 0x0e4,
		   /* 1d */ 0x51b,
		   /* 1e */ 0x61b,
		   /* 1f */ 0x54b,
		   /* 20 */ 0x189,
		   /* 21 */ 0x229,
		   /* 22 */ 0x129,
		   /* 23 */ 0x719,
		   /* 24 */ 0x0a9,
		   /* 25 */ 0x699,
		   /* 26 */ 0x599,
		   /* 27 */ 0x479,
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
		   /* aa */ 0x55a,
		   /* ab */ 0x74a,
		   /* ac */ 0x4da,
		   /* ad */ 0x6ca,
		   /* ae */ 0x5ca,
		   /* af */ 0x28a,
		   /* b0 */ 0x24a,
		   /* b1 */ 0x63a,
		   /* b2 */ 0x53a,
		   /* b3 */ 0x72a,
		   /* b4 */ 0x4ba,
		   /* b5 */ 0x6aa,
		   /* b6 */ 0x5aa,
		   /* b7 */ 0x05a,
		   /* b8 */ 0x0ca,
		   /* b9 */ 0x66a,
		   /* ba */ 0x56a,
		   /* bb */ 0x09a,
		   /* bc */ 0x4ea,
		   /* bd */ 0x11a,
		   /* be */ 0x21a,
		   /* bf */ 0x14a,
		   /* c0 */ 0x186,
		   /* c1 */ 0x226,
		   /* c2 */ 0x126,
		   /* c3 */ 0x716,
		   /* c4 */ 0x0a6,
		   /* c5 */ 0x696,
		   /* c6 */ 0x596,
		   /* c7 */ 0x476,
		   /* c8 */ 0x066,
		   /* c9 */ 0x656,
		   /* ca */ 0x556,
		   /* cb */ 0x746,
		   /* cc */ 0x4d6,
		   /* cd */ 0x6c6,
		   /* ce */ 0x5c6,
		   /* cf */ 0x286,
		   /* d0 */ 0x246,
		   /* d1 */ 0x636,
		   /* d2 */ 0x536,
		   /* d3 */ 0x726,
		   /* d4 */ 0x4b6,
		   /* d5 */ 0x6a6,
		   /* d6 */ 0x5a6,
		   /* d7 */ 0x056,
		   /* d8 */ 0x0c6,
		   /* d9 */ 0x666,
		   /* da */ 0x566,
		   /* db */ 0x096,
		   /* dc */ 0x4e6,
		   /* dd */ 0x116,
		   /* de */ 0x216,
		   /* df */ 0x146,
		   /* e0 */ 0x58e,
		   /* e1 */ 0x62e,
		   /* e2 */ 0x52e,
		   /* e3 */ 0x311,
		   /* e4 */ 0x4ae,
		   /* e5 */ 0x291,
		   /* e6 */ 0x191,
		   /* e7 */ 0x071,
		   /* e8 */ 0x46e,
		   /* e9 */ 0x251,
		   /* ea */ 0x151,
		   /* eb */ 0x348,
		   /* ec */ 0x0d1,
		   /* ed */ 0x2c8,
		   /* ee */ 0x1c8,
		   /* ef */ 0x68e,
		   /* f0 */ 0x64e,
		   /* f1 */ 0x231,
		   /* f2 */ 0x131,
		   /* f3 */ 0x321,
		   /* f4 */ 0x0b1,
		   /* f5 */ 0x2a1,
		   /* f6 */ 0x1a1,
		   /* f7 */ 0x45e,
		   /* f8 */ 0x4ce,
		   /* f9 */ 0x261,
		   /* fa */ 0x161,
		   /* fb */ 0x49e,
		   /* fc */ 0x0e1,
		   /* fd */ 0x51e,
		   /* fe */ 0x61e,
		   /* ff */ 0x54e,
		} };
	
