alanbjohnston/CubeSatSim/(commit log)

2021-05-15 trying camera test
2021-05-15 added camera conditional for sstv
2021-05-15 added camera close
2021-05-15 cleanup with working auto detect camera SSTV mode
2021-05-16 removed length print
2021-05-29 send frame twice over socket
2021-05-29 printout PythonConfigStr
2021-05-29 changed a printf to fprintf(stderr
2021-05-29 changed UART to 115200
2021-05-29 added test for BPSK mode for 2nd socket send
2021-05-29 commented out prints
2021-05-29 removed last print
2021-05-30 changed to 2.5 for 6 frames/min
2021-05-30 added 0.0 printing if error
2021-05-30 print it2c_two
2021-05-30 no Error 3 print
2021-05-30 added printf for python results
2021-05-31 reverted to try except for printing instead of variable one, two, etc.
2021-05-31 turned on max and min frames for a test similar to dev-faster
2021-05-31 BPSK only send MAX MIN frames, just +Xv and +Yv so far
2021-05-31 added payload frame checking for MAX Min
2021-05-31 always send MAX Min frame BPSK
2021-05-31 rest of battery voltages and currents
2021-05-31 fixed current conversions
2021-05-31 switching max and min
2021-05-31 added rest of sensors
2021-05-31 WOD printf
2021-05-31 added delay between prints of 0.01
2021-05-31 added last few sensors max min
2021-05-31 rest of sensors max min
2021-05-31 added error recovery during print
2021-05-31 added print in recovery
2021-06-01 simulated mode if i2c bus 3 not present
2021-06-01 removed some printfs
2021-06-01 updates to get ready for v1 code release
    [CubeSatSim_maxtelemetry.csv, CubeSatSim_mintelemetry.csv, CubeSatSim_rttelemetry.csv]
2021-06-01 rename conversion_curves, modify rtt
    [CubeSatSim_PSK_rttelemetry.csv, CubeSatSim_conversion_curves.csv]
2021-06-01 changed 4 to 3 to fix max min swapping of currents
    [CubeSatSim_PSK_rttelemetry.csv]
2021-06-01 changed Sensor 1 to Humidity
    [CubeSatSim_PSK_rttelemetry.csv]
2021-06-01 changed sensor names
    [CubeSatSim_rttelemetry.csv]
2021-06-01 back to 11a original
    [CubeSatSim_maxtelemetry.csv]
2021-06-01 changed Humidity and Sensor 1 and 2
    [CubeSatSim_rttelemetry.csv]
2021-06-01 original 11a files
    [CubeSatSim_PSK_maxtelemetry.csv, CubeSatSim_PSK_mintelemetry.csv]
2021-06-01 changed humidity to 1 decimal place like temperature
    [CubeSatSim_PSK_rttelemetry.csv]
2021-06-01 4 to 3, Humidity, Sensor 1 & 2
    [CubeSatSim_PSK_maxtelemetry.csv]
2021-06-01 Pressure in hPa
    [CubeSatSim_PSK_rttelemetry.csv]
2021-06-01 added missing field
    [CubeSatSim_PSK_maxtelemetry.csv]
2021-06-01 changed Experiments to NONE
    [CubeSatSim_PSK_maxtelemetry.csv]
2021-06-02 changed humidity to 1 decimal, same as temperature
    [CubeSatSim_rttelemetry.csv]
2021-06-02 updated Humidity and Sensor 1 & 2
    [CubeSatSim_mintelemetry.csv]
2021-06-02 updated for Humidity
    [CubeSatSim_maxtelemetry.csv]
2021-06-02 replaced rpitx with touch ready to signal rpitx.py
    [main.c]
2021-06-03 changed PayloadStatus1 to SimulatedTelemetry
    [CubeSatSim_PSK_rttelemetry.csv]
2021-06-03 added Simulated Telemetry
    [CubeSatSim_rttelemetry.csv]
2021-06-03 added s parameter for single read of python sensor code
2021-06-03 fix Payload string printout
    [main.c]
2021-06-03 added debug or d parameter to print extra info
2021-06-03 added print
2021-06-03 print python command
2021-06-03 comment out print
2021-06-03 only print vB5 if debug
2021-06-03 print grep
2021-06-03 removing prints
2021-06-03 moved i2c bus testing
2021-06-03 i2c bus test printf
2021-06-04 changed to forked repos, added camera steps, changed to enable_uart, renamed dropping .sh
2021-06-05 moved initial_image to either camera or no camera
2021-06-06 changed camera image to CubeSatSim
2021-06-06 added additions for camera installs for image
2021-06-06 added updates for image for camera
2021-06-07 Serial1 speed increased to 115200 and Sensor 3 removed
2021-06-09 SSTV with camera, changed first image to CubeSatSim image 2
2021-06-09 added current threshold test for low voltage battery shutdown
2021-06-09 changed Tx LED for FSK and BPSK to be off for 0.5 sec each frame
2021-06-09 added in !sim_mode for battery threshold
2021-06-09 cleaned up threshold printf
2021-06-09 Tx LED debugging
2021-06-09 changed AFSK Tx LED
2021-06-09 added Tx LED for dummy APRS packets
2021-06-10 added log write to shutdown_log.txt before low battery shutdown
2021-06-10 printf typo
2021-06-10 different encoding for tlm[3][A] for 3 cell battery
2021-06-10 added pull and install for pi-power-button
2021-06-10 added test to see if pi-power-button changed before reinstalling
2021-06-10 try Tx LED for FSK here instead of cubesatsim
2021-06-10 removed Tx LED for FSK/BPSK back to sleep(2.3)
2021-06-10 Tx LED for BPSK now
2021-06-10 added print and fixed order of sleep
2021-06-10 turn off Tx LED for APRS
2021-06-10 added Tx LED for AFSK mode
2021-06-11 to fix zero initial sensor readings, try 2 times to get OK
    [main.c]
2021-06-11 clear sensor_payload[0] and 10 toys
2021-06-11 print chars after ? result
2021-06-11 moved chars printf
2021-06-11 added sleep(2) if payload detected. removed chars printf
2021-06-11 added sudo rm t.txt just in case
2021-06-11 removed tlm printing
2021-06-11 removed stderr print out that was blob
2021-06-11 added turn off if fails after 10 tries
    [main.c]
2021-06-11 fixed location of else
    [main.c]
2021-06-11 Changed Sensor1 to Diode Temperature
    [CubeSatSim_rttelemetry.csv]
2021-06-11 changed from _temp to _rpm (1 decimal, signed)
    [CubeSatSim_rttelemetry.csv]
2021-06-11 initial add, sending diode temperature as XS1
2021-06-11 removed i2c_bus0 test
2021-06-11 added Diode Temp and removed I2C status
    [CubeSatSim_PSK_mintelemetry.csv]
2021-06-11 added Diode temperature and removed I2C 0
    [CubeSatSim_PSK_rttelemetry.csv]
2021-06-11 fixed image 1 and image 2 for with and without camera
2021-06-11 commented out last few Tx LED - now only used for AX5043
2021-06-12 added BME280 and MPU6050 to sensor names
    [CubeSatSim_rttelemetry.csv]
2021-06-14 added in groundstation/.profile setting but don't do anything with it yet.
2021-06-14 added STATUS_ON_OFF and BME, MPU, and INA in Description
    [CubeSatSim_PSK_rttelemetry.csv]
2021-06-14 major redo of Tx LED sensing
2021-06-15 added INA219, MPU6050, and BME280 labels
    [CubeSatSim_PSK_rttelemetry.csv]
2021-06-15 added INA, MPU, and BME labels, and Safe Mode
    [CubeSatSim_rttelemetry.csv]
2021-06-15 IHU Temp
    [CubeSatSim_PSK_rttelemetry.csv]
2021-06-15 added STATUS_ON_OFF
    [CubeSatSim_rttelemetry.csv]
2021-06-15 for i2c bus 3, added printf that it is not an error for a CubeSatSim Lite
    [main.c]
2021-06-16 print CW string
2021-06-16 added printfs
2021-06-16 printfs for cw_str2
2021-06-16 more printfs
2021-06-16 removed printf
2021-06-16 BPSK 2x socket send first time only
2021-06-16 moved sensor read, sim telem, and payload read to common code
2021-06-17 40 second delay to write log before low voltage shutdown
2021-06-17 changed printf and loop time in sec
2021-06-18 seconds per frame float
2021-06-18 added FSK second per frame
2021-06-18 use frameTime to determine sleep length
2021-06-18 changed printf to Sleep period
2021-06-18 fixed sleep period, reduced sleep by 0.1 (100 ms)
    [main.c]
2021-06-18 only continue firstTime if socket open
2021-06-18 send frame 3 times
2021-06-18 reducing frameTime by 0.5 instead of 0.1
2021-06-18 trying 6 times at start and sleep(3.8) fixed
    [main.c]
2021-06-18 try frameTime - 100 instead of 500
2021-06-18 reset sampleTime when doing firstTme filling
    [main.c]
2021-06-18 added delay after socket refused, flushes
2021-06-20 added back in frameTime sleeping for both FSK and BPSK
2021-06-20 fill buffer every 32 samples
2021-06-20 every 360 samples
2021-06-20 180 samples
2021-06-20 BPSK in 80 frames
2021-06-20 added initial CW frame send
2021-06-21 added printf for spin
2021-06-21 printf data just before tx
2021-06-21 fixed APRS header for AX5043
    [main.c]
2021-06-21 added sleep in case CW ID is sent
2021-06-22 printf uptime_sec
2021-06-23 send empty FSK or BPSK frames before starting python
2021-06-23 fixed order of python call
    [main.c]
2021-06-23 if uptime = 0, reset count = 0 so fill frames are ignored at start
    [main.c]
2021-06-23 fixed reset count 0 if uptime 0
    [main.c]
2021-06-23 moved max min reset to after buffer fill frames
    [main.c]
2021-06-23 use invalid frame type of 0xf if uptime = 0 for filler frames
2021-06-23 skipped an rs_update step if uptime is zero so that the frame will fail the RS FEC check and be discarded
    [main.c]
2021-06-23 try again skipping FEC
    [main.c]
2021-06-24 rm camera_out.jpg not t.txt
2021-06-24 try without firstTime reset after fill frames
    [main.c]
2021-06-24 firstTime reset back in after fill frames
    [main.c]
2021-06-24 added afsk for spi
2021-06-24 ax5043 for spi
2021-06-24 moved openwrt to groundstation
2021-06-24 moved vB3 kicad files under hardware
    [Ideal_Diode.sch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]
2021-06-24 rename arduino directory stempayload
2021-06-24 moving files
    [Ideal_Diode.sch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]
2021-06-24 changed from volt current to ina219.py
2021-06-25 added first_read to detect baseline accel reading for LED
2021-06-25 added diode temp, C to clear eeprom, first_read to set access baseline
2021-06-26 print voltage and current
2021-06-26 removed printfs
2021-06-27 try opening socket twice
2021-06-27 2 second wait to reopen socket
2021-06-28 fixed sim mode temp
    [main.c]
2021-06-28 updated for v1.0
    [CubeSatSim v1.0 APRS TLM Analysis.xlsx]
2021-06-28 print $5 for sim mode
2021-06-29 moved pi-power-button install to the end, and added prompt for reboot if changes.
2021-06-29 added more prints
2021-06-29 moved I2C bus tests to the start, removed duplicate bus test
2021-06-29 try 2 second i2c bus test
2021-06-29 fixed bug with i2c_bus variable
    [main.c]
2021-06-29 added deletion of camera image as soon as it is encoded.
2021-06-30 fixed rm camera image
2021-06-30 also delete the camera wav file
2021-07-03 added auto switch bands (retuneCenterFrequency)
2021-07-03 changed to alasa audio device 3 instead of 2
2021-08-11 Add SI1145 & LIS3MDL sensors to payload.
2021-08-11 Prevent negative mag values
    [Payload_BME280_MPU6050_XS_Extended.ino]
2021-08-22 print typo
2021-08-23 changed callsign to ground station name
2021-08-24 Create aprs.desktop
    [Desktop Entry]
    Name=APRS Decode using Direwolf
    GenericName=Decodes APRS using Direwolf and rtl_fm
    Comment=APRS signals
    Exec=/home/pi/CubeSatSim/groundstation/aprs.sh
    Icon=/home/pi/icons/direwolf.png
    Terminal=true
    Type=Application
    Categories=HamRadio;
    Keywords=APRS
2021-09-14 main board v1.1
2021-09-14 battery v1.1 board
2021-09-19 print lat lon as tuples
2021-10-15 added vB4 CubeSatSim Lite board files
2021-10-15 rest of vB4 Lite board files
2021-11-14 added 1.1a STEM Payload board updates
2021-12-18 added python read after raspistill to test camera
2021-12-18 added log file about testing for camera
2021-12-20 changed pi-power-button to use bullseye branch which uses python3
2022-02-06 added extra GPIO.setmode(GPIO.BCM) for Tx LED on Pi 4
2022-02-08 added extra to make Tx LED work with Pi 4
2022-02-08 added v1.1 printf to log
2022-02-08 added v1.1 print to log
2022-02-12 changed pi-power-button from bullseye to master branch
2022-02-28 added v1.2 hardware files
    [cubesatsim-STEM-1.2.brd]
2022-03-02 removed board version check
    was interfering with Blue Tx LED
    [telem.c]
2022-03-02 added sleep at start during boot to delay battery read
2022-03-02 changed battery voltage threshold
2022-03-02 changed threshold back to 3.5 V
2022-03-02 added printf
2023-03-25 revert last two commits
    [main.c]
2023-03-25 added debug prints
2023-04-06 if sensor[XS1] and XS2 present, update lat, non
2023-04-15 fix default and recalled lat lon
    [main.c]
2023-04-15 print in aprs format
2023-04-15 print extra sleep in log
2023-04-29 add prints and finish = true
2023-04-29 more prints
2023-04-29 fixed prints
2023-04-29 change print
2023-04-30 copy buffer2 again into sensor_payload, don't test at start
2023-04-30 recopy buffer2 into sensor_payload
2023-04-30 remove Str so far, fix length printf
    [main.c]
2023-07-26 print packet, delay 0.5 s after
2023-07-27 check txc pin to use rpitx or txc
2023-07-28 add in i2c bus 3 to install script
2023-07-28 changed power button to reboot-mode-change
2023-07-30 fix tx led BPSK
2023-07-30 fix tx off blink led fast
2023-07-31 added command_rx for sstv for camera present
2023-07-31 blink blue LED briefly when receive a command
2023-07-31 blink green LED on command
2023-07-31 wrong gpio for green LED
2023-08-01 5 seconds between CW frames
2023-08-11 check for new pwm config.txt settings and reboot if changed
2023-08-12 add callsign and telem string to camera image
2023-08-12 add write of Batt voltage string to telem_string.txt
2023-08-13 fixed atoi and printf
    [main.c]
2023-08-13 Update config print rebooting
2023-08-13 Update update for pi-power-button checkout
2023-08-13 Update update run install for pi-power-button when boot.txt updated
2023-08-14 Update config to add labels for I2C buses
2023-08-14 Update main.c to add RX Antenna deployment
2023-08-16 Update update to fix pi-power-button upgrade
2023-08-16 Update update moved pillow install with pi-button update
2023-08-18 Update rpitx.py sleep 5 between frames in CW mode
2023-08-18 Update rpitx.py add 5 sec sleep after first CW frame
2023-08-21 Update telem.c added back bus voltage current for V1.2 Sims
2023-08-21 Update main.h change voltage threshold to 3.25V
2023-08-26 Update main.c re-enable sim_mode based on I2C bus 3 state
2023-08-26 Create payload_pico.ino payload OK only
    Copied from https://raw.githubusercontent.com/alanbjohnston/CubeSatSim/pico-payload-fm-rx/cubesatsim/cubesatsim.ino
2023-09-30 Update main.c APRS add battery voltage and current only
2023-09-30 Update main.c fix V and mA
    [main.c]
2023-09-30 Update main.c fixed V and I batt
    [main.c]
2023-09-30 Update payload_pico.ino print result
2023-09-30 Update payload_pico.ino fix Serial.read
    [payload_pico.ino]
2023-09-30 Update payload_pico.ino fix typo
    [payload_pico.ino]
2023-10-01 Update payload_pico.ino revert to before input
    [payload_pico.ino]
2023-10-01 Update payload_pico.ino add v0.2 and freq print
2023-10-01 Update payload_pico.ino force gyro offset calculations
2023-10-01 Update main.c fix low battery shutdown
    [main.c]
2023-10-01 Update main.h raise threshold to 3.6 V
2023-10-02 Update main.c fixed battery current
    [main.c]
2023-10-03 Update main.c moved wiringPisetup
2023-10-03 Update main.c change to BAT with current in sstv telem
2023-10-03 Update main.c remove all serial writes to Pico
2023-10-03 add PCB files for vb1.3.2
2023-10-05 Update main.c fix typo
    [main.c]
2023-10-10 add frame STL files
    [cubesatsim_frame_side.v1.3.2.stl, cubesatsim_frame_side_camera.v1.3.2.stl, cubesatsim_frame_top_bottom.v1.3.2.stl]
2023-10-14 Update rpitx.py add battery_saver_check each transmit
2023-10-14 Update rpitx.py with prints
2023-10-14 Update config APRS setting based on battery saver mode
2023-10-17 Update main.c fix typo for HAB mode
    [main.c]
2023-11-07 Update ina219.py to avoid BrokenPipeError
    [ina219.py]
2023-11-11 Update main.c handling telem_string error
    [main.c]
2023-11-11 Update rpitx.py print config
2023-11-12 Update rpitx.py print no_command
2023-11-13 Update main.c print tx and rx
2023-11-13 Update main.c move wiring pi setup
2023-11-13 Update main.c swapped rx and tx
    [main.c]
2023-11-14 Update config remove pin 18 func 2 for aprs battery saver
2023-11-16 Update config manual battery saver, change modes a,s,m
2023-11-16 Update main.h add battery_saver function
2023-11-16 Update main.c add battery_saver function
2023-11-16 Update main.c (void) battery_saver
2023-11-16 Update main.c added int battery_saver_check()
2023-11-16 Update main.h int battery_saver_check()
2023-11-16 Update main.c battery_saver(ON) do nothing
2023-11-16 Update rpitx.py read open battery_saver
2023-11-16 Update main.c print battery_saver_chack()
2023-11-16 Update main.c fix conditional
    [main.c]
2023-11-16 Update main.c print conditional
2023-11-16 Update main.c added stderr to printfs
2023-11-16 Update main.c added to battery saver change mode
2023-11-16 Update main.c fixes to quotes
    [main.c]
2023-11-16 Update main.c fixed *
    [main.c]
2023-11-16 Update main.c add print
2023-11-18 Update main.h added hab_mode and battery_saver_mode
2023-11-18 Update main.c added battery_saver_mode
2023-11-18 Update rpitx.py battery_saver_check() once at starty
2023-11-18 Update rpitx.py stray battery_saver_mode
2023-11-18 Update main.c only if battery_saver_mode changes execute
2023-11-18 Update main.c paste battery_saver_check code
2023-11-18 Update main.c don't close if open fails
    [main.c]
2023-11-18 Update main.c fix sed for battery on
    [main.c]
2023-11-18 Update main.c switch battery_saver_check() outputs
2023-11-18 Update main.c add battery prints
2023-11-18 Update main.c print battery status mode ON or OFF
2023-11-18 Update main.c fix battery saver turn off
    [main.c]
2023-11-19 Update main.c add extra APRS packet only for battery_saver_mode
2023-11-19 Update main.c remove extra prints
2023-11-19 Update main.c command_count fix
    [main.c]
2023-11-21 Update main.c print sim mode
2023-11-21 Update main.c added more printfs
2023-11-21 Update main.c fixed writing of sim.cfg
    [main.c]
2023-11-21 Update config battery_saver restart
2023-11-21 Update config reboot for battery_saver change
2023-12-10 Update update pi-power-button uses FLAG=1 to reboot
2023-12-13 Update main.c read sensors in sim mode
2023-12-13 Update main.c don't show voltage and current in sstv if not sensor
2023-12-16 Update payload_pico.ino fix Serial2
    [payload_pico.ino]
2023-12-18 new battery files
2024-01-04 revert to Payload_BME280_MPU6050_XS_Extended for cleanup
    [payload_pico.ino]
2024-01-04 Revert to Payload_BME280_MPU6050_XS.ino for cleanup
    [payload_pico.ino]
2024-01-04 added ARDUINO_ARCH_RP2040 test
2024-01-04 print sensors to serial every time
2024-01-04 add check for wifi on Pico
2024-01-04 add led_builtin_pin;
2024-01-04 blink built in LED each time
2024-01-04 add green and blue LED support
2024-01-04 skip eprom for Pico
    [Payload_BME280_MPU6050_XS.ino]
2024-01-04 don't clear EEPROM for Pico
2024-01-04 set mode green and blue LEDs
2024-01-04 green and blue LEDs
2024-01-04 set Serial1 for Pico
2024-01-04 write voltage and current over serial to Pico
2024-01-04 print string received by Pico
2024-01-04 test prints
2024-01-05 fixed start in gps
    [Payload_BME280_MPU6050_XS.ino]
2024-01-05 fixed extra line feeds
    [Payload_BME280_MPU6050_XS.ino]
2024-01-05 fixed variable name magRawAbs
    [payload_extension.cpp]
2024-01-05 added sensor names
2024-01-05 added prints in setup
2024-01-06 Create payload_extension.cpp with blank sensor info
2024-01-07 Update Payload_BME280_MPU6050_XS.ino changes for Arduino Mbed RP2040 board
2024-01-07 Update Payload_BME280_MPU6050_XS.ino remove tx rx pin assignments
2024-01-07 Update Payload_BME280_MPU6050_XS.ino removed printf
2024-01-07 Update Payload_BME280_MPU6050_XS.ino typo missing //
    [Payload_BME280_MPU6050_XS.ino]
2024-01-07 Update Payload_BME280_MPU6050_XS.ino try UART instead
2024-01-07 Update Payload_BME280_MPU6050_XS.ino fix printf
    [Payload_BME280_MPU6050_XS.ino]
2024-01-08 Update Payload_BME280_MPU6050_XS_Extended.ino missing /*
    [Payload_BME280_MPU6050_XS_Extended.ino]
2024-01-08 Update Payload_BME280_MPU6050_XS_Extended.ino UART changes
2024-01-12 Update Payload_BME280_MPU6050_XS.ino don't go gps if not Pico
2024-01-14 Update Payload_BME280_MPU6050_XS.ino fixed blink
    [Payload_BME280_MPU6050_XS.ino]
2024-01-14 Update Payload_BME280_MPU6050_XS.ino short blink
    [Payload_BME280_MPU6050_XS.ino]
2024-01-14 Update main.c moving stem payload sensor code
2024-01-19 Update Payload_BME280_MPU6050_XS.ino only do TinyGPS if Pico
2024-01-19 Update Payload_BME280_MPU6050_XS.ino add get gps print
2024-01-19 Update Payload_BME280_MPU6050_XS.ino pin set input from 6 to 10
2024-01-20 Update Payload_BME280_MPU6050_XS.ino add back in Arduino-Pico support
2024-01-20 Update Payload_BME280_MPU6050_XS.ino add or Arduino Pico
2024-01-20 Update Payload_BME280_MPU6050_XS.ino fix else
    [Payload_BME280_MPU6050_XS.ino]
2024-01-20 Update Payload_BME280_MPU6050_XS.ino test board print
2024-01-20 Update Payload_BME280_MPU6050_XS.ino fixed board conditionals
    [Payload_BME280_MPU6050_XS.ino]
2024-01-20 Update Payload_BME280_MPU6050_XS.ino fix define typo
    [Payload_BME280_MPU6050_XS.ino]
2024-01-20 Update Payload_BME280_MPU6050_XS.ino missing #
    [Payload_BME280_MPU6050_XS.ino]
2024-01-20 Update Payload_BME280_MPU6050_XS.ino eeprom if fixed
    [Payload_BME280_MPU6050_XS.ino]
2024-01-20 Update Payload_BME280_MPU6050_XS.ino missing ;
    [Payload_BME280_MPU6050_XS.ino]
2024-01-20 Update Payload_BME280_MPU6050_XS.ino fix !RP2040
    [Payload_BME280_MPU6050_XS.ino]
2024-01-20 Update Payload_BME280_MPU6050_XS.ino remove Getting GPS Data print
2024-01-20 Update Payload_BME280_MPU6050_XS_Extended.ino no GPS print
2024-01-21 Update Payload_BME280_MPU6050_XS_Extended.ino diode temp calibration
2024-01-21 Update Payload_BME280_MPU6050_XS.ino diode temp calibration
2024-01-22 Update main.h reduce low battery threshold to 3.5 V
2024-01-23 adding battery v1.3.2.1 files
2024-01-27 Update main.c keep Pi Zero 2 threshold voltage the same
2024-02-09 update images of battery board
2024-02-27 Update main.c fixed typo
    [main.c]
2024-02-27 Update main.h increased sensor size to 20
2024-02-27 Update main.c increased sensor size to 20
2024-02-27 Update main.h sensor 22
2024-02-27 Update main.c sensor to 22
2024-02-27 Update main.c fix change to 20
    [main.c]
2024-02-27 Update main.h changed to SENSOR_FIELDS
2024-02-27 Update main.h increased SENSOR_FIELDS to 26
2024-02-27 Update main.c changed to SENSOR_FIELDS
2024-02-27 Update main.h fixed DTEMP
    [main.h]
2024-02-27 Update main.c fixed DTEMP
    [main.c]
2024-02-27 Update main.c fix humidity max min
    [main.c]
2024-02-27 Update main.h sensor extension documentation
2024-03-01 Update Payload_BME280_MPU6050_XS.ino fix issue with Pico W LEDs
    [Payload_BME280_MPU6050_XS.ino]
2024-03-01 Update Payload_BME280_MPU6050_XS_Extended.ino fix issue with Pico W LEDs
    [Payload_BME280_MPU6050_XS_Extended.ino]
2024-03-02 Update rpitx.py prints
2024-03-02 Update rpitx.py print channel
2024-03-02 Update rpitx.py more prints
2024-03-02 Update rpitx.py lots of prints
2024-03-02 Update rpitx.py more prints
2024-03-02 Update rpitx.py after rm print
2024-03-02 Update rpitx.py remove a print
2024-03-02 Update rpitx.py remove another print
2024-03-02 Update rpitx.py remove print
2024-03-02 Update rpitx.py print cw command
2024-03-04 Update main.c make battery saver Safe Mode
2024-03-04 Update rpitx.py add Safe Mode print
2024-03-04 Update config change from battery saver to safe mode
2024-03-04 Update config only rm battery saver if changed
2024-03-04 Update main.c fix safe mode tyops
    [main.c]
2024-03-04 Update main.c don't print in battery saver check
2024-03-04 Update config print safe mode and saver on same line
2024-03-04 Update main.c added missing variable
    [main.c]
2024-03-04 Update main.c fix cwready
    [main.c]
2024-03-04 Update main.c don't say switch unless switching
2024-03-06 Update main.c add print for safe mode and set to 0
2024-03-06 Update main.c fix battery_saver setting
    [main.c]
2024-03-09 Update Payload_BME280_MPU6050_XS.ino enable EEPROM for Pico
2024-03-09 Update Payload_BME280_MPU6050_XS.ino add in temp calibration
2024-03-09 Update Payload_BME280_MPU6050_XS.ino fix eprom write
    [Payload_BME280_MPU6050_XS.ino]
2024-03-09 Update Payload_BME280_MPU6050_XS.ino switch between calibration points
2024-03-09 Update Payload_BME280_MPU6050_XS.ino print calibration
2024-03-09 Update Payload_BME280_MPU6050_XS.ino remove prints
2024-03-09 Update Payload_BME280_MPU6050_XS.ino missing ||
    [Payload_BME280_MPU6050_XS.ino]
2024-03-09 Update Payload_BME280_MPU6050_XS.ino try bed
2024-03-09 Update Payload_BME280_MPU6050_XS.ino only eeprom for pico
2024-03-09 Update Payload_BME280_MPU6050_XS.ino fix board tests
    [Payload_BME280_MPU6050_XS.ino]
2024-03-09 Update Payload_BME280_MPU6050_XS.ino missing \n
    [Payload_BME280_MPU6050_XS.ino]
2024-03-09 Update Payload_BME280_MPU6050_XS.ino bed don't overwrite calibration
2024-03-09 Update Payload_BME280_MPU6050_XS.ino use the new calibration values
2024-03-09 Update Payload_BME280_MPU6050_XS.ino missing {
    [Payload_BME280_MPU6050_XS.ino]
2024-03-09 Update Payload_BME280_MPU6050_XS.ino print calibration on 'd'
2024-03-09 Update Payload_BME280_MPU6050_XS.ino only commit pico
2024-03-09 Update Payload_BME280_MPU6050_XS.ino only begin pico
2024-03-10 Update Payload_BME280_MPU6050_XS.ino display raw sensor in d
2024-03-29 Update main.c exit sim_mode if battery voltage sensor present
2024-03-29 Update main.c revert replace all sim_mode
    [main.c]
2024-03-29 Update main.c missing }
    [main.c]
2024-03-29 stem payload v1.3.2.1 PCB
2024-05-31 Update aprs_in.py no newline in print
2024-06-19 Update update print output of sim.cfg
2024-06-19 Update config TX PL print and print parameters
2024-06-19 Update config print no restart
2024-06-20 Update config don't print args
2024-06-20 Update update print reboot needed if disabled
2024-06-20 Update config print reboot needed for changes to take effect
2024-06-20 Update config remove prints
2024-06-20 Update rpitx.py don't print debug sim.cfg
2024-06-20 Update rpitx.py print uhf_string
2024-06-20 Update config remove No reboot print
2024-06-20 Update rpitx.py print for reading sim.cfg
2024-06-22 Update adafruitio_00_publish_modified.cpp added temperature and pressure
2024-06-22 Update Payload_BME280_MPU6050_AIO.ino fixed default vals
    [Payload_BME280_MPU6050_AIO.ino]
2024-06-22 Update adafruitio_00_publish_modified.cpp prints
2024-06-22 Update adafruitio_00_publish_modified.cpp use millis instead of delay
2024-06-22 Update adafruitio_00_publish_modified.cpp print waiting
2024-06-22 Update adafruitio_00_publish_modified.cpp removed gyro feeds
2024-06-23 Update Payload_BME280_MPU6050_AIO.ino typo missing s
    [Payload_BME280_MPU6050_AIO.ino]
2024-06-23 Update Payload_BME280_MPU6050_AIO.ino missing *
    [Payload_BME280_MPU6050_AIO.ino]
2024-06-30 Update squelch_cc.py fixed indents
    [squelch_cc.py]
2024-06-30 Update squelch_cc.py added squelch pin
2024-06-30 Update squelch_cc.py set squelch pin mode
2024-06-30 Update squelch_cc.py set powerPin mode
2024-06-30 Update squelch_cc.py fix sleep
    [squelch_cc.py]
2024-06-30 Update squelch_cc.py add print
2024-06-30 Update squelch_cc.py turn off LEDs and tx
2024-06-30 Update squelch_cc.py fix txLED variable
    [squelch_cc.py]
2024-06-30 Update squelch_cc.py turn off LEDs sooner
2024-06-30 Update aprs_in.py add immediate LED and tx stop
2024-06-30 Update aprs_in.py add LED blinks
2024-06-30 Update aprs_in.py print all messages
2024-07-01 Update main.c remove printfs
2024-07-01 Update main.c removed last two prints
2024-07-02 Update rpitx.py 10 seconds between SSTV and CW frames
2024-07-03 Update and rename aprs_in.py to dtmf_aprs_cc.py and fix log
    [dtmf_aprs_cc.py]
2024-07-03 Update main.c added echo broadcast to wall for shutdown and reboots
    [main.c]
2024-07-03 Update main.c missing ;
    [main.c]
2024-07-03 Update command if direwolf mode but no soundcard, print
2024-07-04 Update update add power button -cc branch
2024-07-04 Update main.c print loop time, no gps
2024-07-04 Update main.c typo missing t
    [main.c]
2024-07-04 Update main.c print sleep period
2024-07-04 Update main.c print time for sleep
2024-07-05 Update main.c fixed pi 2 offset
    [main.c]
2024-07-05 Update main.c sleep prints
2024-07-05 Update main.h reduce camera timeout to 1s
2024-07-05 Update main.c print opening serial
2024-07-08 Update update add shutdown power button fix
2024-07-08 Update main.c fixed delay detection
    [main.c]
2024-07-10 Update update check pi-power-button for beta branch
2024-07-10 Update install change pi-power-button to beta branch
2024-07-10 Update config adding print
2024-07-11 Update config switch to aprs mode for -A
2024-07-13 Update config added blue LED on/off to transmit function
2024-07-13 Update rpitx.py add green and blue LED control for n and e modes
2024-07-15 Update rpitx.py add powerPin
2024-07-15 Update config change to blue LED, 3 sec delay for aprs
2024-07-15 Update config add print beacon state
2024-07-16 Update dtmf_aprs_cc.py changed from print to echo for -o
2024-07-16 Update dtmf_aprs_cc.py swap -o on/off
    [dtmf_aprs_cc.py]
2024-07-16 Update dtmf_aprs_cc.py fix open
    [dtmf_aprs_cc.py]
2024-07-16 Update command search for USB Audio Device
2024-07-18 Update main.c fix > to <
    [main.c]
2024-07-20 uploading cubesatsim-battery-b1.3.2.2 hardware files
2024-07-22 Update config don't reboot if in safe mode (battery saver)
2024-07-23 Update dtmf_aprs_cc.py fix beacon on/off
    [dtmf_aprs_cc.py]
2024-07-23 Update rpitx.py fix green LED
2024-07-23 Update rpitx.py print Led info
2024-07-23 Update main.c no LED control
2024-07-26 Update update add WiringPi install
2024-07-27 Update .gitignore added battery_saver
2024-07-27 Update install changed WiringPi to latest
2024-07-27 Update rpitx.py remove pin prints
2024-07-29 Update update don't do full update for pi-power-button
2024-07-30 Update main.c fix camera test
    [main.c]
2024-07-30 Update main.c camera fix
    [main.c]
2024-07-30 Update dtmf_aprs_cc.py fix APRS force
    [dtmf_aprs_cc.py]
2024-07-30 Update dtmf_aprs_cc.py fix else
    [dtmf_aprs_cc.py]
2024-07-30 Update dtmf_aprs_cc.py skip every other command
    [dtmf_aprs_cc.py]
2024-08-29 Update CubeSatSim_rttelemetry.csv add Sensor2 and 3
    [CubeSatSim_rttelemetry.csv]
2024-08-29 Update CubeSatSim_rttelemetry.csv revert
    [CubeSatSim_rttelemetry.csv]
2024-08-29 Update CubeSatSim_rttelemetry.csv added Sensor2 and 3
    [CubeSatSim_rttelemetry.csv]
2024-08-29 Update CubeSatSim_rttelemetry.csv typos
    [CubeSatSim_rttelemetry.csv]
2024-08-29 Update CubeSatSim_rttelemetry.csv more
    [CubeSatSim_rttelemetry.csv]
2024-08-29 Update CubeSatSim_rttelemetry.csv added Sensor2 and 3 to Experiments
    [CubeSatSim_rttelemetry.csv]
2024-08-29 Update CubeSatSim_rttelemetry.csv remove exp1 status
    [CubeSatSim_rttelemetry.csv]
2024-08-29 Update CubeSatSim_rttelemetry.csv add to Experiments
    [CubeSatSim_rttelemetry.csv]
2024-08-29 Update CubeSatSim_rttelemetry.csv display as integers
    [CubeSatSim_rttelemetry.csv]
2024-08-29 Update CubeSatSim_rttelemetry.csv swap Hardware and Software
    [CubeSatSim_rttelemetry.csv]
2024-08-29 Update CubeSatSim_rttelemetry.csv add C2CStatus
    [CubeSatSim_rttelemetry.csv]
2024-08-29 Update CubeSatSim_rttelemetry.csv missing field
    [CubeSatSim_rttelemetry.csv]
2024-08-29 Update CubeSatSim_rttelemetry.csv fixed bounds
    [CubeSatSim_rttelemetry.csv]
2024-08-29 Update CubeSatSim_rttelemetry.csv name
    [CubeSatSim_rttelemetry.csv]
2024-08-29 Update CubeSatSim_rttelemetry.csv swapped back H and S
    [CubeSatSim_rttelemetry.csv]
2024-08-29 Update CubeSatSim_rttelemetry.csv wrong number
    [CubeSatSim_rttelemetry.csv]
2024-08-29 Create CubeSatSim_PSK_rttelemetry.csv initial file
    [CubeSatSim_PSK_rttelemetry.csv]
2024-08-29 Update CubeSatSim_PSK_rttelemetry.csv add Sensors 2,3 Bat2
    [CubeSatSim_PSK_rttelemetry.csv]
2024-08-29 Update CubeSatSim_PSK_rttelemetry.csv fixed Sensor 3
    [CubeSatSim_PSK_rttelemetry.csv]
2024-08-29 Update CubeSatSim_PSK_rttelemetry.csv Add C&C
    [CubeSatSim_PSK_rttelemetry.csv]
2024-08-29 Update CubeSatSim_PSK_rttelemetry.csv missing Experiments
    [CubeSatSim_PSK_rttelemetry.csv]
2024-08-29 Update main.c test Sensor 1-3
2024-08-29 Update CubeSatSim_PSK_rttelemetry.csv move C2CStatus
    [CubeSatSim_PSK_rttelemetry.csv]
2024-08-29 Update CubeSatSim_PSK_rttelemetry.csv add one more bit
    [CubeSatSim_PSK_rttelemetry.csv]
2024-08-29 Update CubeSatSim_PSK_rttelemetry.csv missing bits fixed
    [CubeSatSim_PSK_rttelemetry.csv]
2024-08-29 Create CubeSatSim_PSK_mintelemetry.csv initial file
    [CubeSatSim_PSK_mintelemetry.csv]
2024-08-29 Update CubeSatSim_PSK_mintelemetry.csv add C2C and units for Sensors 1-3
    [CubeSatSim_PSK_mintelemetry.csv]
2024-08-29 Create CubeSatSim_PSK_maxtelemetry.csv initial file
    [CubeSatSim_PSK_maxtelemetry.csv]
2024-08-29 Update CubeSatSim_PSK_maxtelemetry.csv add C2CState and Sensor 1-3 units
    [CubeSatSim_PSK_maxtelemetry.csv]
2024-08-30 Update CubeSatSim_PSK_maxtelemetry.csv added MAX
    [CubeSatSim_PSK_maxtelemetry.csv]
2024-08-30 Update CubeSatSim_PSK_rttelemetry.csv fixed pad2
    [CubeSatSim_PSK_rttelemetry.csv]
2024-08-30 Update CubeSatSim_PSK_mintelemetry.csv added MIN
    [CubeSatSim_PSK_mintelemetry.csv]
2024-08-30 Update CubeSatSim_PSK_maxtelemetry.csv fixed NONE
    [CubeSatSim_PSK_maxtelemetry.csv]
2024-08-30 Update CubeSatSim_PSK_mintelemetry.csv fixed NONE
    [CubeSatSim_PSK_mintelemetry.csv]
2024-08-30 Create CubeSatSim_mintelemetry.csv initial file
    [CubeSatSim_mintelemetry.csv]
2024-08-30 Update CubeSatSim_mintelemetry.csv added additional fields
    [CubeSatSim_mintelemetry.csv]
2024-08-30 Update CubeSatSim_mintelemetry.csv typo
    [CubeSatSim_mintelemetry.csv]
2024-08-30 Update CubeSatSim_mintelemetry.csv changed to MIN
    [CubeSatSim_mintelemetry.csv]
2024-08-30 Update CubeSatSim_mintelemetry.csv renamed bat_i
    [CubeSatSim_mintelemetry.csv]
2024-08-30 Create CubeSatSim_maxtelemetry.csv copied from MIN
    [CubeSatSim_maxtelemetry.csv]
2024-08-30 Update CubeSatSim_PSK_rttelemetry.csv added spaces
    [CubeSatSim_PSK_rttelemetry.csv]
2024-08-30 Update CubeSatSim_rttelemetry.csv added spaces
    [CubeSatSim_rttelemetry.csv]
2024-08-30 Update main.c sensor 1,2,3 testing
2024-08-30 Update main.c sensor min max fix
    [main.c]
2024-08-30 Update main.c sensor 1,2,3 max and min
2024-08-30 Update CubeSatSim_PSK_mintelemetry.csv sensor 2,3 min
    [CubeSatSim_PSK_mintelemetry.csv]
2024-08-30 Update CubeSatSim_PSK_maxtelemetry.csv fix max sensor 2,3
    [CubeSatSim_PSK_maxtelemetry.csv]
2024-08-30 Update CubeSatSim_PSK_mintelemetry.csv remove dup 6.7 6,8
    [CubeSatSim_PSK_mintelemetry.csv]
2024-08-30 Update CubeSatSim_PSK_maxtelemetry.csv fix min 6,8 6,9
    [CubeSatSim_PSK_maxtelemetry.csv]
2024-08-31 Update CubeSatSim_PSK_maxtelemetry.csv from rt
    [CubeSatSim_PSK_maxtelemetry.csv]
2024-08-31 Update CubeSatSim_PSK_mintelemetry.csv from rt
    [CubeSatSim_PSK_mintelemetry.csv]
2024-08-31 Update CubeSatSim_maxtelemetry.csv from rt
    [CubeSatSim_maxtelemetry.csv]
2024-08-31 Update CubeSatSim_mintelemetry.csv from max
    [CubeSatSim_mintelemetry.csv]
2024-08-31 Update CubeSatSim_PSK_rttelemetry.csv changed to Battery2
    [CubeSatSim_PSK_rttelemetry.csv]
2024-08-31 Update CubeSatSim_rttelemetry.csv changed to Battery2
    [CubeSatSim_rttelemetry.csv]
2024-08-31 Update CubeSatSim_rttelemetry.csv added COMMAND_STATUS
    [CubeSatSim_rttelemetry.csv]
2024-08-31 Update CubeSatSim_rttelemetry.csv c2cstatus 2 bit
    [CubeSatSim_rttelemetry.csv]
2024-08-31 Update CubeSatSim_maxtelemetry.csv c2cstatus 2 bit
    [CubeSatSim_maxtelemetry.csv]
2024-08-31 Update CubeSatSim_mintelemetry.csv c2cstatus 2 bit
    [CubeSatSim_mintelemetry.csv]
2024-08-31 Update main.c print c2cStatus
2024-08-31 Update main.c fix printf
    [main.c]
2024-08-31 Update main.c fix c2cstatus print
    [main.c]
2024-08-31 Update CubeSatSim_mintelemetry.csv add COMMAND_STATUS
    [CubeSatSim_mintelemetry.csv]
2024-08-31 Update CubeSatSim_PSK_rttelemetry.csv add COMMAND_STATUS
    [CubeSatSim_PSK_rttelemetry.csv]
2024-08-31 Update CubeSatSim_PSK_mintelemetry.csv add COMMAND_STATUS
    [CubeSatSim_PSK_mintelemetry.csv]
2024-08-31 Update CubeSatSim_PSK_maxtelemetry.csv add COMMAND_STATUS
    [CubeSatSim_PSK_maxtelemetry.csv]
2024-08-31 Update main.c print c2cstatus with /n
2024-08-31 Update main.c no digits SSTV current
2024-09-07 Update main.c print ant status
2024-09-07 Update main.c print 4 digits
2024-09-08 Update main.c fix sleep 5
    [main.c]
2024-09-14 add v2.0 PCB files
2024-09-22 Update main.h add error_count
    [main.h]
2024-09-22 Update main.c restart rpitx after 5 socket errors
    [main.c]
2024-09-26 Update main.c fix groundCommandCount
    [main.c]
2024-09-26 Update main.h add groundCommandCount
2024-10-13 Update main.c only increment reset_count if rebooted
    [main.c]
2024-10-13 Update main.c print reset count if incremented
    [main.c]
2024-10-18 Update install changed pi-power-button to v1.2
2024-10-18 Update install changed pi-power-button to v2.0
2024-10-31 Update update pi-power-button use master branch
2024-11-28 Update pacsat.sh change to passat ground station
2024-11-30 Update install download passat ground station
2024-12-01 Update transmit.py fixed pacsat call
    [transmit.py]
2024-12-01 Update config .mode P is pacsat ground station
2024-12-01 Update transmit.py added mode P for Pacsat Gnd Station
2024-12-01 Update config add print Pacsat ground station mode
2024-12-05 Update transmit.py change to USB Soundcard instead of Headphones (PWM)
2024-12-07 Update transmit.py fix zero squelch for pacsat
    [transmit.py]
2024-12-19 add v2.0.2 battery files
2024-12-19 added solar v2.0.2 pcb files
2024-12-19 added main v2.0.1 PCB files
2024-12-30 Update pacsat.sh restart pacsatsim in ground station
2025-01-01 Update transmit.py fixed CARD=Device
    [transmit.py]
2025-01-02 Update install switch pi_pacsat back to ac2cz
2025-01-03 Update sstv_decode_prompt.sh changed play device
2025-01-04 Create rtltcp.socket from niclashoyer/rtltcp
2025-01-04 Update transmit.py added prints
2025-01-08 Update config change callsign in Pacsat Ground Station
2025-01-19 Update main.c fix ao40 objects
    [main.c]
2025-01-19 Update main.c fixed printf
    [main.c]
2025-01-19 Update main.c add prints
2025-01-19 Update main.c change prints
2025-01-19 Update main.c print BLOCKSIZE
2025-01-19 Update main.c print
2025-01-19 Update main.c missing int
    [main.c]
2025-01-20 Update main.c fix sleep time
    [main.c]
2025-01-20 Update main.c print smaller
2025-01-20 Update main.c print buffer
2025-01-20 Update main.c print * for flip_ctr
    [main.c]
2025-01-20 Update main.c only print < 1000
2025-01-20 Update main.c print smaller if < 1000
2025-01-20 Update main.c fix j
    [main.c]
2025-01-20 Update main.c fix {}
    [main.c]
2025-01-20 Update main.c remove prints
2025-01-20 Update main.c add frame type
2025-01-20 Update main.c try frame MSB first
2025-01-20 Update main.c print symbol
2025-01-20 Update main.c print final symbol
2025-01-28 Update main.c print length ctr
2025-01-28 Update main.c add bat volt current resets
    [main.c]
2025-01-28 Update main.c fix telem
    [main.c]
2025-01-28 Update main.c print current and voltage
2025-01-28 Update main.c printf
2025-01-28 Update main.c print bat voltage and current
2025-01-28 Update main.c fixed numbering
    [main.c]
2025-01-28 Update main.c fix sim charging current bug
    [main.c]
2025-01-28 Update main.c fix sim current
    [main.c]
2025-01-29 Update main.c reduce sim current
2025-01-30 Update main.c add hex print
2025-01-30 Update main.c fix b
    [main.c]
2025-01-30 Update main.c add currents
2025-01-30 Update main.c fix currents
    [main.c]
2025-01-31 Update main.c fix defines
    [main.c]
2025-01-31 Update main.c fix JY-1 seq
    [main.c]
2025-01-31 Update main.c missing ]
    [main.c]
2025-01-31 Update main.c prints
2025-01-31 Update main.c prints for x
2025-01-31 Update main.c don't multiply current by 1000
2025-01-31 Update main.c print current minus
2025-01-31 Update main.c print currents
2025-01-31 Update main.c shift fixes
    [main.c]
2025-01-31 Update main.c more prints
2025-01-31 Update main.c added missing extended +
    [main.c]
2025-01-31 Update main.c missing extended
    [main.c]
2025-02-01 Update main.c try antenna deployment
2025-02-02 Update main.c add socket_send
2025-02-02 Update main.h add socket_send
2025-02-02 Update main.c add socket_send print
2025-02-02 Update main.c print Socket_send
2025-02-02 Update main.c add back missing socket_send
    [main.c]
2025-02-02 Update main.c add Frame IMG2
2025-02-02 Update main.c fixed image_file
    [main.c]
2025-02-03 Update transmit.py fix not
    [transmit.py]
2025-02-03 Update transmit.py fix str
    [transmit.py]
2025-02-03 Update transmit.py add str() to print
2025-02-03 Update transmit.py add prints
2025-02-03 Update transmit.py fix camera image path
    [transmit.py]
2025-02-03 Update main.c alternate last bit of frame id
2025-02-03 Update transmit.py camera_photo function, -q 2
2025-02-04 Update transmit.py FC send stored image if no camera
2025-02-04 Update main.c fix FC_PAYLOAD
    [main.c]
2025-02-04 Update transmit.py fix camera test
    [transmit.py]
2025-02-05 Update update add git pull when switching branch
2025-02-06 Update fc_block_decode.py print some telem
2025-02-06 Update fc_block_decode.py add payload prints
2025-02-06 Update fc_block_decode.py add print and :
2025-02-06 Update fc_block_decode.py print payload
2025-02-07 Update fc_block_decode.py save every frame image
2025-02-07 Update fc_block_decode.py print output of ssdv
2025-02-07 Update fc_block_decode.py add print
2025-02-08 Update fc_block_decode.py add prints
2025-02-08 Update fc_block_decode.py print seq
2025-02-08 Update fc_block_decode.py fix telem print
2025-02-09 Update fc_block_decode.py fix currents
2025-02-09 Update fc_block_decode.py add frame type and count
2025-02-11 Update transmit.py print elapsed time for camera image
2025-02-11 Update fc_block_decode.py print Decoded frequency
2025-02-11 Update transmit.py add variable sleep after camera
2025-02-22 Update transmit.py don't print checking file
2025-02-22 Update transmit.py change device from 1 to Card
2025-02-22 Update transmit.py don't turn off power LED for e
2025-02-22 Update transmit.py remove power pin from e
2025-02-22 Update fc_block_decode.py print datetime
2025-02-25 Update direwolf-pacsatsim-jp14.conf making the same as loopback but with Device
2025-02-25 Update direwolf-fm-pacsat-jp14.conf making same as loopback but with Device
2025-05-22 Update command print uptime in log
2025-05-22 Update transmit.py fixed spaces
    [transmit.py]
2025-06-08 Update direwolf.conf remove output device
2025-06-09 Update main.c missing {
    [main.c]
2025-06-09 Update main.c print thresholds
2025-06-09 Update main.c change battery_saver_mode variable
2025-06-09 Update install pi-power-button back to master
2025-06-09 Update update pi-power-button back to master
2025-06-10 Update main.c fix BAT2 only APRS zero voltage and current
    [main.c]
2025-06-10 Update update fix pi-power-button update
2025-06-12 Update main.c fix if defined
    [main.c]
2025-06-12 Update fc_block_decode.py print frame type and sat id
2025-06-12 Update transmit.py print skip
    [transmit.py]
2025-06-12 Update transmit.py add CW ID print
2025-06-13 Update transmit.py fix typo
    [transmit.py]
2025-06-13 Update transmit.py missing }
    [transmit.py]
2025-07-27 Update main.c fix sensor XS1,2,3 min and max
    [main.c]
2025-08-07 Update main.c add simulated failures
    [main.c]
2025-08-07 Update main.c added prints for failure modes
    [main.c]
2025-08-07 Update main.c fixed prints
    [main.c]
2025-08-07 Update main.c fix FoxTelem indication
    [main.c]
2025-08-07 Update main.h update fail count
    [main.h]
2025-08-07 Update main.h I2C and Camera Failures
    [main.h]
2025-08-07 Update main.c I2C 1 and 3 and Camera failures
    [main.c]
2025-08-07 Update main.c print i2c 1 and 3 bus
2025-08-07 Update main.c print bus status
2025-08-07 Update main.c fix i2c 1 and 3 bus on and off
    [main.c]
2025-08-07 Update main.h change to fail payload
    [main.h]
2025-08-07 Update main.c add Payload, MPU, and BME failures
    [main.c]
2025-08-07 Update main.c fix payload OK
    [main.c]
2025-08-07 Update main.c payload failure
    [main.c]
2025-08-07 Update main.c fix payload failure
    [main.c]
2025-08-07 Update main.c fixing payload failure
    [main.c]
2025-08-07 Update main.c more payload failure changes
    [main.c]
2025-08-07 Update main.c fix bme temp fail
    [main.c]
2025-08-08 Update transmit.py check for failure_mode 10 no FM audio
    [transmit.py]
2025-08-08 Update main.h add FAIL_AUDIO mode
    [main.h]
2025-08-08 Update config changed failure print
2025-08-08 Update main.h added FAIL_NONE
    [main.h]
2025-08-08 Update main.c added missing ==
    [main.c]
2025-08-08 Update main.c fix i2c
    [main.c]
2025-08-08 Update config print failure mode number
2025-08-08 Update config print result
2025-08-08 Update main.c sim mode random failure
    [main.c]
2025-08-08 Update main.h def failureMode
    [main.h]
2025-08-08 Update main.c write random failure to file
    [main.c]
2025-08-08 Update main.c payload failures at sensor
    [main.c]
2025-08-08 Update main.c move failure set mode out of get_fox_tlm
    [main.c]
2025-08-09 Update main.c print sensor_payload
2025-08-09 Update main.c restore sensor_payload
2025-08-09 Update main.c recreate sensor_string
2025-08-09 Update main.c add sensor_string
2025-08-09 Update main.h add sensor_string
2025-08-09 Update main.c fix dimension
    [main.c]
2025-08-09 Update main.h fix sensor_string
    [main.h]
2025-08-09 Update main.c fix sensor_string
    [main.c]
2025-08-09 Update main.c copy 0.0 for failure
    [main.c]
2025-08-09 Update main.c do sensor_string copy
2025-08-09 Update main.c comment on sensor_string print
2025-08-09 Update main.c add MPU fail
    [main.c]
2025-08-09 Update main.c don't recreate string if payload fail
    [main.c]
2025-08-09 Update main.c remove extra fail ifs
    [main.c]
2025-08-09 Update main.c fix missing }
    [main.c]
2025-08-09 Update main.c fix extra zeros
    [main.c]
2025-08-09 Update main.c battery prints
2025-08-09 Update main.c revert VB4 and 5 code
    [main.c]
2025-08-09 Update main.c fix deg
    [main.c]
2025-08-09 Update config print sim fail mode with -M
2025-08-09 Update main.h changed FAIL_NONE to -1
    [main.h]
2025-08-09 Update transmit.py fix turn fail off
    [transmit.py]
2025-08-09 Update transmit.py fix indent
    [transmit.py]
2025-08-09 Update transmit.py fix global
    [transmit.py]
2025-08-10 Update main.c read failure in sim_mode
    [main.c]
2025-08-10 Update config print fail
2025-08-10 Update transmit.py add fail camera mode check
    [transmit.py]
2025-08-10 Update transmit.py print fail mode
    [transmit.py]
2025-08-10 Update transmit.py change fail_mode to int
    [transmit.py]
2025-08-10 Update transmit.py fix no failure mode
    [transmit.py]
2025-08-16 Update main.h added FAIL_UNPLUG
    [main.h]
2025-08-16 Update main.c adde FAIL_UNPLUG
    [main.c]
2025-08-16 Update main.h update fail numbers
    [main.h]
2025-08-16 Update main.c remove secondTime and short sleep on first time
    [main.c]
2025-08-16 Update update add pi-power-button next branch
2025-08-16 Update update force pi-power-button to update
2025-08-16 Update main.h added fail_yes and fail_time
    [main.h]
2025-08-16 Update main.h add fail_rnd_mode
    [main.h]
2025-08-16 Update main.h added failTime
    [main.h]
2025-08-16 Update main.c added random sim fail to sim.cfg
    [main.c]
2025-08-16 Update main.c default fail_rnd to no
    [main.c]
2025-08-16 Update main.c swap order
    [main.c]
2025-08-17 Update transmit.py fix no fail mode
    [transmit.py]
2025-08-21 Create sensor_extension.c copied from payload_extension.cpp
2025-08-21 Update sensor_extension.c function names to sensor
2025-08-21 Update sensor_extension.c cleanup
2025-08-21 Update main.h add sensor_setup and loop declarations
2025-08-21 Update main.c add sensor_setup and sensor_loop
2025-08-21 Update Makefile add sensor_extension.c
2025-08-21 Update main.h add char *char *sensor_buffer
2025-08-21 Update sensor_extension.c add sensor_buffer and sensor count
2025-08-21 Update main.c add sensor buffer and count
2025-08-24 Update main.c add sim sensors
2025-08-24 Update main.c fixed sim voltages
    [main.c]
2025-08-26 Update sensor_extension.c missing libs
    [sensor_extension.c]
2025-08-26 Update main.c fix axis
    [main.c]
2025-08-26 Update main.c print sim sensor
2025-08-27 Update main.c remove print
2025-08-27 Update main.c add back length print
2025-08-27 Update sensor_extension.c add \n
2025-08-27 Update main.c print spin too
2025-08-27 Update main.c print new sensor string
2025-08-27 Update main.c add sensor payload 0,1,2 set
2025-08-27 Update main.c change to sensor_string
2025-08-27 Update main.c no sim failure print
    [main.c]
2025-08-27 Update main.h fail_bme wrong
    [main.h]
2025-08-27 Update main.c add back sensor_payload clear
2025-08-27 Update main.c add gyro_x y
2025-08-27 Update main.c add restore printf
2025-08-27 Update main.c don't clear sensor_payload in sim mode
2025-08-27 Update main.c print sensor[ALT]
2025-08-27 Update main.c don't clear sensor
2025-08-27 Update main.c move sim_mode sensor
2025-08-27 Update main.c always clear sensor and sensor payload
2025-08-27 Update main.c if payload failure, no sim payload telemetry
    [main.c]
2025-08-28 Update main.c fix cw
    [main.c]
2025-08-28 Update main.c fix aprs
    [main.c]
2025-09-01 Update main.h change threshold to 3.55 V
2025-09-05 Update sensor_extension.c read bme
2025-09-05 Update sensor_extension.c remove extra
2025-09-05 Update main.c fix FILE
    [main.c]
2025-09-05 Update main.c include mpu sensor
2025-09-10 Update transmit.py fix no fm
    [transmit.py]
2025-09-10 Update main.c show sim voltage and current in sstv
2025-09-10 Update main.c add sim printf
2025-09-10 Update main.c missing )
    [main.c]
2025-10-14 2U frame connector
    [cubesatsim_frame_connector.v2.0.stl]
2025-10-27 Update auto-tune.py only print results
2025-10-28 Update auto-tune.py switch to 1e6
2025-10-28 Update sstv_decode_prompt.sh only print autotune when above threshold
2025-10-28 Update sstv_decode_prompt.sh change prints
2025-10-29 Update CubeSatSim_conversion_curves.csv alt*10
    [CubeSatSim_conversion_curves.csv]
2025-10-29 Update CubeSatSim_rttelemetry.csv alt int
    [CubeSatSim_rttelemetry.csv]
2025-10-29 Update CubeSatSim_mintelemetry.csv alt int
    [CubeSatSim_mintelemetry.csv]
2025-10-29 Update CubeSatSim_maxtelemetry.csv alt int
    [CubeSatSim_maxtelemetry.csv]
2025-10-29 Update CubeSatSim_PSK_mintelemetry.csv alt int
    [CubeSatSim_PSK_mintelemetry.csv]
2025-10-29 Update CubeSatSim_PSK_maxtelemetry.csv alt int
    [CubeSatSim_PSK_maxtelemetry.csv]
2025-10-29 Update CubeSatSim_PSK_rttelemetry.csv remove blank rows
    [CubeSatSim_PSK_rttelemetry.csv]
2025-10-29 Update CubeSatSim_mintelemetry.csv remove blank lines
    [CubeSatSim_mintelemetry.csv]
2025-10-29 Update CubeSatSim_maxtelemetry.csv remove blank lines
    [CubeSatSim_maxtelemetry.csv]
2025-10-29 Update CubeSatSim_PSK_mintelemetry.csv remove blank lines
    [CubeSatSim_PSK_mintelemetry.csv]
2025-10-29 Update CubeSatSim_PSK_maxtelemetry.csv remove blank lines
    [CubeSatSim_PSK_maxtelemetry.csv]
2025-10-29 Update CubeSatSim_rttelemetry.csv remove blank lines
    [CubeSatSim_rttelemetry.csv]
2025-10-29 Update CubeSatSim_conversion_curves.csv remove blank lines
    [CubeSatSim_conversion_curves.csv]
2025-10-29 Update CubeSatSim_PSK_maxtelemetry.csv remove blank lines at end
    [CubeSatSim_PSK_maxtelemetry.csv]
2025-10-31 update to use USB device
2025-11-02 Update transmit.py fixed pacsatsim and pacsat modes
    [transmit.py]
2025-11-06 v2.1 hardware Main, Solar, and Battery boards
    [CubeSatSim Main v2.1.0 BOM.xls]
2025-11-06 Update readme.md update v2.1 PCB images
2025-11-06 Update README.md update to v2.1 PCB images
2025-11-06 Update CubeSatSim_rttelemetry.csv add 10 bit ground commands count
    [CubeSatSim_rttelemetry.csv]
2025-11-06 Update CubeSatSim_rttelemetry.csv remove old Ground Commands
    [CubeSatSim_rttelemetry.csv]
2025-11-06 Update main.c add 2nd groundCommandCount
2025-11-06 Update CubeSatSim_PSK_rttelemetry.csv add groundCommandCount2
    [CubeSatSim_PSK_rttelemetry.csv]
2025-11-06 Update CubeSatSim_PSK_rttelemetry.csv reduce pad size
    [CubeSatSim_PSK_rttelemetry.csv]
2025-11-06 Update CubeSatSim_PSK_rttelemetry.csv change name
    [CubeSatSim_PSK_rttelemetry.csv]
2025-11-06 Update CubeSatSim_PSK_rttelemetry.csv move GroundCommands2
    [CubeSatSim_PSK_rttelemetry.csv]
2025-11-06 remove blank lines at end
    [CubeSatSim_PSK_rttelemetry.csv, CubeSatSim_rttelemetry.csv]
2025-11-06 change module to NONE
    [CubeSatSim_rttelemetry.csv]
2025-11-19 Lite v2.0.1 PCB files
2025-11-21 Update main.c pi_sensors if payload_serial fails
    [main.c]
2025-12-01 Update install change pacsat ground to 46n
2025-12-02 Create direwolf-pacsat-pwm.conf for pwm audio out
2025-12-02 Update pacsatsim-df.sh add pwm variable
2025-12-02 Update pacsat-df.sh add pwm variable
2025-12-02 Create direwolf-fm-pacsat-pwm.conf add PWM
2025-12-13 Update main.c fix get_tlm_fox {}
    [main.c]
2025-12-14 Update gps_client.py just print mode lat lon
2025-12-14 Update gps_client.py fix mode print
    [gps_client.py]
2025-12-14 Update gps_client.py print values
2025-12-14 Update gps_client.py fix prints
    [gps_client.py]
2025-12-14 Update gps_client.py fix print
    [gps_client.py]
2025-12-14 Update gps_client.py fix if
    [gps_client.py]
2025-12-14 Update gps_client.py fix ()
    [gps_client.py]
2025-12-14 Update gps_client.py return -1 if no socket
2025-12-14 Update gps_client.py fix except
    [gps_client.py]
2025-12-14 Update gps_client.py missing "
    [gps_client.py]
2025-12-14 Update gps_client.py extra print
2025-12-14 Update gps_client.py make fail -1 0 0 0
    [gps_client.py]
2025-12-14 Update main.c missing (
    [main.c]
2025-12-14 Update main.h fix off
    [main.h]
2025-12-14 Update main.c add error checking gps
    [main.c]
2025-12-14 Update gps_client.py remove extra prints
2025-12-14 Update gps_client.py no prints
2025-12-14 Update main.c fix gps read print
    [main.c]
2025-12-14 Update main.c fix and
    [main.c]
2025-12-14 Update main.c pi gps sensor parsing
2025-12-14 Update main.c fix const
    [main.c]
2025-12-15 Update main.c print last two chars
2025-12-16 Update transmit.py command error
    [transmit.py]
2025-12-16 Update transmit.py fix tabs
    [transmit.py]
2025-12-16 Update transmit.py fix gpsd query
    [transmit.py]
2025-12-16 Update transmit.py fix e.result
    [transmit.py]
2025-12-16 Update transmit.py fix is-active cmd
    [transmit.py]
2025-12-16 Update transmit.py print gpsd status
2025-12-16 Update transmit.py print typo
2025-12-16 Update config gpsd and gpsd.socket
2025-12-16 Update config add gpsmon print
2025-12-29 Update dtmf_aprs_cc.py replace rpitx with transmit
    [dtmf_aprs_cc.py]
2025-12-30 Update dtmf_aprs_cc.py back to counter to avoid double beacon on/off
    [dtmf_aprs_cc.py]
2025-12-30 Update config add space in transmit command print
2026-01-01 Update config fix printout
2026-01-01 Update config with print
2026-01-01 Update config with more prints
2026-01-01 Update config fix prints
2026-01-01 Update config Transmit Commands prints
2026-01-01 Update config print change in dtmf
2026-01-01 Update config fix print new
2026-01-01 Update config print restart/reboot result
2026-01-17 Update dtmf_aprs_cc.py print counter
2026-01-17 Update transmit.py don't turn off green LED in x or n mode
2026-01-17 Update transmit.py fix if
    [transmit.py]
2026-01-17 Update config print mode
2026-01-18 Update config remove extra print
2026-01-18 Update transmit.py bypass Battery Saver in Transmit Commands
2026-01-18 Update transmit.py ignore Battery Saver in Transmit Commands mode
2026-01-18 Update config print TX freq in transmit command
2026-01-20 Update main.c APRS sim voltage and current
2026-01-20 Update main.c fix pi_sensors strncmp
    [main.c]
2026-01-20 Update main.c print atmosphere, 50% chance
2026-01-21 Update main.c fix gpsd
    [main.c]
2026-01-21 Update main.c remove extra gps prints
2026-01-21 Update transmit.py turn gpsd.socket on and off to program TXC
2026-01-21 Update main.c print command count
2026-01-21 print if command_count.txt is invalid
2026-01-21 Replace print with printf for temperature and pressure
    [main.c]
2026-01-21 Enhance simulated payload telemetry with randomness
    Refactor simulated payload generation logic to include random variations in temperature, pressure, and humidity.
2026-01-21 Fix conditional statement for STEMBoardFailure in sim_mode
    [main.c]
2026-01-21 Fix syntax error in conditional statement
    [main.c]
2026-01-21 Adjust temperature calculation in main.c
2026-01-22 Change failureMode range from 1-9 to 1-10
    [main.c]
2026-01-22 Call sim_failure_check before CW ID
    Added sim_failure_check() call after restarting gpsd.socket.
2026-01-22 Fix battery voltage reporting in telemetry string for BAT2 only
    [main.c]
2026-01-22 Add sim_config so can handle sim_mode on/off correctly
    [transmit.py]
2026-01-22 Transmit carrier only in APRS if FM failure sim
    [transmit.py]
2026-01-22 Fix sim_mode assignment in transmit.py
    [transmit.py]
2026-01-22 fix carrier only transmit
    [transmit.py]
2026-01-22 Fix command syntax for transmit function with sudo
    [transmit.py]
2026-01-22 print result.stdout
2026-01-22 revert battery saver transmit changes
    [transmit.py]
2026-01-22 remove timeout that doesn't work
    [transmit.py]
2026-01-22 Print card information before sim failure check
    [transmit.py]
2026-01-22 Assign card variable to 'Headphones' in failure modes
    Added card variable assignment for headphones in failure modes.
    [transmit.py]
2026-01-22 Add print statement for simulated telemetry mode
2026-01-22 Fix syntax error in transmit.py condition
    [transmit.py]
2026-01-22 Add sleep delay for FSK no CW ID fix
    Added a sleep delay to address FSK no CW ID issue.
    [transmit.py]
2026-01-22 Fix indentation for try block in transmit.py
    [transmit.py]
2026-01-22 Fix indentation for mode check in transmit.py
    [transmit.py]
2026-01-23 revert changes to try to fix FSK CW issue
    [transmit.py]
2026-01-23 Update main.c add error_count=0
    [main.c]
2026-01-23 Update main.c move error_count=0
    [main.c]
2026-01-23 Update main.c move error_count back to socket opening
    [main.c]
2026-01-23 Update main.c move new sensor payload read
2026-01-23 Update main.c don't display payload extension if payload failure
    [main.c]
2026-01-23 Fix ALT sim payload
    [main.c]
2026-01-23 Update main.c change payload temp on ground to IHU Temp
2026-01-24 Update main.c fix typos
    [main.c]
2026-01-24 Update main.c fix if typo
    [main.c]
2026-01-24 Update main.c move voltage and current fail simulation code
    [main.c]
2026-01-24 Update transmit.py fix HAB mode CW ID setting
    [transmit.py]
2026-01-24 Update main.c zero out DTEMP and XS if payload fail
    [main.c]
2026-01-24 Update main.c SSTV if I2C fail show zero batt voltage
    [main.c]
2026-01-24 Update main.c fix conditional for SSTV Fail I2C1
    [main.c]
2026-01-24 Update main.c move telem_str to after fail changes
    [main.c]
2026-01-24 Update main.c add telem_str printf
2026-01-25 Update main.c fix telem_str.txt for SSTV mode
    [main.c]
2026-01-25 Update transmit.py test i2c3 to see if sim mode auto turned on
2026-01-25 Update transmit.py missing :
    [transmit.py]
2026-01-25 Update config add check for battery sensor
2026-01-25 Update config battery address 44 or 45
2026-01-25 Update config switch check
2026-01-25 Update config fix battery not present
2026-01-25 Update main.c remove sim_mode_auto if battery present
2026-01-25 Update config remove battery check
2026-01-25 Update main.c cleanup of Sim Mode prints
2026-01-25 Update main.c fix log message
    [main.c]
2026-01-26 Update main.c if not simulated camera fail, use real camera test
    [main.c]
2026-01-26 Update asound.conf change from card number to name Device
2026-01-26 Update main.c remove error_count reset
    [main.c]
2026-01-26 Update main.c add sleep of 1 sec for each socket opening error
    [main.c]
2026-01-26 Update main.c add sleep 1 after each connection refused error
    [main.c]
2026-01-26 add fflush to socket error prints
    [main.c]
2026-01-27 voltage threshold to 3.5 V
2026-01-28 don't restore payload if sim mode and sim payload fail
    [main.c]
2026-01-28 Update main.c restore if not sim payload fail
    [main.c]
2026-01-28 Update main.c initialize failTime
    [main.c]
2026-01-28 Update main.c random failure log new mode
    [main.c]
2026-01-28 Update main.c fix random failures mode
    [main.c]
2026-01-28 Update main.c always update payload sensor data unless payload failure
    [main.c]
2026-02-01 Update main.c print loop time for fun cube mode
2026-02-04 Update update check for PacSat Ground and check for Desktop
2026-02-05 Update direwolf-fm-pacsat-pwm.conf change to plughw and txdelay 1000
2026-02-05 Update direwolf-pacsatsim-pwm.conf txdelay 1000 txtail 10
2026-02-06 Update direwolf-pacsatsim-pwm.conf add transmit LED
2026-02-06 Update direwolf-fm-pacsat-pwm.conf add transmit LED
2026-02-06 Update direwolf-fm-pacsat-pwm.conf put transmit LED ptt on same line
2026-02-07 Add renamed BPSK telem files from FoxTelem
    [PacSatSim_conversion_curves.csv, PacSatSim_maxtelemetry.csv, PacSatSim_mintelemetry.csv, PacSatSim_rttelemetry.csv, PacSatSim_wodtelemetry.csv]
2026-02-07 Update PacSatSim_rttelemetry.csv remove FLOAT2 and INT
    [PacSatSim_rttelemetry.csv]
2026-02-07 Update PacSatSim-coef.csv add divide by 100 field
    [PacSatSim-coef.csv]
2026-02-07 Update PacSatSim_rttelemetry.csv changed voltage to 29
    [PacSatSim_rttelemetry.csv]
2026-02-07 Update PacSatSim_rttelemetry.csv replace rest of cubesatsim_ conversations
    [PacSatSim_rttelemetry.csv]
2026-02-07 Update PacSatSim-coef.csv add rest of conversions
    [PacSatSim-coef.csv]
2026-02-07 Update PacSatSim-coef.csv add Status enum 33
    [PacSatSim-coef.csv]
2026-02-07 Update PacSatSim_rttelemetry.csv add Status 33
    [PacSatSim_rttelemetry.csv]
2026-02-07 Update PacSatSim_rttelemetry.csv add rest of enums
    [PacSatSim_rttelemetry.csv]
2026-02-07 Update PacSatSim-coef.csv add rest of enums
    [PacSatSim-coef.csv]
2026-02-07 Update PacSatSim_rttelemetry.csv remove 42 and 43
    [PacSatSim_rttelemetry.csv]
2026-02-08 Update direwolf-pacsatsim-pwm.conf remove txled ptt
2026-02-08 Update transmit.py change to USB audio instead of PCM since doesn't work yet
    [transmit.py]
2026-02-08 Update transmit.py change card to Device
2026-02-08 Update transmit.py fix rpicam-still parameters
    [transmit.py]
2026-02-08 Update install add camera_auto_detect
2026-02-08 Update main.h revert venv
    [main.h]
2026-02-09 Update transmit.py change to PWM
2026-02-12 Update dtmf_aprs_cc.py change from py GPIO to WiringPi gpio
2026-02-12 Update dtmf_aprs_cc.py missing 's'
    [dtmf_aprs_cc.py]
2026-02-12 Update dtmf_aprs_cc.py don't turn off green LED
2026-02-12 Update dtmf_aprs_cc.py turn on green LED at end
2026-02-12 Update dtmf_aprs_cc.py fix indent
    [dtmf_aprs_cc.py]
2026-02-12 Update dtmf_aprs_cc.py only turn transmit LEDs off
2026-02-14 Update install add prints
2026-02-16 Update transmit.py add os_status print
2026-02-16 Update transmit.py add camera if
2026-02-16 Update transmit.py fix camera check
    [transmit.py]
2026-02-16 Update transmit.py fix OS test
    [transmit.py]
2026-02-16 Update transmit.py fix bullseye test
    [transmit.py]
2026-02-17 Update transmit.py change tx and power LED to wiringpi
2026-02-17 Update transmit.py replace remaining GPIO
    [transmit.py]
2026-02-17 Update main.c missing ,
    [main.c]
2026-02-17 Update main.c tes for camera based on os
2026-02-21 Refactor GPIO handling with output and input functions
    Refactor GPIO handling by creating output and input functions. Replace direct GPIO calls with these functions for better abstraction and error handling.
    [transmit.py]
2026-02-21 Comment out GPIO setup mode and warnings
    Comment out GPIO setup lines for power management.
2026-02-21 input return integer not string
    Change return type of subprocess result to int and update error handling.
    [transmit.py]
2026-02-22 Add debug print statements in transmit.py and fix setup to use pin
    Added print statements to output and setup functions for debugging.
    [transmit.py]
2026-02-25 Update GPIO output and setup for PTT pin 20
    Refactor GPIO handling to use RPi.GPIO library for pin 20.
2026-02-26 Refactor telemetry CSV format and remove empty lines
    Removed unused lines and adjusted telemetry data format.
    [PacSatSim_rttelemetry.csv]
2026-02-28 Fix extra brackets in main.c
    Removed extra brackets that were unnecessary in the code.
    [main.c]
2026-02-28 Fix fwrite call to use sizeof(char) for byte count
    [main.c]
2026-02-28 Fix byte count for writing to tlm.bin to 70
    [main.c]
2026-02-28 Add timestamp field to telemetry CSV
    Added a timestamp field to the telemetry data.
    [PacSatSim_maxtelemetry.csv]
2026-02-28 Modify telemetry CSV to add timestamp and update data types
    Updated telemetry data format to include timestamp and change data types from integer to float for various sensors.
    [PacSatSim_rttelemetry.csv]
2026-02-28 Fix fwrite size argument for time variable
    [main.c]
2026-02-28 Update main.c with correct time
    [main.c]
2026-02-28 Update main.c fix timestamp
    [main.c]
2026-02-28 Update main.c fix timestamp write
    [main.c]
2026-02-28 print battery voltage for debugging
2026-02-28 Update main.c print b
2026-02-28 Update main.c with index print
2026-02-28 Update main.c print first 5 bytes of b
2026-02-28 Fix b declaration bug
    [main.c]
2026-02-28 Update main.c print bytes of b[]
2026-02-28 Update PacSatSim_rttelemetry.csv remove blank lines at end
    [PacSatSim_rttelemetry.csv]
2026-02-28 Update PacSatSim-coef.csv fix On/Off
    [PacSatSim-coef.csv]
2026-02-28 Update PacSatSim_rttelemetry.csv fix commands count
    [PacSatSim_rttelemetry.csv]
2026-02-28 Update PacSatSim_rttelemetry.csv remove extra blank lines at end
    [PacSatSim_rttelemetry.csv]
2026-02-28 Update main.c reset firstTime
    [main.c]
2026-02-28 Update main.c print for first time off
2026-02-28 Update main.c move sampleTime set
2026-02-28 Update main.c revert last change
    [main.c]
2026-02-28 Update main.c move sampleTime
2026-02-28 Update main.c again revert
    [main.c]
2026-03-01 Update PacSatSim_rttelemetry.csv fixed sensor 1 size
    [PacSatSim_rttelemetry.csv]
2026-03-01 Update main.c fix missing mode == PACSAT
    [main.c]
2026-03-01 Update main.c print simulated telemetry mode
2026-03-01 Update main.c print simulated currents
2026-03-01 Update main.c fix simulated current
    [main.c]
2026-03-01 Update PacSatSim_rttelemetry.csv from pacsat-v2.2-tlm2
    [PacSatSim_rttelemetry.csv]
2026-03-01 Update main.c don't print BPSK config in PACSAT mode
2026-03-01 Update PacSatSim-coef.csv swap FAIL and OK
    [PacSatSim-coef.csv]
2026-03-01 Update direwolf-pacsatsim-pwm.conf with shared_mic
2026-03-01 Update direwolf-pacsatsim-jp14.conf fix Device
2026-03-01 Update dtmf_aprs_cc.py try around stdin read for UTF-8 issue
    [dtmf_aprs_cc.py]
2026-03-02 Update config remove Ground callsign set, remove remote pacsat
2026-03-02 Update pacsat-config.sh to fix ground station callsign config
2026-03-02 Update direwolf-pacsat-loopback.conf same as pwm
2026-03-03 Update pacsat.sh print callsigns
2026-03-03 Update config remove pacsat ground reset
2026-03-03 Update pacsat-run.sh kill direwolf at end if quit Pacsat ground station
2026-03-04 change to current version direwolf
2026-03-04 Update pacsatsim.sh add vox print
2026-03-05 add try around read for UTF-8 issue
    [dtmf_aprs_cc.py]
2026-03-05 Update main.c resolve merge conflicts
    [main.c]
2026-03-05 Update main.h resolve merge conflicts
    [main.h]
2026-03-05 Update transmit.py resolve merge conflicts
    [transmit.py]
2026-03-06 Update main.c fix else
    [main.c]
2026-03-06 Update main.c missing PACSAT conditional
    [main.c]
2026-03-06 Update main.c fix extra {
    [main.c]
2026-03-06 Update transmit.py fix output duplicate
    [transmit.py]
2026-03-06 Update transmit.py missing "
    [transmit.py]
2026-03-06 Update transmit.py print GPIO setup
2026-03-08 Update main.c add missing start transmit
    [main.c]
2026-03-08 Update main.c not missing transmit
    [main.c]
2026-03-08 Update transmit.py fix ptt
    [transmit.py]
2026-03-08 Update transmit.py input just print output
2026-03-08 Update transmit.py missing tab
    [transmit.py]
2026-03-09 Update install only download PacSat Ground if not installed
2026-03-09 Update direwolf-pacsatsim-pwm.conf update to work with Bookworm
2026-03-09 Update direwolf-pacsatsim-pwm.conf fix typo
2026-03-11 Update main.c remove test for i2c-bus 11
2026-03-11 Update direwolf-pacsatsim-pwm.conf add DIGIPEAT
2026-03-13 Update PacSatSim_rttelemetry.csv Altitude times 100
    [PacSatSim_rttelemetry.csv]
2026-03-13 Update PacSatSim-coef.csv add Times 100 for Alt, use Sint16 for currents
    [PacSatSim-coef.csv]
2026-03-13 Update PacSatSim-coef.csv Try Counts for integers
    [PacSatSim-coef.csv]
2026-03-13 Update PacSatSim_rttelemetry.csv counts for pressure
    [PacSatSim_rttelemetry.csv]
2026-03-13 Update PacSatSim-coef.csv change to times 10
    [PacSatSim-coef.csv]
2026-03-14 Update direwolf-pacsatsim-pwm-loopback.conf add loopback
2026-03-14 Update direwolf-pacsatsim-pwm-loopback.conf ptt to 27
2026-03-14 Update direwolf-pacsatsim-pwm-loopback.conf gpis 17 for PTT (need jumper)
2026-03-14 Update transmit.py indent fix
    [transmit.py]
2026-03-14 Update transmit.py fix sys
    [transmit.py]
2026-03-14 Update transmit.py fix system
    [transmit.py]
2026-03-15 Update pacsatsim.sh add pwm
2026-03-15 Update pacsatsim.sh back to pwm
2026-03-15 Update pacsatsim.sh add vox and pwm set by parameters
2026-03-15 Update transmit.py add Safe Mode print
2026-03-16 Update transmit.py add print to start pacsatsim
2026-03-16 Update transmit.py fix or
    [transmit.py]
2026-03-16 Update pacsat-config.sh add reset ground station with zip file
2026-03-18 Update pacsat.sh print error messages if txc or sound card not present
2026-03-18 Update pacsat.sh fix first time prints
2026-03-18 Update config don't print no rtl-sdr
2026-03-19 Update pacsat.sh check for PacSat Ground mode before running
2026-03-19 Update pacsat-config.sh just delete directory for ground station reset
2026-03-22 Update transmit.py print txc for debug
2026-03-22 Update transmit.py remove C2C squelch check since it won't work in PacSat mode
    [transmit.py]
2026-03-22 Update config print squelch is off in PacSat or Ground modes
2026-03-22 Update config print $1
2026-03-22 Update config remove MODE print
2026-03-22 Update command don't start carrier C2C if PacSat or Ground mode
2026-03-22 Update config indicate carrier C2C is off if PacSat or PacSat Ground mode
2026-03-22 Update pacsat.sh add rx frequency print
2026-03-22 Update pacsatsim.sh print callsign and frequencies in log
2026-03-22 Update pacsat.sh add sleep 2 after print of frequency
2026-03-23 Update pacsat-config.sh switch to non Desktop properties file
2026-03-23 Update pacsat-config.sh print you can close window
2026-03-23 Update pacsat-config.sh print you can close the window
2026-03-23 Update pacsatsim.sh use PacSat Ground mode for loopback
2026-05-22 Update install 0.46q pacsat ground station install
2026-05-23 Update pacsatsim.sh typo in callsign print
2026-05-25 Update config offer to change frequency when change to PacSat Ground mode
2026-05-26 Update install wiringpi v3 not v2
2026-05-26 Update install add cd to wiringpi 3
2026-06-01 Update config add check restart for PacSat Ground
2026-06-01 Update command.sh don't print mode
2026-06-02 Update config for -g reset pacsat and ground station settings
2026-06-03 Update pacsat.sh major rewrite of tx and rx devices
2026-06-03 Update pacsat.sh change safe to rpitx and add v1 case
2026-06-06 Update dtmf_aprs_cc.py Update dtmf_aprs_cc.py fix FUNcube and Repeater mode
    [dtmf_aprs_cc.py]
2026-06-06 Update install update pi-power-button to master-b branch
2026-06-06 Update dtmf_aprs_cc.py fix PacSat
    [dtmf_aprs_cc.py]
2026-06-16 Update pacsat.sh print RTS PTT in log
2026-06-18 Update transmit.py print start freq
2026-06-18 Update transmit.py fix variable
    [transmit.py]
2026-06-18 Update transmit.py fix txr
    [transmit.py]
2026-06-18 Update transmit.py fix doppler freq
    [transmit.py]
2026-06-18 Update transmit.py print rx
2026-06-18 Update transmit.py extra print
2026-06-18 Update transmit.py fix index
    [transmit.py]
2026-06-18 Update transmit.py print relative time
2026-06-18 Update transmit.py add formatting to prints
2026-06-19 Update transmit.py fix doppler_mode assignment
    [transmit.py]
2026-06-19 Update transmit.py fix txrf
    [transmit.py]
2026-06-19 Update transmit.py print doppler
2026-06-19 Update transmit.py print tx
2026-06-19 Update transmit.py add prints to update_doppler
2026-06-19 Update transmit.py more prints
2026-06-19 Update transmit.py fix tx
    [transmit.py]
2026-06-19 Update transmit.py remove extra prints
2026-07-01 Update config print doppler
2026-07-01 Update main.c fix doppler_mode
    [main.c]
2026-07-01 Update config don't print doppler_mode
2026-07-02 Update transmit.py fix except
    [transmit.py]
2026-07-02 Update transmit.py remove try to see error
    [transmit.py]
2026-07-02 Update transmit.py add except print
2026-07-02 Update frequency.py fix indent
    [frequency.py]
2026-07-02 Update frequency.py fix spacing
    [frequency.py]
2026-07-02 Update frequency.py fix exception
    [frequency.py]
2026-07-02 Update log -f prints frequencies
2026-07-04 Update log backspace print
2026-07-04 Update log printf
2026-07-04 Update frequency.py fix tab
    [frequency.py]
2026-07-05 Update frequency.py fix doppler_mode off
    [frequency.py]
2026-07-05 Update frequency.py fix elseif
    [frequency.py]
2026-07-05 Update transmit.py shorten morse timing
    [transmit.py]
2026-07-05 Update transmit.py shorten morse timing more
    [transmit.py]
2026-07-05 Update transmit.py fix morse_timing
    [transmit.py]
2026-07-05 Update transmit.py print duration
2026-07-05 Update transmit.py fix timing
    [transmit.py]
2026-07-05 Update transmit.py shorten duration between
    [transmit.py]
2026-07-06 Update transmit.py switch back to timeout
2026-07-06 Update frequency.py fix index
    [frequency.py]
2026-07-06 Update frequency.py fix index and kHz
    [frequency.py]
2026-07-06 Update frequency.py fix % 661
    [frequency.py]
2026-07-06 Update transmit.py slow CW and shorter inter dit timing
    [transmit.py]
2026-07-08 Update frequency.py add print if frequency out of range
2026-07-08 Update frequency.py fix rx_OK test
    [frequency.py]
2026-07-10 Update config print rxf txf
2026-07-11 Update transmit.py print mode m error
    [transmit.py]
2026-07-12 Update transmit.py shorten inter dit spacing
    [transmit.py]
2026-07-12 Update transmit.py shorten inter char spacing
    [transmit.py]
2026-07-14 Update transmit.py missing update_doppler
    [transmit.py]
2026-07-15 Update config add doppler frequency print
2026-07-15 Update transmit.py fix new frequency print
    [transmit.py]
2026-07-15 Update transmit.py fix rx doppler shift
    [transmit.py]
2026-07-16 Update transmit.py fix sstv tx 1e6
    [transmit.py]
2026-07-16 Update transmit.py fix tx mistake
    [transmit.py]
2026-07-16 Update transmit.py print mode
2026-07-16 Update config add mode check to Doppler mode print
2026-07-18 Update transmit.py PacSat battery saver carrier on/off
2026-07-18 Update transmit.py update fm in Pacsat battery saver
2026-07-19 Update transmit.py missing )
    [transmit.py]
2026-07-19 Update transmit.py print tx and rx
2026-07-19 Update transmit.py fix Doppler shift calc
    [transmit.py]
2026-07-19 Update transmit.py fix doppler calc
    [transmit.py]
2026-07-19 Update transmit.py change sign of 70cm doppler
2026-07-19 Update transmit.py fix frequency variable names
    [transmit.py]
2026-07-19 Update transmit.py fix vfo variable name
    [transmit.py]
2026-07-19 Update transmit.py fix mode e cw id
    [transmit.py]
2026-07-20 Update transmit.py prints
2026-07-20 Update transmit.py fix sudo rm
    [transmit.py]
2026-07-20 Update transmit.py reboot when going two_meter to FM
    [transmit.py]
2026-07-20 Update transmit.py fix new_tx_frequency
    [transmit.py]
2026-07-20 Update transmit.py fix new_rx_frequency for sim
    [transmit.py]
2026-07-20 Update transmit.py don't restore 70cm after 2m in rigctl
2026-07-21 Update transmit.py 10 Hz updates on repeater mode doppler
2026-07-21 Update transmit.py add satellite prints
2026-07-21 Update transmit.py fix AO-73 doppler
    [transmit.py]
2026-07-21 Update transmit.py fix AO-73
    [transmit.py]
2026-07-21 Update transmit.py fix def
    [transmit.py]
2026-07-21 Update transmit.py use skip to determine 15 seconds of sleep for cw mode
    [transmit.py]
2026-07-22 Update transmit.py fix ==
    [transmit.py]
2026-07-22 Update transmit.py print command result
2026-07-22 Update config -F print correct frequency
2026-07-22 Update transmit.py repeater mode, only shift by 290 if in 70cm
2026-07-22 Update transmit.py print repeater tx calculation
2026-07-22 Update transmit.py fix rx doppler freq in start_repeater
    [transmit.py]
2026-07-28 Create pushbutton.py from pi-power-button
2026-07-28 Update install remove pi-power-button
2026-07-28 Update install remove rest of pi-power-button
2026-07-28 Update install uninstall pi-power-button
2026-07-28 Update install fix uninstall pi-power-button
2026-07-29 Update pushbutton.py print connection show
2026-07-31 Update pushbutton.py fix tabs
    [pushbutton.py]
2026-07-31 Update config print result of -K with param
2026-07-31 Update config update print
2026-07-31 Update config change -F print
2026-07-31 Update config cleanup -F prints
2026-07-31 Update config print is on same line
2026-08-01 Update config.yaml add more buttons
2026-08-01 Update config print reset count
2026-08-03 Update pushbutton.py change port to 8081 to avoid conflict
    [pushbutton.py]
2026-08-05 Update install print setting up journal across boots
2026-08-06 Update main.h replace source with .
    [main.h]
2026-08-06 Update install update to pacsat ground 47a
2026-08-06 Update install download latest Pacsat Ground Station
2026-08-09 Update pushbutton.py fix or
    [pushbutton.py]
2026-08-09 Update pushbutton.py fix ==
    [pushbutton.py]
2026-08-09 Update pushbutton.py add hotspot default print
2026-08-11 Update config.yaml 120 seconds for I2C
2026-08-12 Update pacsat.desktop add Ground Station to Pacsat
2026-08-12 Update pacsatsim.sh print pacsat.state
2026-08-14 Update install prints
2026-08-15 Update transmit.py restart gpsd.socket twice
2026-08-15 Update transmit.py turn off gpsd and gpsd.socket if Doppler
2026-08-15 Update transmit.py switch order of disable gpsd
2026-08-15 Update transmit.py fix ptt gpis after tune
    [transmit.py]
2026-08-15 Update transmit.py reduce doppler prints
2026-08-15 Update transmit.py don't print for gpio operations
2026-08-16 Update transmit.py add print in exception
2026-08-16 Update transmit.py remove exception print for battery saver check
2026-08-16 Update transmit.py prints on one line
2026-08-16 Update transmit.py fix update_doppler error printing
    [transmit.py]
2026-08-16 Update transmit.py add error for empty frequencies
    [transmit.py]
2026-08-16 Update transmit.py try twice and return if failed
    [transmit.py]
2026-08-16 Update transmit.py print success for 2nd read of frequency.txt
2026-08-17 Update transmit.py print
2026-08-17 Update transmit.py print after no satellite detected
2026-08-18 Update config print current rx frequency
2026-08-18 Update config print on one line
2026-08-18 Update config fix tx frequency print
2026-08-18 Update config fix current tx frequency
2026-08-18 Update transmit.py add no doppler print
2026-08-18 Update transmit.py fix check_frequency
    [transmit.py]
2026-08-18 Update transmit.py check RX frequency for 70cm
2026-08-18 Update main.c fix negative temperature
    [main.c]
2026-08-19 Update main.c print result of is_safe_input
2026-08-19 Update main.c print is_safe
2026-08-26 Update pacsat.sh stop and start wireplumber
2026-08-26 Update pacsatsim.sh stop and start wireplumber
2026-08-26 Update config stop and start wireplumber
2026-08-27 Update frequency.py fix udo
    [frequency.py]
2026-09-01 Update config added -V reboot needed print
2026-09-04 Update config don't start and stop wireplumber
2026-09-05 Update config print MicVolume level
2026-09-05 Update command print MicVolume
2026-09-05 Update pacsatsim.sh print MicVolume
2026-09-05 Update pacsat.sh print MicVolume
2026-09-05 Update config -L print MicVolume
2026-09-15 Update pacsatsim.sh remove camera stills
2026-09-16 Update pacsatsim.sh add back in camera
2026-09-16 Update .gitignore add camera.jpg
2026-09-16 Update config delete camera.jpg
2026-09-18 Update config -z to take pacsat camera image
2026-09-18 Update config.yaml add Take Camera photo
2026-09-24 Update transmit.py don't print failure_mode error message
    [transmit.py]
2026-09-24 Update frequency.py fix tabs
    [frequency.py]
